denjhang/74HC-Chiptune/Glowworm-1/docs/ref/system-structure.jpeg

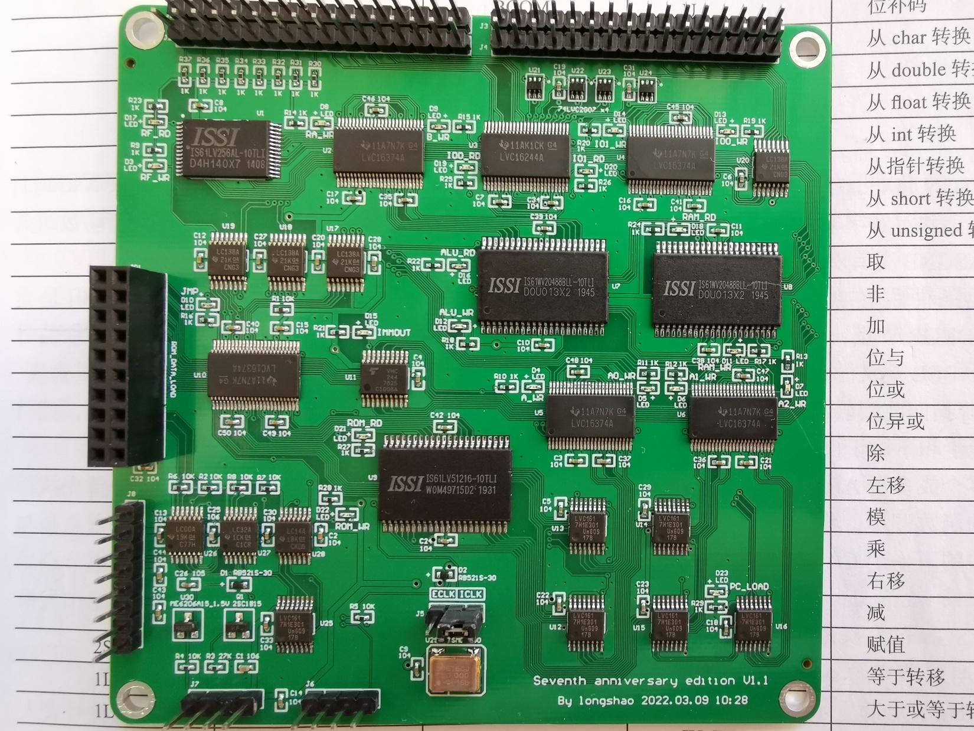
Glowworm-1/docs/ref/system-structure.jpeg
