denjhang/74HC-Chiptune/Glowworm-1/docs/hardware.md

# 萤火虫 1 号硬件实现分析（BOM 反推）

> 来源：`硬件源文件/BOM_CPU V1.1版(2022.10.19).xlsx` + `BOM_下载器V1.1版(2021.11.02).xlsx`
> 整理时间：2026-07-05
> 方法：openpyxl 提取 BOM，结合 ISA 反推每片芯片功能

## 一、CPU 板核心 IC（23 片数字逻辑）

### 存储器（4 片 SRAM）

| 位号 | 型号 | 容量 | 推断功能 |
|---|---|---|---|
| U1 | **IS61LV256** | 32K×8 = 256Kbit | RF 寄存器堆 / 小数据 RAM |
| U7 | **IS61WV2568-20488** | 256K×8 = 2Mbit | 程序 ROM（下载器灌入，CR2032 保持）|
| U8 | **IS61WV2568-20488** | 256K×8 = 2Mbit | 数据 RAM |
| U9 | **IS61LV12816-51216** | 128K×**16** = 2Mbit | **ALU 查表 ROM（16 位宽）** |

> 总 SRAM：256K（RF）+ 256K×2（程序+数据）+ 128K×16（ALU表）= 实际可用约 768KB 程序+数据空间 + 256KB ALU 表
> 修正之前 design.md 8.6 节"628512 拼"的说法：实际是 ISSI 低压 SRAM，10-20ns，支撑 50MHz

### 寄存器/触发器（6 片）

| 位号 | 型号 | 推断功能 |
|---|---|---|
| U2, U4, U5, U6, U10（5片）| **74LVC16374**（16位D触发器带三态，48脚）| A/A0/A1/A2/RA/B/IR/临时锁存。**ISA"统一目的=源"模型的物理基础**：每个寄存器都是带三态的 D 触发器组，挂公共总线，译码器选驱动源 |
| U22 | 74LVC2G07 ×4（双缓冲器，开漏）| 复位/电平转换 |

> 5 片 74LVC16374 = 80 个寄存器位，足够覆盖 ISA 所有可见寄存器 + 临时锁存

### 总线驱动（2 片）

| 位号 | 型号 | 推断功能 |
|---|---|---|
| U3 | **74LVC16244**（16位缓冲器，48脚）| TSL 三态控制 / 总线驱动（PPTX 里的 TSL 模块）|
| U11 | 74VHC244（8位缓冲器）| IO 驱动 |

### PC 计数器（6 片）

| 位号 | 型号 | 推断功能 |
|---|---|---|
| U12, U13, U14, U15, U16, U25（6片）| **74LVC161**（4位计数器）| **PC = 24 位**（6×4=24），与 ISA 的 `PC = A2A1A0`（24位地址）对得上 |

### 译码/控制（7 片）

| 位号 | 型号 | 推断功能 |
|---|---|---|
| U17, U18, U19, U20（4片）| **74LVC138**（3-8译码器）| 地址译码 / 机器码→控制信号译码（PPTX 里的"译码控制器"）|
| U26 | 74LVC00（NAND）| 控制逻辑组合 |
| U27 | 74LVC32（OR）| 控制逻辑组合 |
| U28 | 74LVC14（施密特反相）| 复位整形 / 时钟整形 |

### 电源/时钟/电源切换（4 片）

| 位号 | 型号 | 功能 |
|---|---|---|
| U29 | **SMD7050-50M** | **50MHz 主时钟** |
| U30 | ME6206A15（1.5V LDO）| 74LVC 内核供电（LVC 是 1.5V 工艺）|
| U21, U23, U24（SO-G6）| 6脚封装 | 电源切换 / CR2032 备份切换 |

### 连接器/外围

- 4×SIP16（J1-4）：4 个 16 位 I/O 端口扩展（ISA 只暴露 IO0/IO1，这里物理引出更多）
- IDC20（JP1, ROM_DATA_LOAD）：**下载器接口**（20 针排针，CPU 板和下载器板共用的 ROM_DATA_LOAD）
- 21×LED（D3-23）：状态指示
- RB521S-30 肖特基 ×2（D1,D2）：CR2032 备份二极管（隔离主电源和电池）

## 二、下载器板（CH340 USB 灌数据，约 10 片数字 IC）

| 位号 | 型号 | 功能 |
|---|---|---|
| U1 | **CH340N**（SO-8）| USB→串口 |
| U11, U12（2片）| **74HC595**（串入并出 8位移位寄存器）| 串口数据→并口地址/数据总线 |
| U4, U5, U10（3片）| **74HC161** | 地址计数器（扫 ROM 写入）|
| U2, U3（2片）| **74HC74**（双D触发器）| 控制状态机 |
| U6 | 74HC14 | 复位整形 |
| U7 | 74HC32 | 控制逻辑 |
| U8 | 74HC08 | 控制逻辑 |
| U9 | 74HC00 | 控制逻辑 |
| U13 | SMD7050-1.8432 | 1.8432MHz（标准串口波特率源）|

**下载协议推断**：CH340 串口接收 PC 数据 → 74HC595 串并转换凑出 8 位数据 + 地址 → 74HC161 地址计数器自增扫 SRAM → 通过 JP1（IDC20）把数据按地址灌进 CPU 板的 U7/U8 SRAM。灌完拔掉，CR3032 + 肖特基二极管保持 SRAM 内容。

**JP2（CLKMUX, IDC6）**：时钟切换——下载时用下载器时钟，运行时切回 50MHz。

## 三、关键架构事实（修正之前认知）

### 1. ALU ROM 是 16 位宽（重要）

IS61LV12816 是 **128K×16 SRAM**，不是 ×8。
- 地址 = (A, B, XX) ≈ 16 位地址空间（A 8位 + B 8位 = 64K，XX 当段选再扩 4-8 倍）
- 输出 **16 位**：低 8 位是运算结果，高 8 位可编码**标志位/进位/比较结果**
- 这直接解释了 `17XX` 条件跳转判 ALU 输出 bit0——比较/减法的"相等/借位"结果编码在 ALU 输出高位

### 2. PC = 24 位（6×74LVC161）

6 片 4 位计数器 = 24 位，与 ISA `PC = A2A1A0`（24 位地址）完全一致。
- 实际程序空间 256K×8 = 256KB（U7），用 18 位地址够
- 24 位 PC 留了余量（4 位未用或作标志位/分段）

### 3. 50MHz 主频（远超 PSG 的 64kHz）

- 64kHz / 50MHz = 0.128%，PSG 是萤火虫的 1/780
- SCC 的多通道分时轮询在 50MHz 下窗口充裕（一个采样周期 22.6μs = 1130 个时钟）
- 这是萤火虫能跑 NES 模拟器的物理基础

### 4. 内核 1.5V（LVC 工艺）

74LVC 系列是 1.5V 工艺（ME6206A15 提供），IO 兼容 3.3V/5V。
**对复刻的影响**：若改用 74HC（5V 工艺），频率上限会降到 ~30MHz，但架构不变。
SRAM（IS61LV/IS61WV）多档电压版本可选（3.3V 版更易采购）。

### 5. "统一目的=源"模型的物理实现

ISA 的所有指令都是"目的 = 源"，物理上：
```
        ┌─ 74LVC16374 (A)    ─┐
        ├─ 74LVC16374 (A0A1)  ─┤
总线 ◄──┼─ 74LVC16374 (A2RA)  ─┼── 74LVC16244 (TSL 选谁驱动)
        ├─ 74LVC16374 (BIR)   ─┤
        ├─ IS61LV256 (RF)     ─┤
        ├─ IS61WV2568 (RAM)   ─┤
        └─ IS61LV12816 (ALU)  ─┘
              ▲
       74LVC138 ×4 译码机器码 → 选源驱动 + 选目的锁存
```
每条指令 = 译码器选一个源驱动总线 + 选一个目的在 clk 沿锁存。极简且规整。

## 四、片数对比（修正 design.md 8.6.4）

| 方案 | 片数 | 状态 |
|---|---|---|
| design.md 估计 39040cpu | 22 | ❌ 未验证 |
| design.md 估计 SCC 专用机 | 14-16 | ❌ 估计值 |
| **萤火虫 1 号实测** | **23 核心数字 IC** | ✅ 龙少已验证（跑通 NES 模拟器/UI OS）|
| 萤火虫 + DAC = SCC 平台 | 23 + 1 (TLC7524) = **24** | 不改硬件，写 C 程序即可 |

**结论**：萤火虫片数和 39040 相当，但**已验证 + ISA 干净 + 有 lcc 编译器 + SRAM 可热改**，全方位碾压 39040。
SCC 不需要"先验证查表机再扩"——萤火虫本身就是验证好的查表机 SCC 平台。

## 五、对 Glowworm-1 子项目的指引

基于硬件事实，萤火虫架构复刻/精简的选项：

**A. 完整复刻萤火虫**（~23 片 + 下载器 10 片）
- 优势：架构已验证，lcc 可直接用，能跑现有 NES/UI 程序
- 代价：贴片 IC 多（74LVC16374 TSSOP48 等焊接难度高），CR2032 备份电路

**B. 用 DIP 芯片精简复刻**（5V HC 系列，~25-30 片）
- 74LVC16374 → 用 2×74HC374 替代（每片 8 位，16 位需 2 片，5 片变 10 片）
- IS61WV2568 → 用 62256（32K×8 DIP）×8 拼（容量小但 DIP 易焊）
- 主频降到 20-30MHz（HC 工艺限制）
- 优势：DIP 易焊，面包板可搭，符合 PSG 项目风格

**C. 基于 ISA 做最小 SCC 专用机**（不通用，~15 片）
- 砍 PC 到 16 位、砍 IO、砍 ALU 表（用专用波形 ROM）
- 优势：芯片最少
- 代价：失去 lcc 兼容性，ISA 不通用

> 待讨论方向，本文档只列事实，不预设选择。
