denjhang/74HC-Chiptune/memory/MEMORY.md

# Memory Index

- [WSG3 Core Status](wsg3-core-status.md) — DAC 有输出, 但频率 ~2212Hz 不是 440Hz (快 5 倍), 调试中
- [ROM 39SF040 Only](rom-39sf040-only.md) — 项目硬规则: 所有 ROM 只用 39SF040，不讨论替代方案
- [WSG3 Architecture](wsg3-architecture.md) — 功能等效架构: 14 IC 类型保留, 按技术文档行为接线 (不纠结引脚 1:1), 3M 微码字/TDM 16 步/寄存器映射/A4 测试向量
- [WSG3 ROM Files](wsg3-rom-files.md) — 原版 82s126 BIN 文件 + COE 等价关系 + 用途
