denjhang/74HC-Chiptune/wsg3/docs/wsg-netlist-truth.md

# Pac-Man WSG 网表完整反推 (从 AD.net 一行行读)

## 网表信号清单

### 时序信号 (HCNT, 6-bit)
- 1H  = HCNT[0] — 从 U1.24 (排针) 进, 也接 U3.10 (ROM A1)
- 2H  = HCNT[1] — U1.23, U2.10 (异或门输入), U3.9 (ROM A2)
- 4H  = HCNT[2] — U1.22, U3.8 (A3), U4.13 (B4)
- 8H  = HCNT[3] — U1.21, U3.7 (A4), U4.10 (B3)
- 16H = HCNT[4] — U1.20, U3.6 (A5), U4.6 (B2)
- 32H = HCNT[5] — U1.19, U3.5 (A6), U4.3 (B1)

注: HCNT 由外部 (排针) 提供, 不是声卡内部产生!

### CPU 接口信号
- AB0-3 = U1.7,5,3,1 — CPU 地址低 4 位 → U4 A1-A4
- DB0-3 = U1.13,12,11,10 — CPU 数据低 4 位 → U5 A1-A4
- /WR0 = U1.15 → U3.4 (ROM /OE?)
- /WR1 = U1.16 → U6.3 (RAM1 /WE)
- SOUND_ON = U1.17 → U11.1 (HC273 /MR)
- /GM = U1.18 → U3.20 (ROM /CE)

## 芯片信号 → 引脚完整映射

### U2: 74HC86 (异或门) — DIP-14

网表连接:
- Pin 8 (Y3) → 3LK-157-S (U5.1, U4.1)
- Pin 10 (A4) ← 2H
- Pin 7 (GND), Pin 9 (B4) ← GND

**功能**: Y3 = A4 ^ B4 = 2H ^ 0 = 2H
所以 **3LK-157-S = 2H**

### U4: 74HC157 (4×2 选 1 mux, AB mux)
- Select = 3LK-157-S = 2H
- A1-A4 = AB0-3 (CPU 地址)
- B1-B4 = 32H, 16H, 8H, 4H (HCNT 高位)
- Y1-Y4 = 3L-157-Y1..4 → U6/U7 地址 A3-A0

注意! Y1 → A3, Y4 → A0 (顺序反)

当 Select=0 (2H=0): Y = A = AB (CPU 地址)
当 Select=1 (2H=1): Y = B = HCNT[5:2]

### U5: 74HC158 (4×2 选 1 反相 mux, DB 反相 mux)
- Select = 3LK-157-S = 2H
- A1-A4 = DB0-3 (CPU 数据)
- B1-B4 = 3K-158-B1..4 (反馈, 来自累加器/ROM)
- Y1-Y4 (反相) → U6/U7 数据输入

B 输入:
- B1 = 3K-158-B1 ← U10.6 (1M ROM D5), U9.14, U9.5
- B2 = 3K-158-B2 ← U10.7 (1M ROM D4), U9.7
- B3 = 3K-158-B3 ← U10.8, U9.10
- B4 = 3K-158-B4 ← U10.9, U9.12

注意 U9 是 174 锁存器, 输出 Q1-Q6

### U3: 27C256 / 82S126 (3M 微码 PROM)
地址 (8-bit):
- A0 = Pin 10 ← 1H
- A1 = Pin 9 ← 2H
- A2 = Pin 8 ← 4H
- A3 = Pin 7 ← 8H
- A4 = Pin 6 ← 16H
- A5 = Pin 5 ← 32H
- A6, A7 = 接 GND/VCC (不接 HCNT)
- /CE = Pin 20 ← /GM
- /OE = Pin 22 ← GND (常输出)

数据 (4-bit):
- DQ0 = Pin 11 → 3M-DQ0 → U9.9 (174 CLK)
- DQ1 = Pin 12 → 3M-DQ1 → U7.3 (U7 /WE)
- DQ2 = Pin 13 → 3M-DQ2 → U11.11 (273 CP)
- DQ3 = Pin 15 → 3M-DQ3 → U9.1 (174 /CLR)

注: DQ0=时钟, DQ3=清零, DQ1=RAM写, DQ2=输出锁存
原版 82S126 数据看 16 步循环 (HCNT[3:0])

### U6: 74LS189 (RAM #1, 存"2L"组数据)

地址 (4-bit, 共享):
- A0 = Pin 1 ← 3L-157-Y4 (U4 Y4)
- A1 = Pin 15 ← 3L-157-Y3
- A2 = Pin 14 ← 3L-157-Y2
- A3 = Pin 13 ← 3L-157-Y1

控制:
- /CS = Pin 2 ← GND (常使能)
- /WE = Pin 3 ← /WR1 (CPU 写脉冲)

数据输入 (4-bit, 共享):
- D3 = Pin 4 ← 3K-158-Y4
- D2 = Pin 6 ← 3K-158-Y3
- D1 = Pin 10 ← 3K-158-Y2
- D0 = Pin 12 ← 3K-158-Y1

数据输出 (4-bit, 反相, 独立):
- O0 = Pin 5 → 2L-DQ0 → U11.8, U8.6
- O1 = Pin 7 → 2L-DQ1 → U11.7, U8.2
- O2 = Pin 9 → 2L-DQ2 → U11.4, U8.15
- O3 = Pin 11 → 2L-DQ3 → U11.3, U8.11

**关键**: U6 输出 → U8 (283 加法器) A 端 + U11 (273) 高 4 位
所以 U6 存的是 **累加器/音量** 之类需要直接送加法器和输出锁存的数据

### U7: 74LS189 (RAM #2, 存"2K"组数据)

地址 (4-bit, 共享 U6):
- 同 U6

控制:
- /CS = Pin 2 ← GND
- /WE = Pin 3 ← 3M-DQ1 (微码控制写!)

数据输入 (4-bit, 共享 U6):
- 同 U6

数据输出 (4-bit, 反相):
- O0 = Pin 5 → 2K-DQ0 → U10.5 (1M ROM A4), U8.5 (283 B0)
- O1 = Pin 7 → 2K-DQ1 → U10.4, U8.3
- O2 = Pin 9 → 2K-DQ2 → U10.3, U8.14
- O3 = Pin 11 → 2K-DQ3 → U8.12 (注意! 只到 U8, 不到 U10)

**关键**: U7 输出 → U8 (283) B 端 + U10 (1M ROM) 地址低位
所以 U7 存的是 **频率/波形选择** (要送加法器和寻 ROM)

### U8: 74HC283 (4-bit 加法器, "1K")
- A0-A3 = Pin 12,14,3,2 ← 2L-DQ0..3 (来自 U6, 累加器)
- B0-B3 = Pin 5,3,14,1 ← 2K-DQ0..3 (来自 U7, 频率)
  注: 实际看网表
  - U8.6 ← 2L-DQ0 (A1)
  - U8.2 ← 2L-DQ1 (A2)
  - U8.15 ← 2L-DQ2 (A3)
  - U8.11 ← 2L-DQ3 (A4?)
  - U8.5 ← 2K-DQ0 (B1)
  - U8.3 ← 2K-DQ1 (B2)
  - U8.14 ← 2K-DQ2 (B3)
  - U8.12 ← 2K-DQ3 (B4)
- C0 = Pin 7 ← 1L-74-1Q (U9.2, 进位输入)
- S1-S4 = Pin 4,1,13,10 → 1K-283-S1..4 → U9 D1-D4
  - U8.4 (S1) → U9.13 (D2)
  - U8.1 (S2) → U9.11 (D3)
  - U8.13 (S3) → U9.6 (D4)
  - U8.10 (S4) → U9.4 (D5)
- C4 = Pin 9 → U9.3 (D1)

### U9: 74HC174 (6-bit 锁存器, "1L")
- CLK = Pin 9 ← 3M-DQ0
- /CLR = Pin 1 ← 3M-DQ3
- D1 = Pin 3 ← U8.9 (C4, 加法器进位输出)
- D2 = Pin 4 ← U8.4 (S1)
- D3 = Pin 6 ← U8.1 (S2)
- D4 = Pin 14 ← U8.13 (S3)
- D5 = Pin 13 ← U8.10 (S4)
- D6 = Pin 11 ← ? (网表说 U9.11 = 1K-283-S2, 来自 U8.1)

等等, 这里有矛盾. U9.11 同时是 D6 输入和 S2 输出?

让我重新核对. 174 引脚:
- Pin 1: /CLR
- Pin 2: Q1
- Pin 3: D1
- Pin 4: D2
- Pin 5: Q2
- Pin 6: D3
- Pin 7: Q3
- Pin 9: CLK
- Pin 10: Q6
- Pin 11: D6
- Pin 12: Q5
- Pin 13: D5
- Pin 14: D4
- Pin 15: Q4

但网表说:
- U9.11 ← 1K-283-S2 (U8.1)
- U9.11 → 3K-158-B1 (送 U5 B1)

矛盾! D6 是输入, 怎么会输出到 U5?

可能 U9.11 实际是 Q6 不是 D6? 让我换个引脚映射.

或者网表里 U9.11 既是输入也是输出, 这不可能. 我一定看错了引脚定义.

让我用 74HC174 标准 DIP-16 引脚 (datasheet):
- Pin 1: /MR (master reset)
- Pin 2: Q1
- Pin 3: D1
- Pin 4: D2
- Pin 5: Q2
- Pin 6: D3
- Pin 7: Q3
- Pin 8: GND
- Pin 9: CLK
- Pin 10: Q4
- Pin 11: D4
- Pin 12: Q5
- Pin 13: D5
- Pin 14: D6
- Pin 15: Q6
- Pin 16: VDD

是的! 我之前看错了. 174 实际是:
- Pin 10: Q4
- Pin 11: D4
- Pin 15: Q6

让我重新映射 U9 (74HC174):
- /CLR = Pin 1 ← 3M-DQ3
- CLK = Pin 9 ← 3M-DQ0
- D1 = Pin 3 ← 1K-283-C4 (U8.9)
- Q1 = Pin 2 → 1L-74-1Q → U8.7 (C0, 进位输入)
- D2 = Pin 4 ← 1K-283-S1 (U8.4)
- Q2 = Pin 5 → U9.5 → 3K-158-B1 (反馈到 U5)
- D3 = Pin 6 ← 1K-283-S4 (U8.13)
- Q3 = Pin 7 → U9.7 → 3K-158-B2
- D4 = Pin 11 ← 1K-283-S2 (U8.1)
- Q4 = Pin 10 → U9.10 → 3K-158-B3
- D5 = Pin 13 ← 1K-283-S3 (U8.10)
- Q5 = Pin 12 → U9.12 → 3K-158-B4
- D6 = Pin 14 ← ? (网表没看到 U9.14 连接)
- Q6 = Pin 15 → U9.15 → 1L-174-6Q → U10.10 (1M ROM A5)

太好了! 现在所有连接都对上了!

### U10: 27C256 / 82S126 (1M 波形 PROM)
地址 (8-bit):
- A0-A3 = Pin 12,11,10,9 ← 2K-DQ0..3? 让我核对
  - U10.5 ← 2K-DQ0
  - U10.4 ← 2K-DQ1
  - U10.3 ← 2K-DQ2
  等等, 27C256 的 A0-A7 是 Pin 10, 9, 8, 7, 6, 5, 4, 3, 25, 24, 21, 23, 2

让我用 27C256 引脚:
- Pin 10: A0
- Pin 9: A1
- Pin 8: A2
- Pin 7: A3
- Pin 6: A4
- Pin 5: A5
- Pin 4: A6
- Pin 3: A7
- Pin 25: A8
- Pin 24: A9
- Pin 21: A10
- Pin 23: A11
- Pin 2: A12
- (其他高位地址看型号)

从网表:
- U10.10 ← 1L-174-6Q (U9.15, 锁存器 Q6) — 所以 Pin 10 = A0 ← U9 Q6
- U10.11 ← 1M-DQ0?? 不对, 1M-DQ0 是输出

等等. U10.11 → 1M-DQ0 是输出. 但网表说 (1M-DQ0 U11-18 U10-11).

我搞混了, 让我重新看:
- Pin 11 是 DQ0 还是 A1?

27C256 标准 DIP-28:
- Pin 10: A0
- Pin 11: DQ0 ← 输出
- Pin 9: A1
- Pin 12: DQ1
- Pin 8: A2
- Pin 13: DQ2
- Pin 7: A3
- Pin 14: GND
- Pin 6: A4
- Pin 15: DQ3
- Pin 5: A5
- Pin 16: DQ4
- Pin 4: A6
- Pin 17: DQ5
- Pin 3: A7
- Pin 18: DQ6
- Pin 25: A8
- Pin 19: DQ7
- Pin 24: A9
- Pin 20: /CE
- Pin 21: A10
- Pin 22: /OE
- Pin 23: A11
- Pin 1: VPP (or A13?)
- Pin 26: A12
- Pin 27: A14 (or /PGM)
- Pin 28: VDD

但 82S126 是 8-pin + 4-bit data, 引脚完全不同!

让我重新看网表连接:
- U10.10 ← U9.15 (174 Q6) → 这是地址 A0
- U10.11 → U11.18 (1M-DQ0) → 数据输出
- U10.12 → U11.17 (1M-DQ1)
- U10.13 → U11.14 (1M-DQ2)
- U10.15 → U11.13 (1M-DQ3)
- U10.4 ← 2K-DQ1
- U10.5 ← 2K-DQ0
- U10.6 ← 3K-158-B1
- U10.7 ← 3K-158-B2
- U10.8 ← 3K-158-B3
- U10.9 ← 3K-158-B4
- U10.14 ← GND
- U10.20 ← GND
- U10.22 ← GND
- U10.1 ← VCC
- U10.28 ← VCC

U10 是 27C256 (DIP-28) 但网表用得像 256×4 PROM:
- 地址输入: Pin 10 (A0), Pin 9 (A1), Pin 8 (A2), Pin 7 (A3), Pin 6 (A4), Pin 5 (A5), Pin 4 (A6)
- 数据输出: Pin 11 (DQ0), Pin 12 (DQ1), Pin 13 (DQ2), Pin 15 (DQ3)

所以 1M PROM 地址是 7-bit (128 字节), 数据 4-bit. 这正是 82S126 的扩展 (256×4)!

U10 地址来源:
- A0 ← 1L-174-6Q (累加器高位, 锁存器 Q6)
- A1-A4 ← 2K-DQ0..3 (U7 RAM 输出, 4-bit 累加器值)
- A5-A6 ← 3K-158-B1..B4 (这些是 U5 输入, 来自反馈)

等等, 3K-158-B1 来自 U10.6 (U10 自己)? 这是循环!

让我再看 3K-158-B1 = (U10-6, U9-14, U9-5, U5-3):
- U10.6 (A4) — 但这是 U10 的地址 A4, 怎么会是 U5 的输入 B1?

哦! 我看错了. 让我重新理解. 信号 3K-158-B1 连接的引脚都是同一个网络名:
- U5.3 (B1 输入)
- U10.6 (A4? 但 A4 是输入, 不可能也是输出)
- U9.14 (D6)
- U9.5 (Q2)

可能是 U10.6 实际上是 DQ (双向), 不是 A4. 或者 27C256 引脚映射不一样.

我应该停止猜, 找原版原理图看真实引脚.

但等等, 网表里 27C256 写得很明白, 我看的是 DIP-28. 实际可能是别的型号.

让我从信号名推断:
- 3K-158-B1 是 U5 的 B1 输入
- 它连到 U10.6 (U10 的 Pin 6)
- 还连到 U9.14 和 U9.5

如果 U10.6 是数据输出 (1M-DQ4 或类似), 那 B1 就是 ROM 数据反馈.

我需要换思路. 不再纠结引脚号, 而是从功能反推.
