denjhang/74HC-Chiptune/psg_voice/README.md

# psg_voice — 74HC PSG / 波形音源系列

用 74HC 逻辑 + FT232H 控制的方波/噪音/波形音源。按版本演进，每版对应一张 EasyEDA 原理图，**逐步上板验证**。

## 版本谱 (按时间)

| 版本 | 状态 | 内容 |
|---|---|---|
| [PSG1 v0.1](PSG1%20v0.1/) | ✅ 上板 | 单通道方波, 5 片 74HC + LS373 电平转换 + FT232H, 实测发声 |
| [PSG1 v0.2](PSG1%20v0.2/) | ✅ 上板 | v0.1 + 4-bit 音量 (TLC7524 衰减器), ADSR+曲目库 |
| [PSG2 v0.3](PSG2%20v0.3/) | ✅ 上板 | 两通道: CH0 方波 (复用 v0.2) + CH1 LFSR 噪音 (模拟噪声注入, 永不锁死) |
| [PSG3 v0.4](PSG3%20v0.4/) | ✅ 上板 | YM2413 风格地址/数据复用总线 + 方波/噪音双通道 + 简谱宏解析播放器 |
| [**PSG3 v0.5**](PSG3%20v0.5/) | 🚧 **进行中** | v0.4 + 波形通道 (rev.a→e2): 分频链锯齿 ✅ → ROM 查表任意波形/PCM (待上板) |
| [PSG4 v0.6](PSG4%20v0.6/) | 📋 设计 | 纯设计思路, **未验证** |
| [WSG3 v0.6](WSG3%20v0.6/) | 📋 设计 | 纯设计思路, **未验证** |
| [WSG8 v0.7](WSG8%20v0.7/) | 📋 设计 | 纯设计思路, **未验证** |
| [FM6 v0.7](FM6%20v0.7/) | 📋 设计 | 单通道 2-op FM, RTL 验证, **未上板** |

⭐ **当前最新进度 = [PSG3 v0.5 rev.e2](PSG3%20v0.5/)** (双模式波形/采样, 接线表完成, 待上板).

> ⚠️ v0.6/v0.7 都是纸面/RTL 探索, 无硬件验证, 不算已完成成果.

## 共享资源
- **控制器**: FT232H (CJMCU 板, D2XX + MPSSE), 12 根线
  - C0-C7 = 数据总线, D4=LE, D5=A0, D6=RST, D7=A1 (v0.3+)
  - v0.4 起改 YM2413 风格: A0/CS/WR 地址数据复用
- **时钟**: 外部有源晶振 (方波/噪音 64kHz 预分频甜点, 波形通道 4MHz 直连)
- **电平转换**: LS373 (FT232H 3.3V → 74HC 5V, v0.1 验证必需, A0 也要过)
- **DAC**: TLC7524 (正向接法: REF=信号输入, OUT1=输出, RFB=GND)
- **输出**: OUT1 → 耦合电容 → 运放 → 喇叭

## 演进脉络
- **v0.1**: 单通道方波直驱. 验证 74HC PSG 核心 + FT232H 控制 + 电平转换 + HCT74 高频.
- **v0.2**: + 4-bit 音量 (TLC7524 衰减器). 核心不动, 加 HC374 + TLC7524.
- **v0.3 (PSG2)**: + 噪音通道 (LFSR). 用户创新: HC00+电容模拟噪声注入 D[0], 永不锁死.
- **v0.4 (PSG3)**: YM2413 总线 (地址/数据复用, 8 寄存器). + 简谱宏解析播放器 (ini 音级+乐器块+双轨).
- **v0.5 (PSG3)**: + 波形通道. CD4029 失败 → HC161 Q→DAC 失败 → rev.a 分频链锯齿 ✅ → rev.b 三角 ❌ → rev.c 调音色 → rev.d/d2 ROM 查表 → **rev.e2 双模式 (波形+PCM)**.

## 共享 datasheet / 库存
- **datasheet**: [`datasheet/`](datasheet/) (157 个 md, 按家族分类: 74series/cmos4000/analog/audio/memory/...)
- **库存表**: [`PSG3 v0.5/docs/inventory.md`](PSG3%20v0.5/docs/inventory.md) (选片前先查)
- **查证纪律**: 不确定芯片特性查 datasheet PDF 原文, 不凭记忆 (详见项目根 CLAUDE.md 第七节)
