denjhang/74HC-Chiptune/wsg3/docs/wsg3-architecture.md

# WSG3 — Pac-Man WSG 功能等效复刻 (11 IC WSG + 3 IC SPFM = 14 IC)

> **设计原则: 按芯片类型做功能等效, 不纠结原版引脚级 1:1**
> 数据来源: `reference/Namco WSG/Pac-Man技术文档_extracted/document_text.txt`
> 网表参考: `reference/Namco WSG/easyeda/PADS.net`

---

## 0. 设计目标

| 目标 | 说明 |
|---|---|
| **WSG 核心** | 11 片 IC, 按 Pac-Man 1980 WSG 芯片类型复刻 |
| **SPFM 接口** | 3 片 IC (373+174+377), 主机写 voice 参数 |
| **通道数** | 3 通道独立波形/频率/音量 |
| **相位精度** | 通道 1: 20-bit, 通道 2/3: 16-bit |
| **采样率** | 96 kHz (主钟 6.144 MHz / 64) |
| **波形数** | 8 种预设波形 (低 3-bit 选择) |
| **音量级** | 16 级 (0-15, 4-bit) |
| **混音** | CD4066 模拟开关 + R-2R 等效 |
| **总 IC 数** | **14 片** |
| **隐藏门** | **0** |

---

## 1. 14 片 IC 清单 (按芯片类型复刻)

### SPFM 总线接口 (3 片)

| 位号 | 型号 | 功能 |
|---|---|---|
| U_spfm_373 | 74HC373 | SPFM_D[7:0] 透明锁存 |
| U_spfm_174 | 74HC174 | 写脉冲同步链 |
| U_spfm_377 | 74HC377 | reg_addr[7:0] 寄存器 |

### WSG 核心 (11 片)

| 位号 | 型号 | 功能 (技术文档对应行为) |
|---|---|---|
| U2 | 74HC86 | XOR — HCNT[1] 反馈 (生成 mux Select) |
| U3 | 39SF040 | **3M 微码 ROM** — 16 步 × 16-bit 控制字, 由 HCNT[5:2] 寻址 |
| U4 | 74HC157 | AB mux — 选 CPU 地址 (写) 或 HCNT (扫描) |
| U5 | 74HC158 | DB 反相 mux — 选 CPU 数据 (写) 或反馈 (累加器回写) |
| U6 | 74LS189 | RAM "2L" — 累加器值 (4-bit, 16 字) |
| U7 | 74LS189 | RAM "2K" — 频率/音量值 (4-bit, 16 字) |
| U8 | 74HC283 | 4-bit 加法器 "1K" — acc + freq + carry, 串行 4-5 次构成 16/20-bit |
| U9 | 74HC174 | 6-bit 锁存 "1L" — 累加器累加 + 进位链 + ROM 地址高位 |
| U10 | 39SF040 | **1M 波形 ROM** — 8 波 × 32 点 × 4-bit, 由波形号+相位寻址 |
| U11 | 74HC273 | 输出寄存器 "2M" — 锁存波形 × 音量结果 |
| U12 | CD4066 | 4 路模拟开关 — 音量乘法 (行为级 `wave × vol / 15`) |

---

## 2. 关键纠正 (旧文档的错误)

**旧 wsg3-architecture.md 错误**:
- ~~U3 是 wavetable ROM, U10 是 RAM~~ ← 错!
- 旧文档的 64 拍时序和 4 通道噪音是凭空想象

**技术文档真相** (来自 `document_text.txt`):
- **U3 = 3M 微码 ROM**: 16 步 × 16-bit 控制字, 由 `HCNT[5:2]` 寻址, 控制 174 CLK/CLR + 273 CP + 189 /WE
- **U10 = 1M 波形 ROM**: 8 个波形 × 32 样本 × 4-bit, 地址 `[7:5]=波形号, [4:0]=相位高 5 位`
- **3 通道** (不是 4), 每通道 16 步 TDM 中的 4-5 步做相位累加 + 1 步做输出

---

## 3. TDM 时序 (16 步循环, HCNT[5:2])

每个 96kHz 采样需要 16 个 HCNT 周期 (HCNT[5:2] 步进). 步号 0-F 分布如下:

| 步号 | HCNT[5:2] | 通道 | 操作 | 微码 (rom3m[15:0]) |
|---|---|---|---|---|
| 0  | 4'h0 | ch0 | 频率 nibble 0 + 累加 nibble 0 (清零开始) | `16'b1101_1110_1111_0111` |
| 1  | 4'h1 | ch0 | 频率 nibble 1 + 累加 nibble 1 | `16'b1101_1110_1111_1111` |
| 2  | 4'h2 | ch0 | 频率 nibble 2 + 累加 nibble 2 | `16'b1101_1110_1111_1111` |
| 3  | 4'h3 | ch0 | 频率 nibble 3 + 累加 nibble 3 | `16'b1101_1110_1111_1111` |
| 4  | 4'h4 | ch0 | 频率 nibble 4 (仅 ch0) + 累加 nibble 4 | `16'b1101_1110_1111_1111` |
| 5  | 4'h5 | ch0 | **输出**: 锁存 1M[波形3位 + 累加5位] × 音量 → 273 | `16'b1011_1111_1111_1111` |
| 6  | 4'h6 | ch1 | 频率 nibble 0 + 累加 nibble 0 (清零) | `16'b1101_1110_1111_0111` |
| 7  | 4'h7 | ch1 | 频率 nibble 1 + 累加 nibble 1 | `16'b1101_1110_1111_1111` |
| 8  | 4'h8 | ch1 | 频率 nibble 2 + 累加 nibble 2 | `16'b1101_1110_1111_1111` |
| 9  | 4'h9 | ch1 | 频率 nib率 3 + 累加 nibble 3 | `16'b1101_1110_1111_1111` |
| A  | 4'hA | ch1 | **输出** | `16'b1011_1111_1111_1111` |
| B  | 4'hB | ch2 | 频率 nibble 0 + 累加 nibble 0 (清零) | `16'b1101_1110_1111_0111` |
| C  | 4'hC | ch2 | 频率 nibble 1 + 累加 nibble 1 | `16'b1101_1110_1111_1111` |
| D  | 4'hD | ch2 | 频率 nibble 2 + 累加 nibble 2 | `16'b1101_1110_1111_1111` |
| E  | 4'hE | ch2 | 频率 nibble 3 + 累加 nibble 3 | `16'b1101_1110_1111_1111` |
| F  | 4'hF | ch2 | **输出** | `16'b1011_1111_1111_1111` |

### 微码字 16-bit 位定义

```
bit  15 14 13 12   11 10  9  8   7  6  5  4   3  2  1  0
     [  1M_CE  ]   [  273_CP ]   [ 174_CLR]   [ 174_CLK]
```

| 位段 | 含义 |
|---|---|
| `[15:12]` | 1M ROM 控制 (`1011` = 上升沿锁存到 273, `1101` = 仅读) |
| `[11:8]` | 273 输出寄存器 CP 控制 (`1110` = 产生上升沿, `1111` = 保持) |
| `[7:4]` | 174 锁存器 /CLR 控制 (`0111` = 异步清零, `1111` = 正常) |
| `[3:0]` | 174 锁存器 CLK 控制 (`0111` = 上升沿锁存加法结果, `1111` = 保持) |

(位段具体编码来自技术文档 Verilog 示例, 4-bit 编码控制对应芯片的 CP/CLR/CE 边沿)

---

## 4. 数据通路 (功能等效 Verilog)

```verilog
// 加法器 (U8 283, time-shared)
wire [5:0] sum_1K = acc_dout + freq_dout + carry_chain[5];

// 累加器 (U9 174, 6-bit 移位锁存器)
always @(posedge u3_dq[0] or negedge u3_dq[3]) begin
    if (!u3_dq[3])
        carry_chain <= 0;          // /CLR 异步清零
    else
        carry_chain <= {sum_1K, carry_chain[3]};
        // 5-bit = {新加法结果 4-bit + 新进位 1-bit, 拼上上次结果 bit[3]}
end

// 1M 波形 ROM 地址 (U10)
assign rom1m_addr[7:5] = acc_dout[2:0];   // 波形号 (来自 RAM 高 3-bit)
assign rom1m_addr[4:0] = carry_chain[4:0]; // 相位高 5-bit (来自累加器)

// 1M 数据 → 273 → 4066 → DAC
wire [3:0] wave_sample = rom1m_data[3:0];
wire [3:0] vol         = vol_dout;
wire [7:0] dac_out     = wave_sample * vol;  // 行为级等效 (硬件是 4066 + R-2R)
```

### 加法器串行时序 (16/20-bit 累加器, 4-bit 分片)

每个通道做 4 或 5 次串行加法, 每次处理 4-bit:
- ch0 (20-bit): 5 次加法 (步 0-4)
- ch1, ch2 (16-bit): 4 次加法 (步 6-9, B-E)

每次加法: `sum = acc_nibble + freq_nibble + carry_in`
锁存: `carry_chain <= {sum, carry_chain[3]}` (移位累积)

---

## 5. RAM 地址映射 (U6/U7 LS189)

16 字 × 4-bit RAM, 由 4-bit 地址寻址. 由 U4 (157 mux) 选择:
- 写入时 (Select=0): 地址 = CPU 寄存器地址低 4 位
- 扫描时 (Select=1): 地址 = HCNT[5:2] (TDM 步号)

### 寄存器布局 (Pac-Man CPU 地址空间)

| CPU 地址 | RAM 字 | 含义 |
|---|---|---|
| 0x40-0x44 | U6[0-4] | ch0 累加器 (5 nibble, H/W only) |
| 0x45 | U6[5] | ch0 波形号 (低 3-bit) |
| 0x46-0x49 | U6[6-9] | ch1 累加器 |
| 0x4A | U6[A] | ch1 波形号 |
| 0x4B-0x4E | U6[B-E] | ch2 累加器 |
| 0x4F | U6[F] | ch2 波形号 |
| 0x50-0x54 | U7[0-4] | ch0 频率 (5 nibble = 20-bit) |
| 0x55 | U7[5] | ch0 音量 |
| 0x56-0x59 | U7[6-9] | ch1 频率 (4 nibble = 16-bit) |
| 0x5A | U7[A] | ch1 音量 |
| 0x5B-0x5E | U7[B-E] | ch2 频率 |
| 0x5F | U7[F] | ch2 音量 |

**注意**: 累加器是 H/W 写的, CPU 不写 (但 CPU 可以读, 用于调试).

---

## 6. ROM 文件

| 文件 | 内容 | 容量 | 用 39SF040 实现 |
|---|---|---|---|
| `rom/wsg3_prom3m.hex` | 3M 微码: 16 步 × 16-bit = 32 字节 | 32B → 512KB | 重复填充, 高 nibble 设 0 |
| `rom/wsg3_prom1m.hex` | 1M 波形: 8 波 × 32 点 × 4-bit = 128 字节 | 128B → 512KB | 用原版 `82s126.1m` BIN 数据 |

### A4 = 440Hz 测试向量 (来自技术文档)

频率寄存器值 = `0x12C6` (20-bit, 写到 0x50-0x54 低 nibble):
- 0x50 ← 0x6
- 0x51 ← 0xC
- 0x52 ← 0x2
- 0x53 ← 0x1
- 0x54 ← 0x0

音量 = 0xF (最大), 波形 = 0 (sine).

---

## 7. 总架构框图

```
┌────────────────────────────────────────────────────────────┐
│                    SPFM 总线 (主机)                          │
│   D[7:0], A0, CS_n, WR_n, RST_n                            │
└────────────────────────┬───────────────────────────────────┘
                         │
            ┌────────────▼──────────────┐
            │  373 + 174 + 377          │
            │  → reg_addr, reg_data     │
            │  → addr_wr_n, data_wr_n   │
            └────────────┬──────────────┘
                         │
        ┌────────────────┼──────────────────┐
        │                │                  │
┌───────▼───────┐  ┌─────▼───────┐  ┌──────▼──────┐
│ U4 (157)      │  │ U5 (158)    │  │ U2 (86)     │
│ addr mux      │  │ data inv mux│  │ Select = 2H │
│ CPU / HCNT    │  │ CPU / acc fb│  │             │
└───────┬───────┘  └─────┬───────┘  └─────────────┘
        │                │
        └────────┬───────┘
                 │
        ┌────────▼────────┐
        │ U6 (189) acc RAM│  ── 2L-DQ ──► U8 A
        │ U7 (189) frq RAM│  ── 2K-DQ ──► U8 B + U10 addr[7:5]
        └────────┬────────┘
                 │
        ┌────────▼────────┐
        │ U8 (283) 加法器 │ ── S[3:0] + C4 ──► U9 D
        │ sum = A+B+C0    │
        └────────┬────────┘
                 │
        ┌────────▼─────────────┐
        │ U9 (174) 累加器锁存  │ ── Q[5:0] ──► U10 addr[4:0]
        │ 6-bit 移位寄存器     │ ── Q5 ──────► U8 C0 (反馈)
        │ CLK = u3_dq[0]       │
        │ /CLR = u3_dq[3]      │
        └────────┬─────────────┘
                 │
        ┌────────▼─────────┐
        │ U3 (3M) 微码 ROM │ ── u3_dq[3:0] ──► 控制所有 CLK/CP/CLR/WE
        │ addr = HCNT[5:2] │
        └──────────────────┘
                 │
        ┌────────▼─────────┐
        │ U10 (1M) 波形 ROM│ ── dq[3:0] ──► U11 D[3:0]
        │ addr = {波形号,相位}│
        └────────┬─────────┘
                 │
        ┌────────▼─────────┐
        │ U11 (273) 输出   │ ── Q[3:0]=wave, Q[7:4]=vol
        │ CP = u3_dq[2]    │
        └────────┬─────────┘
                 │
        ┌────────▼─────────┐
        │ U12 (4066)       │ ── wave × vol / 15 (行为等效)
        │ 模拟开关乘法     │
        └────────┬─────────┘
                 │
              dac_out[7:0]
```

---

## 8. 实现状态

- [x] 芯片清单和功能定义
- [x] 微码字位段定义
- [x] TDM 16 步时序表
- [x] RAM 寄存器映射
- [ ] 重写 wsg3_core.v 为功能等效
- [ ] 重新生成 3M/1M hex 文件
- [ ] SPFM 写入 + A4 音符功能验证
- [ ] 隐藏门审计 (0 隐藏门)
