denjhang/74HC-Chiptune/wsg-4ch-128pt-full/docs/hc-chiptune-design.md

# 74HC-Chiptune 设计文档

基于 Pac-Man WSG 架构，使用 74HC TTL 芯片构建 3 通道波形合成器。

## 架构概览

```
SPFM 总线 → 373/174/377 (3 IC) → 7134 参数 RAM → 合成器数据通路
                                                        ↓
3.072MHz / 32 = 96kHz                                  hc161×2 → 指令 ROM (39SF040, 8-bit)
32 步循环: v0(8步) + v1(8步) + v2(8步) + NOP(8步)       ↓
每通道: 5累加 + vol读 + wave读 + ROM查表 = 8步
混音: 3通道 8-bit 值累加到 273 输出
```

## 时钟

- 晶振: **3.072 MHz** (直接驱动 STEP_CLK)
- STEP_CLK → hc161×2 CP → 32 步循环 (5-bit step counter)
- 96kHz = 3.072MHz / 32 (step 跑一轮 = 一个采样周期)

## 芯片清单 (12 IC)

| 部分 | 芯片 | 封装 | 数量 | 说明 |
|---|---|---|---|---|
| **SPFM 总线接口** | 74HC373 | DIP-20 | 1 | D[7:0] 透明锁存 |
| | 74HC174 | DIP-16 | 1 | 两路同步器 |
| | 74HC377 | DIP-20 | 1 | 地址寄存器 |
| **合成器核心** | 74HC161 | DIP-16 | 2 | 微步计数器 step[4:0] (级联) |
| | 74HC283 | DIP-16 | 1 | 4-bit 全加器 (相位累加) |
| | 74HC174 | DIP-16 | 1 | 累加器锁存 + vol/wave 锁存 |
| | 74HC273 | DIP-20 | 1 | TDM 输出锁存 (dac_out, 3 voice 分时) |
| | 39SF040 | DIP-32 | 2 | 指令 ROM (8-bit) + 波表 ROM |
| | IDT7134 | DIP-48 | 1 | 双端口参数 RAM |
| | CY62256 | DIP-28 | 1 | phase 存储 |
| **总计** | | | **12** | |
| **输出** | R-2R 电阻网络 | - | 1 | 8-bit DAC (Gigatron 同款) |
| **时钟** | 3.072MHz 晶振 | 3225 | 1 | STEP_CLK |

## 32 步循环

```
step  0: v0 清零加法器 + nibble 0 累加
step  1: v0 nibble 1 累加
step  2: v0 nibble 2 累加
step  3: v0 nibble 3 累加
step  4: v0 nibble 4 累加
step  5: v0 读 vol (7134 addr voice×8+6)
step  6: v0 读 wave (7134 addr voice×8+5)
step  7: v0 ROM 查表 → 混音锁存

step  8-15: v1 同上
step 16-23: v2 同上 (查表后同时锁存 dac_out)
step 24-31: NOP (step[4:3]=11, 硬件自动屏蔽所有操作)
```

## 微程序控制 (8-bit 控制字)

本设计使用微程序控制（非流水线）——ROM 存控制字驱动数据通路，32 步固定循环。

### 控制字格式 (8-bit)

每步 8-bit, 存在 39SF040 指令 ROM, 地址 = step (0-31)

```
bit 7:   adder_clk    1=锁存 283 加法结果
bit 6:   out_latch    1=查表步, 锁存 ROM 输出到 mix
bit 5:   param_oe_n   0=读 7134 参数
bit 4:   ram_oe_n     0=读 62256 phase
bit 3:   rom_oe_n     0=读波表 ROM
bit 2:   adder_clr_n  0=清零加法器 (每通道第一步)
bit 1:   reserved
bit 0:   reserved
```

### 硬件推导信号 (不存 ROM)

```
voice_sel  = step[4:3]    (00=v0, 01=v1, 10=v2, 11=NOP)
param_addr = step[2:0]    (0-4=freq nibble, 5=wave, 6=vol)
```

### 控制字编码表

| 步类型 | step[2:0] | 编码 | 说明 |
|---|---|---|---|
| accum clr+nib0 | 0 | 0x88 | 清零加法器, 累加 freq nibble 0 |
| accum nib1-4 | 1-4 | 0x94 | 累加 freq nibble 1-4 |
| vol/wave read | 5-6 | 0x1C | 读 7134 vol/wave 参数 |
| lookup | 7 | 0x74 | 波表 ROM 查表, 混音累加 |
| NOP | x | 0x3C | 空闲 |

## 波表 ROM (128 点)

地址 = {wave[2:0], vol[3:0], phase[19:12]} (15-bit, 零扩展到 19-bit)

- 8 种波形 × 16 音量 × 256 索引 = 32768 字节 (32KB)
- 波形 128 点, 4-bit 无符号 (0-15), 预计算 wave[sample] × vol = 8-bit (0-225)
- 存在第二片 39SF040

### 波形列表

| 索引 | 名称 | 说明 |
|---|---|---|
| 0 | sine | 正弦波 |
| 1 | square | 方波 (50%) |
| 2 | sq12 | 窄方波 (12.5%) |
| 3 | sq25 | 窄方波 (25%) |
| 4 | saw | 锯齿波 |
| 5 | triangle | 三角波 |
| 6 | noise | 伪随机噪声 |
| 7 | sine2x | 二倍频正弦 |

## 参数 RAM (7134) 地址映射

| 地址 | 字段 | 说明 |
|---|---|---|
| voice×8 + 0..4 | freq nibble 0..4 | 频率步进 (每 nibble 4-bit, 低地址低位) |
| voice×8 + 5 | wave_idx | 波形选择 (低 3 bit) |
| voice×8 + 6 | vol | 音量 (低 4 bit, 0=静音, 15=最大) |

## Phase RAM (62256) 地址映射

| 地址 | 字段 | 说明 |
|---|---|---|
| voice×5 + 0..4 | phase nibble 0..4 | 累加器相位 (硬件读写, CPU 不访问) |

## 频率计算

`step = freq × 2^20 / 96000`

| 音符 | 频率 | step (20-bit) |
|---|---|---|
| C4 | 261.63 | 0x00595 |
| D4 | 293.66 | 0x00644 |
| E4 | 329.63 | 0x00708 |
| F4 | 349.23 | 0x00773 |
| G4 | 392.00 | 0x0085D |
| A4 | 440.00 | 0x00963 |
| B4 | 493.88 | 0x00A89 |
| C5 | 523.25 | 0x00B2A |

## 音域

- 最低音 (step=1): 96000 / 2^20 = **0.091 Hz**
- 最高音 (step=0xFFFFF): **6000 Hz**

## 混音与输出 (TDM 分时复用, WSG 风格)

不使用数字累加, 改为与 Pac-Man WSG 一致的**分时复用**输出: 3 通道的查表结果在各自 lookup 步直接锁存到 273 输出寄存器, DAC 输出端接 R-2R 电阻网络 + RC 低通滤波器, 模拟域完成混音。

- step 7  (v0 lookup): dac_out <= rom_dq(v0)
- step 15 (v1 lookup): dac_out <= rom_dq(v1)
- step 23 (v2 lookup): dac_out <= rom_dq(v2)
- step 0-6, 8-14, 16-22, 24-31: dac_out 保持上一值

每采样周期 (32 步) dac_out 切换 3 次, 96kHz 采样率 × 3 = 288kHz 等效刷新率, 高于人听阈, RC 低通即可还原。3 通道独立 0-225, 无混音溢出问题。

硬件优势: 省去数字混音加法器 (原 283 累加), 输出通路更接近 WSG 原版。

## 仿真说明

仿真中以下模块用 reg 实现 (避免跨实例 NBA 时序竞争):

| reg | 对应硬件 | 说明 |
|-----|---|---|
| accum_q[5:0] | 74HC174 | 累加器锁存 (含进位) |
| phase_mem[0:14] | 74HC62256 | 15 个 4-bit phase nibble (3 voice × 5) |
| phase_v0/v1/v2 | 62256 内容 | 3×20-bit phase 寄存器 |
| cur_vol_r, cur_wave_r | 74HC174 | vol/wave 锁存 |
| dac_out[7:0] | 74HC273 | DAC 输出锁存 (TDM, 3 voice 分时) |

真实硬件上这些可以直接实例化, 无时序问题。

仿真注意: iverilog 的 delta cycle 机制下, 组合逻辑输出 (ROM DQ, 7134 DO_R) 在 posedge 时还未稳定, 因此 vol/wave/DAC 锁存改用 negedge STEP_CLK。phase_v0/v1/v2 必须初始化为 0 (否则 X 传播)。add_sum/rom_dq 加 X 防护 (`^x === 1'bx ? 0 : x`), 真实硬件不需要。

## 芯片模型文件

| 文件 | 芯片 | 来源 |
|---|---|---|
| rtl/hc7134.v | IDT7134 双端口 SRAM | 自建 |
| rtl/hc62256.v | CY62256N SRAM | 自建 |
| rtl/hc39sf040.v | SST39SF040A Flash ROM | 自建 |
| rtl/hc283.v | 74HC283 4-bit 全加器 | 自建 |
| rtl/hc174.v | 74HC174 六D触发器 | 自建 |
| rtl/hc161.v | 74HC161 4-bit 计数器 | 自建 |
| rtl/hc273.v | 74HC273 八D触发器 | ice-chips 库 |

## ROM 文件

| 文件 | 用途 | 大小 |
|---|---|---|
| rom/rom_instruction.hex | 指令 ROM (gen_rom.py 生成, 32 字节有效) | 512KB |
| rom/rom_wavetable.hex | 波表 ROM (gen_rom.py 生成, 32KB 有效) | 512KB |
| rom/gen_rom.py | ROM 生成脚本 | - |

## 参考

- Pac-Man 技术文档: `reference/Namco WSG/Pac-Man技术文档_extracted/`
- Pac-Man Emulation Guide: `reference/Namco WSG/PacmanEmulation_extracted/`
