denjhang/74HC-Chiptune/psg_voice/PSG2 v0.3/docs/design.md

# PSG2 v0.3 设计文档

> 两通道 PSG（CH0 方波占空比 + CH1 LFSR 白噪音）
> 创建时间：2026-07-02
> 状态：**RTL + 仿真 + WAV 试听全部通过，硬件上板进行中**

## 项目独特性（全球搜证 2026-07-02）

**用最少 74 门做 PSG 原型并真上板，全球开源社区目前没有同类项目。**

### 对比 1: 同类 PSG 复刻

| 对比项目 | IC 数量 | 完成度 |
|---|---|---|
| mengstr/Discrete-AY-3-8910 (最接近) | 104 片 | 仅 Digital 仿真器画图，**未做硬件** |
| rejunity/tt05-psg-ay8913 | 1500-1600 门 | FPGA/ASIC，**非 74 离散逻辑** |
| 日本博客 AY8910 项目 | — | **停更未完成** |
| **本项目 PSG2 v0.3** | **16 片** | **iverilog+WAV 试听+真硬件上板** |

### 对比 2: HDL→74 综合路线（Pepijn de Vos / yosys 自动综合）

本项目与"用 yosys/ghdl 把 Verilog 自动综合成 74 门"的路线**本质对立**:

| | yosys 自动综合 (Pepijn de Vos) | **本项目: 全实例化** |
|---|---|---|
| 代表 demo | breathing LED = **5 片** | PSG 方波+音量 = **7 片** |
| 设计方法 | 行为级 Verilog → yosys 综合 → 映射 74 | **手写实例化真实 74 芯片模型** |
| 门利用率 | 极低（综合器不懂芯片级优化）| **每个门都有用，无隐藏门** |
| 可控性 | 黑盒（综合结果不可预测）| **完全可控（接线表逐脚标注）** |
| 实用性 | 无（demo 玩具，无人做复杂功能）| **真 PSG 原型，上板出声** |

**本项目核心原则**（与综合路线的区别）:
- **全实例化，无隐藏门**: RTL 直接实例化 hc161/hc164/cd4070 等真实芯片模型，不写抽象行为级让综合器猜
- **74 TTL 高利用率**: 每片芯片的每个门都有用途（HC00 剩余门借给噪音通道，不浪费）
- **人脑做架构，AI 做验证**: 架构决策由人（选什么芯片/怎么连线），AI 负责 RTL 建模+仿真+WAV 试听+接线表

**设计哲学**：
- **7 片起步**（v0.2 基础方波+音量，已上板出声）→ **按需扩展**到 16 片
- 每加一个功能都经仿真+WAV 试听确认值得那几片芯片（周期噪音试听不可用就砍掉）
- 实用主义原型，不是 1:1 复刻专用 IC

**AI 辅助流程**（glm + iverilog，**不是 yosys 综合**）：
架构规划→RTL→仿真→WAV 试听→接线表→上板，全流程闭环。
iverilog 只做**仿真验证**（功能对不对），不做综合（不替你决定用几片芯片）。
遇到的问题都是接线/门类型/电平，无架构硬伤。流程方法论见 CLAUDE.md 5.5 节。

## 一句话目标

v0.3 从 v0.2 的单通道方波，扩展到 **两通道**（PSG1→PSG2 的版本跨越）。
核心设计原则：**纯数字电路，不用 RC/电阻网络，每通道复用已验证的方波逻辑**。

## 长期愿景（音源方向路线图）

PSG 是"用 74 门设计数字音源"的起点。后续方向（声音反馈直观，先于 CPU/时序方向）:

| 阶段 | 内容 | 状态 |
|---|---|---|
| PSG1 v0.1-v0.2 | 方波 + 4bit 音量 + ADSR | ✅ 上板出声 |
| **PSG2 v0.3** | **方波占空比 + LFSR 噪音** | **上板中** |
| SCC 波形内存 | 计数器查 RAM/ROM + DAC | 库存够, 下一个目标 |
| PCM/ADPCM | 地址计数 + ROM + DAC (+HC283 差分解码) | 与 SCC 共享硬件 |
| FM 合成 | 相位累加 + 正弦 ROM + 相位调制 | 最难, SCC 通了再上 |

**软件镜像**: STC32G144 (sn76489.c/ay8910.c) 是同算法软件版, 算法已验证, 可翻译成 74 门。
**同源延伸 (暂缓)**: 39040cpu (74 CPU), prog_timer (定时器)。音源跑通再回头。

---

## 一、设计原则（从 v0.2 带过来的铁律）

1. **已验证的方波通道直接复制，不搞共享/查表逻辑**。稳定性优先于省芯片。
2. **每通道方波规格**：5 片做频率（2×HC161 + HC373 + HC00 + HCT74），2 片做音量（HC374 + TLC7524）。
3. **TLC7524 节省无源器件**：v0.2 证实 TLC7524 内置 R-2R，省掉所有外部电阻网络/RC。v0.3 延续。
4. **波形数据走 TLC7524 的 DB（数字），REF 接固定/方波参考**。
5. **每通道固定一种波形（不切换）**：CH0=方波, CH1=LFSR噪音, 每通道独立设计。

---

## 二、通道架构（已定：固定波形通道，每通道独立设计）

### 决策：每通道固定一种波形，不做切换

经过讨论 (原第五章"复用HC161切波形"已弃用)，结论：
**波形切换太复杂**（period 计数与满幅度计数冲突，复用 HC161 要么不满幅度要么频率不对），
**独立通道设计反而简单稳定**——每通道一种波形，各管各的，符合"已验证逻辑直接复制"原则。

### 通道规划（最终，PSG2 = 2 通道）

> PSG2 聚焦两通道研究：方波（v0.2 复用）+ LFSR 噪音。
> 锯齿/三角为后续扩展方向，杜邦线有限时可能拆方波换锯齿/三角。

| 通道 | 波形 | 设计要点 |
|---|---|---|
| CH0 | 方波+占空比+白噪+Q调制 | 复用 v0.2 toggle, 三层音色叠加 (占空比+mode+REF调制), 见第五/六章 |
| CH1 | LFSR 噪音 | HC164+4070+HC161+HC153 → TLC7524.REF (6片核心, 见第四章) |
| (扩展) | 锯齿波 | 独立计数器(满0-255) → TLC7524#1(DB0-7波形) → TLC7524#2(音量级联) |
| (扩展) | 三角波 | CD4029可逆计数(满0-255) → TLC7524#1(波形) → TLC7524#2(音量级联) |

### 各通道的 DAC 用法（关键区别）

**1-bit 波形（方波/噪音）→ 1 片 TLC7524**：
波形是 0/5V 模拟量，直接进 REF。DB4-7 接音量码。
```
波形(0/5V) ──→ TLC7524.REF
音量码   ──→ TLC7524.DB4-7  → 输出 = 波形 × 音量/256
```
(v0.2 已验证此法可行)

**8-bit 波形（锯齿/三角）→ HC273 毛刺滤除 + 2 片 TLC7524 级联**：
波形是 8 位数字，第一片做 D/A（DB0-7 接计数器），第二片做音量衰减。
**关键：HC161 的 Q 必须经 HC273 同步锁存才能喂 DAC**（详见下方毛刺滤除）。

```
计数器 Q0-7 ──→ [HC273 毛刺滤除] ──→ TLC7524#1.DB0-7  (REF=5V) → 阶梯波形模拟量
                                                              ↓
音量码 ──→ TLC7524#2.DB4-7 (REF=#1输出) → 衰减后波形
```
(乘法 DAC 级联，第一片输出 = 5V×(Q/256)，第二片 = #1输出 × 音量/256)

#### ⚠️ HC273 毛刺滤除（锯齿/三角音质刚需，PSG3 上板必加）

**问题**：HC161 的 Q0-7 在计数翻转瞬间有毛刺（4 个触发器不同步跳变，如 0111→1000 经过瞬态）。
直接喂 TLC7524 会把瞬态也转成电压 → 阶梯波上有尖刺噪音。

**为什么 TLC7524 自带的 WR 锁存不够**：
- TLC7524 的 WR/CS 是**电平透明锁存**（类似 373）：CS=0 且 WR=0 时 DB 直通，WR 上升沿锁存
- 透明期间（WR 低）Q 的毛刺会直通到 DAC 输出，挡不住
- 方波模式 WR/CS 接 GND（常透明）没问题，因为 DB 是音量码（基本不变）
- 锯齿模式 DB 不断变化，必须用**边沿寄存器**在 clk 沿干净采样

**解法（Gigatron 同款）**：HC161 和 HC273 共用 clk，clk 上升沿：
- HC161 更新 Q（新值，但输出还在跳变）
- HC273 锁存 HC161 的 Q（建立时间满足的话锁的是**上一个** clk 周期的稳定值）
- 等于延迟一拍，但完全同步，毛刺被挡

```
clk ──→ HC161.CP (Q 更新, 有瞬态)
  └──→ HC273.CP (锁存 HC161.Q 的稳定值, 无毛刺)
              ↓
         TLC7524.DB0-7 (干净阶梯波)
```

**芯片成本**：锯齿/三角通道因此各 +1 片 HC273（库存充足）。这是音质保证的刚需，不能省。
v0.2 方波通道不需要 HC273（toggle 是 1-bit 边沿干净信号，且 DAC 当衰减器不当生波形器）。

### 混音方式（待定）

各通道 TLC7524 输出怎么合并到喇叭：
- 电阻求和网络（无源，简单）
- 运放加法器（有源，隔离好）
待讨论。

---

## 三、各波形通道的成本估算

基于候选 B（2 片 TLC7524 级联用于锯齿/三角，1 片用于方波/噪音）：

| 通道 | 波形 | 频率部分 | 波形产生 | 音量 | 总芯片 |
|---|---|---|---|---|---|
| CH0 | 方波+占空比+白噪+Q调制 | 2×HC161+HC373+HC00+HCT74 | 三层切换: HC153占空比(DB) + HC4053双SPDT(mode+REF) | HC374+TLC7524×1 +HC74+HC08+HC153+HC4053 | 11 |
| CH1 | LFSR噪音(独立通道, 可选) | HC161(独立分频)+HC153(4选1) | 164+4070(3门反馈)→REF | HC374+TLC7524×1 | 6 |
| (扩展) | 锯齿 | 2×HC161+HC373+HC00 | Q→**HC273**(毛刺滤除)→TLC7524#1 | HC374+HC273+TLC7524×2 | 8 |
| (扩展) | 三角 | 4029+方向控制+HC373+HC00 | Q→**HC273**→TLC7524#1 | HC374+HC273+TLC7524×2 | 8-9 |

**PSG2 两通道（CH0方波全音色 + CH1噪音）≈ 17 片 + 混音运放**
（CH0 三层音色叠加: 占空比×mode×REF调制 = 32 种组合探索; CH1 LFSR 噪音可选, 若 CH0 白噪够用可省）
**扩展到锯齿/三角 ≈ 各加 8 片**（含 HC273 毛刺滤除，PSG3 音质刚需）

---

## 四、LFSR 白噪音通道设计（最终定稿 2026-07-02）

> 纯白噪音通道（周期噪音经试听验证不可用，已砍，见 4.10 弃用记录）。
> 两种时钟模式：独立分频（4挡）+ 绑定方波（噪音跟音高）。
> max-length 8 位 LFSR（Q7⊕Q5⊕Q4⊕Q3，周期 255），种子非0 永不自锁。

### 4.1 芯片清单（6 片核心，0 额外防护芯片）

| 芯片 | 用途 | 说明 |
|---|---|---|
| CD4070 | 白噪反馈 | 门1-3: Q7⊕Q5⊕Q4⊕Q3 (max-length 周期255); 门4: 闲置 |
| HC164 | LFSR 主体 | 8 位串入并出 (Q0-Q7 全引出); MR 常接1, 靠 serial_in 灌种 |
| HC161 | 独立分频 | 64kHz ÷2/÷4/÷8/÷16 (自由计数, CEP/CET=1) |
| HC153 | 频率选通 | 上半部 4 选 1 (仅独立模式); 下半部闲置 |
| HC374 | 8 bit 寄存器 | 频率+绑定+音量 |
| TLC7524 | 1-bit DAC | REF=Q7, DB4-7=音量 |

**绑定开关**：借 v0.2 方波通道 HC00 剩余门做 2 选 1（独立时钟 vs square_tc），0 额外芯片。
**死锁防护**：RST 期间 serial_in=1 灌种子（借 HC00 剩余门反相 RST），白噪 max-length 自持。

### 4.2 寄存器（8 bit，1 片 HC374，与方波风格统一：音量在 bit0-3）

```
bit0-3: 音量 (4 bit = 16 级, Q0-Q3 → DB4-7)

bit4-5: 频率挡 (2 bit = 4 挡, 仅独立模式 bind=0 时生效)
        00 = HC161.Q0 (÷2,  32kHz 最高频白噪)
        01 = HC161.Q1 (÷4,  16kHz)
        10 = HC161.Q2 (÷8,   8kHz)
        11 = HC161.Q3 (÷16,  4kHz 低频杂音)

bit6:   绑定开关
        0 = 独立噪音 (时钟来自 HC161 分频, 噪音频率固定 4 挡)
        1 = 绑定方波 (noise_clk 直通 square_tc, 噪音频率 = 2×方波频率)

bit7:   预留
```

### 4.3 数据流（完整连线）

```
                        64kHz 全局晶振
                              │
                              ▼
                    HC161.CLK (自由计数, CET/CEP=1)
                              │
              ┌───────┬───────┴───────┬────────┐
             Q0      Q1              Q2        Q3
              │       │               │         │ (独立模式 4 挡分频)
              ▼       ▼               ▼         ▼
           153.1C0  153.1C1       153.1C2   153.1C3   ← HC153 上半部 4选1
                              (bit0-1 当地址)
                              153.1Y (独立时钟)
                                     │
                                     ▼
                    ┌── 2选1 (bind 控制) ──┐
                    │                       │
              bind=0: ind_clk        bind=1: square_tc (方波通道TC)
                    │                       │
                    └─────────┬─────────────┘
                              ▼
                         noise_clk ──→ HC164.CP
                    (2选1 借 HC00 剩余门: NAND(NAND(ind,!bind),NAND(tc,bind)))

HC164.Q7 ─┐
HC164.Q5 ─┤→ 4070 门1 (Q7⊕Q5)
HC164.Q4 ─┤→ 4070 门2 (Q4⊕Q3)  → 门3 汇总 → xor_fb (max-length 反馈)
HC164.Q3 ─┘
                              ↓
              serial_in = (!rst_n) ? 1 : xor_fb   (RST 灌种)
                              ↓
                         HC164.DSA (串入)

HC164.Q7 ──→ TLC7524.REF        (1-bit 波形)
HC374.bit4-7 ──→ TLC7524.DB4-7  (音量)
HC374.bit0-1 ──→ HC153 地址     (频率挡, 独立模式)
HC374.bit3   ──→ HC00 2选1 控制  (绑定开关)
```

### 4.4 绑定模式（直通 square_tc, 仿真验证 2026-07-02, 实测修正 2026-07-07）

**bind=1 时 noise_clk 直通 square_tc**，噪音频率 = TC 频率 = 2×方波频率。

| 音 | period | 方波频率 | 噪音频率 (LFSR 时钟) | 听感 (2026-07-07 实测) |
|----|---|---|---|---|
| C3 | 11 | 131 Hz | 261 Hz | ❌ 太低, 不实用 |
| C4 | 133 | 262 Hz | 520 Hz | ❌ 太低, 不实用 |
| C5 | 194 | 516 Hz | 1032 Hz | ❌ 太低, 不实用 |
| C6 | 225 | 1032 Hz | 2065 Hz | ⚠️ 临界 (2000Hz 刚够) |
| C7 | 240 | 2000 Hz | 4000 Hz | ✅ 实用 |
| 更高 | 241-255 | 2000-32000Hz | 4000-64000Hz | ✅ **实用区间** |

**⚠️ 实测结论 (2026-07-07, 重要设计约束)**:
- **噪音要 kHz 级才有实用性** (≥2000Hz 才听得清是"噪音"而不是稀疏颗粒)
- 绑定模式实用区间: **方波 2000-32000Hz (period 240-255)**, 只有 16 档可调
- 绑定模式"嗨镲跟旋律走"的实际音域很窄 (只有高音区有效), 不如预期灵活
- **独立模式 4 挡 (÷2=32k / ÷4=16k / ÷8=8k / ÷16=4k) 全部实用** (都在 kHz 级)

**设计影响**:
- 独立模式是主用 (4 挡全部 kHz 级, 覆盖完整噪音音色)
- 绑定模式是辅助 (只在旋律进入高音区时"嗨镹跟进", 不能全程跟)
- 这和方波"有效音域 ≤2000Hz"形成对照 — 方波要低, 噪音要高

**⚠️ 芯片架构影响绑定模式音域 (2026-07-08 用户实测对比)**:

| 芯片 | 绑定模式实用频率 | 覆盖音域 |
|---|---|---|
| HC374/LS374 (rev.a) | 2000-32000Hz | 只有 C7+ 高音区 |
| **HC164 (国产)** | **200-32000Hz** | **C3-C7+ 全音域** |

**HC164 绑定模式低频也有用 (200Hz), HC374 不行.** 原因是芯片架构差异:
- HC164 是**串入并出移位寄存器**, 内部 8 级 D 触发器链, Q7 经过 8 级传播延迟累积
  → 低频 noise_clk 时, 移位模拟瞬态在 8 级间传播, 产生更丰富的低频成分 → 低频音色"厚"
- HC374 是**并行 D 触发器 (octal)**, 各级独立, 没有级联累积效应
  → 低频时音色"薄", 要 kHz 级才有质感
- 这是**架构差异, 不是质量差异** — HC164 的串行级联结构反而对噪音生成有利

**rev.a 切到 HC374 的决定可能需要修正**:
- 原以为 HC164 国产锁死, 实测发现是启动电路问题 (HC164 国产也能用)
- HC164 + 持续模拟注入 = 宽音域 + 防锁死 (rev.b 候选, 见 wiring-table-rev-a 末尾)

### 4.5 死锁防护（RST 灌种, 0 额外芯片）

HC164 的 MR 异步清零无置位能力（datasheet 查证），RST 后全 0 会死锁白噪反馈。
解法：**RST 期间 serial_in=1 持续灌种子**，8 拍后 LFSR=0xFF，白噪自持。
- 硬件：借 v0.2 方波通道 HC00 剩余门把 rst_n 反相，RST 时强制 serial_in=1
- 白噪 max-length 性质：种子非 0 永不归零（仿真验证 2000 拍 0 次归零）

### 4.6 仿真验证结果（2026-07-02）

| 测试项 | 结果 | WAV |
|---|---|-----|
| 白噪独立 4 挡 (÷2/÷4/÷8/÷16) | 全部可用 | 白噪_独立_÷{2,4,8,16}.wav |
| 绑定 C3-C7 (直通 square_tc) | 全部可用 | bind_C{3,4,5,6,7}.wav |
| max-length 周期 255 | 验证通过 | psg_lfsr_lock_tb.v |
| 静音 (vol=0) | audio=0 | psg_noise_v03_tb.v |

### 4.7 弃用方案记录

#### 周期噪音（已砍，试听验证不可用）

**思路**：bit2 选白噪/周期，周期模式 Q0 自反馈做窄脉冲底鼓。
**弃用原因**（试听 + 振幅分析验证）：
- Q0 自反馈 = 环形移位，必须种子恰好 1 个 1 才周期 8
- HC164 无预置能力，从全 0/全 1/任意态都会死锁或退化成 DC 直流
- 加 CD4078 检测全 0：周期模式归零后注入 1，但又退化归零，循环往复（断续）
- 反馈改 ~Q0：退化成纯方波振荡器，不是噪音
- 试听结果：周期噪音要么死锁无声，要么是方波，无实用性
**结论**：砍周期模式，bit2 预留。纯白噪 4 挡 + 绑定已够用（嗨镲/军鼓/环境）。

#### 旧绑定方案 CET 门控（已弃用，方向反）

**思路**：HC161.CET = bind ? square_tc : 1，绑定时 HC161 对 TC 计数再分频。
**弃用原因**：噪音频率 = (64kHz/period)/freq_sel，**period 越大（音越高）噪音越低**，
与"音越高噪音越密"的直觉相反。C3 有用 C7 几乎无声。
**结论**：改成 bind=1 时 noise_clk 直通 square_tc（见 4.4）。

---

## 五、方波占空比扩展（CH0，仿真验证通过 2026-07-02）

> 在 v0.2 纯净 toggle 方波（Q1，50%，频率 f）后加分频链 + AND 组合，
> 实现 4 挡占空比切换。**占空比变窄时频率同步降低**（每级÷2）。
> 顺带扩展音域到 C0（原 period 极限只能到 C3）。

### 5.1 芯片清单（新增 3 片）

| 芯片 | 用途 |
|---|---|
| HC74（U8）| FF3(÷2→Q2) + FF4(÷2→Q3)，分频链 |
| HC08（U9）| 3 个 AND 门做 duty 组合 |
| HC153（U10）| 4 选 1 占空比挡 |

v0.2 原 7 片（HC373+2×HC161+HC00+HCT74+HC374+TLC7524）+ 新增 3 片 = **方波通道共 10 片**。

### 5.2 分频链

```
Q1 (U5 toggle, 50%, f) ──→ FF3 (U8 半片1, T触发器÷2) ──→ Q2 (50%, f/2)
Q2 ──→ FF4 (U8 半片2, T触发器÷2) ──→ Q3 (50%, f/4)
```

两级 toggle 分频，Q1/Q2/Q3 都是 50% 方波，频率递降（f → f/2 → f/4）。

### 5.3 占空比组合（HC08 AND 门）

```
duty_50  = Q1                    (原频 f, 50%)
duty_25  = Q1 AND Q2             (f/2, 高电平只在 Q1=Q2=1 时 → 25%)
duty_125 = duty_25 AND Q3        (f/4, 复用 duty_25 → 12.5%)
duty_625 = Q2 AND Q3             (f/4, 25% 变体)
```

3 个 AND 用 HC08 的 3 门（门4 闲置）。duty_125 复用 duty_25 省一个门。

### 5.4 占空比挡位（仿真实测，A4 period=183）

| bit0-1 | 输出 | 占空比 | 频率 | 听感 |
|---|---|---|---|---|
| 00 | Q1 | 50% | f（438Hz）| 纯净方波 |
| 01 | Q1·Q2 | 25% | f/2（219Hz）| 窄脉冲，谐波多 |
| 10 | Q1·Q2·Q3 | 12.5% | f/4（110Hz）| 更窄，鼻音 |
| 11 | Q2·Q3 | 25% | f/4（110Hz）| 25%@低八度 |

### 5.5 特性

- **占空比变窄 → 频率降低**：25% 挡降一个八度，12.5% 挡降两个八度。
- **软件移调补偿**：选窄占空比挡时，period 减半/÷4 可回到原音高。
- **音域扩展**：12.5%@f/4 挡让原 period 范围（C3+）下探到 C0。
- **音色变化**：占空比越窄谐波越丰富（SID pulse wave 风格）。

### 5.6 寄存器改动（HC374）

**音量不动**（bit0-3，Q0-Q3 → DB4-7，与 v0.2 完全一致）。
**占空比放 bit4-5**（v0.2 这两位接地，v0.3 启用）。
**mode 放 bit6**（方波/白噪切换，见 5.8 节白噪发现）。

```
bit0-3: 音量 (16 级, Q0-Q3 → DB4-7, 与 v0.2 一致)
bit4-5: 占空比挡 (00=50% / 01=25% / 10=12.5% / 11=25%@f/4变体)
bit6:   mode (0=方波, 1=白噪)
bit7:   预留
```

驱动改动：`self._c = (vol & 0x0F) | ((duty & 0x03) << 4) | ((mode & 1) << 6)`（v0.2 是 `self._c = vol & 0x0F`）。

### 5.7 详细接线

见 `wiring-table.md`（U6 改动 + U8/U9/U10/U11 新增）。

### 5.8 白噪模式发现（bug 变 feature，硬件实测 2026-07-02）

**意外收获（认知突破）**：在这个发现之前，一直以为**噪音和方波是完全不同的东西**，
需要独立的 LFSR 通道。结果**改一根线**（7474 FF1.D 从 tc_hi 改接 pe_n）就出来了。
这说明在 74 离散逻辑里，**方波和噪音是同源的** — 都是"计数器 + D 触发器"的产物，
区别只在 D 输入接哪个信号 (tc_hi = 确定性方波; pe_n = 采样竞争 = 噪音).
这个认知让 CH1 独立 LFSR 通道的必要性打折扣 (见 5.8.2 决策点).

**现象**：把 7474 FF1 的 D 输入从 tc_hi 改接到 pe_n（HC00 反相 tc_hi 的输出），
方波通道**意外输出高频白噪**，有实用性。

**原理**（硬件物理延迟产物）：
- HC00 的真实传播延迟（几 ns~几十 ns）使 pe_n 的跳变沿相对 tc_hi 偏移
- 7474 FF1 用 clk=64kHz 采样时，落点随 period 微妙变化（有时赶上 clk 沿，有时赶不上）
- toggle 翻转时机呈现"看似随机"的模式 → 输出白噪
- 这是**真实硬件的元现象**，iverilog 仿真复现不了（理想 HC00 零延迟）

**实现（HC4053 开关 X，与 REF 切换合并成一片）**：HC4053 双 SPDT，开关 X 切 FF1 的 D 输入源：
- mode=0: X-COM = tc_hi（正常方波）
- mode=1: X-COM = pe_n（白噪模式）

```
pe_n (HC00 反相 tc_hi) ─┐
                        ├→ HC4053 开关 X (mode 控制) ─→ 7474 FF1.D
tc_hi ──────────────────┘
```
HC4053 开关 Z 同时管 REF 切换（占空比变体/Q0），**一片双 SPDT 顶原 HC86 + REF 开关**。

**特性与局限**：
- ✅ 0 额外噪音芯片（方波通道自带，只 +1 片 HC86 做切换）
- ✅ 占空比链在白噪模式下仍生效（Q2/Q3 分频不受影响）
- ❌ 白噪音色依赖具体 HC00 的物理延迟（批次/温度/电压相关，不可控）
- ❌ 仿真无法预测（iverilog 理想门），只能上板实测
- ❌ 不如 LFSR 噪音可控（无频率挡/绑定）

**vs LFSR 噪音通道（CH1）**：
- HC86 白噪：0 额外噪音芯片（+1 HC86 切换），不可控，硬件元现象
- LFSR 通道：6 片，可控（频率挡/绑定/max-length），数字确定
- 两者可共存（CH0 自带白噪 + CH1 LFSR），也可只用 CH0 白噪省掉 CH1

#### 5.8.1 mode 白噪的物理本质 = 7474 采样竞争（2026-07-07 用户纠正）

⚠️ **关键纠正**: 噪声不是"AND(TC) + HC00 延迟"直接产生的. TC 或 /PE 直接接喇叭/运放,
只会听到**刺耳的高频变形方波** (周期信号, 不是噪声). **噪声产生的必要条件是 7474 D 触发器的采样**.

**正确的机理 (采样竞争, sampling race)**:

1. **tc_hi 是稳定的 period 频率方波**, 和 clk=64kHz 有固定相位关系
2. **pe_n = NOT(tc_hi)**, 但经过 HC00 反相器有 ~10ns 传播延迟
3. 这 10ns 延迟让 **pe_n 的跳变沿偏移到 clk 上升沿附近** (关键!)
4. 7474 是**边沿 D 触发器**, 在 clk 上升沿采样 D 输入:
   - mode=0 (D=tc_hi): 跳变沿远离 clk 沿, 每次确定性读到 0 或 1 → 干净方波
   - mode=1 (D=pe_n): **跳变沿落在 clk 上升沿附近**, 7474 采样时
     落在 pe_n 跳变的"建立时间窗"内 → **有时采到跳变前旧值, 有时采到跳变后新值**
5. 这个"采到新值还是旧值"**随 period 微妙变化** (period 改变 TC 频率 → 改变 pe_n 与 clk 的相位关系)
6. 7474 输出 Q 的翻转时机**看似随机** → 噪声

**所以噪声源不是 pe_n 信号本身** (它还是方波), 而是 **7474 采样落在跳变沿附近的"采样不确定性"**.
这是经典的**采样竞争 / 亚稳态 (metastability)** 现象, 必须有 D 触发器采样才能发生.

**直接接喇叭出不来噪声的原因**:
- TC/pe_n 直接进喇叭 = 模拟链路滤波放大方波, 没有采样动作
- 方波就是方波, 只是频率高 → 听到刺耳高频变形音 (周期性)
- 采样竞争只在 D 触发器的 clk 边沿发生, 模拟链路里不存在

**vs LFSR 的本质区别 (修正)**:

| | 真 LFSR (HC374) | mode 白噪 (7474 采样竞争) |
|---|---|---|
| 噪声源 | XOR 反馈的伪随机序列 | **7474 采样 pe_n 跳变沿的不确定性** |
| 需要 D 触发器 | 是 (做移位寄存器) | **是 (做采样器, 产生竞争)** — 必要条件 |
| 移位 | 显式 (HC374 八级) | 不需要 (7474 单级采样就够) |
| 反馈 | XOR (Q7⊕Q5⊕Q4⊕Q3) | 不需要 (pe_n 直接来自 HC00, 不构成反馈环) |
| 稳定性 | 数学保证 (max-length) | 物理保证 (HC00 延迟是常数 + reload 自持) |
| 锁死风险 | 高 (全 0 态, 需启动逻辑) | **无** (没有全 0 陷阱, AND 反馈 + reload 持续振荡) |

**关键认知修正**:
mode 白噪**不是"非理想 LFSR"** (之前的错误描述), 它根本**不是 LFSR** —
没有 XOR 反馈, 没有移位循环. 它是**采样竞争 (metastability) 的音频体现**:
- HC161 计数器 + reload 机制: 产生 pe_n 方波 (有相位抖动种子)
- HC00 反相器: 产生 ~10ns 延迟, 把 pe_n 跳变沿推到 clk 边沿附近
- 7474 D 触发器: **采样竞争产生真随机比特** ← 噪声源头在这
- 后级 7474 toggle / 占空比链: 把随机比特变成模拟波形

**三要素的修正**:
1. **相位抖动种子**: HC161 reload + HC00 延迟 (让 pe_n 和 clk 相位关系不固定)
2. **采样竞争**: 7474 在 clk 边沿采 pe_n (落在跳变窗内, 产生随机比特) ← 必要条件
3. **D 触发器级联 (整形/累积)**: 7474 FF1(sync) + FF2(toggle) 把随机比特变成可听波形

**这解释了 HC164 LFSR 上板失败 (2026-07-07) vs mode 白噪稳定的反差**:
- HC164 LFSR: 数学正确但**启动电路缺陷锁死** → 噪音出不来 (不是芯片问题, 2026-07-08 实测国产 HC164 也能用)
- mode 白噪: **采样竞争 + reload 自持**, 无锁死陷阱 → 稳定出声
- (mode 白噪不需要"启动逻辑", 因为 HC161 reload 机制天然保证持续振荡)

#### 5.8.1a mode 白噪实测特性 (2026-07-07 用户实测, 印证采样竞争机理)

用户调整外部时钟模块 + 占空比, 观察到三个现象, **全部印证采样竞争机理**:

**现象 1: 噪音频率只跟主 clk 有关, 跟 period 编程无关**

- 调高外部晶振频率 → 噪音频率升高
- 调低晶振 → 噪音频率降低
- **改 period (编程音高) → 噪音频率不变**

采样竞争解释: 随机比特**只在 clk 上升沿产生** (7474 采样点).
- clk 越快 → 每秒采样次数越多 → 随机比特越密 → 噪音频率越高
- period 改的是 HC161 计数周期 (pe_n 方波频率), 只影响"pe_n 与 clk 的相位关系"
  (决定采到 0 还是 1 的概率分布), **不影响采样速率本身**
- 所以噪音频率 = 主 clk 驱动, period 编程无效

**vs 真 LFSR 的根本区别**: LFSR 噪音频率 = 移位时钟 (可编程).
mode 白噪频率 = 主 clk (锁死, 换晶振才能改). 这决定了 mode 白噪**无法做"绑定模式"**
(噪音跟音高走), 只能做固定频率环境噪声.

**现象 2: 噪音过后面的占空比电路, 占空比影响音量 + 频率**

占空比链 (Q2/Q3 分频) 在 mode 白噪路径的**后面** (toggle 之后):
- **占空比越窄, 音量越小**: 25% 占空比 = 高电平只占 1/4 周期 → 平均能量是 50% 的一半 → 音量降低
- **占空比越窄, 频率越高**: 25%@f/2 挡, 频率翻倍 → 噪音脉冲更密集
- **50% 占空比最饱满**: 高电平占一半, 平均能量最大, 频率最低 (基频 f) → 听感最厚实

这是 mode 白噪和独立 LFSR 通道的另一区别 — LFSR 通道的音量/频率独立可控,
mode 白噪的音量和频率**被占空比耦合** (占空比一改, 两者一起变).

**现象 3: 跨越数字/模拟边界 (神奇之处)**

mode 白噪的"神奇"在于它**不在 RTL 逻辑模型里**:
- HC00 延迟: 模拟特性 (传播延迟, 非零)
- 7474 采样竞争: 时序不确定 (亚稳态, 建立时间窗)
- 两者组合产生**真随机** (物理随机, 不是 LFSR 的伪随机数学序列)
- iverilog 仿真 (理想零延迟 + 确定时序) 完全复现不了

**mode 白噪 vs HC374 LFSR 特性总结**:

| 特性 | HC374 LFSR (rev.a) | mode 白噪 (采样竞争) |
|---|---|---|
| 频率可控 | ✅ 编程 (HC161 分频 + 绑定) | ❌ 锁死在主 clk |
| period 编程有效 | ✅ (绑定模式) | ❌ 无效 |
| 音量/音色 | 独立 (vol + DAC) | 占空比耦合 (一改两者一起变) |
| 随机性 | 伪随机 (周期 255) | **真随机 (物理)** |
| 防锁死 | 要 RC 启动 | 天然 (reload 自持) |
| 仿真可预测 | ✅ | ❌ (iverilog 复现不了) |

**结论**: mode 白噪作为"固定频率环境噪声/底鼓"够用, 但**无法替代 LFSR 做可控噪音**
(无频率挡/绑定). 两者定位不同, 必要时可共存.

#### 5.8.2 HC161 噪音方案 (备选, 2026-07-07)

**如果 HC374 LFSR (rev.a) 上板再失败, 回到 HC161 噪音方案**.

mode 白噪 (5.8.1) 的关键是 **HC161 reload 机制 + HC00 延迟 + 7474 采样竞争**.
HC161 计数器自带的 reload (TC → /PE 预置) 保证**永不锁死** — AND 反馈 + 预置机制
没有"全 0 陷阱", 持续振荡. **这是 HC161 方案最大优势: 天然防锁死, 不需要 RC 启动逻辑**.

**mode 白噪的本质是采样竞争 (非 LFSR)**, 但它揭示了一个重要事实:
**噪声不一定要靠 XOR 反馈的伪随机序列, 采样竞争也能产生真随机比特**.
HC161 reload + HC00 延迟制造相位抖动种子, 7474 在 clk 边沿采样产生随机比特,
后级 D 触发器整形累积成可听噪声.

**可能的 HC161 噪音实现路线** (待 rev.a 失败后深挖):
- 直接复用 mode 白噪 (bit6, HC4053 切 pe_n 到 7474.D): 已验证可用, 0 额外噪音芯片
- HC161 + 7474 多级采样竞争: 增加随机性 (但音色仍批次相关)
- HC161 级联做长周期伪随机 (TC 异或反馈到 /PE, 但 HC161 TC 固定 AND, 要外接 XOR + 预置位组合逻辑)
- 关键优势: reload 机制替代 LFSR 启动逻辑, **0 RC 0 额外启动芯片**

**vs HC374 LFSR (rev.a)**:
- HC374: 数学正确 (max-length 伪随机), 但要 RC 启动 (启动电路是关键, 不是芯片质量)
- HC161/mode 白噪: 采样竞争 (物理随机), 天然防锁死, 但音色批次相关不可控

**决策点**:
1. 先上 rev.a (HC374 + RC 启动), 若稳定就定 rev.a
2. rev.a 再失败 → 回 HC161 方案, 深挖"采样竞争"做噪音 (mode 白噪已验证可用)
3. 最终兜底: 只用 CH0 mode 白噪 (bit6), 砍掉独立噪音通道 (省 6-7 片)

mode 白噪的物理本质 (采样竞争) 让我们知道: **噪音不需要理想 LFSR**.
"HC161 reload 相位抖动 + 7474 采样竞争"的组合也能稳定出声, 且天然防锁死.
这是 HC161 方案作为备选的可靠性基础.

### 5.9 完整音色矩阵（三层叠加，面包板探索期穷尽音色）

**CH0 方波通道的音色由三层独立切换叠加**：

| 层 | 路径 | 切换芯片 | 控制位 | 切换内容 |
|----|---|---|---|---|
| 占空比 | DB（数字端）| HC153（U10）| bit4-5 | duty50/25/125/625 |
| mode | 1D（reload 源）| HC86（U11）| bit6 | tc_hi（方波）/ pe_n（白噪）|
| REF 调制 | REF（模拟端）| HC4053（SPDT 模拟开关）| bit7 | toggle/Q0 |

**理论组合**：4（占空比）× 2（mode）× 4（REF）= **32 种音色组合**。
（实际很多组合重复或无意义，探索期全保留，正式版按音乐需求精简。）

**REF 调制原理（面包板意外发现，2026-07-07 用户纠正）**：

⚠️ **关键纠正**: Q0/Q1 的管乐器音色**不是 TLC7524 乘法调制产生的**.
用户实测: **直接把音频线 (喇叭/运放) 插到 Q0/Q1 芰点, 就是这个音色** —
TLC7524 在这条路径上**只做音量衰减** (DB4-7 接音量码, REF 接 Q 抽头当波形输入,
输出 = Q 波形 × 音量/256), 不参与音色生成.

**音色来自 HC161 的 Q 输出本身**:
- HC161 的 Q0/Q1 不是理想方波 — 边沿有瞬态、过冲、谐波包络
- 这些**模拟特性直接就是音色** (小号/萨克斯的管乐器质感)
- TLC7524 只是被动衰减器, REF 是什么波形输出就是什么波形 (×音量系数)
- 即使没有 TLC7524, 直接拿 Q0/Q1 接运放, 听到的就是同样的音色

**为什么 iverilog 复现不了 (修正)**:
- 不是"乘法调制看不到", 而是 **HC161 的 Q 输出在仿真里是理想跳变** (`assign Q = q_reg`)
- 仿真里 Q0 就是干净方波, 没有模拟瞬态/过冲 → 听不到管乐器音色
- 真实硬件的 Q 输出带着边沿瞬态, 这些瞬态就是音色本身

**Q 抽头直接当模拟信号用（2026-07-07 用户实测）**:
Q0/Q1 不是"数字方波"那么简单 — 它们的**非理想边沿/瞬态/谐波**直接就是模拟音色信号,
不需要 DAC 调制. TLC7524 只是把音量调小 (衰减), 不改变音色本质.

实测 Q0/Q1 抽头音色 (2026-07-07):
- **Q0**: 泛音更高, 音色明亮 → 像**小号** (trumpet)
- **Q1**: 泛音较低, 音色温暖 → 像**萨克斯** (saxophone)
- 两者都**特别有特色**, 不是简单方波, 是有"管乐器质感"的音色
- Q2 频率太低 (C5 时无声), 不实用

这和 5.8 的 mode 白噪一样, 都是 **HC161 输出的非理想模拟特性**产生的意外音色.
HC161 的 Q 抽头不只是数字输出, 而是带着丰富模拟特性的"音色源" —
Q0/Q1 出管乐器, TC 经采样竞争出噪音. 一颗芯片喂出三种音色维度.

#### 5.9.1 Q 抽头音色机理 = 跳变瞬态频谱 + reload 混叠（2026-07-07 分析）

用户实测发现: Q0/Q1 的泛音**会随编程进去的 period 循环改变** — 不同音高的泛音完全不同,
但跟频率变化存在某种**循环关系**. 这指向两个机理的组合.

**机理 1: Q 抽头的跳变瞬态 (为什么有泛音, 为什么 Q0/Q1 音色不同)**

HC161 的 Q 输出不是理想方波, 跳变沿带着:
- 传播延迟差 (各位跳变不同步)
- 过冲/振铃 (CMOS 输出驱动容性负载的瞬态)
- 这些瞬态的频谱很宽 (类似脉冲, 含大量高频谐波)

Q 抽头的"音色" = 它的**跳变瞬态频谱在可听范围的分布**:
- **Q0 = clk/2** (最高频), 瞬态主要落在可听音频范围 → 高泛音多 → 明亮 (小号)
- **Q1 = clk/4**, 瞬态频率减半 → 低泛音 → 温暖 (萨克斯)
- **Q2 = clk/8**, 瞬态频率更低 → C5 时落在次声 → 听不见

位越高, 瞬态频谱越低, 音色越暗. 这是 Q0/Q1 音色不同的根本原因.

**机理 2: reload 混叠 (为什么泛音随 period 循环变化)**

这是"随音高循环"的关键机理. HC161 计数 0→period→reload, 周期 = (period+1)×Tclk.
关键: **reload 边沿和 Q0/Q1 的跳变沿之间存在周期性的相位关系**.

- Q0 每 2 个 clk 翻转一次
- 但 reload 后从 0 重新开始, Q0/Q1 的**起始相位被重置**
- 不同的 period → reload 时 Q0/Q1 处于不同相位 → **下一周期的瞬态分布不同**
- period 变化时, Q0/Q1 与 reload 的相位关系**周期性循环**

数学上: period=P 时计数周期=P+1 个 clk.
- Q0 翻转周期=2 clk, 两者的"拍频" = gcd(2, P+1) 决定相位重复模式
- P+1 偶数: Q0 翻转和 reload **同相**, 每次 reload Q0 状态一致 → 音色稳定
- P+1 奇数: Q0 翻转和 reload **反相交替**, 每 2 个 reload 周期才重复 → 音色有"两周期拍"
- Q1 (clk/4) 参与时, 模式更复杂 (4 周期循环) → 听感"循环变化"

**通俗类比 (车轮效应 / wagon-wheel effect)**:
- Q0/Q1 的高频跳变 = 车轮转速
- reload 脉冲 = 频闪灯
- 两者频率比的差异 = 看到不同的"图案" (混叠)
- period 改变 = 频闪频率变 → 图案循环变化

**为什么 iverilog 复现不了 (真正原因)**:
- 仿真里 Q 是 `assign Q = q_reg` (理想跳变, 零延迟, 无过冲)
- 理想方波的瞬态 = 无限陡峭 → 频谱均匀 → 听起来就是"纯净方波", 无音色
- 真实 HC161 的 Q 跳变有 ~5-10ns 上升时间 + 过冲 → 瞬态频谱不均匀 → 有音色
- 仿真没有这个模拟瞬态 → Q0/Q1 在仿真里就是不同频率的干净方波, 听不出管乐器质感

**Q 抽头音色 vs mode 白噪的统一**:
两者本质都是 **HC161 非理想特性的音频体现**:
- Q0/Q1 音色: 跳变瞬态频谱 + reload 混叠 → 频谱图案 (管乐器)
- mode 白噪: HC00 延迟 + 7474 采样竞争 → 时序随机 (噪声)

两者都**不在 RTL 逻辑模型里**, 都是面包板才能发现的物理现象.
CLAUDE.md 5.5 节"仿真盲区"的核心: **iverilog 是逻辑仿真器, 不是电路仿真器**,
看不到传播延迟/边沿瞬态/采样竞争这些模拟特性, 而这些恰恰是 74 系列芯片的"音色之源".

**⚠️ 这些音色是硬件物理特性产物，iverilog 仿真复现不了**：
- Q 抽头的非理想边沿/瞬态/毛刺 → 模拟特性，逻辑仿真看不到 (Q 是理想跳变)
- 白噪的 HC00 传播延迟 → 批次相关，仿真零延迟
- 只有面包板实测能听到真实音色（详见 CLAUDE.md 5.5 节"仿真盲区"）

**实测音色表（面包板探索，2026-07-02 + 2026-07-07 纠正）**：

| REF 源 | 听感 | mode | 备注 |
|---|---|---|---|
| toggle | 纯净方波 | 方波 | 基准音色（占空比变体叠加）|
| Q0 | **小号音色** (高泛音, 明亮) | 方波 | HC161 Q0 边沿瞬态直接当模拟音色, 高一个八度 |
| Q1 | **萨克斯音色** (低泛音, 温暖) | 方波 | HC161 Q1 边沿瞬态直接当模拟音色 |
| Q2 | 低频调制 | 方波 | C5 时无声 (频率太低), 不实用 |
| toggle | 白噪 | 白噪 | HC4053 切 pe_n, 采样竞争产物 (见 5.8.1) |

#### HC4053 接线（REF 路径 2 选 1，1 片搞定）

HC4053 是三 SPDT 模拟开关（1 位控制 2 选 1，天然互斥）。只用 1 路（Z）：

```
HC4053 Z0 ← toggle (U5.Q1)      ─┐
HC4053 Z1 ← Q0 抽头 (HC161)     ─┤  2 选 1
HC4053 Z-COM → U7.REF            ─┘
HC4053 S2 ← bit7 (0=toggle, 1=Q0)
HC4053 E ← GND (常开)
```

**为什么用 HC4053 不用 HC153/4066/CD4099**：
- HC153 数字多路器会整形吃泛音 ❌
- CD4066 要独热码+非门，2 片 ❌
- CD4099+4066 两片配合太复杂 ❌
- **HC4053 一片 SPDT，1 位控制，模拟保真** ✅

#### HC4053 控制（bit7，0 新增 FT232H 引脚）

软件切 REF：写 HC374 设 bit7 = 0（toggle）/ 1（Q0），HC4053 立即切换。
剩余 2 路 SPDT（X/Y）空闲，以后可扩展（级联成 3 选 1/4 选 1）。

---

## 五点五、PSG3 架构预览（锯齿/三角波，下一版本规划）

> v0.3 上板验证后，PSG3 将加入锯齿/三角波通道。这是迈向 SCC 波形内存音源的第一步
> （从"toggle 出 1-bit 方波"升级到"DAC 生 8-bit 多电平波形"）。

### 核心区别：方波 vs 锯齿/三角

| | 方波 (v0.2/v0.3) | 锯齿/三角 (PSG3) |
|---|---|---|
| 波形本质 | 1-bit (0/5V 翻转) | 8-bit (0-255 阶梯) |
| DAC 角色 | **衰减器** (REF=波形, DB=音量) | **生波形器** (DB=波形数据, REF=5V) |
| 计数器输出 | TC→toggle (边沿干净) | Q0-7 直出 (**有毛刺, 需 HC273**) |
| 音量控制 | REF 上乘 (1 片 DAC) | 第二片 DAC 级联衰减 |
| 单通道芯片数 | 7-10 | 8-9 |

### 锯齿通道架构（8 片）

```
clk ──→ HC161×2 (满幅度 0-255 计数, period 控频)
              │ Q0-7 (有毛刺)
              ▼
         HC273 (clk 同步锁存, 滤毛刺)  ← Gigatron 同款解法
              │ Q0-7 (干净)
              ▼
         TLC7524#1 (DB0-7=波形, REF=5V) → 阶梯锯齿模拟量
              │
              ▼
         TLC7524#2 (DB4-7=音量, REF=#1输出) → 衰减后锯齿
```
芯片：2×HC161 + HC373 + HC00 + HC273 + HC374 + 2×TLC7524 = **8 片**

### 三角通道架构（8-9 片）

锯齿基础上把 HC161 换成可逆计数 + 方向控制：
- **CD4029**（4 位可逆计数器）×2 级联，或单芯片 + 方向逻辑
- **CD4027**（双 JK 触发器）做方向控制：计满→减，计到 0→加
- 计数 0→255→0→255... 形成三角（折线上升下降）
- 其余同锯齿（HC273 毛刺滤除 + 2 片 TLC7524 级联）

芯片：2×CD4029 + CD4027 + HC273 + HC374 + 2×TLC7524 ≈ **8-9 片**

### HC273 毛刺滤除（PSG3 音质关键，详见 2.1 节）

HC161/4029 的 Q 在计数翻转瞬间有毛刺（各位不同步跳变）。
TLC7524 自带的 WR 锁存是电平透明型（透明期间毛刺直通），**挡不住**。
**必须用 HC273 边沿寄存器**在 clk 沿采样稳定值（延迟一拍，完全同步，无毛刺）。

这是 Gigatron 用 HC273 的同一原因——纯数字解法，不依赖 RC 延迟。

### 从锯齿/三角到 SCC

PSG3 的锯齿通道本质是 SCC 的**固定波形特例**：
- 锯齿 = 波形表为 [0,1,2,...,255] 的 SCC（线性递增，不需存表）
- 三角 = 波形表为 [0,1,...,127,128,127,...,1,0] 的 SCC（折线）

PSG3 通了之后，把"HC161 计数直出"换成"HC161 当地址 → SRAM 读波形数据"，
**就是 SCC**。多一片 SRAM（库存 62256）+ 地址锁存，波形任意可编程。

```
PSG3 锯齿:  HC161(Q=波形数据) → HC273 → TLC7524
SCC:        HC161(当地址) → SRAM(存波形) → HC273 → TLC7524
                                  ↑ 多这一步, 波形可编程
```

---

> **弃用原因**：period 计数（控频率）与满幅度计数（0-255 控波形）本质冲突。
> 复用 HC161 的 Q 输出，锯齿幅度会随音高变（高音矮低音高），无法保证满幅度。
> 加独立 HC161 又导致频率不对（÷256 太低）。波形切换最少加 2-4 片但效果不理想。
> **结论：走固定波形通道（见第二章），每通道独立设计，简单稳定。**

### 5.1 核心洞察：HC161 的 Q 输出本身就是波形数据

方波通道现在用 HC161 (2片级联 8位) 计 period, 计满后 TC 触发 toggle 翻转出方波。
**但 HC161 的 Q0-Q7 是 8 位二进制计数输出** — 这个值本身就是阶梯锯齿波!

复用 HC161 后, 同一套计数器可以同时输出多种波形:
- **Q0-Q7 直出** = 锯齿波 (0→period 阶梯上升)
- **toggle 输出** = 方波 (现做法)
- **Q0-Q7 高低半周比较** = 三角/占空比方波

### 5.2 4 bit 余量的分配

方波通道现在: HC374 用 4 bit 做音量 (DB4-7), **剩 4 bit 空闲**。
这 4 bit 可以做:

| 候选分配 | bit0-1 | bit2-3 | 效果 |
|---|---|---|---|
| A | 占空比 (2位=4挡) | 波形选择 (2位=4波形) | 方波占空比可调 + 切波形 |
| B | 占空比 (4位) | — | 方波占空比 16 挡精细调 |
| C | 波形 (4位) | — | 最多 16 种波形 (过度) |

倾向 **A (2位占空比 + 2位波形选择)**:
- 占空比 4 挡: 50%(方波)/25%/12.5%/75% (典型 PSG 用途)
- 波形 4 种: 方波/锯齿/三角/脉冲 (够用)

### 5.3 占空比怎么实现 (纯数字, 用 161 复用)

占空比 = 高电平占周期的比例。HC161 计数 0→period, 用一个**比较点**切高低电平:
- 计数值 < duty_threshold → 高电平
- 计数值 ≥ duty_threshold → 低电平

duty_threshold = period × 占空比比例。
**问题**: 这要幅度比较器 (HC85/4063), 库存没有。

**但有个纯数字的偷懒法**: 直接用 HC161 的高位 Q 做比较点!
- Q7 (bit7) = 0 时高, =1 时低 → 50% 方波 (本质就是 toggle 的另一半)
- Q6 (bit6) 做分界 → 25%/75%
- 用 2 bit 选 Q5/Q6/Q7 之一做分界 → 4 挡占空比, **0 额外芯片** (4066 选 Q 位)

### 5.4 波形选择怎么实现

HC161 的 Q0-Q7 直出是锯齿。要三角/方波, 是对 Q 的不同处理:
- 锯齿: Q0-Q7 直送 TLC7524 (波形DAC)
- 三角: Q0-Q7 的最高位(bit7)反向后异或回各位 (折半三角) — 需异或门
- 方波: 只取某高位 Q (bit7) = 当前 toggle 做法

波形选择 (2 bit) 用 4066/LS368 在这几种"Q 处理结果"之间选通。

### 5.5 复用思路的成本优势

如果复用 HC161, **一个通道就能出多种波形** (不再是固定波形):
- 方波通道加几片 4066/4070 → 升级成"可切波形通道"
- 不用为每种波形单独建通道

**待讨论**: 是走"固定波形通道" (CH0方波/CH1锯齿/...) 还是"可切波形通道" (每通道都能切)?
- 固定波形: 简单, 通道职责清晰, 但波形种类少
- 可切波形: 灵活, 4 bit 余量用满, 但要加 4066/4070 做选通逻辑

---

## 七、库存芯片用途表（讨论结果）

| 芯片 | 功能 | v0.3 用途 |
|---|---|---|
| **CD4070** | 四异或门 | LFSR 反馈（噪音核心）|
| **HC164** | 8位移位寄存器 | LFSR 主体（噪音核心）|
| **CD4060** | 14级计数器+振荡器 | 噪音时钟源（多频率挡）|
| **CD4066** | 四模拟开关 | 频率挡选择（可选，4060+4066 组合）|
| **CD4029** | 4位可逆计数器 | 三角波（加减计数交替）|
| **CD4027** | 双JK触发器 | 三角波方向控制 |
| **CD4013** | 双D触发器 | 方向控制/状态锁存（备用）|
| **CD4042** | 四D锁存器 | 波形选择寄存器（固定通道后可能不用）|
| **CD4069** | 六反相器 | 信号整形/反相（备用）|
| **LS368** | 三态缓冲 | 多路信号选通（固定通道后可能不用）|
| **CD4022** | 八进制计数器 | 分频/时序控制（备用）|

---

## 八、待讨论（继续）

1. **混音方式**：各通道 TLC7524 输出怎么混？电阻求和 vs 运放加法器？
2. **三角波方向控制**：4029 加减切换的具体触发逻辑（Carry 脚 + 4027 JK）
3. **地址译码**：多通道的音量锁存选通用 HC138（3-8译码）？A0/A1 选通道
4. **v0.3 先做哪两通道**：CH0方波+CH1锯齿？还是 CH0方波+CH3噪音（先把噪音验证掉）？
5. **TLC7524 级联的 REF 阻抗问题**：第一片输出阻抗 5-20kΩ，能否直接驱动第二片 REF？需实测。

---

## 八点五、CH0 上板实测发现 → 频率精度架构分析（2026-07-03）

> v0.3 上板实测暴露的核心瓶颈: **period 8-bit 位宽不够, 高音区精度崩盘**.
> 这是后续 PSG3/v0.4/SCC 架构设计的核心驱动力.

### 8.5.1 实测发现（CH0 方波通道）

| 现象 | 根因 |
|---|---|
| C6 以上音准差, 要靠 Q0 顶上去 | period 8-bit 高音区量化太粗 (见下表) |
| 占空比越小, 噪音频率越高 | 占空比分频链 (Q2/Q3) 改变了 HC164 时钟源, 噪音和方波不是独立时钟 |
| 占空比扩展低音有效 | Q2/Q3 = f/2/f/4 相当于朴素 BLK (降八度), 低音区 period 用满 8-bit |
| 波形 + 噪音同时用, 噪音略变 | 两路共享 HC161/TC, 互相耦合 |
| Q0 调制和占空比无关 | Q0 是 HC161 固有输出, 不受 toggle/分频链影响, 是另一条时钟路径 |
| REF 路径 (HC153→HC4053) 阻抗致音量 vol 9+ 饱和 | 待查, 疑模拟开关串联驱动能力不足 |

### 8.5.2 有效音域 ≤ 2000Hz（实测, 重要设计约束）

**用户实测: 超过 2000Hz 基本听不见.** 因此"最高频率 32kHz (period=1)"这个指标
**对实际用途无意义** — 不需要追求高频上限, **精度才是瓶颈**.

> 约束更新: 有效音域 C3-C7 (~131-2093Hz), C5 以下精度好, **C6-C7 是精度短板**.

### 8.5.3 period 8-bit 的量化精度（核心问题）

`freq = 64kHz / (2 × (256-p))`, 高音区 (256-p) 小, 量化误差大:

| 音 | freq | 256-p | 8-bit 误差 | 12-bit 误差 |
|----|---|---|---|---|
| C3 | 131Hz | 244 | 0.04% ✅ | 0.0004% |
| C5 | 523Hz | 61 | 0.8% ✅ | 0.0004% |
| C6 | 1047Hz | 30 | **1.6% ❌** | 0.001% |
| C7 | 2093Hz | 15 | **3.0% ❌ (半音跳)** | 0.003% |

**C6-C7 区间 8-bit 每 1 档 period = 1.6-3% 跳变** (接近一个半音), 音准失控.
12-bit 把误差降到 0.01% 以下 (人耳极限 ~0.1%), 全音域解决.

### 8.5.4 解决方案对比: TP/FP (AY8910) vs BLK/FNUM (YM2163)

查证 AY8910 datasheet + YM2163 架构, 两种"频率拆两块"的本质区别:

**AY8910 (PSG, TP/FP 线性 period)**:
- 12-bit period = (Coarse<<8) | Fine, **完整 period 值拆高低字节**
- 下计数器从 TP 计到 0 翻转, `F = clk / (16 × TP)`
- TP/FP 拆分纯粹是 **8-bit 总线装 12-bit 的寄存器寻址问题**, 不是计算方式拆分
- 改频率 = period reload → **相位跳变** (PSG 方波无所谓)

**YM2163 (FM, BLK/FNUM 浮点)**:
- `freq = fnum × 2^blk × (clk/2^20)`, **浮点表示 (尾数 + 八度指数)**
- 相位累加器 (NCO): `phase[20-bit] += fnum << blk`, 高位查正弦表
- **改频率时 phase 连续累加, 不跳变** ← FM 调制必需 (相位跳变=爆音)
- BLK 选八度, FNUM 八度内精调, **每八度相对精度均匀**

| | AY8910 (TP/FP) | YM2163 (BLK/FNUM) | 本项目 v0.3 (现状) |
|---|---|---|---|
| 本质 | 定点 period (线性) | 浮点频率 (八度+尾数) | 定点 period (`256-p` 反向) |
| 改频率 | reload, **相位跳变** | 改 fnum, **相位连续** | reload, 相位跳变 |
| 精度分布 | 低音精, 高音粗 | **每八度均匀** | 低音精, 高音**极粗** |
| 适用 | PSG (方波) | FM (要相位连续+调制) | PSG (方波+占空比) |

### 8.5.5 本项目的结论

**本项目是 PSG (方波+占空比), 不是 FM** → 不需要 BLK/FNUM 的 NCO, 用 AY8910 式
period 扩展就够:
- **加 1 片 HC374 扩 period 到 10-12 bit** (低 4 位频率, 高 4 位波形选择/花样)
- HC161 计数器级联扩到位 (12-bit = 3×HC161, 10-bit = 2.5×)
- period 正向编码 (TP 大=低频, 不再用 `256-p` 反向)
- **clk 64kHz 够用** (有效音域 ≤2000Hz, 离 clk/2=32kHz 还有 16 倍余量, 瓶颈是位宽不是 clk)

**BLK/FNUM (NCO) 留给 SCC 路线**: SCC 用 SRAM 查表 + 相位累加器, 那时才需要
相位连续 (波形任意可编程, 切波形不爆音). 本项目从 period 计数器 → 12-bit period →
SCC (NCO) 是渐进路线, 不是一步到位.

**弃用方向**: 追求最高频 (period=1 → 32kHz 听不见, 无意义).
**保留方向**: 提高 period 位宽解决 C6-C7 精度.

---

## 八点六、SCC 架构深挖 → 查表机是 SCC 的前置技术（2026-07-03）

> 从 v0.3 到 SCC, 障碍不在波形生成 (查表很简单), 而在**多通道状态机调度**.
> 这一节记录"为什么 SCC 绕不开查表机"的完整推理过程.

### 8.6.1 从 PSG 到 SCC 的架构分水岭

PSG (v0.1-v0.3) 是**纯组合/时序逻辑** — 计数器 + toggle + DAC, 没有状态机.
SCC 要做的事: 相位累加 + 多通道分步读 SRAM (读 step → 累加 → 查波形 → 乘音量 → 输出),
**每一步都是离散操作, 要按顺序调度** — 这是状态机的活, 不是几片 HC161 能自发完成的.

**HC161 只是计数器, 它不会自己指挥"现在读 step、现在读波形"**. 指挥它的是状态机,
而 74 离散逻辑实现状态机只有两条路:
- HC138 译码 (死板, 每个状态一组地址路由, 组合爆炸)
- **微程序 ROM 驱动** (HC161 当程序计数器顺序读 ROM, ROM 输出位直接当控制信号)

后者就是**查表机/CPU 的核心架构**. SCC 绕不开它.

### 8.6.2 双端口 RAM vs 分时仲裁 (SCC 寻址架构选型)

SCC 的 SRAM 有两个访问者: FT232H 写波形 (偶尔) + 相位累加器读波形 (持续).
两者共享同一套地址总线, 必须仲裁.

**复古硬件不用双口的真正原因**: 不是技术不行, 是 1980s 双口 RAM 天价 (IDT 7132 1986 年才出).
ASIC 内部做分时仲裁几乎免费 (几千晶体管). **本项目库存有大量 7132, 复古硬件的成本约束不适用**.

| | 普通 SRAM + 分时 | 双口 7132 |
|---|---|---|
| 仲裁芯片开销 | +3-4 片 (HC161+HC244+HC08+握手) | **+0 片** (内部仲裁) |
| clk 要求 | 必须高 (3.579MHz, 留 CPU 窗口) | 任意 (64kHz 也行) |
| 时序调试 | 要示波器 (HC244 毛刺) | 无 |
| 仿真盲区 | 有 (模拟毛刺) | 无 |

**只写总线的关键简化**: AY8910/SCC/SID 的 CPU 侧基本都是只写, 不需要 BUSY/READY 握手.
FT232H 写到 HC374 锁存器, SRAM 在分时窗口自己取走, 不需要状态回传. 这砍掉了握手逻辑.

**分时的最大障碍**: 不是"能不能做", 是 clk 要够高 (3.579MHz 一个采样周期 56 个 clk,
9 通道轮询只占 6%, 剩 94% 给 CPU). 64kHz clk 没有余量, 分时窗口为零 — 这也是
本项目一直用 64kHz 的代价 (见 8.5 节, clk 是 PSG 的甜点但不是 SCC 的).

**64kHz 占标准时钟的比例**: 64kHz / 3.579MHz = 1.78%. 真正的音源芯片都用 MHz 级 clk,
64kHz 是本项目"精简到骨头"的权宜之计, 它把分时窗口压没了.

### 8.6.3 查表机谱系 (项目已有资产)

本项目已有三个查表机, SCC 是 fsm_player 和 39040 的中间形态:

| 项目 | 片数 | 架构 | SCC 适用度 |
|---|---|---|---|
| **fsm_player** | 9 | 顺序读 ROM 无分支 (20-bit 地址自主递增 + 双 ROM + HC273) | PCM ✅ / SCC ❌ (无循环) |
| **SCC 专用查表机** | ~14-16 (规划) | 微程序 ROM + 相位累加器 + SRAM 数据通路 | ⭐ 目标 |
| **39040cpu** | 22 | 通用图灵机 (取指/译码/分支/ALU, 4×39SF040) | ✅ 通用 |

**fsm_player 的价值**: 9 片最简查表机, PCM 回放直接能用 (地址线性扫 ROM → DAC).
它是 39040 的"前辈", 验证了 HC161 级联 + ROM 查表的基本架构.

**39040 的价值**: ALU 用 39SF040 查表实现 (opcode+A+B → ROM 地址 → 结果),
这和 SCC 波形查表 (phase 高位 → ROM 地址 → 波形采样) **是同一个机制**.
39040 通了, SCC/FM 就是写微程序, 不需要新硬件.

**三机的本质区别**:
- fsm_player: 地址线性递增, ROM 内容直出 (回放)
- 39040: 地址可跳转 (分支), ROM 当指令译码 (通用计算)
- SCC 专用机: 介于两者 — 要循环 (相位累加) + 多地址访问, 但指令集固定

### 8.6.4 SCC 的两条路

**快速路 (通用)**: 39040 + DAC + SCC 微程序
- 硬件: 39040 的 22 片 + TLC7524 (1 片) = 23 片
- SCC/FM 都是写程序, 不改硬件
- 适合: 验证算法, 灵活迭代

**精简路 (专用)**: fsm_player 改造成 SCC 专用查表机
- 加分支/循环能力 (相位累加是循环) → 介于 9 片和 22 片之间
- 指令集固定 (音频操作), 不需通用译码
- 适合: 最终产品化, 芯片数优化

### 8.6.5 寄存器爆炸 → 统一地址空间

直接寻址 (v0.3 现状) 的天花板: 每个寄存器占 1 片 HC374. 5 通道 SCC = 15 片锁存器, 爆炸.
**解法: 所有寄存器 (step/音量/控制) 映射到 SRAM 地址空间**, HC374 只剩 2 片 (地址+数据),
FT232H 随机寻址写入. 下位机 (状态机) 从同一 SRAM 读.

但相位累加器一个采样周期要读多个地址 (step/波形/音量), SRAM 一次只读一个 → **状态机分步读**,
这正是 8.6.1 说的"HC161 不会自己调度"的本质.

**SCC 的真实复杂度不在波形电路 (查表很简单), 在状态机调度多通道读 SRAM**. 这是 ASIC 内部
几万晶体管搞定的事, 74 离散搭要十几片 (微程序 ROM + 计数器 + 数据通路 + 仲裁).

### 8.6.6 PCM 是另一回事 (顺序寻址, 不是随机)

SCC = 随机寻址 (CPU 写任意地址, 波形表). PCM = 顺序寻址 (地址自主递增, CPU 只喂数据).
**PCM 不需要地址锁存器** — 地址由 HC4040/HC161 自主递增, CPU 只写数据口.
**fsm_player 的 9 片架构直接就是 PCM 回放** (20-bit 地址递增 + ROM + HC273 + DAC).

PCM 的难度在地址计数器级联 (16-19 bit) + 大容量 ROM 时序, 不在锁存. 等 SCC 跑通再单独设计.

### 8.6.7 结论: 修正后的项目路线

```
PSG v0.3 ✅ (纯硬件音源, 已完成 — 组合/时序逻辑到头了)
   │
   ▼ 要状态机才能继续
fsm_player 上板验证 (9 片 PCM 回放) ← 最简查表机, 验证 ROM+计数器架构
   │
   ▼ 加分支/循环 → SCC 专用查表机 (或直接用 39040 通用机)
SCC = 查表机 + DAC + 音频微程序 (相位累加+查表+乘音量)
   │
   ▼
FM (查表机 + 二级调制程序)
```

**原"音源跑通再回头做 CPU"的认知已过时**: SCC/FM 依赖查表机 (状态机),
查表机就是 CPU 的核心. **39040 不是"回头补的副业", 是音源路线的下一站**.

---

## 九、参考

- v0.2 已验证：TLC7524 正向接法（REF=输入/OUT1=输出/RFB=GND）出声成功
- v0.2 总线：FT232H C口数据 + D4/D5/D6 控制（经 LS373 电平转换）
- sn76489.c（STC_Chiptune）：16-bit LFSR, taps=0x0009, 4 挡噪音频率
- v0.1 development-log：硬件踩坑实录（电平转换/HCT74/C口数据/去耦）
