denjhang/74HC-Chiptune/docs/wsg-netlist-analysis.md

# WSG 原理图网表分析

基于 `reference/Namco WSG/easyeda/freePCB.net` 完整网表。

## 芯片清单

| 编号 | 型号 | 功能 |
|---|---|---|
| U1 | PZ254-1-24-Z | 24针连接器（CPU接口） |
| U2 | 7486 | 四2输入异或门 (sel生成) |
| U3 | 27C256 | 3M microcode ROM |
| U4 | 74157 | 四2选1 MUX（地址选择） |
| U5 | 74158 | 四2选1 MUX（反相输出，数据选择） |
| U6 | 74LS189 | acc RAM (2K) |
| U7 | 74LS189 | freq RAM (2L) |
| U8 | 74283 | 4-bit 全加器 (1K) |
| U9 | 74174 | 六D触发器 (1L) |
| U10 | 27C256 | 1M 波形 ROM |
| U11 | 74273 | 输出锁存 (2M) |
| U12 | 4066 | 模拟音量开关 |
| R1-R9 | 电阻 | DAC 电阻网络 |
| C1 | 电容 | 滤波 |

## 信号分组

### CPU 接口 (U1 连接器)

| 信号 | 方向 | 说明 |
|---|---|---|
| AB3-AB0 | 输入 | CPU 地址低4位 → 157 A端 |
| DB3-DB0 | 输入 | CPU 数据低4位 → 158 A端 |
| /WR0 | 输入 | 写使能0 → ROM /OE |
| /WR1 | 输入 | 写使能1 → 189 写使能 |
| SOUND_ON | 输入 | 声音使能 |
| /GM | 输入 | 游戏使能 → ROM /CE |
| 32H,16H,8H,4H,2H,1H | 输入 | ROM 地址线（来自 HCNT 计数器） |

### 内部信号

| 信号 | 连接 | 说明 |
|---|---|---|
| 3LK-157-S | U2-1(nSEL), U3-8, U5-1(nSEL) | 157/158 选择信号 = 2H XOR GND = 2H |
| 3L-157-Y1~Y4 | U4,U6 地址(pin13,14,15,1) | 157 输出 → 两个189地址线 |
| 3K-158-B1 | U5-3, U9-14(Q5), U9-5(D1) | 174 Q5和D1短接 → 158 B1 |
| 3K-158-B2 | U5-6, U9-7(D2) | 174 D2 → 158 B2 |
| 3K-158-B3 | U5-10, U9-10(Q3) | 174 Q3 → 158 B3 |
| 3K-158-B4 | U5-13, U9-12(Q4) | 174 Q4 → 158 B4 |
| 3K-158-Y1~Y4 | U4,U6 数据(pin12,10,6,4) | 158 反相输出 → 两个189数据输入 |
| 2L-DQ0~DQ3 | U4 DO(pin5,7,9,11) → U8 | 189-1 (acc) 反相输出 → 283 |
| 2K-DQ0~DQ3 | U6 DO(pin5,7,9,11) → U8 | 189-2 (freq) 反相输出 → 283 |
| 1K-283-S1 | U8-4 → U9-13(D5) | 283 输出 → 174 |
| 1K-283-S2 | U8-1 → U9-11(D4) | 283 输出 → 174 |
| 1K-283-S3 | U8-10 → U9-6(Q2) | 283 输出 → 174 |
| 1K-283-S4 | U8-13 → U9-4(Q1) | 283 输出 → 174 |
| 1K-283-C4 | U8-9 → U9-3(D0) | 283 进位 → 174 |
| 1L-74-1Q | U9-2(Q0) → U8-7(C0) | 174 进位反馈 → 283 |
| 1L-174-6Q | U9-15(Q6) | 174 第6个Q输出 (去波形ROM地址) |
| 3M-DQ0 | U7-11, U9-9, U10-11 | ROM数据D0 → 174输入/U10地址 |
| 3M-DQ1 | U7-12, U10-12 | ROM数据D1 → U10地址 |
| 3M-DQ2 | U7-13, U10-13 | ROM数据D2 → U10地址 |
| 3M-DQ3 | U7-15, U9-1, U10-15 | ROM数据D3 → 174 nCLR/U10地址 |
| 3M-D1 | U6-3(nWE) | ROM数据D1 → freq RAM写使能! |

## 数据通路

```
CPU地址(AB3-0) ──┐
                  ├── U2(157) ──→ 3L-157-Y1~Y4 ──→ U4(189) 地址, U6(189) 地址
ROM地址(4H-32H) ─┘  sel = 2H (经 U3 86 XOR GND)

CPU数据(DB3-0) ──┐
                  ├── U5(158) ──→ 3K-158-Y1~Y4 ──→ U4(189) 数据, U6(189) 数据
174输出/ROM数据 ─┘  (反相输出, 抵消189反相输入)

U4(189) DO ──→ 2L-DQ0~DQ3 ──→ U8(283) A端
U6(189) DO ──→ 2K-DQ0~DQ3 ──→ U8(283) B端

U8(283) S1~S4,C4 ──→ U9(174) 锁存
U9(174) 1Q ──→ U8(283) C0 (进位反馈)
U9(174) 其他输出 ──→ U5(158) B端 (写回RAM)

U7(ROM) 数据 ──→ U9(174) / U5(158) B端
```

## 关键设计细节

### 157 (U4) 地址选择
- sel = `3LK-157-S = 2H XOR GND = 2H`
- 当 2H=0: 157 输出 CPU 地址 → 189 被 CPU 访问
- 当 2H=1: 157 输出 ROM 地址 → 189 被 synth 访问

### 158 (U5) 数据 MUX
- B端 = 174 输出 + 1M 波形ROM 输出 (线上短接)
- 反相输出 → 189 数据输入 (抵消 189 反相)

### 283 (U8) 加法器
- A端 = acc_do (2L-DQ), B端 = freq_do (2K-DQ)
- C0 = u9_q[0] (进位反馈)
- 输出 → 174 (U9) 锁存

### 174 (U9) 锁存
- D = {C4, S3, S2, S1, S0, 旧Q[1]} = 6-bit
- CLK = 3M-DQ0, nCLR = 3M-DQ3
- 输出: Q0→进位反馈, Q[5:2]→158 B端, Q5→1M 地址

### 189 (U6=acc, U7=freq)
- acc: nWE = cpu_wr1_n (CPU写)
- freq: nWE = ctrl_dq1 (3M ROM控制, 合成器回写)
- 输出反相, 连到 283 和 273

### 273 (U11) 输出锁存
- D = {acc_do[3:0], u10_dq[3:0]} = 8-bit
- 高4位 = acc (音量控制), 低4位 = 波形数据
- CLK = SOUND_ON

### 4066 (U12) 模拟音量
- 4个独立开关, 由 273 高4位控制
- 输入 = 波形数据, 通过电阻网络加权输出

## 完整连线表 (来自 easyeda/freePCB.net)

### CPU 接口 (U1)
```
AB3  → U4.2, U1.1
AB2  → U4.5, U1.3
AB1  → U4.11, U1.5
AB0  → U4.14, U1.7
DB3  → U1.10, U5.2
DB2  → U1.11, U5.5
DB1  → U1.12, U5.11
DB0  → U1.13, U5.14
/WR0 → U3.4, U1.15
/WR1 → U6.3, U1.16
SOUND_ON → U11.1, U1.17
/GM  → U3.20, U1.18
```

### HCNT 地址线
```
32H → U3.5, U4.3, U1.2, U1.19
16H → U3.6, U4.6, U1.4, U1.20
8H  → U3.7, U4.10, U1.6, U1.21
4H  → U3.8, U4.13, U1.8, U1.22
2H  → U3.9, U2.10, U1.23
1H  → U3.10, U1.24
```

### 86 (U2) 异或门
```
2H → U2.10 → sel (3LK-157-S)
3LK-157-S → U5.1, U2.8, U4.1
```

### 157 (U4) 地址 MUX
```
3L-157-Y1 → U7.13, U6.13, U4.4
3L-157-Y2 → U7.14, U6.14, U4.7
3L-157-Y3 → U7.15, U6.15, U4.9
3L-157-Y4 → U7.1, U6.1, U4.12
```

### 158 (U5) 数据 MUX
```
3K-158-B1 → U10.6, U9.14, U9.5, U5.3
3K-158-B2 → U10.7, U9.7, U5.6
3K-158-B3 → U10.8, U9.10, U5.10
3K-158-B4 → U10.9, U9.12, U5.13
3K-158-Y1 → U7.12, U6.12, U5.4
3K-158-Y2 → U7.10, U6.10, U5.7
3K-158-Y3 → U7.6, U6.6, U5.9
3K-158-Y4 → U7.4, U6.4, U5.12
```

### 189 (U6=acc) 输出
```
2L-DQ0 → U11.8, U8.6, U6.5
2L-DQ1 → U11.7, U8.2, U6.7
2L-DQ2 → U11.4, U8.15, U6.9
2L-DQ3 → U11.3, U8.11, U6.11
```

### 189 (U7=freq) 输出
```
2K-DQ0 → U10.5, U8.5, U7.5
2K-DQ1 → U10.4, U8.3, U7.7
2K-DQ2 → U10.3, U8.14, U7.9
2K-DQ3 → U8.12, U7.11
```

### 283 (U8) 加法器
```
1K-283-S2 → U9.11, U8.1
1K-283-S1 → U9.13, U8.4
1L-74-1Q → U9.2, U8.7 (C0)
1K-283-C4 → U9.3, U8.9
1K-283-S3 → U9.6, U8.10
1K-283-S4 → U9.4, U8.13
```

### 174 (U9) 锁存
```
3M-DQ0 → U9.9 (CLK)
3M-DQ3 → U9.1 (nCLR)
1L-174-6Q → U10.10
```

### 3M ROM (U3) 数据
```
3M-DQ0 → U9.9, U3.11
3M-DQ1 → U7.3, U3.12
3M-DQ2 → U11.11, U3.13
3M-DQ3 → U9.1, U3.15
```

### 1M ROM (U10) 数据
```
1M-DQ0 → U11.18, U10.11
1M-DQ1 → U11.17, U10.12
1M-DQ2 → U11.14, U10.13
1M-DQ3 → U11.13, U10.15
```

### 273 (U11) 输出
```
2M-273-Q4 → U12.6, U11.9
2M-273-Q3 → U12.12, U11.6
2M-273-Q2 → U12.13, U11.5
2M-273-Q1 → U12.5, U11.2
```

### 4066 (U12) + 电阻网络
```
RES-COM → U12.4,8,11,1, R1.2-R4.2
4066-O1 → R5.2, U12.3
4066-O2 → R6.2, U12.2
4066-O3 → R7.1, U12.10
4066-O4 → R8.1, U12.9
SOUND ← R5.1, R9.2, R6.1, R7.2, R8.2, C1.2
```
- 当 2H=1（高地址区域）：157 输出 CPU 地址 → 189 被 CPU 访问
- 总线仲裁由 ROM 地址线本身决定，无需额外控制信号

### 158 反相 MUX
- 158 输出反相数据 → 189 数据输入
- 189 输出也是反相的（open-collector）
- 两级反相在数据通路中抵消，但中间信号是反相的
- 283 加法器接收的是反相数据？需要确认

### 189 输出反相
- 74LS189 输出是 open-collector 反相
- 写入 1011，读出 0100
- 需要在某处用异或门或反相器还原

### 174 六D触发器
- 锁存 283 加法结果（4-bit sum + carry）
- 一个输出反馈到 283 C0（进位链）
- 其他输出通过 158 回写到 189

### ROM 地址
- 32H,16H,8H,4H,2H,1H 来自 HCNT 计数器
- HCNT 是 6-bit 硬件计数器，6.144MHz
- 64 步/帧 = 96kHz 音频输出

## 27C256 引脚映射（网表实际连接）

基于网表中的 pin 编号反推：

**U7 (microcode ROM):**
- 地址: pin4=A7, pin5=A6, pin6=A5, pin7=A4, pin8=A3, pin9=A2, pin10=A1
- 数据: pin11=D0, pin12=D1, pin13=D2, pin15=D4(注意pin15)
- 控制: pin20=/CE, pin22=/OE
- 电源: pin1=VPP, pin14=GND(?), pin28=VCC

注意：U7 pin15 同时出现在 DQ3 数据线和 GND 网络中，封装编号需确认。
