denjhang/74HC-Chiptune/Glowworm-1/docs/isa.md

# 萤火虫 1 号 ISA v1.1（官方指令集，权威定义）

> 来源：`第七周年纪念版8位CPU《萤火虫1号》指令集.xls`（龙少官方）
> 整理时间：2026-07-05
> 验证：与 `GlowCompiler/glow.cpp` 后端反推完全一致

## 一句话模型

**所有指令都是"目的 = 源"**。目的和源都从同一组总线节点里选，机器码高字节选源、低字节是立即数或 ALU 模式号。

## 总线节点（11 个）

| 节点 | 含义 | 备注 |
|---|---|---|
| **RF** | 寄存器堆（分页：0=SP, 2=返回值, 10/18/26=运算LOP/ROP/DOP, 34=返回地址, 37=缓存）| 程序员模型里 RF 是"当前页"的一个字节 |
| **A** | A 累加器 | ALU 主输入 |
| **A0 / A1 / A2** | 24 位地址寄存器的低/中/高字节 | A2A1A0 = 24 位地址，寻址 16MB |
| **RA** | RAM 地址寄存器 | 指向 RAM 当前字节 |
| **B** | B 输入寄存器 | ALU 第二输入 |
| **RAM** | RAM 数据口（RA 寻址的字节）| 读=RAM→，写=→RAM |
| **IO0 / IO1** | 两个独立 I/O 端口 | 独立寻址空间，非内存映射 |
| **ALU[XX]** | 查表 ALU，XX 选模式 | 地址=(A,B,XX)，输出回总线 |
| **PC** | 程序计数器 | 写入=跳转 |

> 译码控制器、IR、TSL（三态锁存）是数据通路内部节点，不直接对程序员暴露。

## 机器码编码

**16 位定长指令**（ROM 里每个地址 1 字节，1 条指令占 2 字节）：
```
高字节 = 操作码（选"源 = 目的"组合）
低字节 = XX（立即数 / ALU 模式号 / 未使用）
```

### 源选择（高字节高 4 位）

| 高4位 | 源 | 说明 |
|---|----|----|
| 0 | 立即数 XX | XX 直接当数据 |
| 1 | ALU[XX] | ALU 查表结果，XX 选模式 |
| 2 | RF | 寄存器堆 |
| 3 | RAM | RAM[RA] |
| 4 | IO0 | |
| 5 | IO1 | |

### 目的选择（高字节低 4 位）

| 低4位 | 目的 | 说明 |
|---|---|---|
| 0 | RF | |
| 1 | A | |
| 2 | A0 | |
| 3 | A1 | |
| 4 | A2 | |
| 5 | RA | |
| 6 | B | |
| 7 | **PC**（特殊：跳转指令）| 见跳转节 |
| 8 | RAM | |
| 9 | **ALU[XX]**（特殊：ALU 输入）| XX 选模式 |
| A | IO0 | |
| B | IO1 | |

> 注意：RF→RF（20H）、RAM→RAM 等自反赋值未列出，可能是 NOP 或未定义。
> 07H/17H 是跳转专用，不走通用"目的=源"模型。

## 完整指令表（按官方 xls 整理）

### 立即数为源（高字节 00-0B）

| 机器码 | 助记 | 功能 |
|---|---|---|
| 00XX | `RF = XX` | 立即数送 RF |
| 01XX | `A = XX` | |
| 02XX | `A0 = XX` | |
| 03XX | `A1 = XX` | |
| 04XX | `A2 = XX` | |
| 05XX | `RA = XX` | |
| 06XX | `B = XX` | |
| 08XX | `RAM = XX` | 直接写 RAM[RA] |
| 0AXX | `IO0 = XX` | |
| 0BXX | `IO1 = XX` | |

（07XX 是跳转，见下；09XX 未列，疑保留）

### ALU 为源（高字节 10-1B）

| 机器码 | 助记 | 功能 |
|---|---|---|
| 10XX | `RF = ALU[XX]` | ALU 结果送 RF，XX 选模式 |
| 11XX | `A = ALU[XX]` | |
| 12XX | `A0 = ALU[XX]` | |
| 13XX | `A1 = ALU[XX]` | |
| 14XX | `A2 = ALU[XX]` | |
| 15XX | `RA = ALU[XX]` | |
| 16XX | `B = ALU[XX]` | |
| 18XX | `RAM = ALU[XX]` | |
| 1AXX | `IO0 = ALU[XX]` | |
| 1BXX | `IO1 = ALU[XX]` | |

（17XX 是条件跳转，见下；19XX 未列）

### RF 为源（高字节 20-2B）

| 机器码 | 助记 | 备注 |
|---|---|---|
| 21XX | `A = RF` | XX 段未使用 |
| 22XX | `A0 = RF` | |
| 23XX | `A1 = RF` | |
| 24XX | `A2 = RF` | |
| 25XX | `RA = RF` | |
| 26XX | `B = RF` | |
| 28XX | `RAM = RF` | |
| 29XX | `ALU[XX] = RF` | XX 选 ALU 模式（**注意：这里 ALU 是目的，把 RF 喂进 ALU 输入**）|
| 2AXX | `IO0 = RF` | |
| 2BXX | `IO1 = RF` | |

### RAM 为源（高字节 30-3B）

| 机器码 | 助记 | 备注 |
|---|---|---|
| 30XX | `RF = RAM` | |
| 31XX | `A = RAM` | |
| 32XX | `A0 = RAM` | |
| 33XX | `A1 = RAM` | |
| 34XX | `A2 = RAM` | |
| 35XX | `RA = RAM` | |
| 36XX | `B = RAM` | |
| 39XX | `ALU[XX] = RAM` | XX 选 ALU 模式 |
| 3AXX | `IO0 = RAM` | |
| 3BXX | `IO1 = RAM` | |

### IO0 为源（高字节 40-4B）

| 机器码 | 助记 |
|---|---|
| 40XX | `RF = IO0` |
| 41XX | `A = IO0` |
| 42XX | `A0 = IO0` |
| 43XX | `A1 = IO0` |
| 44XX | `A2 = IO0` |
| 45XX | `RA = IO0` |
| 46XX | `B = IO0` |
| 48XX | `RAM = IO0` |
| 49XX | `ALU[XX] = IO0` |
| 4AXX | `IO0 = IO0`（NOP 类）|
| 4BXX | `IO1 = IO0` |

### IO1 为源（高字节 50-5B）

| 机器码 | 助记 |
|---|---|
| 50XX | `RF = IO1` |
| 51XX | `A = IO1` |
| 52XX | `A0 = IO1` |
| 53XX | `A1 = IO1` |
| 54XX | `A2 = IO1` |
| 55XX | `RA = IO1` |
| 56XX | `B = IO1` |
| 58XX | `RAM = IO1` |
| 59XX | `ALU[XX] = IO1` |
| 5AXX | `IO0 = IO1` |
| 5BXX | `IO1 = IO1`（NOP 类）|

### 跳转（特殊编码）

| 机器码 | 助记 | 功能 |
|---|---|---|
| 07XX | `PC = A2A1A0` | 无条件跳转。**XX 最低位必须为 0**（对齐）|
| 17XX | `if(!(ALU[XX] & 0x01)) PC = A2A1A0` | 条件跳转：ALU[XX] 最低位为 0 则跳。XX 选 ALU 模式（通常是比较/减法，借位/相等编码在 bit0）|

> 条件跳转的判据是 **ALU 输出最低位**，这是 ISA 唯一的条件码机制——所有比较都要通过 ALU 模式编码到 bit0。

### 空操作

| 机器码 | 助记 |
|---|---|
| FFFF | `NOP()`（**两字节都是 FF**）| CPU 控制信号全置空 |

## ALU 查表机制（关键）

ALU 不是组合逻辑运算器，是 **ROM 查表入口**：

```
ALU 地址 = (A, B, XX)   // A 当高位字节, B 当低位, XX 当段/页
ROM[ALU地址] → 输出字节 → 回总线
```

从 glow.cpp 的 `glow_cpu_init()` 看到的 ALU 模式（部分）：
- `ALU_ADD` / `ALU_ADD_C`（带进位加）
- `ALU_A_ADD_1`（A 自增 1）
- `ALU_EQUAL_C`（相等比较，结果编码到输出）

**ALU 表在初始化时由 C 编译器生成并烧进 ROM**（见 glow.cpp 13182 行起 `glow_cpu_init()`），可热改（SRAM + CR2032 + 下载器）。

## 对 SCC 路线的意义（核心洞察）

1. **SCC 波形查表 = ALU 查表，同一机制**：把波形表放进 ALU ROM，`A = ALU[wave_op]` 就是一条"读波形采样"指令
2. **多通道调度 = 几条传送指令**：phase 累加、查波形、乘音量，全是 `XX = YY` 传送 + ALU 查表，不需要专用状态机
3. **条件跳转够用**：循环、分支、通道轮询都能用 `17XX` 实现
4. **24 位地址空间（16MB）**：波形表、程序、数据混在同一空间，远超 PSG 的 8 位 period

## 参考资料

- 本项目已复制：`docs/ref/system-structure-big.PNG`（系统结构图）
- 源资料：`萤火虫1号/贴片版-萤火虫1号CPU资料/V1.1版CPU指令集/第七周年纪念版8位CPU《萤火虫1号》指令集.xls`
- 编译器后端：`萤火虫1号/贴片版-萤火虫1号CPU资料/C编译器源码(2023.03.12)/GlowCompiler/glow.cpp`（含 ALU 表初始化代码 `glow_cpu_init()`）
