denjhang/74HC-Chiptune/psg_voice/PSG3 v0.5/docs/inventory.md

# PSG3 v0.5 库存芯片表

> 用户口述，数量都充足 (≥1 片)。选片先查此表，表里有就用，**没有的不能编造**。
> 来源：CLAUDE.md 7.4 节 (2026-07-09 抽离成独立文档)。
> ⚠️ **HC85 不在此表中** — 4-bit 比较器要用替代方案 (283 加法器 / HC153 查表等)。

---

## 4000 系列 CMOS (CD/HEF 打头, 按序号排序)

| 型号 | 功能 | 备注 |
|---|---|---|
| CD4000 | 双 3 输入或非门 + 反相器 | |
| CD4001 | 四 2 输入或非门 | |
| CD4002 | 双 4 输入或非门 | |
| CD4011 | 四 2 输入与非门 | |
| CD4013 | 双 D 触发器 | 状态锁存/分频 |
| **CD4017** | **十进制计数器 (1-of-10)** | 10 个译码输出, 时序/分频 |
| **CD4024** | **7 级纹波二进制计数器** | ÷2~÷128, 分频链 |
| **CD4028** | **BCD-十进制译码器 (4-10)** | 也可当 3-8 译码 |
| **CD4029** | 4 位可逆计数器 | 三角波 (加减计数) |
| **CD4030** | **四 2 输入异或门** | (早期型号, 同 4070) |
| **CD4040** | **12 级纹波二进制计数器** | ÷2~÷4096, 长分频链 |
| **CD4043** | **四三态 R/S 锁存器 (NOR)** | 存储/去抖 |
| **CD4046** | **锁相环 (PLL)** | VCO+相位比较器, 倍频/解调 |
| **CD4049** | **六反相缓冲器 (电平转换)** | CMOS→TTL 电平转换, 驱动 |
| **CD4051** | **8 通道模拟多路器/分路器** | 3-bit 地址选 8 路, 双向模拟开关 |
| **CD4053** | **三 2 选 1 模拟开关 (SPDT)** | 同 HC4053, 1 位控制 2 选 1 |
| **CD4060** | **14 级计数器 + 振荡器** | 内置 RC/晶振, 时钟生成 |
| CD4066 | 四模拟开关 | v0.3 REF 切换 |
| CD4069 | 六反相器 | |
| **CD4070** | 四 2 输入异或门 | LFSR 反馈 (v0.3 用) |
| CD4071 | 四 2 输入或门 | |
| CD4078 | 8 输入或非/或门 | 全 0 检测 (备用方案) |
| CD4081 | 四 2 输入与门 | |
| CD4093 | 四 2 输入施密特与非门 | |
| CD4099 | 8 位可寻址锁存器 | ⭐ 独热码输出/地址锁存 |
| **CD40103** | **8 位可预置同步减法计数器** | ⭐ 零检测输出, period 计数 |
| **CD40106** | **六施密特触发反相器** | 滞回, 整形/去抖/振荡 |
| **CD4316** | 四双向模拟开关 (带电平转换) | 类似 4066 |
| HC4053 | 三 2 选 1 模拟开关 (SPDT) | ⭐ 1 位控制 2 选 1, 替代 CD4099+4066 |
| **CD4511** | **BCD-七段锁存/译码/驱动器** | LED 数码管驱动 |
| **CD4514** | **4 位锁存 + 4-16 译码器** | 16 个高有效输出 |
| CD4518 | 双 BCD 计数器 | |
| **CD4520** | **双 4 位二进制计数器** | |
| **CD4528** | **双可重触发单稳态触发器** | 脉冲生成/展宽 (RC 定时) |
| **CD4532** | **8 位优先编码器** | 8 输入→3 位编码 |
| **CD4543** | **BCD-七段锁存/译码/驱动器** | LCD/LED 数码管驱动 |
| CD4538 | 双精密单稳态触发器 | |

---

## 74 系列 (HC/HCT/LS, 按序号排序)

| 型号 | 功能 | 备注 |
|---|---|---|
| 00 | 四 2 输入与非门 | v0.2 PE 反相+gate |
| 02 | 四 2 输入或非门 | |
| 04 | 六反相器 | |
| **06** | **六反相缓冲器 (集电极开路, 高压)** | OC 反相版 (07 是非反相 OC) |
| **07** | **六缓冲器 (集电极开路, 非反相)** | 高压 OC 输出, 线与逻辑 |
| 08 | 四 2 输入与门 | |
| **10** | **三 3 输入与非门** | 3 个独立 3 输入 NAND |
| 14 | 六施密特反相器 | |
| **20** | **双 4 输入与非门 (LS, 带选通)** | 选通使能, 组合逻辑 |
| **22** | **双 4 输入与门 (LS22=OC 版)** | 组合逻辑 (LS 系列为 OC) |
| **25** | **双 4 输入或非门 (带选通)** | 选通使能, 组合逻辑 |
| **27** | **三 3 输入或非门** | 3 个独立 3 输入 NOR (无选通, 25 带选通) |
| **30** | **单 8 输入与非门** | 全 0/全 1 检测 |
| 32 | 四 2 输入或门 | |
| **54** | **4 路 AND-OR-反相门 (3-3-2-2输入, LS)** | AOI 组合门, 一级延迟 |
| 73 | 双 JK 触发器 (带清零) | 无 preset, 负沿触发 |
| 74 | 双 D 触发器 | toggle 用, **必须 HCT** |
| **75** | **4 位 D 透明锁存 (双稳态, LS)** | 互补 Q/~Q 输出, 透明锁存 |
| **76** | **双 JK 触发器 (带 preset+clear)** | 负沿触发, 有置位 |
| 86 | 四 2 输入异或门 | 与 CD4070 引脚不同 |
| **90** | **十进制计数器 (÷2/÷5/÷10, LS)** | BCD 0-9 纹波计数, 分频用 |
| **112**  | **双 JK 触发器 (负沿, 带 preset+clear)** | 同 76 但负沿触发方式不同 |
| **122**  | **双可重触发单稳态触发器 (LS, 带清零)** | 同 123 但带 CLR 清零 |
| **123**  | **双可重触发单稳态触发器 (LS)** | 脉冲生成 (外接 RC), 可重触发 |
| 125  | 四总线缓冲门 (3 态) | |
| **132**  | **四 2 输入施密特与非门** | 滞回+与非, 抗噪 |
| 138  | 3-8 译码器 | 地址译码 |
| **139**  | **双 2-4 译码器** | 两组独立, 推挽输出 (156 是 OC) |
| **151**  | **8 选 1 多路器 (三态, 互补输出)** | 同 251, 3-bit 地址 (151=非三态版) |
| 153  | 双 4 选 1 数据选择器 | ⚠️ 上下半部共享地址 |
| 154  | 4-16 译码器 | |
| **156**  | **双 2-4 译码器 (集电极开路)** | 可组 3-8, OC 输出 |
| **157**  | **四 2 选 1 多路器 (非反相, 推挽)** | 4-bit 总线选择 (158=反相, 257=三态) |
| **158**  | **四 2 选 1 多路器 (反相)** | 输出反相版 (257 是非反相三态) |
| 161  | 4 位同步二进制计数器 | period 计数/分频 |
| 164  | 8 位串入并出移位寄存器 | ⚠️ MR 异步清零无置位 |
| **165** | **8 位并入串出移位寄存器** | ⭐ **异步并行预置**, 可做 LFSR |
| **166** | **8 位并入串出移位寄存器** | ⭐ **同步并行预置**, 可做 LFSR |
| **169**  | **4 位同步加减二进制计数器** | 可预置, 进位前瞻, 0-15 |
| **173**  | **4 位 D 型寄存器 (三态)** | 带时钟使能+MR |
| **174**  | 六 D 触发器 | |
| **175**  | **四 D 触发器 (带互补输出+清零)** | 共享 CP+MR, Q+~Q 输出 |
| 177  | 可预置计数器 | |
| 190  | 同步加减计数器 | 三角波方向控制 |
| **194**  | **4 位双向通用移位寄存器** | 左/右移+串/并入出, 通用移位 |
| **195**  | **4 位并出入移位寄存器** | 并行预置+移位, 可做 LFSR/计数 |
| 238  | 3-8 译码器 (地址锁存) | |
| 240  | 八反相三态缓冲 | |
| 244  | 八同相三态缓冲 | 总线驱动 |
| 245  | 八总线收发器 | |
| **251**  | **8 选 1 多路器 (三态, 互补输出)** | 3-bit 地址选 8 路, Q+~Q 输出 |
| **257**  | **四 2 选 1 多路器 (三态)** | 4-bit 总线切换, 非反相 |
| **259**  | **8 位可寻址锁存器 / 1-of-8 译码** | ⭐ 独热码输出, 多模式 |
| **273**  | **八 D 触发器 (带异步清零)** | 同 374 但 /MR 异步清零 (v0.3/v0.5 滤毛刺用) |
| **279**  | **四 R-S 锁存器** | SR 锁存, 去抖/存储 (set/reset) |
| **280**  | **9 位奇偶校验生成/检测器 (LS)** | 奇/偶输出, 数据校验 |
| **283** | **4 位二进制加法器** | ⭐ 可做比较器替代 (减法+借位) |
| **295**  | **4 位双向移位寄存器 (三态)** | 左/右移+并行, 3 态输出 |
| **298**  | **四 2 选 1 多路器 + 寄存器** | 选 4-bit + 边沿锁存 (mux+FF 一体) |
| **321**  | **晶体控制振荡器** | 时钟发生器 (SN74LS321, LS 系列) |
| **358**  | ⚠️ **待确认** (74HC358 非标准型号) | 最接近: 74HC354 (8选1+锁存+三态). 上板前核对丝印 |
| **367**  | **六总线缓冲器 (三态, 非反相)** | 两组使能, 驱动 6 路 |
| 373  | 八 D 透明锁存器 | period 锁存/电平转换 |
| 374  | 八 D 触发器 | 寄存器 |
| 377  | 八 D 触发器 (带使能) | |
| **392**  | **双 4 位计数器 (LS, 十进制/二进制)** | 双计数器, 分频/级联 |
| **393**  | **双 4 位二进制纹波计数器** | ÷2~÷16×2路, 负沿触发, 分频链 |
| **395**  | **4 位并行存取移位寄存器 (LS)** | 串/并入, 并出, 可级联 (LS395A) |
| **540**  | **八反相缓冲器 (三态)** | 反相版 541 (541 非反相) |
| **541**  | **八缓冲器 (三态, 非反相)** | 总线驱动, 两组使能 |
| 573  | 八 D 透明锁存器 (同 373) | |
| 574  | 八 D 触发器 (同 374) | |
| 590  | 8 位二进制计数器 (带输出锁存) | |
| 595  | 8 位移位寄存器 (带输出锁存) | |

> ⚠️ **没有 HC85** (4-bit magnitude comparator)。比较器替代方案候选：
>   - **283** (4位加法器): duty-counter 减法看借位
>   - **173** (4位D寄存器三态) + 查表: counter 当 ROM 地址查 duty 比较结果
>   - **259** (8位可寻址锁存器): 独热码比较输出
>   - 门电路组合 (HC00/HC08): 经典 4-bit 比较器, ~10 门

---

## 其他 IC (ADC / 驱动 / 收音机 / 录音机)

| 型号 | 类型 | 功能 | 备注 |
|---|---|---|---|
| **ADC0808** | A/D 转换器 | 8 位逐次逼近 ADC + 8 通道模拟多路器 | 5V, TTL 兼容, 微处理器接口 |
| **ULN2003** | 达林顿阵列 | 7 路高压大电流达林顿驱动 (OC) | 50V/500mA, 继电器/步进电机驱动 |
| **MCT1413** | 达林顿阵列 | 7 路 NPN 达林顿 (=ULN2003 同效, Motorola) | 内置 2.7kΩ 输入电阻+续流二极管 |
| **DS75491** | LED 段驱动 | MOS-to-LED 四段驱动 (灌入电流) | 配 DS75492 做多位 LED 扫描显示 |
| **DS75492** | LED 位驱动 | MOS-to-LED 四位驱动 (拉出电流) | 配 DS75491, 共阴 LED 扫描 |
| **HA1167** | 黑白电视 IC | 图像通道: 第三中放+视频检波+消隐+同步分离+AGC | HA-KC 系列六片机 |
| **HA1144** | 黑白电视 IC | 图像中放: 第一/二级中放+AGC 放大延迟 | 配合 HA1167 |
| **CD1130P** | AM 收音机 IC | (=LA1130) AM 调谐器: RF放大+混频+本振+中放 | 汽车收音机用 |
| **TA7668** | 录音机 IC | 双声道录音/放音前置放大 + ALC + 静音 | 6-15V, 立体声磁头放大 |
| **ADVFC32** | V/F + F/V 转换器 | 电压↔频率双向转换 (AD) | 0.01% 线性, 500kHz, 隔离传输 |
| **ADG508** | 模拟多路器 | 8 选 1 CMOS 模拟开关 (3-bit 地址) | 低导通电阻, ADG509=双4选1 |
| **DG211** | 模拟开关 | 四 SPST CMOS 模拟开关 (常闭) | DG212=常开, 信号切换 |
| **AD574** | A/D 转换器 | 12 位逐次逼近 ADC + 内置基准+时钟 | 3 态输出, 8/16 位总线接口 |
| **TEA1062** | 电话 IC | 低电压电话传输电路 (话音+线路接口) | 拨号/通话切换 |
| **D526C31** | ⚠️ **待确认** (≈AM26C31/DS26C31) | 四差分线驱动器 (RS-422), 4 路差分发送. 上板前核对丝印 |
| **TC5067** | ⚠️ **待确认** (搜不到标准 datasheet) | 搜到 TC-5067A 是 GTEM 测试设备非 IC. 可能是冷门/国产型号, 上板前核对丝印 |

> 这些是模拟/混合信号 IC, 非数字逻辑. HA-KC 系列/CD1130P/TA7668 是老式家电芯片,
> 数字音源项目可能用不到, 但留作参考 (运放/驱动/ADC 可能有用).

---

## ROM / Flash / EPROM / EEPROM

| 型号 | 类型 | 容量 | 备注 |
|---|---|---|---|
| 27C128 | EPROM (UV) | 128Kbit (16K×8) | 紫外擦除 |
| 27C256 | EPROM (UV) | 256Kbit (32K×8) | |
| 27C512 | EPROM (UV) | 512Kbit (64K×8) | |
| 27C1024 | EPROM (UV) | 1Mbit (64K×16) | 16 位数据 |
| 27C240 | EPROM (UV) | 2Mbit (256K×8) | |
| W29C020 | EEPROM (并) | 2Mbit (256K×8) | Winbond, 电擦除 |
| AT24C64 | EEPROM (I2C 串行) | 64Kbit (8K×8) | I2C 接口, 参数/配置存储, 断电保持 |
| 24LC512 | EEPROM (I2C 串行) | 512Kbit (64K×8) | Microchip, I2C, 大容量参数/波表存储 |
| 29F1615 | NOR Flash | 16Mbit (2M×8) | AMD/Spansion/Macronix |
| SST39SF010 | NOR Flash | 1 Mbit (128K×8) | 波表/音色数据 |
| SST39SF020 | NOR Flash | 2 Mbit (256K×8) | |
| SST39SF040 | NOR Flash | 4 Mbit (512K×8) | |

---

## SRAM (静态内存, 全系列都有)

| 型号 | 容量 | 备注 |
|---|---|---|
| 6116 / HM6116 | 2K×8 (16 Kbit) | HM6116 = Hitachi 高速版 (120-200ns) |
| 6264 / HM6264 | 8K×8 (64 Kbit) | HM6264 = Hitachi 版 |
| 62256 / W24256 / D43256 | 32K×8 (256 Kbit) | W24256=Winbond, D43256=NEC (μPD43256), 同容量 |
| 628128 | 128K×8 (1 Mbit) | |
| 628512 | 512K×8 (4 Mbit) | |
| HY62CT081 | 8K×8 (64 Kbit) | Hynix 低功耗 CMOS SRAM |
| W2456 | ⚠️ **待确认** (非标准 SRAM 型号) | 可能是 W24256 笔误, 上板前核对丝印 |

---

## 特殊内存 (双口/DRAM)

| 型号 | 类型 | 容量 | 备注 |
|---|---|---|---|
| CY7C130 | 双口 SRAM | 1K×8 | Cypress, 双 CPU 共享内存, 30ns, DIP-48 |
| CY7C136 | 双口 SRAM | 2K×8 | Cypress, 同 CY7C130 但更大容量 |
| KM4164B | DRAM | 64K×1 | Samsung, 行列复用地址 (80年代PC用) |

---

## F-RAM (铁电非易失内存)

| 型号 | 容量 | 备注 |
|---|---|---|
| FM1808 | 32K×8 (256 Kbit) | 铁电 RAM, 70ns 访问, 无限读写, 掉电保持 (类 SRAM 接口) |

---

## 晶振 (有源振荡器)

| 频率 | 备注 |
|---|---|
| 32.768 kHz | 钟表频率, CD4060 分频用 |
| 1.8432 MHz | 串口波特率基准 (÷16=115200) |
| 4 MHz | v0.5 波形通道主时钟 |
| 5 MHz | |
| 7.37 MHz | 7.3728MHz? 串口波特率 |
| 8 MHz | |
| 10 MHz | 频率基准 |
| 12 MHz | 8051 常用 |
| 14.318 MHz | NTSC 色副载波 (4×3.579545) |
| 16 MHz | |
| 20 MHz | |
| 30 MHz | |
| 60 MHz | |
| 64 MHz | |
| 66 MHz | |
| 70 MHz | |
| 72 MHz | |
| 75 MHz | |
| 80 MHz | |
| 85 MHz | |
| 90 MHz | |
| 100 MHz | |
| 125 MHz | |

> 有源晶振 (4 脚, 内置振荡电路, 直接输出方波). 无需外接电容.
> 60MHz+ 高频晶振: CPLD/FPGA 系统时钟, 或 ECL 高速分频链基准.

---

## 音源 IC (经典声音芯片)

| 型号 | 类型 | 功能 | 备注 |
|---|---|---|---|
| **SN76477** | 复杂声音发生器 (CSG) | VCO+SLF+噪音, 混合信号, 游戏机/玩具音效 | TI 1978, RC 编程 |
| **SN76489** | 数字声音发生器 (PSG) | 3 方波+1 噪音, 数字总线控制 | TI, 串行接口, SG-1000 用 |
| **MOS6581** | SID 音源 | 3 声道+ADSR+波形+滤波+环形调制 | Commodore 64 (R1) |
| **MOS8580** | SID 音源 (改进版) | 同 6581 但滤波改进, 功耗低 | C64 后期版 |

---

## 模拟函数发生器 / VCO / 调制器

| 型号 | 类型 | 功能 | 备注 |
|---|---|---|---|
| **XR2206** | 函数发生器 | 正弦/三角/方波, FM/AM/FSK | Exar, 0.01Hz~1MHz |
| **XR2207** | VCO | 电压控制方波/三角波 | Exar, 可编程频率范围 |
| **XR2208** | VCO+乘法器 | VCO+四象限乘法器 (AM 调制) | Exar |
| **ICL8038** | 函数发生器 | 正弦/三角/方波, 扫频 | Intersil, 0.001Hz~300kHz |
| **LM566N** | VCO | 电压控制方波/三角波 | National, 0~1MHz |
| **MC1496** | 平衡调制/解调器 | 双边带/单边带/乘法检波 | Motorola, AM/FM/混频 |
| **CA3080/A** | 运算跨导放大器 (OTA) | 电压控制增益, 乘法器 | RCA, AGC/乘法/采样 |
| **SG3524** | PWM 控制器 | 开关电源 PWM, 双输出 | Silicon General, 可做 VCO |
| **THAT320** | 匹配晶体管对 | 低噪声 NPN 对管, 精密匹配 | THAT Corp, 音频前端 |
| **MAX743** | DC-DC 开关电源 | ±15V 或可调, 双输出 | Maxim, 给运放供电 |

---

## DAC / 模拟

| 型号 | 功能 | 备注 |
|---|---|---|
| TLC7524 | 8 位乘法 DAC | REF=方波/音量衰减 (v0.2 已用) |
| **AD7528JN** | **双 8 位乘法 DAC** | 一片两路独立 DAC, DIP-20, +5V. ⭐ 可替代 2×TLC7524 (波形+音量级联) |
| **DAC08E** | **8 位高速乘法 DAC (电流输出)** | 100ns 建立时间, ±15V, 经典款 (同 DAC08) |
| **NE5018** | **8 位 DAC (电流输出)** | Philips/Signetics, 并行输入 |

---

## 运放 / 模拟放大

| 型号 | 功能 | 备注 |
|---|---|---|
| **LM358** | 双运放 | 单电源, 低功耗, 常用 |
| **LM324** | 四运放 | 单电源, 低功耗, 常用 |
| **TL084** | 四运放 (JFET 输入) | 高阻输入, 低噪声, ±15V |
| **NE5532** | 双运放 (低噪声) | 音频专用, 高转换率 |

---

## CPU / 单片机

### 经典 CPU (8 位)

| 型号 | 架构 | 备注 |
|---|---|---|
| **STC89C52 / 89C52RC** | 8051 兼容 (STC) | 8 位 MCU, 5V, Flash 内置 |
| **W78E052DDG** | 80C52 兼容 (Winbond) | 8 位 MCU, 5V, Flash 内置 |
| **P80C31** | 8051 (无 ROM 版) | 外挂 ROM, 5V |
| **8032** | 8051 (无 ROM 版) | 同 8031, 增强 I/O |
| **8755** | 8085 外设 IC | 2K EPROM + 16 路 I/O |
| **Z840006PSC** | Z80 CPU (Zilog) | 8 位 CPU, 6MHz CMOS, DIP-40 |
| **Z0840004PSC** | Z80 CPU (Zilog Z0840) | 8 位 CPU, 4MHz CMOS, DIP-40 (Z80A 频率) |
| **HD6809** | 6809 MPU (Hitachi) | 增强 8 位 CPU, 6800 升级版, DIP-40 |

### 8051 增强 (STC/AI 系列, 1T 单周期)

| 型号 | 架构 | 备注 |
|---|---|---|
| **STC8H8K64** | 8051 (STC 8H) | 1T 单周期, 64K Flash, 硬件 SPI/I2C/ADC |
| **STC32G12K128** | 32 位 8051 (STC32G) | 128K Flash, 12K RAM, 1T, 硬件浮点? |
| **STC32G144K246** | 32 位 8051 (STC32G) | ⭐ **STC_Chiptune 参考工程芯片** (sn76489/ay8910/ym2413 软件音源) |
| **AI8051U-34K64** | 8051 (AI8051U) | 34K? Flash, USB 内置, STC 子品牌 |
| **STC12LE5410AD** | 8051 (STC 12 系列) | 1T 单周期, 10K Flash, ADC, 3.3V (LE 低压版) |

### AVR (Atmel/Microchip)

| 型号 | 备注 |
|---|---|
| **ATmega168P** | 8 位 AVR, 16K Flash, 1K EEPROM, 32 脚, Arduino 核心芯片 |
| **ATtiny2313** | 8 位 AVR, 2K Flash, 20 脚, 精简 I/O, 小型控制 |

### Parallax Propeller (多核并行)

| 型号 | 备注 |
|---|---|
| **P8X32A-D40** | 8 核 32 位并行 MCU (cog), 80MHz, 32K RAM, 32 I/O, DIP-40. 无中断, 轮询多核 |

> Propeller 的 8 个 cog (处理器核) 各自独立运行, 适合多通道并行处理.
> 例如: 1 cog 做 MIDI 解析, 7 cog 各管一个音源通道 — 天然的硬件多任务.

| 型号 | 内核 | 备注 |
|---|---|---|
| **STM32F407VET6** | Cortex-M4F | 168MHz, FPU+DSP, 512K Flash, 192K RAM. 高性能 |
| **STM32F401** | Cortex-M4F | 84MHz, FPU+DSP, 低功耗版 |

### RISC-V / RP 系列

| 型号 | 内核 | 备注 |
|---|---|---|
| **RP2040** | 双 Cortex-M0+ | 133MHz, 264K RAM, PIO 可编程 I/O. Pi Pico 芯片 |
| **RP2350** | 双 Hazard3 RISC-V/M33 | RP2040 升级版, 150MHz, 更多 RAM |

### ESP 系列 (乐鑫, WiFi/BLE)

| 型号 | 备注 |
|---|---|
| **ESP01** | ESP8266 最小模块, WiFi, 512K Flash, 2 个 GPIO |
| **ESP8266EX** | ESP8266 裸芯片, Tensilica L106 32位, 80MHz, WiFi |
| **ESP-WROOM-32** | ESP32 模块, 双核 Xtensa 240MHz, WiFi+BLE |
| **ESP32-S3-N16R8** | ESP32-S3, 16M Flash 8M PSRAM, AI 加速指令, USB OTG |
| **ESP32-P4-N32R16** | ESP32-P4, 32M Flash 16M PSRAM, 高性能多媒体 |

### PIC (Microchip)

| 型号 | 备注 |
|---|---|
| **PIC16F628A** | 8 位 PIC, 18 脚, 比较器+电压基准, 经典入门 |
| **PIC18F2550** | 8 位 PIC18, USB 2.0 内置, 32K Flash |
| **PIC18F25K20** | 8 位 PIC18, 低功耗, 32K Flash, nanoWatt XLP |
| **PIC32MX250F128** | MIPS32 M4K, 40MHz, 128K Flash, USB |
| **PIC32MX795F512** | MIPS32, 80MHz, 512K Flash, USB/CAN/Ethernet |

---

## USB 桥接 / 接口芯片

| 型号 | 功能 | 备注 |
|---|---|---|
| **FT232R** | USB↔串口 (UART) | FTDI, 最常用 USB-串口, 内置 EEPROM |
| **FT232H** | USB↔MPSSE (SPI/I2C/JTAG/GPIO) | ⭐ **本项目控制芯片** (FT232H CJMCU 板, 12 线控 PSG) |
| **EZ-USB FX2 (CY7C68013)** | USB 2.0 高速控制器 | 8051 内核, 可编程 GPIF, 480Mbps |

---

## 音频 DAC (I2S/PCM)

| 型号 | 接口 | 备注 |
|---|---|---|
| **PCM5102** | I2S | 32 位立体声 DAC, 112dB SNR, 3.3V, 零等待. 直接驱动耳机 |

---

## 开发板 (成品模块)

| 型号 | MCU | 备注 |
|---|-----|---|
| **Arduino UNO** | ATmega328P | 5V, 14 数字+6 模拟 I/O, 16MHz |
| **Arduino Nano** | ATmega328P | UNO 缩小版, 迷你 USB |
| **Arduino Mini** | ATmega328P | Nano 进一步缩小, 无 USB |
| **Pro Micro 5V** | ATmega32U4 | 16MHz, 5V, **内置 USB** (HID 键盘/鼠标), 迷你板. 无需 FT232 |

### FPGA 开发板 (Sipeed Tang, Gowin 高云)

| 型号 | FPGA 芯片 | 逻辑资源 | 备注 |
|---|---|---|---|
| **Tang Nano 9K** | Gowin GW2A | 8,640 LUT4 | 指尖大小, USB-C 下载, 27MHz 板载时钟, 支持 RISC-V 软核 |
| **Tang Primer 20K** | Gowin GW2A-LV18 | 20,736 LUT4 | 1Gbit DDR3, 以太网, SODIMM 核心板+扩展 |

> Tang 系列用 Gowin (高云) FPGA, 国产芯片, 工具链 Gowin IDE (免费).
> 价格极低 (9K ~$5, 20K ~$15), 是验证 NCO/波表/FM 算法的最便宜 FPGA 方案.
> 比 Altera/Xilinx 开发板便宜一个数量级.

---

## PLD (可编程逻辑)

| 型号 | 功能 | 备注 |
|---|---|---|
| **GAL16V8D** | 通用阵列逻辑 (PAL型 SPLD) | Lattice, 16输入8输出, E²CMOS 电擦写 |
| **ATF16LV8C** | GAL16V8 兼容 (低压版) | Atmel, 3.3V/5V, E²PROM |
| **ATF22V10B** | GAL22V10 兼容 SPLD | Atmel, 22输入10输出, 更大容量, 可替代多片 74 门 |

### CPLD (复杂可编程逻辑, Xilinx XC9500 系列)

| 型号 | 宏单元 | 等效门 | 备注 |
|---|---|---|---|
| **XC9536** | 36 | ~800 | 最小 CPLD, 34 I/O, 5ns 延迟 |
| **XC9572** | 72 | ~1600 | 中等, 替代十几片 74 |
| **XC95144** | 144 | ~3200 | 大容量, 替代几十片 74 |
| **XC95288** | 288 | ~6400 | 最大, 整个 PSG3 都能烧进去 |

> XC9500 系列: 5V 在系统可编程 (ISP), JTAG 下载, EEPROM 工艺 (断电保持).
> ⭐ 可将整个波形通道/总线层的逻辑烧进 1 片 CPLD, 大幅减少芯片数.

### CPLD (Altera MAX 7000 系列, EEPROM 非易失)

| 型号 | 宏单元 | 等效门 | 备注 |
|---|---|---|---|
| **EPM7032** | 32 | 600 | 最小, 对标 XC9536 |
| **EPM7064** | 64 | 1250 | 对标 XC9572 |
| **EPM7128** | 128 | 2500 | MAX 7000E 增强版, 对标 XC95144 |

> MAX 7000: EEPROM 工艺, 断电保持, 即时上电. 5V (S 后缀=ISP).
> 与 Xilinx XC9500 对等, 工具链不同 (Quartus vs ISE).

### FPGA (Altera Cyclone 系列, SRAM 易失)

| 型号 | 系列 | 逻辑单元 | 封装 | 备注 |
|---|---|---|---|---|
| **EP1C12Q240** | Cyclone | ~12K LE | PQFP-240 | 130nm, 上电需配置 |
| **EP2C5Q208** | Cyclone II | ~5K LE | PQFP-208 | 90nm, 1.2V 核心, 常见入门 FPGA |

> FPGA 是 SRAM 工艺, 掉电丢失配置, 上电要从 Flash/EEPROM 加载.
> 密度远高于 CPLD (千~万级 LE), 可做 NCO/波表/FM 等复杂算法.
> EP2C5 常见于低价开发板, 适合验证复杂音源算法.

---

## ECL 系列 (发射极耦合逻辑, 超高速)

> ECL 是超高速逻辑 (传播延迟 ~1ns), 用于射频/高速通信.
> **PECL 接法可与 74 系列互通**: ECL 芯片正电源供电 (VCC=+5V, VEE=GND),
> 输出变成正电平 (约 +4.1V/+3.3V), 经电阻分压+三极管电平转换即可接 74HC.
> 不需要专门的电平转换芯片, 简单分立元件就行.
> 高速分频/鉴相/倍频场景有用.

### MECL 10K 系列 (MC10xxx)

| 型号 | 功能 | 备注 |
|---|---|---|
| **MC10101** | 四 2 输入或/或非门 | 基础门, 互补 OR/NOR 输出 |
| **MC10109** | 双 4-5 输入或/或非门 | 宽输入 OR/NOR |
| **MC10131** | 双 D 主从触发器 | 异步 S/R, 时钟使能, MECL 经典 FF |
| **MC10158** | 双 4 选 1 数据选择器 (多路器) | 4-bit 总线切换, ECL 高速 mux |

### MECL 10H 系列 (MC10Hxxx, 10K 高速版)

| 型号 | 功能 | 备注 |
|---|---|---|
| **MC10H116** | 三差分线接收器 | 差分信号接收, 10K 版 10116 的 2 倍速 |
| **MC10H131** | 双 D 主从触发器 | 同 10131 但速度翻倍, 引脚兼容 |

### MECL 100K 系列 (MC100xxx, 更高速)

| 型号 | 功能 | 备注 |
|---|---|---|
| **MC100114** | 六差分线接收器 | 6 通道差分接收 |
| **MC100124** | 四 TTL→ECL 电平转换器 | TTL 到 ECL 转换 |
| **MC100170** | 9 位奇偶校验生成/检测器 | 高速奇偶校验 |
| **MC100334** | ⚠️ **待确认** (4-bit 通用总线收发器?) | 100K 系列总线收发, 查 MECL 手册确认 |

---

## CPU 外设 IC (经典可编程接口)

| 型号 | 类型 | 功能 | 备注 |
|---|---|---|---|
| **D8255AC-2** | PPI (可编程外设接口) | 3×8-bit 并口 (24 路 I/O), 软件配置模式 | NEC μPD8255A, 8085/Z80 用 |
| **D8279** | 键盘/显示控制器 | 扫描键盘矩阵 + 驱动数码管 | NEC μPD8279 |
| **TMP82C79** | 键盘/显示控制器 | 同 8279 功能, CMOS 版 | Toshiba |
| **D8259** | 中断控制器 (PIC) | 8 级优先中断 (可级联到 64 级) | NEC μPD8259, 8085/Z80 用 |
| **8253** | 可编程定时器 | 3×16-bit 计数/定时器 | 8085 系列外设, 方波/速率发生 |
| **MC6840** | 可编程定时器 (PTM) | 3×16-bit 计数/定时器 | Motorola 6800 系列外设 |
| **HD46508** | 模拟数据采集 (ADU) | 10-bit ADC + 电压比较器 + 16 通道 MUX | Hitachi NMOS |

---

## 补充其他 IC

| 型号 | 类型 | 功能 | 备注 |
|---|---|---|---|
| **DS26C32** | 线路接收器 | 四差分线接收器 (RS-422) | 配合 D526C31(线驱动) |
| **DG528** | 模拟多路器 | 8 选 1 CMOS 模拟开关 | Harris/Intersil (同 ADG508 类) |
| **UPB8216** | 总线驱动器 (NEC) | 双向 4 位总线收发器 (=Intel 8216) | 三态输出, CPU 总线接口 |
| **KP580NK51** | 可编程定时器 (苏联) | =Intel 8253 兼容, 3×16-bit 计数器 | 苏联 КР580 系列 |
| **56921SB2** | ⚠️ **待确认** (军用编号?) | 可能是 8251 串口或 8253 定时器军用版 | 核对丝印 |
| **56921C2** | ⚠️ **待确认** (军用编号?) | 同上, 可能不同封装/等级 | 核对丝印 |

---

## v0.2/v0.3 已实测使用 (= 库存肯定有)

- 74LS373 (电平转换层, FT232H 3.3V→5V) ✅
- 74HC373 (period 透明锁存) ✅
- 74HC161 ×2 (period 计数器级联) ✅
- 74HC00 (PE 反相 + gate 与门合并) ✅
- 74HCT74 (双 D 触发器: TC 同步 + toggle, **必须 HCT**) ✅
- 74HC374 (音量码锁存) ✅
- TLC7524 (乘法 DAC, REF=方波/音量衰减) ✅
