denjhang/74HC-Chiptune/Glowworm-1/docs/ref/BOM_下载器.xlsx

No. | Quantity | Comment | Designator | Footprint | Value | Manufacturer Part | Manufacturer | Supplier Part | Supplier
1 | 7 | 104 | C1,C2,C5,C6,C7,C8,C9 | 0402
2 | 1 | 105 | C3 | 0402
3 | 1 | 106 | C4 | 0402
4 | 1 | RB521S-30 | D1 | 0603
5 | 1 | LED | D2 | 0402
6 | 1 | MicroUSB | J1 | MICRO_USB
7 | 1 | TRMUX | J2 | SIP4
8 | 1 | ROM_DATA_LOAD | JP1 | IDC20
9 | 1 | CLKMUX | JP2 | IDC6
10 | 3 | 10K | R1,R2,R3 | 0402
11 | 1 | 1K | R4 | 0402
12 | 1 | CH340N | U1 | SO-8
13 | 2 | 74HC74 | U2,U3 | TSSOP14
14 | 3 | 74HC161 | U4,U5,U10 | TSSOP16
15 | 1 | 74HC14 | U6 | TSSOP14
16 | 1 | 74HC32 | U7 | TSSOP14
17 | 1 | 74HC08 | U8 | TSSOP14
18 | 1 | 74HC00 | U9 | TSSOP14
19 | 2 | 74HC595 | U11,U12 | TSSOP16
20 | 1 | SMD7050-1.8432 | U13 | SMD7050
