denjhang/74HC-Chiptune/Glowworm-1/docs/ref/BOM_CPU.xlsx

No. | Quantity | Comment | Designator | Footprint | Value | Manufacturer Part | Manufacturer | Supplier Part | Supplier
1 | 2 | 106 | C1,C25 | 0402
2 | 47 | 104 | C2,C3,C4,C5,C6,C7,C8,C9,C10,C11,C12,C13,C14,C15,C16,C17,C18,C19,C20,C21,C22,C23,C24,C27,C28,C29,C30,C31,C32,C33,C34,C35,C36,C37,C38,C39,C40,C41,C42,C43,C44,C45,C46,C47,C48,C49,C50 | 0402
3 | 1 | 105 | C26 | 0402
4 | 2 | RB521S-30 | D1,D2 | 0603
5 | 21 | LED | D3,D4,D5,D6,D7,D8,D9,D10,D11,D12,D13,D14,D15,D16,D17,D18,D19,D20,D21,D22,D23 | 0402
6 | 4 | SIP16 | J1,J2,J3,J4 | SIP16
7 | 1 | SIP3 | J5 | SIP3
8 | 2 | SIP4 | J6,J7 | SIP4
9 | 1 | SIP8 | J8 | SIP8
10 | 1 | ROM_DATA_LOAD | JP1 | IDC20
11 | 1 | 2SC1815 | Q1 | SO-G3/C2.5_1 | sot-23-3
12 | 7 | 10K | R1,R2,R4,R5,R6,R7,R8 | 0402
13 | 1 | 27K | R3 | 0402
14 | 29 | 1K | R9,R10,R11,R12,R13,R14,R15,R16,R17,R18,R19,R20,R21,R22,R23,R24,R25,R26,R27,R28,R29,R30,R31,R32,R33,R34,R35,R36,R37 | 0402
15 | 1 | IS61LV256 | U1 | TSSO8X13-G28/X.3
16 | 5 | 74LVC16374 | U2,U4,U5,U6,U10 | TSSOP48
17 | 1 | 74LVC16244 | U3 | TSSOP48
18 | 2 | IS61WV2568-20488 | U7,U8 | TSOP44
19 | 1 | IS61LV12816-51216 | U9 | TSOP44
20 | 1 | 74VHC244 | U11 | TSSOP20
21 | 6 | 74LVC161 | U12,U13,U14,U15,U16,U25 | TSSOP16
22 | 4 | 74LVC138 | U17,U18,U19,U20 | TSSOP16
23 | 3 | SO-G6/Z2.8 | U21,U23,U24 | SO-G6/Z2.8
24 | 1 | 74LVC2G07 x4 | U22 | SO-G6/Z2.8 | sot-23-6
25 | 1 | 74LVC00 | U26 | TSSOP14
26 | 1 | 74LVC32 | U27 | TSSOP14
27 | 1 | 74LVC14 | U28 | TSSOP14
28 | 1 | SMD7050-50m | U29 | SMD7050
29 | 1 | ME6206A15_1.5V | U30 | SO-G3/C2.5_1
