denjhang/74HC-Chiptune/wsg3/docs/wiring-table.md

# WSG3 接线表 (15 片 IC)

> 基于 Pac-Man WSG 1980 网表 (freePCB.net) + SPFM 接口

---

## 12 片 WSG 核心 (1:1 复刻)

### U2: 74HC04 (14-pin)

| Pin | 信号 | 说明 |
|-----|---|---|
| 1 | A1 | GND (未用) |
| 2 | Y1 | 2H 反相输出 |
| 3 | A2 | 2H 输入 (U3.9) |
| 4 | Y2 | GND (未用) |
| 5-6 | A3,Y3 | GND (未用) |
| 7 | GND | GND |
| 8 | Y4 | GND (未用) |
| 9 | A4 | GND (未用) |
| 10 | Y5 | GND (未用) |
| 11 | A5 | GND (未用) |
| 12 | Y6 | GND (未用) |
| 13 | A6 | GND (未用) |
| 14 | VCC | VCC |

### U3: 39SF040 wavetable ROM (28-pin)

| Pin | 信号 | 说明 |
|-----|---|---|
| 1-12, 23-26 | A0-A14 | ROM 地址 (相位[14:0]) |
| 13-15, 17-21 | DQ0-DQ7 | 波形数据输出 |
| 16 | GND | GND |
| 22 | /OE | GND (常输出) |
| 27 | /CE | 地址译码 (161 计数器输出) |
| 28 | VCC | VCC |

### U4: 74HC157 AB mux (16-pin)

| Pin | 信号 | 说明 |
|-----|---|---|
| 1 | /S | GND (常选 A) |
| 2-5 | A1-A4 | AB0-3 (RAM 频率低 4-bit) |
| 6-9 | B1-B4 | GND (未用) |
| 10 | GND | GND |
| 11-14 | Y1-Y4 | AB0-3 输出 → U1 (替代) |
| 15 | /E | GND (常输出) |
| 16 | VCC | VCC |

### U5: 74HC158 DB mux (16-pin)

| Pin | 信号 | 说明 |
|-----|---|---|
| 1-4 | A1-A4 | DB0-3 (RAM 频率高 4-bit) |
| 5-8 | B1-B4 | GND (未用) |
| 9-12 | /Y1-/Y4 | DB0-3 反相输出 |
| 13-16 | 控制信号 | 见网表 |

### U6/U7: 74HC157 地址 mux (16-pin ×2)

| Pin | 信号 | 说明 |
|-----|---|---|
| A1-A4 | 2L-DQ0-3 / 2K-DQ0-3 | RAM 数据输入 |
| B1-B4 | GND (未用) |
| Y1-Y4 | 2L-DQ0-3 / 2K-DQ0-3 | → U8 加法器 |

### U8: 74HC283 加法器 (16-pin)

| Pin | 信号 | 说明 |
|-----|---|---|
| 1-4, 16, 15 | A0-A3, B0-B3 | 相位切片输入 |
| 5-7, 9-11 | S0-S3 | 和输出 |
| 8 | GND | GND |
| 12 | C4 | 进位输出 |
| 13 | C0 | 进位输入 (上周期锁存) |
| 14 | VCC | VCC |

### U9: 74HC174 相位锁存 (16-pin)

| Pin | 信号 | 说明 |
|-----|---|---|
| 1-6, 14 | D1-D6 | U8 输入 (相位切片) |
| 2,5,7,12 | Q1-Q4 | 相位输出反馈 U6/U7 |
| 3 | /CLR | RST_n |
| 8 | GND | GND |
| 9 | CLK | 2MHz 主时钟 |
| 10 | Q6 | 未用 |
| 13 | Q5 | 未用 |
| 15 | D6 | 未用 |
| 16 | VCC | VCC |

### U10: CY62256 RAM (28-pin)

| Pin | 信号 | 说明 |
|-----|---|---|
| 1-10, 21-23 | A0-A14 | RAM 地址 |
| 11-13, 15-19 | DQ0-DQ7 | 数据 (双向) |
| 14 | GND | GND |
| 20 | /CE | SPFM 写脉冲选通 |
| 24 | /OE | GND (常输出) |
| 25 | /WE | SPFM 写脉冲 |
| 26-28 | A12-A14 | 地址高位 |
| 27-28 | VCC | VCC |

### U11: 74HC273 输出寄存器 (20-pin)

| Pin | 信号 | 说明 |
|-----|---|---|
| 1-8 | D0-D7 | 波形+音量数据 (ROM 查表结果) |
| 9 | /CLR | RST_n |
| 10 | GND | GND |
| 11 | CLK | TDM 时钟 (每通道末拍锁存) |
| 12-19 | Q0-Q7 | → 4066 控制信号 |
| 20 | VCC | VCC |

### U12: CD4066 模拟混音 (14-pin)

| Pin | 信号 | 说明 |
|-----|---|---|
| 1 | IO1 | R1 (权重 R) |
| 2 | IO2 | R2 (权重 2R) |
| 3 | IO3 | R5 → SOUND |
| 4 | IO4 | R4 (权重 8R) |
| 5-7 | CTRL | U11 Q1-Q4 (音量代码) |
| 8 | IO5 | R3 (权重 4R) |
| 9 | IO6 | R8 → SOUND |
| 10 | IO7 | R7 → SOUND |
| 11 | IO8 | RES-COM |
| 12 | CTRL3 | U11 Q3 |
| 13 | CTRL4 | U11 Q2 |
| 14 | VCC | VCC |
| 7 | GND | GND |

---

## 3 片 SPFM 接口

### U13: 74HC373 数据锁存 (20-pin)

| Pin | 信号 | 说明 |
|-----|---|---|
| 1 | /OE | GND (常输出) |
| 2,5,7,9 | D0-D3 | SPFM D[0:3] |
| 12,15,17,19 | D4-D7 | SPFM D[4:7] |
| 3,4,6,8 | Q0-Q3 | → reg_data[0:3] |
| 13,14,16,18 | Q4-Q7 | → reg_data[4:7] |
| 11 | LE | ~(CS_n | WR_n) |
| 10 | GND | GND |
| 20 | VCC | VCC |

### U14: 74HC174 同步链 (16-pin)

| Pin | 信号 | 说明 |
|-----|---|---|
| 1-6, 14 | D1-D6 | 写脉冲输入 |
| 2,5,7,12 | Q1-Q4 | 同步输出 (延迟) |
| 3 | /CLR | RST_n |
| 8 | GND | GND |
| 9 | CLK | 2MHz 主时钟 |
| 10 | Q6 | 未用 |
| 13 | Q5 | 未用 |
| 15 | D6 | 未用 |
| 16 | VCC | VCC |

### U15: 74HC377 地址寄存器 (20-pin)

| Pin | 信号 | 说明 |
|-----|---|---|
| 1 | /E | addr_wr_pulse_n (U14 Q3 反相) |
| 2-9 | D0-D7 | U13 Q0-Q7 |
| 10 | GND | GND |
| 11 | CLK | 2MHz |
| 12-19 | Q0-Q7 | reg_addr[0:7] |
| 20 | VCC | VCC |

---

## 电阻/电容

| 元件 | 值 | 连接 |
|---|---|---|
| R1 | 10kΩ | U11 Q0 → U12.1 |
| R2 | 20kΩ | U11 Q1 → U12.2 |
| R3 | 40kΩ | U11 Q2 → U12.8 |
| R4 | 80kΩ | U11 Q3 → U12.11 |
| R5-R8 | 10kΩ×4 | U12.3,2,10,9 → SOUND |
| R9 | 2.2kΩ | VCC → 上拉 |
| C1 | 0.1μF | SOUND → GND (低通) |

---

## 总线汇总

### 主时钟: 2MHz
- U9.9, U14.9, U15.11

### SPFM 总线
- D[7:0] → U13 D[0:7]
- A0 → (地址译码逻辑, 外部)
- CS_n → U13.11 (LE 译码)
- WR_n → U13.11 (LE 译码)
- RST_n → U9.3, U14.3

### TDM 时序
- 161 状态机输出 → ROM 地址, mux 选通, 273 CLK

---

## 总计

| 类别 | IC 数 |
|---|---|
| WSG 核心 | 12 片 |
| SPFM 接口 | 3 片 |
| **总计** | **15 片** |
