denjhang/74HC-Chiptune/psg_voice/PSG3 v0.5/docs/wiring-table-rev-e3.md

# PSG3 v0.5 rev.e3 接线表 — PCM 采样通道 (无限循环, 最简验证版)

> rev.e3 = rev.e2 砍掉所有组合逻辑 (HC08/HC04) 和 7474 toggle, PCM 专用最简版.
> 目的: 隔离 rev.e2 的故障 (7474/组合逻辑接错), 先验证 PCM 基本播放.
> **无限循环**: 地址 0-8191 跑完自动回绕 (HC161 自由计数), 不停, 无触发, 无停止逻辑.
> **频率可调**: period12 控制回放步进速率 (= 采样频率).

---

## 一、与 rev.e2 的区别

| 项 | rev.e2 | rev.e3 |
|----|---|---|
| 模式 | 双模式 (波形+PCM) | **PCM only** |
| a12 | U7 7474 toggle (U6.TC 驱动) | **U7 HC161 Q0** (U6.TC 级联, 无 toggle) |
| 组合逻辑 | U8 HC08 + U9 HC04 (6 信号) | **全砍** |
| 触发/停止 | trig_clr / at_8191 / step | **全砍** (无限循环, 软件不控制启停) |
| 地址计数 | U4-U6 (12 位) | **U4-U7 (13 位, 加 1 片 HC161)** |
| reg5 | mode/trig/预留/sel | **sel only** (Q0-3), Q4-7 悬空 |
| 芯片数 | 12 | **10** |

> rev.e3 是 rev.e2 的子集 + 1 片 HC161 (a12), 砍掉 7474/HC08/HC04 共 3 片, 净 -3 片.

---

## 二、寄存器

```
reg3 (0x08): period12[7:0]        ← 步进速率 (采样频率)
reg4 (0x10): period12[11:8]<<4 | vol[3:0]
reg5 (0x20):
  bit7-4: 悬空 (不用)
  bit3-0: sel[3:0] (选 16 个 PCM 槽, → ROM.A13-16)
```

> reg5 只有 sel, 无 mode/trig. 上位机写 sel 选槽, 写 period12 调速率, 写 vol 调音量.
> 无启停控制: 上电就开始循环播放 sel 选中的槽, 换 sel 即换采样.

---

## 三、信号定义 (全局网络标签, 本文内同名 = 同一根线)

### 3.1 reg5 输出

| 标签 | 来源 | 含义 |
|---|---|---|
| sel0 | reg5.Q0 (P2) | 选槽 bit0 |
| sel1 | reg5.Q1 (P5) | 选槽 bit1 |
| sel2 | reg5.Q2 (P6) | 选槽 bit2 |
| sel3 | reg5.Q3 (P9) | 选槽 bit3 |
| — (未用) | reg5.Q4 (P12) | 悬空 |
| — (未用) | reg5.Q5 (P15) | 悬空 |
| — (未用) | reg5.Q6 (P16) | 悬空 |
| — (未用) | reg5.Q7 (P19) | 悬空 |

### 3.2 reg4 输出 (音量)

| 标签 | 来源 | 含义 |
|---|---|---|
| vol0 | reg4.Q0 (P2) | 音量 bit0 (LSB) |
| vol1 | reg4.Q1 (P5) | 音量 bit1 |
| vol2 | reg4.Q2 (P6) | 音量 bit2 |
| vol3 | reg4.Q3 (P9) | 音量 bit3 (MSB) |

### 3.3 公共信号

| 标签 | 来源 | 含义 |
|---|---|---|
| rst_n | 总线层 U0b.Q2 | 复位 (低有效) |
| clk | 晶振 X1 | 4MHz 主时钟 |

### 3.4 period 计数器

| 标签 | 含义 |
|---|---|
| freq_tc | period12 计满一周期进位 (U3.TC), 驱动地址步进 |

### 3.5 地址计数器 TC 级联链

| 标签 | 含义 |
|---|---|
| tc_a03 | U4 计满 16 进位 (a0-3 满) |
| tc_a47 | U5 计满 256 进位 (a0-7 满) |
| tc_a811 | U6 计满 4096 进位 (a0-11 满, 驱动 U7=a12) |

### 3.6 地址位

| 标签 | 含义 |
|---|---|
| a0 .. a11 | 地址 A0-A11 (U4/U5/U6 的 Q) |
| a12 | 地址 A12 (U7.Q0, U6 每 4096 步走一次) |

### 3.7 ROM 数据线

| 标签 | 含义 |
|---|---|
| d0 .. d7 | U8 ROM 输出 D0-D7 → U9 TLC7524 DB0-7 |

> **无组合信号** (无 HC08/HC04). 所有控制直连: CEP/CET=freq_tc 或级联 TC, 无门控.

---

## 四、ROM 分区 (128K = 16 槽 × 8K, PCM only)

```
sel=0  (0x00000-0x01FFF): BD 底鼓
sel=1  (0x02000-0x03FFF): SD 军鼓
sel=2  (0x04000-0x05FFF): HH 踩镲
sel=3  (0x06000-0x07FFF): TOM 嗵鼓
sel=4  (0x08000-0x09FFF): RIM 边击
sel=5  (0x0A000-0x0BFFF): TOP 踩镲开
sel=6  (0x0C000-0x0DFFF): Piano 钢琴
sel=7  (0x0E000-0x0FFFF): SlapBass 贝斯
sel=8  (0x10000-0x11FFF): Oboe 双簧管
sel=9  (0x12000-0x13FFF): Trumpet 小号
sel=10 (0x14000-0x15FFF): Strings 弦乐
sel=11 (0x16000-0x17FFF): Harp 竖琴
sel=12 (0x18000-0x19FFF): Guitar 吉他
sel=13 (0x1A000-0x1BFFF): Shakuhachi 尺八
sel=14 (0x1C000-0x1DFFF): Blow 吹管
sel=15 (0x1E000-0x1FFFF): Oboe2
```

每槽 8192 样本, 无限循环 (0→8191→0→...). 采样频率 = 4MHz / (8192 × (4096 - period12)).
默认 8kHz: period12 = 4096 - 4MHz/(8192×8000) = 4096 - 61 = 4035.

---

## 五、芯片清单 (10 片, 位号从 U1 起)

> 本文位号独立. U1-U3 = period 计数器 (= 总线层 U20-U22).
> U4-U7 = 地址计数器 (13 位, a0-a12). U8 = ROM. U9/U10 = DAC.

| 位号 | 型号 | 功能 |
|---|---|---|
| U1 | HC161 | period12[3:0] |
| U2 | HC161 | period12[7:4] |
| U3 | HC161 | period12[11:8], TC → freq_tc |
| U4 | HC161 | 地址 a0-a3 (低 4 位) |
| U5 | HC161 | 地址 a4-a7 (中 4 位) |
| U6 | HC161 | 地址 a8-a11 (高 4 位) |
| U7 | HC161 | 地址 a12 (只用 Q0, U6.TC 级联) |
| U8 | SST39SF010 | ROM (128K) |
| U9 | TLC7524 | PCM DAC (CS=clk) |
| U10 | TLC7524 | 音量衰减 |

> vs rev.e2 (12 片): 砍 7474/HC08/HC04 (-3), 加 a12 的 HC161 (+1), 净 -2 片.
> rev.e3 无组合逻辑, 无 toggle, 接线最简, 适合先验证 PCM.

---

## 六、逐芯片接线 (五列: Pin | 来源 | 连接到 | 网络标签 | 说明)

### U1-U3 — HC161×3 period12 三级联 (同 rev.d/e2, 不变)

> 接线同 rev.d. U1/U2 的 Q 悬空 (只 TC 级联). U3.TC = freq_tc.

**U3 输出**:

| Pin | 来源 | 连接到 | 网络标签 | 说明 |
|-----|---|---|---|---|
| 11 (Q3) | — | 悬空 | — | period 高位, 本表不读 Q |
| 12 (Q2) | — | 悬空 | — | |
| 13 (Q1) | — | 悬空 | — | |
| 14 (Q0) | — | 悬空 | — | |
| 15 (TC) | — (本芯片) | U4.CEP (P7), U4.CET (P10) | freq_tc | period 进位 → 驱动地址步进 |

> freq_tc 直接驱动 U4 (无 step 门控, 无 at_8191 停止). 无限循环.

---

### U4 — HC161 (地址 a0-a3, 低 4 位)

| Pin | 来源 | 连接到 | 网络标签 | 说明 |
|-----|---|---|---|---|
| 1 (MR) | 总线层 U0b.Q2 | — | rst_n | 复位 |
| 2 (CP) | 晶振 X1 | — | clk | 4MHz |
| 3 (P0) | — | GND | — | 预置 0 |
| 4 (P1) | — | GND | — | |
| 5 (P2) | — | GND | — | |
| 6 (P3) | — | GND | — | |
| 7 (CEP) | U3.TC (P15) | — | freq_tc | 步进使能 (每 period 走一步) |
| 8 (GND) | — | GND | — | |
| 9 (~PE) | — | +5V | — | 不预置 (自由计数, 无限循环) |
| 10 (CET) | U3.TC (P15) | — | freq_tc | 步进使能 |
| 11 (Q3) | — | U8.A3 (P7) | a3 | 地址 bit3 |
| 12 (Q2) | — | U8.A2 (P8) | a2 | |
| 13 (Q1) | — | U8.A1 (P9) | a1 | |
| 14 (Q0) | — | U8.A0 (P10) | a0 | 地址 bit0 (LSB) |
| 15 (TC) | — (本芯片) | U5.CEP (P7), U5.CET (P10) | tc_a03 | 计满 16 → 级联 U5 |
| 16 (VCC) | — | +5V | — | |

> ~PE 接 +5V (不预置). 无 trig_clr, 无清地址逻辑. 上电即自由计数, 无限循环 0-15.

---

### U5 — HC161 (地址 a4-a7, 中 4 位)

| Pin | 来源 | 连接到 | 网络标签 | 说明 |
|-----|---|---|---|---|
| 1 (MR) | 总线层 U0b.Q2 | — | rst_n | 复位 |
| 2 (CP) | 晶振 X1 | — | clk | 4MHz |
| 3 (P0) | — | GND | — | 预置 0 |
| 4 (P1) | — | GND | — | |
| 5 (P2) | — | GND | — | |
| 6 (P3) | — | GND | — | |
| 7 (CEP) | U4.TC (P15) | — | tc_a03 | 级联使能 |
| 8 (GND) | — | GND | — | |
| 9 (~PE) | — | +5V | — | 不预置 |
| 10 (CET) | U4.TC (P15) | — | tc_a03 | 级联使能 |
| 11 (Q3) | — | U8.A7 (P3) | a7 | 地址 bit7 |
| 12 (Q2) | — | U8.A6 (P4) | a6 | |
| 13 (Q1) | — | U8.A5 (P5) | a5 | |
| 14 (Q0) | — | U8.A4 (P6) | a4 | 地址 bit4 |
| 15 (TC) | — (本芯片) | U6.CEP (P7), U6.CET (P10) | tc_a47 | 计满 256 → 级联 U6 |
| 16 (VCC) | — | +5V | — | |

---

### U6 — HC161 (地址 a8-a11, 高 4 位)

| Pin | 来源 | 连接到 | 网络标签 | 说明 |
|-----|---|---|---|---|
| 1 (MR) | 总线层 U0b.Q2 | — | rst_n | 复位 |
| 2 (CP) | 晶振 X1 | — | clk | 4MHz |
| 3 (P0) | — | GND | — | 预置 0 |
| 4 (P1) | — | GND | — | |
| 5 (P2) | — | GND | — | |
| 6 (P3) | — | GND | — | |
| 7 (CEP) | U5.TC (P15) | — | tc_a47 | 级联使能 |
| 8 (GND) | — | GND | — | |
| 9 (~PE) | — | +5V | — | 不预置 |
| 10 (CET) | U5.TC (P15) | — | tc_a47 | 级联使能 |
| 11 (Q3) | — | U8.A11 (P23) | a11 | 地址 bit11 |
| 12 (Q2) | — | U8.A10 (P25) | a10 | |
| 13 (Q1) | — | U8.A9 (P24) | a9 | |
| 14 (Q0) | — | U8.A8 (P21) | a8 | 地址 bit8 |
| 15 (TC) | — (本芯片) | U7.CEP (P7), U7.CET (P10) | tc_a811 | 计满 4096 → 级联 U7 (a12) |
| 16 (VCC) | — | +5V | — | |

> U6 永远级联跑 (无 mode 门控). 与 rev.e2 不同: rev.e2 波形模式冻结 U6, rev.e3 永远跑.

---

### U7 — HC161 (地址 a12, 只用 Q0)

| Pin | 来源 | 连接到 | 网络标签 | 说明 |
|-----|---|---|---|---|
| 1 (MR) | 总线层 U0b.Q2 | — | rst_n | 复位 |
| 2 (CP) | 晶振 X1 | — | clk | 4MHz |
| 3 (P0) | — | GND | — | 预置 0 |
| 4 (P1) | — | GND | — | |
| 5 (P2) | — | GND | — | |
| 6 (P3) | — | GND | — | |
| 7 (CEP) | U6.TC (P15) | — | tc_a811 | 级联使能 (U6 每 4096 步走一次) |
| 8 (GND) | — | GND | — | |
| 9 (~PE) | — | +5V | — | 不预置 |
| 10 (CET) | U6.TC (P15) | — | tc_a811 | 级联使能 |
| 11 (Q3) | — | 悬空 | — | 不用 (只需 a12 = Q0) |
| 12 (Q2) | — | 悬空 | — | 不用 |
| 13 (Q1) | — | 悬空 | — | 不用 |
| 14 (Q0) | — | U8.A12 (P2) | a12 | 地址 bit12 (0-4095: a12=0, 4096-8191: a12=1) |
| 15 (TC) | — | 悬空 | — | 不用 (8192 自动回绕, U7.Q0 0→1→0) |
| 16 (VCC) | — | +5V | — | |

> U7 只用 Q0 当 a12. U6 每 4096 进位 → U7 走一步 → Q0 翻转.
> 地址: 0-4095 (a12=0) → 4096-8191 (a12=1) → 8192 回绕 (U7.Q0 回 0). 无限循环.
> 无 7474 toggle (rev.e2 的 U7 是 7474, rev.e3 改 HC161, 避免接错).

---

### U8 — SST39SF010 (ROM 128K)

| Pin | 来源 | 连接到 | 网络标签 | 说明 |
|-----|---|---|---|---|
| 10 (A0) | U4.Q0 (P14) | — | a0 | 地址 bit0 |
| 9 (A1) | U4.Q1 (P13) | — | a1 | |
| 8 (A2) | U4.Q2 (P12) | — | a2 | |
| 7 (A3) | U4.Q3 (P11) | — | a3 | |
| 6 (A4) | U5.Q0 (P14) | — | a4 | |
| 5 (A5) | U5.Q1 (P13) | — | a5 | |
| 4 (A6) | U5.Q2 (P12) | — | a6 | |
| 3 (A7) | U5.Q3 (P11) | — | a7 | |
| 21 (A8) | U6.Q0 (P14) | — | a8 | |
| 24 (A9) | U6.Q1 (P13) | — | a9 | |
| 25 (A10) | U6.Q2 (P12) | — | a10 | |
| 23 (A11) | U6.Q3 (P11) | — | a11 | |
| 2 (A12) | U7.Q0 (P14) | — | a12 | 地址 bit12 (U7 HC161, 非 7474) |
| 27 (A13) | reg5.Q0 (P2) | — | sel0 | 选槽 bit0 |
| 1 (A14) | reg5.Q1 (P5) | — | sel1 | 选槽 bit1 |
| 28 (A15) | reg5.Q2 (P6) | — | sel2 | 选槽 bit2 |
| 29 (A16) | reg5.Q3 (P9) | — | sel3 | 选槽 bit3 (A0-A16 = 128K 全用) |
| 11 (D0) | — | U9.DB0 (P11) | d0 | 数据 bit0 (LSB) |
| 12 (D1) | — | U9.DB1 (P10) | d1 | |
| 13 (D2) | — | U9.DB2 (P9) | d2 | |
| 14 (D3) | — | U9.DB3 (P8) | d3 | |
| 15 (D4) | — | U9.DB4 (P7) | d4 | |
| 16 (D5) | — | U9.DB5 (P6) | d5 | |
| 17 (D6) | — | U9.DB6 (P5) | d6 | |
| 18 (D7) | — | U9.DB7 (P4) | d7 | 数据 bit7 (MSB) |
| 22 (~OE) | — | GND | — | 常输出 |
| 26 (~CE) | — | GND | — | 常选通 |
| 31 (~WE) | — | +5V | — | 只读 |
| 32 (VCC) | — | +5V | — | |
| 20 (GND) | — | GND | — | |

> ROM 脚位据 memory/SST39SF_Flash_family.md: A8=P21, A9=P24, A10=P25, A11=P23,
> A12=P2, A13=P27, A14=P1, A15=P28, A16=P29.

---

### U9 — TLC7524 (PCM DAC, CS=clk)

| Pin | 来源 | 连接到 | 网络标签 | 说明 |
|-----|---|---|---|---|
| 1 (OUT1) | — | U10.REF (P15) | — | 模拟量 → 音量 DAC 基准 |
| 2 (OUT2) | — | GND | — | |
| 3 (GND) | — | GND | — | |
| 4 (DB7) | U8.D7 (P18) | — | d7 | 数据 MSB |
| 5 (DB6) | U8.D6 (P17) | — | d6 | |
| 6 (DB5) | U8.D5 (P16) | — | d5 | |
| 7 (DB4) | U8.D4 (P15) | — | d4 | |
| 8 (DB3) | U8.D3 (P14) | — | d3 | |
| 9 (DB2) | U8.D2 (P13) | — | d2 | |
| 10 (DB1) | U8.D1 (P12) | — | d1 | |
| 11 (DB0) | U8.D0 (P11) | — | d0 | 数据 LSB |
| 12 (CS) | 晶振 X1 | — | clk | 同步采样 (rev.d 验证稳定) |
| 13 (WR) | — | GND | — | 透明 |
| 14 (VDD) | — | +5V | — | |
| 15 (REF) | — | +5V | — | 满量程基准 |
| 16 (RFB) | — | GND | — | |

---

### U10 — TLC7524 (音量衰减, 级联 U9)

| Pin | 来源 | 连接到 | 网络标签 | 说明 |
|-----|---|---|---|---|
| 1 (OUT1) | — | 耦合电容→运放→喇叭 | — | 最终输出 |
| 2 (OUT2) | — | GND | — | |
| 3 (GND) | — | GND | — | |
| 4 (DB7) | reg4.Q3 (P9) | — | vol3 | 音量 MSB |
| 5 (DB6) | reg4.Q2 (P6) | — | vol2 | |
| 6 (DB5) | reg4.Q1 (P5) | — | vol1 | |
| 7 (DB4) | reg4.Q0 (P2) | — | vol0 | 音量 LSB |
| 8 (DB3) | — | GND | — | |
| 9 (DB2) | — | GND | — | |
| 10 (DB1) | — | GND | — | |
| 11 (DB0) | — | GND | — | |
| 12 (CS) | — | GND | — | 透明 |
| 13 (WR) | — | GND | — | 透明 |
| 14 (VDD) | — | +5V | — | |
| 15 (REF) | U9.OUT1 (P1) | — | — | 级联输入 |
| 16 (RFB) | — | GND | — | |

---

## 七、电源

| 芯片 | VDD | GND |
|---|-----|-----|
| HC161 (U1-U7) | P16 | P8 |
| SST39SF010 (U8) | P32 | P20 |
| TLC7524 (U9, U10) | P14 | P3 |

> 每片 VDD 就近加 0.1μF 去耦. 所有 GND 共地.

---

## 八、关键信号流

```
clk ──→ period 计数器 (U1-U3) → freq_tc
                                    │
                                    ▼
U4 CEP/CET ← freq_tc (每 period 走一步)
U4 → tc_a03 → U5 CEP/CET
U5 → tc_a47 → U6 CEP/CET
U6 → tc_a811 → U7 CEP/CET (a12)
    │ a0-a12 (13 位地址, 0-8191 无限循环)
    ▼
U8 ROM (A0-12=地址, A13-16=sel) → d0-7 → U9 DAC (CS=clk) → U10 (vol) → 喇叭

无组合逻辑, 无 toggle, 无触发, 无停止. 上电即循环播放.
```

---

## 九、采样频率公式

```
采样频率 = 4MHz / (8192 × (4096 - period12))
period12 = 4096 - 4MHz / (8192 × 采样频率)
```

| 采样频率 | period12 | 说明 |
|---|---|---|
| 8kHz (默认) | 4035 | 标准 PCM 速率 |
| 4kHz | 3974 | 慢一半 (降调) |
| 16kHz | 4065 | 快一倍 (升调) |
| 1kHz | 3606 | 很慢 |
| 488Hz | 3095 | 鼓组低频 |

> period12 越大, 采样频率越高. 8192 步/槽, 无限循环.
