denjhang/74HC-Chiptune/psg_voice/PSG3 v0.5/docs/wiring-table-rev-e2.md

# PSG3 v0.5 rev.e2 接线表 — 波形通道 (双模式: 波形 + PCM 采样)

> rev.e2 = rev.e 内容重排版. 位号从 U1 起, 全部 12 片连续编号, 无附号 (U27b/U0a 之类).
> 双模式: 16 种波形 (mode=0) / 16 个 PCM 采样槽 (mode=1).
> 采样: 8-bit PCM, 8K/槽 (8kHz × 1秒).
> ROM: SST39SF010 (128K, 全用). clk = 4MHz. reg3/4/5.

---

## 一、寄存器

```
reg3 (0x08): period12[7:0]
reg4 (0x10): period12[11:8]<<4 | vol[3:0]
reg5 (0x20):
  bit7: mode (0=波形, 1=采样)
  bit6: trig (1=清地址, 0=放手; 上位机写 1 再写 0)
  bit5-4: 预留
  bit3-0: sel[3:0] (选 16 波形 / 16 采样)
```

> reg5 位含义 (对应 Q 脚): mode=bit7=Q7, trig=bit6=Q6, sel[3:0]=bit3-0=Q3/Q2/Q1/Q0.
> reg4: vol[3:0]=bit3-0=Q3/Q2/Q1/Q0.

---

## 二、地址分配

```
A0-7:   U4/U5 (HC161×2), 两模式共用
A8-11:  U6 (HC161), 采样模式级联跑, 波形模式冻结 Q=0
A12:    U7 (HCT74 toggle), U6.TC 驱动
A13-16: reg5.sel[3:0], 两模式同线
```

波形模式: U6 冻结 → A8-12=0, 只用 A0-7 (256 点) + A13-16 (sel).
采样模式: U6 级联 → A8-12 连续跑, A0-12 = 8K 连续地址.

---

## 三、信号定义 (全局网络标签, 本文内同名 = 同一根线)

> 下文所有芯片表只写本表的网络标签名 + 物理来源/去向 (芯片号+脚).
> 同一标签名在本文内任意位置出现都指同一根物理线.

### 3.1 reg5 输出 (总线层 U7 的 Q 端, rev.e 重新定义位含义)

| 标签 | 来源 | 含义 |
|---|---|---|
| sel0 | reg5.Q0 (P2) | 选槽 bit0 |
| sel1 | reg5.Q1 (P5) | 选槽 bit1 |
| sel2 | reg5.Q2 (P6) | 选槽 bit2 |
| sel3 | reg5.Q3 (P9) | 选槽 bit3 |
| — (未用) | reg5.Q4 (P12) | bit4 预留, 悬空 (不接任何负载) |
| — (未用) | reg5.Q5 (P15) | bit5 预留, 悬空 (不接任何负载) |
| trig | reg5.Q6 (P16) | 触发脉冲 (上位机写 1 再写 0) |
| mode | reg5.Q7 (P19) | 0=波形模式 / 1=采样模式 |

> reg5 全 8 个 Q 脚均有交代: Q0-Q3=sel, Q4/Q5=预留悬空, Q6=trig, Q7=mode.
> 预留脚悬空 (HC374 Q 端为推挽输出, 悬空无危害, 便于后续扩展接线).

### 3.2 reg4 输出 (音量)

| 标签 | 来源 | 含义 |
|---|---|---|
| vol0 | reg4.Q0 (P2) | 音量 bit0 (LSB) |
| vol1 | reg4.Q1 (P5) | 音量 bit1 |
| vol2 | reg4.Q2 (P6) | 音量 bit2 |
| vol3 | reg4.Q3 (P9) | 音量 bit3 (MSB) |

### 3.3 公共信号 (复位/时钟)

| 标签 | 来源 | 含义 |
|---|---|---|
| rst_n | 总线层 U0b.Q2 | 复位 (低有效), 来自总线层电平转换 |
| clk | 晶振 X1 | 4MHz 主时钟 |

### 3.4 period 计数器 (直出, 无组合)

| 标签 | 含义 |
|---|---|
| freq_tc | period12 计满一周期进位 (高有效脉冲), U3.TC |

### 3.5 地址计数器 TC 级联链 (HC161 进位, 直出)

| 标签 | 含义 |
|---|---|
| tc_a03 | 地址 A0-3 计满 16 进位, U4.TC |
| tc_a47 | 地址 A0-7 计满 256 进位, U5.TC |
| tc_a811 | 地址 A0-11 计满 4096 进位, U6.TC |

### 3.6 地址位 (HC161 Q / HCT74 Q)

| 标签 | 含义 |
|---|---|
| a0 .. a11 | 地址线 A0-A11 (U4/U5/U6 的 Q 端, 从低到高) |
| a12 | 地址线 A12 (U7 FF1 每 4096 步翻转一次) |

### 3.7 ROM 数据线 (ROM → DAC, 直连)

| 标签 | 含义 |
|---|---|
| d0 .. d7 | U10 ROM 输出 D0-D7, 直连 U11 TLC7524 DB0-DB7 (d0=LSB, d7=MSB) |

### 3.8 组合信号 (经 U8 HC08 / U9 HC04 产生)

| 标签 | 产生门 | 定义 |
|---|---|---|
| tc_pcm | U8 门1 | tc_a47 AND mode (采样模式才把进位传给 U6) |
| trig_clr | U8 门2 | trig AND mode (采样模式 trig=1 时请求清地址) |
| at_8191 | U8 门3 | tc_a811 AND a12 (地址走到 8191) |
| step | U8 门4 | freq_tc AND n_at8191 (地址步进使能, 高有效) |
| n_trig_clr | U9 门1 | ~trig_clr (给 HC161 的 ~PE, 低有效预置) |
| n_at8191 | U9 门2 | ~at_8191 (给 U8 门4 输入 B) |

> HC161 的 ~PE 低有效: n_trig_clr=0 时预置 P0-3 (=0, 清地址).
> step 高有效: step=1 时 CEP/CET 使能, 地址前进一步. 到 8191 后 step=0, 地址冻结.

---

## 四、ROM 分区 (128K = 16 槽 × 8K, sel 选槽)

```
sel=0  (0x00000-0x01FFF): 波形 sine    / 采样 BD 底鼓
sel=1  (0x02000-0x03FFF): 波形 tri     / 采样 SD 军鼓
sel=2  (0x04000-0x05FFF): 波形 saw     / 采样 HH 踩镲
sel=3  (0x06000-0x07FFF): 波形 rsaw    / 采样 TOM 嗵鼓
sel=4  (0x08000-0x09FFF): 波形 square50/ 采样 RIM 边击
sel=5  (0x0A000-0x0BFFF): 波形 pulse25 / 采样 TOP 踩镲开
sel=6  (0x0C000-0x0DFFF): 波形 pulse12 / 采样 Piano 钢琴
sel=7  (0x0E000-0x0FFFF): 波形 wt.sin  / 采样 SlapBass 贝斯
sel=8  (0x10000-0x11FFF): 波形 wt.halfsin / 采样 Oboe 双簧管
sel=9  (0x12000-0x13FFF): 波形 wt.abssin  / 采样 Trumpet 小号
sel=10 (0x14000-0x15FFF): 波形 pacman.sine / 采样 Strings 弦乐
sel=11 (0x16000-0x17FFF): 波形 pacman.tri  / 采样 Harp 竖琴
sel=12 (0x18000-0x19FFF): 波形 pacman.saw  / 采样 Guitar 吉他
sel=13 (0x1A000-0x1BFFF): 波形 pacman.step4/ 采样 Shakuhachi 尺八
sel=14 (0x1C000-0x1DFFF): 波形 pulse75    / 采样 Blow 吹管
sel=15 (0x1E000-0x1FFFF): 波形 pulse37    / 采样 Oboe2
```

波形模式只读每槽前 256 字节 (A8-12=0). 采样模式读满 8K (A0-12 跑). 两模式 mode 互斥不冲突.

---

## 五、采样规格

- 8-bit PCM (0-255, 128=静音中心)
- 每槽 8K = 8192 样本 = 8kHz × 1.024 秒
- period12 控制回放速度 (= 音高). 默认 8kHz (period12=3596)
- 采样首尾 crossfade (autoloop.py), 单次播放到 8191 自动停 (step=0)

---

## 六、芯片清单 (12 片, 本文位号从 U1 起, 无附号)

> 本文位号独立于总线层 (wiring-table-bus.md). 对应关系:
> U1-U3 = period 计数器 (= 总线层 U20-U22, 接线同 rev.d 不变)
> U4-U6 = 地址计数器 (低/中/高 4 位)
> U7 = a12 toggle, U8 = 组合逻辑 AND, U9 = 组合逻辑反相
> U10 = ROM, U11 = 波形 DAC, U12 = 音量 DAC

| 位号 | 型号 | 功能 |
|---|---|---|
| U1 | HC161 | period12[3:0] |
| U2 | HC161 | period12[7:4] |
| U3 | HC161 | period12[11:8], TC → freq_tc |
| U4 | HC161 | 地址 a0-a3 (低 4 位) |
| U5 | HC161 | 地址 a4-a7 (中 4 位) |
| U6 | HC161 | 地址 a8-a11 (高 4 位, 采样模式级联/波形模式冻结) |
| U7 | HCT74 | FF1 = a12 toggle (FF2 闲置) |
| U8 | HC08 | 4 门: tc_pcm / trig_clr / at_8191 / step |
| U9 | HC04 | 2 门: n_trig_clr / n_at8191 (4 门闲置) |
| U10 | SST39SF010 | ROM (128K) |
| U11 | TLC7524 | 波形/采样 DAC (CS=clk) |
| U12 | TLC7524 | 音量衰减 |

---

## 七、逐芯片接线 (五列: Pin | 来源 | 连接到 | 网络标签 | 说明)

> 输入脚: "连接到"写"—"; 输出脚: "来源"写"—"(本芯片输出).
> 网络标签见第三节, 同名 = 同一根线.

### U1-U3 — HC161×3 period12 三级联 (同 rev.d, 不变)

> 接线完全同 rev.d 第四节 (总线层 U20-U22). 这里只标注 rev.e2 用到的输出.
> U1/U2 的 Q 全悬空 (只内部 TC 级联用). U3.TC 输出 = freq_tc.

**U1 (period12[3:0])** — MR←rst_n, CP←clk, P0-3←reg3.Q0-3, CEP/CET→+5V, ~PE←(rev.d 接 ~tc_hi, 本表不涉及), TC→U2.CEP/CET, Q 悬空.

**U2 (period12[7:4])** — MR←rst_n, CP←clk, P0-3←reg3.Q4-7, CEP/CET←U1.TC, TC→U3.CEP/CET, Q 悬空.

**U3 (period12[11:8]) 输出**:

| Pin | 来源 | 连接到 | 网络标签 | 说明 |
|-----|---|---|---|---|
| 11 (Q3) | — | 悬空 | — | period 高位, 本表不读 Q (只内部 TC 级联) |
| 12 (Q2) | — | 悬空 | — | |
| 13 (Q1) | — | 悬空 | — | |
| 14 (Q0) | — | 悬空 | — | |
| 15 (TC) | — (本芯片) | U8.A4 (P12) | freq_tc | period 一周期进位脉冲 |

> freq_tc 不经整形, 直接进 U8 门4 做 step 的 AND 输入 (rev.e 架构: period 进位驱动地址步进).

---

### U4 — HC161 (地址 a0-a3, 低 4 位)

| Pin | 来源 | 连接到 | 网络标签 | 说明 |
|-----|---|---|---|---|
| 1 (MR) | 总线层 U0b.Q2 | — | rst_n | 复位清地址 |
| 2 (CP) | 晶振 X1 | — | clk | 4MHz 计数时钟 |
| 3 (P0) | — | GND | — | 预置 0 (清地址时装 0) |
| 4 (P1) | — | GND | — | 预置 0 |
| 5 (P2) | — | GND | — | 预置 0 |
| 6 (P3) | — | GND | — | 预置 0 |
| 7 (CEP) | U8.Y4 (P11) | — | step | 步进使能 (到 8191 停) |
| 8 (GND) | — | GND | — | |
| 9 (~PE) | U9.Y1 (P2) | — | n_trig_clr | 低有效预置 (=0 时装 P0-3=0, 清地址) |
| 10 (CET) | U8.Y4 (P11) | — | step | 步进使能 (与 CEP 同源) |
| 11 (Q3) | — | U10.A3 (P7) | a3 | 地址 bit3 |
| 12 (Q2) | — | U10.A2 (P8) | a2 | 地址 bit2 |
| 13 (Q1) | — | U10.A1 (P9) | a1 | 地址 bit1 |
| 14 (Q0) | — | U10.A0 (P10) | a0 | 地址 bit0 (LSB) |
| 15 (TC) | — (本芯片) | U5.CEP (P7), U5.CET (P10) | tc_a03 | 计满 16 进位 → 级联 U5 |
| 16 (VCC) | — | +5V | — | |

---

### U5 — HC161 (地址 a4-a7, 中 4 位)

| Pin | 来源 | 连接到 | 网络标签 | 说明 |
|-----|---|---|---|---|
| 1 (MR) | 总线层 U0b.Q2 | — | rst_n | 复位 |
| 2 (CP) | 晶振 X1 | — | clk | 4MHz |
| 3 (P0) | — | GND | — | 预置 0 |
| 4 (P1) | — | GND | — | |
| 5 (P2) | — | GND | — | |
| 6 (P3) | — | GND | — | |
| 7 (CEP) | U4.TC (P15) | — | tc_a03 | 级联使能 (低 4 位进位) |
| 8 (GND) | — | GND | — | |
| 9 (~PE) | U9.Y1 (P2) | — | n_trig_clr | 低有效预置 (清地址) |
| 10 (CET) | U4.TC (P15) | — | tc_a03 | 级联使能 |
| 11 (Q3) | — | U10.A7 (P3) | a7 | 地址 bit7 (A0-7 的 MSB) |
| 12 (Q2) | — | U10.A6 (P4) | a6 | |
| 13 (Q1) | — | U10.A5 (P5) | a5 | |
| 14 (Q0) | — | U10.A4 (P6) | a4 | 地址 bit4 |
| 15 (TC) | — (本芯片) | U8.A1 (P1) | tc_a47 | 计满 256 进位 → U8 做 tc_pcm/at_8191 |
| 16 (VCC) | — | +5V | — | |

---

### U6 — HC161 (地址 a8-a11, 高 4 位)

| Pin | 来源 | 连接到 | 网络标签 | 说明 |
|-----|---|---|---|---|
| 1 (MR) | 总线层 U0b.Q2 | — | rst_n | 复位 |
| 2 (CP) | 晶振 X1 | — | clk | 4MHz |
| 3 (P0) | — | GND | — | 预置 0 |
| 4 (P1) | — | GND | — | |
| 5 (P2) | — | GND | — | |
| 6 (P3) | — | GND | — | |
| 7 (CEP) | U8.Y1 (P3) | — | tc_pcm | 采样模式才级联 (mode=0 时 =0, 冻结) |
| 8 (GND) | — | GND | — | |
| 9 (~PE) | U9.Y1 (P2) | — | n_trig_clr | 低有效预置 (清地址) |
| 10 (CET) | U8.Y1 (P3) | — | tc_pcm | 采样模式才级联 |
| 11 (Q3) | — | U10.A11 (P23) | a11 | 地址 bit11 |
| 12 (Q2) | — | U10.A10 (P25) | a10 | |
| 13 (Q1) | — | U10.A9 (P24) | a9 | |
| 14 (Q0) | — | U10.A8 (P21) | a8 | 地址 bit8 |
| 15 (TC) | — (本芯片) | U7.CLK1 (P3), U8.A3 (P9) | tc_a811 | 计满 4096 进位 → 驱动 a12 toggle + at_8191 检测 |
| 16 (VCC) | — | +5V | — | |

> 波形模式 (mode=0): tc_pcm = tc_a47 AND 0 = 0 → U6.CEP/CET=0 → Q 冻结 → a8-a11=0,
> ROM 只用 a0-a7 (256 点波形). 采样模式 (mode=1): tc_pcm = tc_a47 → U6 级联跑, a0-a11 连续.

---

### U7 — HCT74 (a12 toggle, FF1 only, FF2 闲置)

| Pin | 来源 | 连接到 | 网络标签 | 说明 |
|-----|---|---|---|---|
| 1 (~CLR1) | 总线层 U0b.Q2 | — | rst_n | 复位清 a12 |
| 2 (D1) | U7.~Q1 (P6) | — | — | toggle 接法 (D=~Q) |
| 3 (CLK1) | U6.TC (P15) | — | tc_a811 | 每 4096 进位翻转一次 → a12 |
| 4 (~PRE1) | — | +5V | — | 不置位 |
| 5 (Q1) | — (本芯片) | U10.A12 (P2), U8.B3 (P10) | a12 | 地址 bit12 (采样地址 4096-8191 段) |
| 6 (~Q1) | — (本芯片) | U7.D1 (P2) | — | toggle 反馈 |
| 7 (GND) | — | GND | — | |
| 8 (~Q2) | — | 悬空 | — | FF2 闲置 |
| 9 (Q2) | — | 悬空 | — | FF2 闲置 |
| 10 (~PRE2) | — | +5V | — | FF2 闲置, 不置位 |
| 11 (CLK2) | — | 悬空 | — | FF2 闲置 |
| 12 (D2) | — | GND | — | FF2 闲置 |
| 13 (~CLR2) | — | +5V | — | FF2 闲置, 不清零 |
| 14 (VCC) | — | +5V | — | |

> a12 在波形模式恒 0 (因为 U6 冻结, tc_a811 不产生). 采样模式 a0-a12 = 0-8191 连续地址.

---

### U8 — HC08 (4 门全部用: tc_pcm / trig_clr / at_8191 / step)

**门功能表** (对应网络标签定义, 见第三节 3.8):

| 门 | 输入脚 (网络标签) | 输出脚 (网络标签) | 逻辑 |
|----|---|---|---|
| 门1 | A1=P1 (tc_a47), B1=P2 (mode) | Y1=P3 (tc_pcm) | tc_a47 AND mode |
| 门2 | A2=P4 (trig), B2=P5 (mode) | Y2=P6 (trig_clr) | trig AND mode |
| 门3 | A3=P9 (tc_a811), B3=P10 (a12) | Y3=P8 (at_8191) | tc_a811 AND a12 |
| 门4 | A4=P12 (freq_tc), B4=P13 (n_at8191) | Y4=P11 (step) | freq_tc AND n_at8191 |

| Pin | 来源 | 连接到 | 网络标签 | 说明 |
|-----|---|---|---|---|
| 1 (A1) | U5.TC (P15) | — | tc_a47 | 门1 输入 A |
| 2 (B1) | reg5.Q7 (P19) | — | mode | 门1 输入 B |
| 3 (Y1) | — (本芯片) | U6.CEP (P7), U6.CET (P10) | tc_pcm | 门1 输出 → U6 级联使能 |
| 4 (A2) | reg5.Q6 (P16) | — | trig | 门2 输入 A |
| 5 (B2) | reg5.Q7 (P19) | — | mode | 门2 输入 B |
| 6 (Y2) | — (本芯片) | U9.A1 (P1) | trig_clr | 门2 输出 → U9 反相 |
| 7 (GND) | — | GND | — | |
| 8 (Y3) | — (本芯片) | U9.A2 (P3) | at_8191 | 门3 输出 → U9 反相 |
| 9 (A3) | U6.TC (P15) | — | tc_a811 | 门3 输入 A |
| 10 (B3) | U7.Q1 (P5) | — | a12 | 门3 输入 B |
| 11 (Y4) | — (本芯片) | U4.CEP (P7), U4.CET (P10), U5.CEP (P7), U5.CET (P10) | step | 门4 输出 → U4/U5 步进使能 |
| 12 (A4) | U3.TC (P15) | — | freq_tc | 门4 输入 A |
| 13 (B4) | U9.Y2 (P4) | — | n_at8191 | 门4 输入 B (at_8191 反相) |
| 14 (VCC) | — | +5V | — | |

> step 驱动 U4/U5 的 CEP/CET (4 个脚并线, HC08 驱动能力够).
> U6.CEP/CET 不接 step, 接 tc_pcm (采样模式才级联, 波形模式冻结).

---

### U9 — HC04 (2 门用: n_trig_clr / n_at8191, 4 门闲置)

| Pin | 来源 | 连接到 | 网络标签 | 说明 |
|-----|---|---|---|---|
| 1 (A1) | U8.Y2 (P6) | — | trig_clr | 门1 输入 |
| 2 (Y1) | — (本芯片) | U4.~PE (P9), U5.~PE (P9), U6.~PE (P9) | n_trig_clr | 门1 输出 → 3 片 HC161 预置 (低有效清地址) |
| 3 (A2) | U8.Y3 (P8) | — | at_8191 | 门2 输入 |
| 4 (Y2) | — (本芯片) | U8.B4 (P13) | n_at8191 | 门2 输出 → U8 门4 输入 B |
| 5 (A3) | — | GND | — | 闲置防悬空 |
| 6 (Y3) | — | 悬空 | — | 闲置 |
| 7 (GND) | — | GND | — | |
| 8 (Y4) | — | 悬空 | — | 闲置 |
| 9 (A4) | — | GND | — | 闲置防悬空 |
| 10 (Y5) | — | 悬空 | — | 闲置 |
| 11 (A5) | — | GND | — | 闲置防悬空 |
| 12 (Y6) | — | 悬空 | — | 闲置 |
| 13 (A6) | — | GND | — | 闲置防悬空 |
| 14 (VCC) | — | +5V | — | |

> n_trig_clr = ~trig_clr = ~(trig AND mode). 采样模式 trig=1 时 n_trig_clr=0 → 3 片 HC161 同时预置 0 (清地址).
> 波形模式 mode=0 → trig_clr 恒 0 → n_trig_clr 恒 1 → HC161 自由计数 (不清地址).

---

### U10 — SST39SF010 (ROM 128K)

| Pin | 来源 | 连接到 | 网络标签 | 说明 |
|-----|---|---|---|---|
| 10 (A0) | U4.Q0 (P14) | — | a0 | 地址 bit0 |
| 9 (A1) | U4.Q1 (P13) | — | a1 | |
| 8 (A2) | U4.Q2 (P12) | — | a2 | |
| 7 (A3) | U4.Q3 (P11) | — | a3 | |
| 6 (A4) | U5.Q0 (P14) | — | a4 | |
| 5 (A5) | U5.Q1 (P13) | — | a5 | |
| 4 (A6) | U5.Q2 (P12) | — | a6 | |
| 3 (A7) | U5.Q3 (P11) | — | a7 | 地址 bit7 (波形模式只用到这里) |
| 21 (A8) | U6.Q0 (P14) | — | a8 | 采样模式高位 |
| 24 (A9) | U6.Q1 (P13) | — | a9 | |
| 25 (A10) | U6.Q2 (P12) | — | a10 | |
| 23 (A11) | U6.Q3 (P11) | — | a11 | |
| 2 (A12) | U7.Q1 (P5) | — | a12 | 采样地址 4096-8191 段 |
| 27 (A13) | reg5.Q0 (P2) | — | sel0 | 选槽 bit0 |
| 1 (A14) | reg5.Q1 (P5) | — | sel1 | 选槽 bit1 |
| 28 (A15) | reg5.Q2 (P6) | — | sel2 | 选槽 bit2 |
| 29 (A16) | reg5.Q3 (P9) | — | sel3 | 选槽 bit3 (A0-A16 = 17 位 = 128K 全用) |
| 11 (D0) | — | U11.DB0 (P11) | d0 | 数据 bit0 (LSB) |
| 12 (D1) | — | U11.DB1 (P10) | d1 | |
| 13 (D2) | — | U11.DB2 (P9) | d2 | |
| 14 (D3) | — | U11.DB3 (P8) | d3 | |
| 15 (D4) | — | U11.DB4 (P7) | d4 | |
| 16 (D5) | — | U11.DB5 (P6) | d5 | |
| 17 (D6) | — | U11.DB6 (P5) | d6 | |
| 18 (D7) | — | U11.DB7 (P4) | d7 | 数据 bit7 (MSB) |
| 22 (~OE) | — | GND | — | 常输出 (读模式) |
| 26 (~CE) | — | GND | — | 常选通 |
| 31 (~WE) | — | +5V | — | 只读 (不写) |
| 32 (VCC) | — | +5V | — | |
| 20 (GND) | — | GND | — | |

> **地址线分配**: A0-A12 ← 地址计数器 (a0-a12), A13-A16 ← reg5 (sel0-sel3). 共 17 位 = 128K 全用.
> ROM 脚位据 `memory/SST39SF_Flash_family.md` 核对 (2026-07-12):
> A8=P21, A9=P24, A10=P25, A11=P23, A12=P2, A13=P27, A14=P1, A15=P28, A16=P29.
> rev.d 只用 A0-A15 (A16 接 GND); rev.e2 全用 A0-A16 (16 槽 × 8K = 128K).

---

### U11 — TLC7524 (波形/采样 DAC, CS=clk)

| Pin | 来源 | 连接到 | 网络标签 | 说明 |
|-----|---|---|---|---|
| 1 (OUT1) | — | U12.REF (P15) | — | 模拟量输出 → 音量 DAC 基准 |
| 2 (OUT2) | — | GND | — | |
| 3 (GND) | — | GND | — | |
| 4 (DB7) | U10.D7 (P18) | — | d7 | 数据 MSB |
| 5 (DB6) | U10.D6 (P17) | — | d6 | |
| 6 (DB5) | U10.D5 (P16) | — | d5 | |
| 7 (DB4) | U10.D4 (P15) | — | d4 | |
| 8 (DB3) | U10.D3 (P14) | — | d3 | |
| 9 (DB2) | U10.D2 (P13) | — | d2 | |
| 10 (DB1) | U10.D1 (P12) | — | d1 | |
| 11 (DB0) | U10.D0 (P11) | — | d0 | 数据 LSB |
| 12 (CS) | 晶振 X1 | — | clk | ⭐ 同步采样 (rev.d 上板验证稳定, 无需 HC273) |
| 13 (WR) | — | GND | — | 透明 |
| 14 (VDD) | — | +5V | — | |
| 15 (REF) | — | +5V | — | 满量程基准 |
| 16 (RFB) | — | GND | — | |

> ROM.D0-7 直连 DB0-7, 无 HC273 锁存. CS=clk 提供 clk 沿同步采样 (rev.d 已验证, 90ns ROM 访问时间 << 250ns clk 周期).

---

### U12 — TLC7524 (音量衰减, 级联 U11)

| Pin | 来源 | 连接到 | 网络标签 | 说明 |
|-----|---|---|---|---|
| 1 (OUT1) | — | 耦合电容→运放→喇叭 | — | 最终输出 |
| 2 (OUT2) | — | GND | — | |
| 3 (GND) | — | GND | — | |
| 4 (DB7) | reg4.Q3 (P9) | — | vol3 | 音量 MSB |
| 5 (DB6) | reg4.Q2 (P6) | — | vol2 | |
| 6 (DB5) | reg4.Q1 (P5) | — | vol1 | |
| 7 (DB4) | reg4.Q0 (P2) | — | vol0 | 音量 LSB |
| 8 (DB3) | — | GND | — | 低 4 位接地 |
| 9 (DB2) | — | GND | — | |
| 10 (DB1) | — | GND | — | |
| 11 (DB0) | — | GND | — | |
| 12 (CS) | — | GND | — | 透明 (音量码不需同步) |
| 13 (WR) | — | GND | — | 透明 |
| 14 (VDD) | — | +5V | — | |
| 15 (REF) | U11.OUT1 (P1) | — | — | 级联输入 (波形 DAC 输出当基准) |
| 16 (RFB) | — | GND | — | |

> 乘法衰减: OUT1_总 = 波形值 × (vol/16). vol=0 静音, vol=15 满幅.

---

## 八、电源

| 芯片 | VDD | GND |
|---|-----|-----|
| HC161 (U1-U6) | P16 | P8 |
| HCT74 (U7) | P14 | P7 |
| HC08 (U8) | P14 | P7 |
| HC04 (U9) | P14 | P7 |
| SST39SF010 (U10) | P32 | P20 |
| TLC7524 (U11, U12) | P14 | P3 |

> 每片 VDD 就近加 0.1μF 去耦. 所有 GND 共地.

---

## 九、关键信号流 (用网络标签, 不写芯片号)

```
clk ──→ period 计数器 (U1-U3) → freq_tc
                                    │
                                    ▼ (进 U8 门4)
freq_tc ──AND── n_at8191 ──→ step ──→ U4/U5 CEP/CET (地址步进)
                                    ↘ (U6 不接 step, 接 tc_pcm)

地址计数器级联链:
  tc_a03 (U4 计满16) ──→ U5.CEP/CET
  tc_a47 (U5 计满256) ──→ U8 门1 ──AND── mode ──→ tc_pcm ──→ U6.CEP/CET
  tc_a811 (U6 计满4096) ──→ U7.CLK1 (a12 toggle)
                          ↘──→ U8 门3 ──AND── a12 ──→ at_8191

停止逻辑:
  at_8191 ──→ U9 门2 ──→ n_at8191 ──→ U8 门4 (拉低 step) → 地址冻结

清地址 (触发):
  trig ──→ U8 门2 ──AND── mode ──→ trig_clr ──→ U9 门1 ──→ n_trig_clr ──→ U4/U5/U6 ~PE

ROM 地址:  a0-a12 (地址计数器) + sel0-sel3 (reg5) ──→ U10.A0-A16
ROM 数据:  d0-d7 ──→ U11.DB0-7 ──→ U11.OUT1 ──→ U12.REF ──→ U12.OUT1 ──→ 喇叭
```

---

## 十、待上板验证 (rev.e2)

- [ ] 16 种波形 (mode=0, a8-a12 恒 0, ROM 读每槽前 256 字节)
- [ ] 16 个 PCM 采样 (mode=1, a0-a12 连续跑 0-8191)
- [ ] trig=1→0 触发采样播放 (n_trig_clr 清地址)
- [ ] 单次播放到 8191 自动停 (at_8191 → step=0)
- [ ] 波形模式 a8-a12 恒 0 (tc_pcm=0, U6 冻结)
- [ ] 变速变调 (period12 改 step 频率)
- [ ] 音量级联 (U11→U12, vol 0-15)
