denjhang/74HC-Chiptune/psg_voice/PSG3 v0.5/docs/wiring-table-bus.md

# PSG3 v0.5 接线表 — 接口层（YM2413 总线）

> 接口层完全独立，不借门、不复用通道层任何芯片。
> 物理接线与 v0.4 完全相同（U0-U13），只有 U2-U9 寄存器的 Q 去向按三通道重新分配。
> 方波/波形/噪音通道接线表各自独立，见 `wiring-table-square.md` / `wiring-table-uni.md` / `wiring-table-noise.md`。

---

## 一、FT232H 接线（12 根线，物理不动，语义改变）

| FT232H | PSG3 信号 | 用途 |
|---|---|---|
| C0-C7 | D0-D7 复用总线 | 地址 + 数据复用 |
| D4 | A0 | 0=写地址, 1=写数据 |
| D5 | /WR | 写脉冲（上升沿锁存）|
| D6 | /RST | 复位（低有效）|
| D7 | /CS | 片选（事务边界，必须控制，不接 GND）|

> ⚠️ 所有 FT232H 信号经 LS373 电平转换（3.3V→5V）。
> ⚠️ /CS 不接 GND——事务保护壳，消除"短暂地址值"中间态。

---

## 二、芯片清单（接口层独立，13 片）

| 位号 | 型号 | 功能 |
|---|---|---|
| U0a | 74LS373 | 电平转换：8 位数据总线 |
| U0b | 74LS373 | 电平转换：4 位控制（A0/WR/RST/CS）|
| U1 | 74HC374 | 地址锁存（边沿，独热码 8 位）|
| U2-U9 | 74HC374 ×8 | 数据寄存器 reg0-reg7（reg0/1=方波, reg2=噪音, reg3/4/5=波形, reg6/7 预留）|
| U10 | 74HC04 | NOT(/CS)、NOT(A0) |
| U11 | 74HC08 | addr_cp + data_strobe 组合 |
| U12 | 74HC08 | reg_cp[0-3] 选通 |
| U13 | 74HC08 | reg_cp[4-7] 选通 |

---

## 三、地址映射（独热码，每位选通一个 reg）

| 寄存器 | 独热码 | ADDR 位 | 芯片 | 用途 |
|---|---|---|---|---|
| reg0 | 0x01 | ADDR[0] | U2 | 方波 period（8 bit, v0.4 不变）|
| reg1 | 0x02 | ADDR[1] | U3 | 方波控制（vol/duty/mode, v0.4 不变）|
| reg2 | 0x04 | ADDR[2] | U4 | 噪音控制（vol/freq/bind）|
| reg3 | 0x08 | ADDR[3] | U5 | **波形 period[7:0]**（v0.5 新）|
| reg4 | 0x10 | ADDR[4] | U6 | **波形 period[11:8] \| vol**（v0.5 新）|
| reg5 | 0x20 | ADDR[5] | U7 | **波形 duty \| wave \| mode**（v0.5 新）|
| reg6 | 0x40 | ADDR[6] | U8 | 预留 |
| reg7 | 0x80 | ADDR[7] | U9 | 预留 |

---

## 四、选通逻辑

```
cs_active   = NOT(/CS)
a0_n        = NOT(A0)
addr_cp     = cs_active AND a0_n AND /WR     // 写地址: /WR↑ + A0=0 → 锁地址
data_strobe = cs_active AND A0     AND /WR   // 写数据: /WR↑ + A0=1 → 锁数据
reg_cp[n]   = ADDR[n] AND data_strobe         // 独热码地址一对一选通
```

---

## 五、U0a — 74LS373（电平转换：8 位数据总线）

> ⚠️ **LS373 与 HC374 引脚不同**（虽然都是 DIP-20）：
> - LS373: D0-D7=P3,4,**6**,8,13,14,**16**,18；Q0-Q7=P2,5,**7**,9,12,15,**17**,19
> - HC374: D0-D7=P3,4,**7**,8,13,14,**17**,18；Q0-Q7=P2,5,**6**,9,12,15,**16**,19
> D2/D6 和 Q2/Q6 的脚位互换。U0a/U0b 是 LS373，U1-U9 是 HC374，别接错。

| Pin | 信号 | 连接 |
|-----|---|---|
| D0-D7 (P3,4,6,8,13,14,16,18) | ← FT232H C0-C7（3.3V）| 数据输入 |
| LE (P11) | → VCC（常透明）| 纯缓冲 |
| /OE (P1) | → GND | 常输出 |
| Q0-Q7 (P2,5,7,9,12,15,17,19) | → 总线 D0-D7（5V）| → U1.D, U2-U9.D |
| VCC (P20) | → +5V | |
| GND (P10) | → GND | |

---

## 六、U0b — 74LS373（电平转换：4 位控制）

| Pin | 信号 | 连接 |
|-----|---|---|
| D0 (P3) | ← FT232H D4（A0）| |
| D1 (P4) | ← FT232H D5（/WR）| |
| D2 (P6) | ← FT232H D6（/RST）| |
| D3 (P8) | ← FT232H D7（/CS）| |
| LE (P11) | → VCC（常透明）| |
| /OE (P1) | → GND | |
| Q0 (P2) | → A0（5V）→ U10.A2, U11.B3 | |
| Q1 (P5) | → WR_n（5V）→ U11.B2, U11.B4 | |
| Q2 (P7) | → rst_n（5V）→ 通道层 MR/CLR | |
| Q3 (P9) | → CS_n（5V）→ U10.A1 | |
| VCC (P20) | → +5V | |
| GND (P10) | → GND | |

---

## 七、U10 — 74HC04（NOT(/CS)、NOT(A0)）

| Pin | 信号 | 连接 |
|-----|---|---|
| 1 (A1) | ← CS_n（U0b.Q3）| |
| 2 (Y1) | → cs_active | → U11.A1, U11.A3 |
| 3 (A2) | ← A0（U0b.Q0）| |
| 4 (Y2) | → a0_n | → U11.B1 |
| 5,6 (A3,Y3) | → GND, 悬空 | 余门不用 |
| 9,8 (A4,Y4) | → GND, 悬空 | |
| 11,10 (A5,Y5) | → GND, 悬空 | |
| 13,12 (A6,Y6) | → GND, 悬空 | |
| 14 | VCC | +5V |
| 7 | GND | GND |

---

## 八、U11 — 74HC08（addr_cp + data_strobe）

| Pin | 信号 | 连接 |
|-----|---|---|
| 1 (A1) | ← cs_active（U10.Y1）| |
| 2 (B1) | ← a0_n（U10.Y2）| |
| 3 (Y1) | t1 = cs AND a0_n | → U11.A2 |
| 4 (A2) | ← t1（U11.Y1）| |
| 5 (B2) | ← WR_n（U0b.Q1）| |
| 6 (Y2) | **addr_cp** | → U1.CP |
| 9 (A3) | ← cs_active（U10.Y1）| |
| 10 (B3) | ← A0（U0b.Q0）| |
| 8 (Y3) | t2 = cs AND A0 | → U11.A4 |
| 12 (A4) | ← t2（U11.Y3）| |
| 13 (B4) | ← WR_n（U0b.Q1）| |
| 11 (Y4) | **data_strobe** | → U12.B1/B2/B3/B4, U13.B1/B2/B3/B4 |
| 14 | VCC | +5V |
| 7 | GND | GND |

---

## 九、U1 — 74HC374（地址锁存，边沿）

⚠️ HC374 D/Q 交错排列（rev.a 核对 Nexperia datasheet）：
D0-D7 = P3,4,7,8,13,14,17,18；Q0-Q7 = P2,5,6,9,12,15,16,19。

| Pin | 信号 | 连接 |
|-----|---|---|
| 1 (/OE) | → GND | 常输出 |
| 11 (CP) | ← addr_cp（U11.Y2=P6）| /WR↑ + A0=0 锁地址 |
| 3 (D0) | ← 总线 D0（U0a.Q0=P2）| 独热码 bit0 |
| 4 (D1) | ← 总线 D1（U0a.Q1=P5）| 独热码 bit1 |
| 7 (D2) | ← 总线 D2（U0a.Q2=P7）| 独热码 bit2 |
| 8 (D3) | ← 总线 D3（U0a.Q3=P9）| 独热码 bit3 |
| 13 (D4) | ← 总线 D4（U0a.Q4=P12）| 独热码 bit4 |
| 14 (D5) | ← 总线 D5（U0a.Q5=P15）| 独热码 bit5 |
| 17 (D6) | ← 总线 D6（U0a.Q6=P16）| 独热码 bit6 |
| 18 (D7) | ← 总线 D7（U0a.Q7=P19）| 独热码 bit7 |
| 2 (Q0) | → ADDR[0] | → U12.A1（P1）|
| 5 (Q1) | → ADDR[1] | → U12.A2（P4）|
| 6 (Q2) | → ADDR[2] | → U12.A3（P9）|
| 9 (Q3) | → ADDR[3] | → U12.A4（P12）|
| 12 (Q4) | → ADDR[4] | → U13.A1（P1）|
| 15 (Q5) | → ADDR[5] | → U13.A2（P4）|
| 16 (Q6) | → ADDR[6] | → U13.A3（P9）|
| 19 (Q7) | → ADDR[7] | → U13.A4（P12）|
| 20 | VCC | +5V |
| 10 | GND | GND |

---

## 十、U12 — 74HC08（reg_cp[0-3]）

| Pin | 信号 | 连接 |
|-----|---|---|
| 1 (A1) | ← ADDR[0]（U1.Q0）| |
| 2 (B1) | ← data_strobe（U11.Y4）| |
| 3 (Y1) | reg_cp[0] | → U2.CP（reg0 = CH0 period）|
| 4 (A2) | ← ADDR[1]（U1.Q1）| |
| 5 (B2) | ← data_strobe | |
| 6 (Y2) | reg_cp[1] | → U3.CP（reg1 = CH0 控制）|
| 9 (A3) | ← ADDR[2]（U1.Q2）| |
| 10 (B3) | ← data_strobe | |
| 8 (Y3) | reg_cp[2] | → U4.CP（reg2 = 噪音控制）|
| 12 (A4) | ← ADDR[3]（U1.Q3）| |
| 13 (B4) | ← data_strobe | |
| 11 (Y4) | reg_cp[3] | → U5.CP（reg3，预留）|
| 14 | VCC | +5V |
| 7 | GND | GND |

---

## 十一、U13 — 74HC08（reg_cp[4-7]）

结构同 U12。A 输入接 ADDR[4-7]（U1.Q4-Q7），B 输入全接 data_strobe。

| 门 | 输出 | → |
|----|---|---|
| 门1 (Y1) | reg_cp[4] | U6.CP（reg4，预留）|
| 门2 (Y2) | reg_cp[5] | U7.CP（reg5，预留）|
| 门3 (Y3) | reg_cp[6] | U8.CP（reg6，预留）|
| 门4 (Y4) | reg_cp[7] | U9.CP（reg7，预留）|

---

## 十二、U2-U9 — 74HC374 ×8（数据寄存器）

⚠️ 所有 HC374 D/Q 交错排列（同 U1）：D0-D7=P3,4,7,8,13,14,17,18；Q0-Q7=P2,5,6,9,12,15,16,19。

### 通用引脚（8 片都一样）

| Pin | 连接 |
|-----|---|
| 1 (/OE) | → GND（常输出）|
| 3 (D0) | ← 总线 D0（U0a.Q0=P2）|
| 4 (D1) | ← 总线 D1（U0a.Q1=P5）|
| 7 (D2) | ← 总线 D2（U0a.Q2=P7）|
| 8 (D3) | ← 总线 D3（U0a.Q3=P9）|
| 13 (D4) | ← 总线 D4（U0a.Q4=P12）|
| 14 (D5) | ← 总线 D5（U0a.Q5=P15）|
| 17 (D6) | ← 总线 D6（U0a.Q6=P16）|
| 18 (D7) | ← 总线 D7（U0a.Q7=P19）|
| 20 | VCC → +5V |
| 10 | GND |

### 各寄存器 CP 和 Q 去向

**U2（reg0 = CH0 period，方波频率）**：CP=P11 ← reg_cp[0]（U12.Y1=P3）

| Q Pin | 信号 | 去向（方波通道）|
|---|---|---|
| 2 (Q0) | period[0] | → U20.D0（HC161 低 4 位）|
| 5 (Q1) | period[1] | → U20.D1 |
| 6 (Q2) | period[2] | → U20.D2 |
| 9 (Q3) | period[3] | → U20.D3 |
| 12 (Q4) | period[4] | → U21.D0（HC161 高 4 位）|
| 15 (Q5) | period[5] | → U21.D1 |
| 16 (Q6) | period[6] | → U21.D2 |
| 19 (Q7) | period[7] | → U21.D3 |

**U3（reg1 = CH0 控制，方波音色）**：CP=P11 ← reg_cp[1]（U12.Y2=P6）

| Q Pin | 信号 | 去向（方波通道）|
|---|---|---|
| 2 (Q0) | vol[0] | → U27.DB4（TLC7524 P7）|
| 5 (Q1) | vol[1] | → U27.DB5（TLC7524 P6）|
| 6 (Q2) | vol[2] | → U27.DB6（TLC7524 P5）|
| 9 (Q3) | vol[3] | → U27.DB7（TLC7524 P4）|
| 12 (Q4) | duty_sel[0] | → U25.A（HC153 P2）|
| 15 (Q5) | duty_sel[1] | → U25.B（HC153 P9）|
| 16 (Q6) | mode_sel | → U26.S0（HC4053 P11）|
| 19 (Q7) | ref_sel | → U26.S2（HC4053 P9）|

**U4（reg2 = 噪音控制）**：CP=P11 ← reg_cp[2]（U12.Y3=P8）

| Q Pin | 信号 | 去向（噪音通道，位号见 wiring-table-noise.md）|
|---|---|---|
| 2 (Q0) | vol[0] | → 噪音 TLC7524 DB4 |
| 5 (Q1) | vol[1] | → 噪音 TLC7524 DB5 |
| 6 (Q2) | vol[2] | → 噪音 TLC7524 DB6 |
| 9 (Q3) | vol[3] | → 噪音 TLC7524 DB7 |
| 12 (Q4) | freq_sel[0] | → 噪音 HC153 A |
| 15 (Q5) | freq_sel[1] | → 噪音 HC153 B |
| 16 (Q6) | bind | → 噪音 HC00 (绑定 2选1) |
| 19 (Q7) | 预留 | 悬空 |

**U5（reg3 = 波形 period[7:0]，v0.5 新）**：CP=P11 ← reg_cp[3]（U12.Y4=P11）

| Q Pin | 信号 | 去向（波形通道，位号见 wiring-table-uni.md）|
|---|---|---|
| 2 (Q0) | period12[0] | → 波形 HC161 低 4 位 D0 |
| 5 (Q1) | period12[1] | → 波形 HC161 低 4 位 D1 |
| 6 (Q2) | period12[2] | → 波形 HC161 低 4 位 D2 |
| 9 (Q3) | period12[3] | → 波形 HC161 低 4 位 D3 |
| 12 (Q4) | period12[4] | → 波形 HC161 中 4 位 D0 |
| 15 (Q5) | period12[5] | → 波形 HC161 中 4 位 D1 |
| 16 (Q6) | period12[6] | → 波形 HC161 中 4 位 D2 |
| 19 (Q7) | period12[7] | → 波形 HC161 中 4 位 D3 |

**U6（reg4 = 波形 period[11:8] | vol，v0.5 新）**：CP=P11 ← reg_cp[4]（U13.Y1=P3）

| Q Pin | 信号 | 去向（波形通道，位号见 wiring-table-uni.md）|
|---|---|---|
| 2 (Q0) | vol[0] | → 波形 TLC7524#2 DB4 |
| 5 (Q1) | vol[1] | → 波形 TLC7524#2 DB5 |
| 6 (Q2) | vol[2] | → 波形 TLC7524#2 DB6 |
| 9 (Q3) | vol[3] | → 波形 TLC7524#2 DB7 |
| 12 (Q4) | period12[8] | → 波形 HC161 高 4 位 D0 |
| 15 (Q5) | period12[9] | → 波形 HC161 高 4 位 D1 |
| 16 (Q6) | period12[10] | → 波形 HC161 高 4 位 D2 |
| 19 (Q7) | period12[11] | → 波形 HC161 高 4 位 D3 |

**U7（reg5 = 波形 duty(bit0-3) | mode(bit4) | wave(bit5-6) | 预留(bit7)，v0.5 新）**：CP=P11 ← reg_cp[5]（U13.Y2=P6）

| Q Pin | 信号 | 去向（波形通道，位号见 wiring-table-uni.md）|
|---|---|---|
| 2 (Q0) | duty[0] | → 波形 HC283 A1 + HC08 门1B |
| 5 (Q1) | duty[1] | → 波形 HC283 A2 + HC08 门2B |
| 6 (Q2) | duty[2] | → 波形 HC283 A3 + HC08 门3B |
| 9 (Q3) | duty[3] | → 波形 HC283 A4 + HC08 门4B |
| 12 (Q4) | mode_sel | → 波形 HC157 P1 (Select) |
| 15 (Q5) | wave_sel[0]=fold | → 波形 U23 门4 (~fold 反相) |
| 16 (Q6) | wave_sel[1]=dir | → 波形 U23 门3 (~dir 反相) |
| 19 (Q7) | 预留 | 悬空 |

**U8（reg6，预留）**：CP=P11 ← reg_cp[6]（U13.Y3=P8），Q 全悬空。

**U9（reg7，预留）**：CP=P11 ← reg_cp[7]（U13.Y4=P11），Q 全悬空。

---

## 十三、与通道层的接口（信号交接）

接口层向通道层输出的信号：

| 信号 | 来源 | 去向 |
|---|---|---|
| reg0.Q[7:0] | U2 | → 方波通道 period |
| reg1.Q[7:0] | U3 | → 方波通道 vol(bit0-3)/duty(bit4-5)/mode(bit6)/ref(bit7) |
| reg2.Q[7:0] | U4 | → 噪音通道 vol(bit0-3)/freq(bit4-5)/bind(bit6) |
| reg3.Q[7:0] | U5 | → 波形通道 period12[7:0] |
| reg4.Q[7:0] | U6 | → 波形通道 period12[11:8](bit4-7)/vol(bit0-3) |
| reg5.Q[7:0] | U7 | → 波形通道 duty(bit4-7)/wave(bit2-3)/mode(bit1)/预留(bit0) |
| rst_n | U0b.Q2 | → 通道层所有 MR/CLR |
| sq_tc（方波→噪音绑定）| 方波通道 HC161 TC | → 噪音通道 HC00（绑定模式时钟源）|

> sq_tc 是方波通道向噪音通道的跨通道信号（绑定模式用）。
> ⚠️ **必须经 HC00 反相器隔离**（2026-07-08 上板发现）：直连会反向干扰方波。详见噪音通道接线表。
> v0.5 新增: reg3/4/5 → 波形通道 (三通道并存, 各自独立 TLC7524 输出)。

---

## 十四、写时序（FT232H 上位机）

```
写 reg[n] = data（完整事务）:

/CS = 0                           // 事务开始
bus = (1<<n); A0=0; /WR ↓→↑       // 第 1 拍: 写地址
bus = data;   A0=1; /WR ↓→↑       // 第 2 拍: 写数据
/CS = 1                           // 事务结束
```

---

## 十五、电源

每片 VDD 就近加 0.1μF 去耦。所有 GND 共地。

| 芯片 | VDD | GND |
|---|-----|-----|
| LS373 (U0a/U0b) | P20 | P10 |
| HC374 (U1-U9) | P20 | P10 |
| HC08 (U11/U12/U13) | P14 | P7 |
| HC04 (U10) | P14 | P7 |
