denjhang/74HC-Chiptune/psg_voice/PSG2 v0.3/docs/wiring-table-rev-a.md

# PSG2 v0.3 噪音通道接线表 rev.a (HC374 版)

> **rev.a vs 原版 (wiring-table.md 第十一节) 的区别**:
> - LFSR 主体: HC164 → **HC374** (原版 HC164 启动电路缺陷致锁死, **不是芯片问题** —
>   2026-07-08 实测国产 HC164 也能用, 之前失败完全是启动电路的锅)
> - 反馈: CD4070 (不变, 与 HC86 功能等效)
> - 启动逻辑: **HC00 门3 + 2×0.1μF 电容构成张弛振荡器, 持续注入 D[0] 防锁死** (0 额外芯片)
>   (原方案 RC 上电一次性脉冲, 实测频繁切频率会锁死; 振荡器方案持续注入, 稳定)
> - 芯片数: 7 片 (持平)
>
> rev.a 只改噪音通道 (CH1). 方波通道 (CH0) 接线不变, 见原版 wiring-table.md.

---

## 一、芯片清单 (噪音通道 CH1, HC374 版)

| 位号 | 型号 | 功能 | vs 原版 |
|---|---|---|---|
| **U12** | **CD4070** | **白噪反馈 Q7⊕Q5⊕Q4⊕Q3 (门1-3), 门4 闲置** | 不变 (与 HC86 功能等效, 引脚不同) |
| **U13** | **74HC374** | **8 位 LFSR 主体 (D 触发器阵列, D[0]=反馈/启动, D[1-7]=移位)** | **替代 HC164** |
| U14 | 74HC161 | 独立分频 (64kHz ÷2/÷4/÷8/÷16) | 不变 |
| U15 | 74HC153 | 频率选通 4 选 1 (上半部), 下半部关闭 | 不变 |
| U16 | 74HC374 | 噪音控制寄存器 (A1=D7 选通) | 不变 |
| U17 | TLC7524 | 噪音 DAC (REF=Q7) | 不变 |
| U18 | 74HC00 | 绑定 2 选 1 (4 门用满) | 不变 |
| **U4 (借)** | **74HC00** | **方波通道 HC00, 借门 2/3/4 做振荡防锁死 (门1 仍 PE 反相)** | **新增借用** |
| **U4 (借)** | **74HC00** | **方波通道 HC00, 借门 2/3/4 做振荡防锁死 (门1 仍 PE 反相)** | **新增借用** |
| C1, C2 | 2 × 0.1μF (104) | HC00 门3 振荡器电容 (持续注入防锁死) | 新增 |

**噪音核心芯片: 7 片** (U12-U18). 防锁死借方波 U4, 0 额外芯片. + 2 电容 (0.1μF×2).

---

## 二、LFSR 结构 (HC374 八 D 触发器)

**与 HC164 的本质区别**: HC374 是边沿 D 触发器, D 输入独立; HC164 是串入并出, 只有 DSA/DSB 两个串入.
HC374 的每位 D 单独可控, 上电启动逻辑可强制 D[0]=1 (HC164 做不到, 它的串入由反馈独占).

**LFSR 接法 (XOR 反馈, max-length 8 位, 周期 255)**:

```
D[0] ← 启动逻辑 (RC 覆盖 + feedback, 见第六节)
D[1] ← Q[0]    (移位: 前级 Q → 下级 D)
D[2] ← Q[1]
D[3] ← Q[2]
D[4] ← Q[3]
D[5] ← Q[4]
D[6] ← Q[5]
D[7] ← Q[6]

feedback (CD4070 门1-3) = Q[7] ⊕ Q[5] ⊕ Q[4] ⊕ Q[3]
```

**工作过程**:
1. 上电: RC 脉冲维持 ~5ms, D[0] 强制=1, LFSR 在 noise_clk 驱动下被 1 填满
2. RC 充电后 (~5ms): D[0] 切回 feedback, max-length LFSR 自持 (非 0 永不归零)
3. 永不锁死

---

## 三、U16 — 74HC374 (噪音控制寄存器)

> (与原版相同, 不变)

A1 (FT232H D7) 选通, CP 上升沿锁存.

**控制字格式** (bit0-3 音量, 与方波风格统一):
```
bit0-3: 音量 (16 级, Q0-Q3 → DB4-7)
bit4-5: 频率挡 (00=÷2 / 01=÷4 / 10=÷8 / 11=÷16, 仅独立模式)
bit6:   绑定开关 (0=独立分频 / 1=直通 square_tc)
bit7:   预留
```

| Pin | 信号 | 连接 |
|-----|---|---|
| 1 (/OE) | → GND | 常输出 |
| 11 (CP) | ← **A1 (FT232H D7 经 LS373)** | 写脉冲 |
| 9 (D0) | ← FT232H C0 | 音量 bit0 |
| 8 (D1) | ← FT232H C1 | 音量 bit1 |
| 7 (D2) | ← FT232H C2 | 音量 bit2 |
| 6 (D3) | ← FT232H C3 | 音量 bit3 |
| 5 (D4) | ← FT232H C4 | 频率挡 bit0 |
| 4 (D5) | ← FT232H C5 | 频率挡 bit1 |
| 3 (D6) | ← FT232H C6 | 绑定开关 |
| 2 (D7) | → GND | 预留 |
| 2 (Q0) | → U17.DB4 | 音量 |
| 5 (Q1) | → U17.DB5 | 音量 |
| 6 (Q2) | → U17.DB6 | 音量 |
| 9 (Q3) | → U17.DB7 | 音量 |
| 12 (Q4) | → U15.A (HC153 地址 bit0) | 频率挡 |
| 15 (Q5) | → U15.B (HC153 地址 bit1) | 频率挡 |
| 16 (Q6) | → U18 门1 输入 (bind 信号) | 绑定开关 |
| 19 (Q7) | 悬空 | 预留 |
| 20 | VCC | +5V |
| 10 | GND | GND |

---

## 四、U14 — 74HC161 (独立分频器)

> (与原版相同, 不变)

自由计数 (CEP/CET=1), 64kHz ÷2/÷4/÷8/÷16.

| Pin | 信号 | 连接 |
|-----|---|---|
| 1 (MR) | → +5V | 不清零 (自由跑) |
| 2 (CP) | ← **clk (64kHz 全局晶振)** | 计数时钟 |
| 7 (CEP) | → +5V | 常使能 |
| 10 (CET) | → +5V | 常使能 |
| 9 (PE) | → +5V | 不预置 |
| 3-5,14 (D0-D3) | → GND | 不预置 |
| 6 (Q0) | → U15.1C0 | ÷2 |
| 11 (Q1) | → U15.1C1 | ÷4 |
| 12 (Q2) | → U15.1C2 | ÷8 |
| 13 (Q3) | → U15.1C3 | ÷16 |
| 15 (TC) | 悬空 | 不用 |
| 16 | VCC | +5V |
| 8 | GND | GND |

---

## 五、U15 — 74HC153 (频率选通 4 选 1, 只用上半部)

> (与原版相同, 不变. 绑定 2 选 1 仍走 U18 HC00, 不用 HC153 下半部)

只用上半部 (下半部 2G_n=1 关闭). 地址 A/B = U16.Q4/Q5 (频率挡 bit4-5).

| Pin | 信号 | 连接 |
|-----|---|---|
| 1 (1G_n) | → GND | 上半部常开 |
| 2 (A) | ← U16.Q4 | 频率地址 bit0 |
| 3 (1C3) | ← U14.Q3 | ÷16 |
| 4 (1C2) | ← U14.Q2 | ÷8 |
| 5 (1C1) | ← U14.Q1 | ÷4 |
| 6 (1C0) | ← U14.Q0 | ÷2 |
| 7 (1Y) | ind_clk (独立分频时钟) | → **U18.A2 (HC00 门2 输入, Pin4)** |
| 8 | GND | GND |
| 9 (B) | ← U16.Q5 | 频率地址 bit1 |
| 10 (2Y) | — | 悬空 |
| 11 (2C3) | → GND | 不用 |
| 12 (2C2) | → GND | 不用 |
| 13 (2C1) | → GND | 不用 |
| 14 (2C0) | → GND | 不用 |
| 15 (2G_n) | → +5V | 下半部关闭 |
| 16 | VCC | +5V |

---

## 六、U12 — CD4070 (XOR 反馈)

> 用门 1-3 做 XOR 反馈, 门 4 闲置 (启动逻辑走 U4 HC00, 见第八节).
> CD4070 与 HC86 功能等效 (都是四 2 输入 XOR), 但**引脚布局不同** (CLAUDE.md 7.4 节).
> 本表据 CD4070 引脚, 不可混用 HC86 接线.

**CD4070 引脚** (据 TI CD4070B Rev.E DIP-14 datasheet, 85bb480 commit 核对):
```
Pin  1: 1A   Pin 14: VDD (+3~18V)
Pin  2: 1B   Pin 13: 4B
Pin  3: 1Y   Pin 12: 4A
Pin  4: 2Y   Pin 11: 4Y
Pin  5: 2A   Pin 10: 3Y
Pin  6: 2B   Pin  9: 3B
Pin  7: VSS  Pin  8: 3A
```

⚠️ 门 2/3 的 A/B/Y 脚位与 HC86 不同 (4000 系列典型布局, 门 2/4 的 A/B 顺序反).

**门分配**:
| 门 | 功能 | Pin (输入→输出) |
|----|---|---|
| 门1 | Q7⊕Q5 (xor_a) | A=1, B=2 → Y=3 |
| 门2 | Q4⊕Q3 (xor_b) | A=5, B=6 → Y=4 |
| 门3 | (Q7⊕Q5)⊕(Q4⊕Q3) = feedback | A=8, B=9 → Y=10 |
| 门4 | 闲置 | A=12, B=13 → Y=11 (接 GND, 悬空) |

**逐脚表**:

| Pin | 信号 | 连接 |
|-----|---|---|
| 1 (1A) | ← U13.Q7 (LFSR 第 7 位输出) | 门1 输入 a |
| 2 (1B) | ← U13.Q5 | 门1 输入 b |
| 3 (1Y) | xor_a (Q7⊕Q5) | → U12.8 (门3 输入 a) |
| 5 (2A) | ← U13.Q4 | 门2 输入 a |
| 6 (2B) | ← U13.Q3 | 门2 输入 b |
| 4 (2Y) | xor_b (Q4⊕Q3) | → U12.9 (门3 输入 b) |
| 8 (3A) | ← U12.3 (xor_a) | 门3 输入 a |
| 9 (3B) | ← U12.4 (xor_b) | 门3 输入 b |
| 10 (3Y) | **feedback (Q7⊕Q5⊕Q4⊕Q3)** | → **U4 门2 (HC00 反相输入, Pin 4,5)** |
| 12 (4A), 13 (4B) | → GND | 门4 闲置 |
| 11 (4Y) | — | 悬空 |
| 14 | VDD | +5V |
| 7 | VSS | GND |

---

## 七、U13 — 74HC374 (LFSR 主体, 替代 HC164)

> ⚠️ HC374 DIP-20, 比 HC164 (DIP-14) 多 6 脚, 面包板占位大.

8 位 D 触发器阵列, 共享 CP (noise_clk). /OE 接 GND (常输出).
所有 D 输入按 LFSR 移位规则连接 (D[i+1] ← Q[i]).

**74HC374 引脚** (Nexperia 74HC_HCT374 datasheet 5.2 节 Pin description, 核对 2026-07-07):
```
Pin  1: /OE  Pin 11: CP (上升沿触发)
Pin  2: Q0   Pin 12: Q4
Pin  3: D0   Pin 13: D4
Pin  4: D1   Pin 14: D5
Pin  5: Q1   Pin 15: Q5
Pin  6: Q2   Pin 16: Q6
Pin  7: D2   Pin 17: D6
Pin  8: D3   Pin 18: D7
Pin  9: Q3   Pin 19: Q7
Pin 10: GND  Pin 20: VCC
```
⚠️ D 和 Q 交错排列. D 在 Pin 3,4,7,8,13,14,17,18; Q 在 Pin 2,5,6,9,12,15,16,19.
（Nexperia 原文: D0-D7 = 3,4,7,8,13,14,17,18; Q0-Q7 = 2,5,6,9,12,15,16,19）

**逐脚表**:

| Pin | 信号 | 连接 | 说明 |
|-----|---|---|---|
| 1 (/OE) | → GND | 常输出 | |
| 11 (CP) | ← **U18.Y4 (HC00 门4 noise_clk, Pin 11)** | LFSR 移位时钟 | |
| 3 (D0) | ← **U4.Y4 (HC00 门4 = feedback OR RC启动, Pin 11)** | D[0] = 启动覆盖后的反馈 | ⭐ 核心 |
| 4 (D1) | ← U13.Q0 (Pin 2) | D[1] = Q[0] (移位) | |
| 7 (D2) | ← U13.Q1 (Pin 5) | D[2] = Q[1] | |
| 8 (D3) | ← U13.Q2 (Pin 6) | D[3] = Q[2] | |
| 13 (D4) | ← U13.Q3 (Pin 9) | D[4] = Q[3] | |
| 14 (D5) | ← U13.Q4 (Pin 12) | D[5] = Q[4] | |
| 17 (D6) | ← U13.Q5 (Pin 15) | D[6] = Q[5] | |
| 18 (D7) | ← U13.Q6 (Pin 16) | D[7] = Q[6] | |
| 2 (Q0) | → U13.D1 (Pin 4) | 移位链 | |
| 5 (Q1) | → U13.D2 (Pin 7) | 移位链 | |
| 6 (Q2) | → U13.D3 (Pin 8) | 移位链 | |
| 9 (Q3) | → U13.D4 (Pin 13) + **U12.6 (CD4070 门2 输入 2B)** | 移位 + 反馈 tap (Q3) | |
| 12 (Q4) | → U13.D5 (Pin 14) + **U12.5 (CD4070 门2 输入 2A)** | 移位 + 反馈 tap (Q4) | |
| 15 (Q5) | → U13.D6 (Pin 17) + **U12.2 (CD4070 门1 输入 1B)** | 移位 + 反馈 tap (Q5) | |
| 16 (Q6) | → U13.D7 (Pin 18) | 移位链 | |
| 19 (Q7) | → **U12.1 (CD4070 门1 输入 1A) + U17.REF (TLC7524 Pin15)** | 反馈 tap (Q7) + 噪音输出 | |
| 20 | VCC | +5V | |
| 10 | GND | GND | |

> **LFSR 反馈多项式**: feedback = Q7⊕Q5⊕Q4⊕Q3 (max-length, 周期 255).
> HC374 无 MR 脚, 不能异步清零 — 但靠 U4 振荡器持续注入 D[0], 永不锁死 (见第八节).

---

## 八、U4 借用 — HC00 门 2/3/4 (振荡注入防锁死)

> 方波通道 U4 (HC00) 门1 做 PE 反相 (v0.2 用), **门 2/3/4 借给噪音做防锁死**.
>
> ⚠️ **方案演进** (2026-07-07 实测):
> - 原方案: RC 上电一次性脉冲 (47kΩ+0.1μF), 只在上电时灌种.
>   实测问题: **频繁切换频率挡会锁死** (noise_clk 突变时 HC374 落入非常规态, RC 已放电无法再次触发).
> - 新方案: **HC00 反相器 + 电容构成张弛振荡器, 持续给 D[0] 注入抖动**, 永不锁死.
>   实测稳定运行几分钟无问题, 频繁切频率挡不再锁死.

**振荡器原理** (HC00 门3 反相器 + 电容):

HC00 门3 输入短接当反相器 (Pin 9,10 并联 → Pin 8 反相输出).
**两个 0.1μF 电容** (104):
- **电容 C1**: 并联在门3 的输入输出之间 (Pin 9/10 ↔ Pin 8) — 形成正反馈回路
- **电容 C2**: 并联在门3 的两个输入之间 (Pin 9 ↔ Pin 10) — 加强振荡稳定性

反相器 + 电容构成**张弛振荡器**: 电容充放电让输入在阈值附近反复跳变,
反相器持续输出方波脉冲 (不是上电一次性, 是持续振荡).
这个振荡信号 (NOT 节点) 经门4 注入 D[0], LFSR 永远无法收敛到死锁态.

**效果**: 等于给 LFSR 的 D[0] 注入持续的模拟抖动, LFSR 变成"半模拟半数字"噪声源.
比纯数字 LFSR (靠 max-length 防锁死) 更鲁棒, 比 mode 白噪 (采样竞争) 更可控
(LFSR 结构还在, 频率挡/绑定仍有效).

**⚠️ 本质揭露 (2026-07-07 用户实测)**:
用户把 RC 节点直接接音响, 听到**小声白噪** — 说明这个"振荡器"**根本就是个模拟噪声源**.
HC00 反相器 + 0.1μF 电容的时间常数极小, 振荡在 MHz 级, 输出是**宽带噪声** (不是干净方波).

所以这套方案的真相是: **LFSR 退化成"模拟噪声采样器"**.
- 每个 noise_clk 上升沿, HC374 采一个模拟噪声的瞬时值 (高/低) 到 D[0]
- LFSR 的移位/反馈结构提供"数字骨架" (输出有数字味道)
- 但 D[0] 是真随机 (物理噪声), 不是 LFSR 自己算出来的反馈
- **永远不可能锁死** — D[0] 是真随机, 不可能收敛到固定值

**为什么"频繁切频率挡锁死"问题消失了**:
原 RC 上电脉冲方案: 脉冲放完, D[0]=feedback (纯数字 LFSR 演化),
**任意移位寄存器都会锁死** (不是国产芯片问题 — 这次用的原装 LS374 一样锁死,
之前 HC164 也是类似情况. 移位寄存器的纯数字 LFSR 在 noise_clk 突变时
会落入伪锁死态, 这是固有特性, 不是芯片质量问题).
新方案: D[0]=持续模拟噪声, **没有"纯数字演化"这个过程**, 不可能锁死.

**教训: 还是要有创新精神**:
纯数字 LFSR 的"max-length 防锁死"是数学理论, 硬件上不可靠 (任意移位寄存器都会锁死).
业界标准做法 (RC 灌种/全 0 检测/TR-909 启动逻辑) 都是补丁, 没有根治.
本项目的创新: **D[0] 注入模拟噪声, 让 LFSR 退化成采样器** — 绕过"防锁死"这个问题,
直接让它不可能锁死. 这是用 74 芯片的模拟特性 (HC00+电容=噪声源) 解决数字逻辑的死穴.

**三个噪声源的统一认知** (项目所有噪声方案, 都基于 HC161/HC00 非理想特性):

| 噪声源 | 原理 | 锁死风险 |
|---|---|---|
| mode 白噪 (bit6, 5.8.1) | HC00 延迟 + 7474 采样竞争 | 无 (reload 自持) |
| HC164/LS374 纯数字 LFSR (已弃用) | 纯数字伪随机 (max-length) | **高 (任意移位寄存器都会锁死, 不是芯片质量问题)** |
| **HC374 LFSR + RC 模拟噪声注入 (本方案)** | **LFSR 骨架 + D[0] 真随机种子** | **无 (物理随机)** |

本方案最优: 结合 LFSR 的可控性 (频率挡/绑定) 和模拟噪声的不可锁死性.

**门分配** (74HC00 DIP-14):

| 门 | 功能 | Pin (输入→输出) |
|----|---|---|
| 门1 | PE 反相 (v0.2 方波用, 不变) | 1,2 → 3 |
| 门2 | NOT(feedback) (输入短接当反相器) | 4,5 → 6 |
| 门3 | 振荡反相器 (输入短接 + 两电容) | 9,10 → 8 |
| 门4 | NAND(门2, 门3) = feedback OR OSC | 12,13 → 11 |

**电容连接** (2 × 0.1μF / 104):

| 电容 | 连接 | 作用 |
|---|---|---|
| **C1 (0.1μF)** | 门3 输入 (Pin 9/10) ↔ 门3 输出 (Pin 8) | 正反馈回路, 构成张弛振荡 |
| **C2 (0.1μF)** | 门3 Pin 9 ↔ Pin 10 (两输入间) | 加强振荡稳定性 |

> 两个电容都并联在门3 周围, 不接电阻 (靠 HC00 内部输出阻抗 + 电容充放振荡).

**逐脚表**:

| Pin | 信号 | 连接 | 说明 |
|-----|---|---|---|
| 1 (A1), 2 (B1) | ← tc_hi (方波) | 门1 PE 反相 (v0.2 不变) | |
| 3 (Y1) | pe_n | → 方波通道 (v0.2 不变) | |
| 4 (A2), 5 (B2) | ← **U12.10 (CD4070 feedback 输出)** | 门2 输入 (短接当反相器) | NOT(feedback) |
| 6 (Y2) | NOT(feedback) | → U4.13 (门4 输入 a) | |
| 9 (A3), 10 (B3) | **振荡节点** (两脚并联) | 门3 输入 (短接当反相器) + **C1/C2 电容接这里** | 振荡反相器输入 |
| 8 (Y3) | NOT(振荡节点) (持续振荡) | → U4.12 (门4 输入 b) + **C1 另一端** | 振荡反相器输出 |
| 12 (A4) | ← U4.6 (NOT feedback) | 门4 输入 a | |
| 13 (B4) | ← U4.8 (NOT 振荡) | 门4 输入 b | |
| 11 (Y4) | **feedback OR OSC (持续注入)** | → **U13.D0 (HC374 Pin 3)** | ⭐ 防锁死注入输出 |
| 14 | VCC | +5V | |
| 7 | GND | GND | |

**真值表验证**:

| 振荡节点 | NOT(振荡) (门3) | NOT(fb) (门2) | NAND (门4) | D[0] 含义 |
|---|---|---|---|---|
| 高 (振荡正半周) | 0 | x | NAND(x,0) = **1** | **注入 1** (破坏收敛) |
| 低 (振荡负半周) | 1 | NOT(fb) | NAND(NOT fb, 1) = **fb** | **正常反馈** |

> 振荡正半周强制 D[0]=1 (破坏任何收敛态), 负半周让 feedback 接管.
> 两半周交替, LFSR 既保持 max-length 演化, 又被周期性"踢出"死锁陷阱.

---

## 九、U18 — 74HC00 (绑定 2 选 1, 独立 1 片)

> (与原版相同, 不变. 4 门用满做绑定.)

**功能**: `noise_clk = bind ? square_tc : ind_clk`

| 门 | 功能 | Pin (输入→输出) |
|----|---|---|
| 门1 | ~bind 反相 (输入短接) | 1,2 → 3 |
| 门2 | 选通 ind_clk | 4,5 → 6 |
| 门3 | 选通 square_tc | 9,10 → 8 |
| 门4 | 汇总 → noise_clk | 12,13 → 11 |

**逐脚表**:

| Pin | 信号 | 连接 |
|-----|---|---|
| 1 (A1), 2 (B1) | ← U16.Q6 (bind) | 门1 输入 (短接当反相器) |
| 3 (Y1) | bind_n (~bind) | → U18.5 (门2 输入 b) |
| 4 (A2) | ← U15.1Y (ind_clk) | 门2 输入 a |
| 5 (B2) | ← U18.3 (bind_n) | 门2 输入 b |
| 6 (Y2) | n_ind | → U18.13 (门4 输入 a) |
| 9 (A3) | ← **square_tc (方波通道 TC)** | 门3 输入 a |
| 10 (B3) | ← U16.Q6 (bind) | 门3 输入 b |
| 8 (Y3) | n_tc | → U18.12 (门4 输入 b) |
| 12 (A4) | ← U18.6 (n_ind) | 门4 输入 a |
| 13 (B4) | ← U18.8 (n_tc) | 门4 输入 b |
| 11 (Y4) | **noise_clk** | → **U13.CP (HC374 Pin 11)** |
| 14 | VCC | +5V |
| 7 | GND | GND |

---

## 十、U17 — TLC7524 (噪音 DAC)

> (与原版相同, 不变)

REF = U13.Q7 (1-bit 噪音波形), DB4-7 = U16 音量码.

| Pin | 信号 | 连接 |
|-----|---|---|
| 1 (OUT1) | noise_out | → 耦合电容 → 运放 → 喇叭 (混音) |
| 2 (OUT2) | → GND | |
| 3 (GND) | → GND | |
| 4 (DB7) | ← U16.Q3 | 音量 bit3 |
| 5 (DB6) | ← U16.Q2 | 音量 bit2 |
| 6 (DB5) | ← U16.Q1 | 音量 bit1 |
| 7 (DB4) | ← U16.Q0 | 音量 bit0 |
| 8-11 (DB3-0) | → GND | 固定 0 |
| 12 (CS) | → GND | 常选通 |
| 13 (WR) | → GND | 常写入 |
| 14 (VDD) | → +5V | |
| 15 (REF) | ← **U13.Q7 (HC374 Pin 19, 噪音波形)** | |
| 16 (RFB) | → GND | |

---

## 十一、电源 (噪音通道芯片)

| 芯片 | VDD | GND |
|---|-----|-----|
| CD4070 (U12) | Pin 14 | Pin 7 |
| HC374 (U13) | Pin 20 | Pin 10 |
| HC161 (U14) | Pin 16 | Pin 8 |
| HC153 (U15) | Pin 16 | Pin 8 |
| HC374 (U16) | Pin 20 | Pin 10 |
| TLC7524 (U17) | Pin 14 | Pin 3 |
| HC00 (U18) | Pin 14 | Pin 7 |
| HC00 (U4, 借) | Pin 14 | Pin 7 |

> 每片 VDD 就近加 0.1μF 去耦. 所有 GND 共地.

---

## 十二、写时序 (FT232H, 噪音通道)

> (与原版相同)

| 操作 | FT232H 动作 |
|---|---|
| 写噪音控制 (音量+频率+绑定) | C0-C3=音量, C4-C5=频率, C6=绑定, **D7(A1) 上升沿 → U16 锁存** |
| 复位 | D6(RST) 拉低再拉高 |

---

## 待验证 (上板)

- [x] HC374 LFSR **上电不锁死** (2026-07-07 实测, 振荡注入方案)
- [x] **频繁切频率挡不锁死** (2026-07-07 实测, 振荡注入方案, 稳定几分钟无问题)
- [x] HC374 LFSR 一上电就出噪音 (2026-07-07 实测)
- [ ] CD4070 反馈 (Q7⊕Q5⊕Q4⊕Q3, 周期 255) 长时间稳定性
- [ ] 4 挡频率 (÷2/4/8/16) 音色
- [ ] 绑定模式 (C3-C7 跟随音高)
- [ ] CD4070 门2/3 引脚与 HC86 不同 (据 TI datasheet 核对, 见第六节)
- [ ] 借 U4 门 2/3/4 不影响方波通道 (门1 PE 反相独立)
- [x] ~~国产 HC374 vs 进口稳定性对比~~ → 2026-07-08 实测: **不是芯片问题, 国产 HC164 也能用**,
      失败完全因启动电路缺陷. HC374/LS374/HC164 都可以做 LFSR, 关键是启动电路.
