denjhang/74HC-Chiptune/psg_voice/PSG2 v0.3/docs/wiring-table.md

# PSG2 v0.3 接线表

> 基于 v0.2 方波通道，加**占空比扩展**（分频链 + AND 组合 + 4 选 1）。
> 噪音通道（CH1）见 design.md 第四章，接线后续补。
>
> 状态：方波占空比扩展 RTL + 仿真验证通过（2026-07-02），待上板实验。

---

## 一、芯片位置（方波通道 CH0，三层音色叠加）

| 位号 | 型号 | 功能 | vs v0.2 |
|---|---|---|---|
| U0 | 74LS373 | 电平转换层（FT232H 3.3V→5V）| 复用 |
| U1 | 74HC373 | period 锁存 | 复用 |
| U2 | 74HC161 | 计数器低 4 位 | 复用 |
| U3 | 74HC161 | 计数器高 4 位 | 复用 |
| U4 | 74HC00 | PE 反相（第1路）| 复用 |
| U5 | 74HCT74 | toggle（FF1 sync + FF2 出 Q1）| 复用 |
| U6 | 74HC374 | 音量 + 占空比 + mode + REF 地址 | **改动** |
| U7 | TLC7524 | 衰减器（REF=U11 HC4053 输出, DB=U10 占空比）| **改动** |
| **U8** | **74HC74** | **占空比分频链（FF3→Q2, FF4→Q3）** | **新增** |
| **U9** | **74HC08** | **占空比 AND 组合（门1-3）** | **新增** |
| **U10** | **74HC153** | **占空比 4 选 1（DB 路径，bit4-5）** | **新增** |
| **U11** | **74HC4053** | **2 路 SPDT: Z=REF切换(toggle/Q0), X=mode切换(tc_hi/pe_n)** | **新增** |
| 喇叭 | — | 接 U7.OUT1（经耦合电容+运放）| 外设 |

---

## 二、占空比扩展原理

v0.2 的 toggle_q（U5 Q1）是 50% 方波（频率 f）。占空比扩展在它后面加分频链：

```
Q1 (U5, 50%, f) ──→ FF3 (U8 半片, ÷2) ──→ Q2 (50%, f/2)
Q2 ──→ FF4 (U8 另半片, ÷2) ──→ Q3 (50%, f/4)

AND 组合 (U9):
  duty_50  = Q1                    (原频, 50%)
  duty_25  = Q1 AND Q2             (f/2, 25%)
  duty_625 = Q2 AND Q3             (f/4, 25% 变体)
  duty_125 = duty_25 AND Q3        (f/4, 12.5%)  ← 复用 duty_25

U10 (HC153) 4选1: bit0-1 选 duty_50/25/125/625 → U7.REF
```

| 挡位 | bit0-1 | 占空比 | 频率 | 实测（A4 period=183）|
|---|---|---|---|---|
| 0 | 00 | 50% | f（原频）| 438 Hz ✅ |
| 1 | 01 | 25% | f/2 | 219 Hz ✅ |
| 2 | 10 | 12.5% | f/4 | 110 Hz ✅ |
| 3 | 11 | 25% | f/4（变体）| 110 Hz ✅ |

> **特性**：占空比变窄时频率同步降低（每级÷2）。软件移调补偿（选窄挡时 period 减半回原音高）。
> **顺带扩展音域**：12.5%/25%@f/4 挡可下探到 C0（原 period 极限只能到 C3）。

---

## 三、U6 改动（HC374 加占空比位）

**v0.2 现状**（据 `psg_ft232h_v02.py` 驱动）：
- 软件：`self._c = vol & 0x0F` → 音量放 C 口低 4 位（C0-C3 = HC374 bit0-3）
- 硬件：HC374 Q0-Q3 → TLC7524 DB4-DB7

**v0.3 改动**：音量完全不动（bit0-3），占空比放 **bit4-5**（v0.2 这两位接地，现在启用）。

| Pin | v0.2 | v0.3 | 连接 |
|-----|---|---|---|
| 9 (D0) | 音量 bit0 | 音量 bit0（不变）| ← FT232H C0 |
| 8 (D1) | 音量 bit1 | 音量 bit1（不变）| ← FT232H C1 |
| 7 (D2) | 音量 bit2 | 音量 bit2（不变）| ← FT232H C2 |
| 6 (D3) | 音量 bit3 | 音量 bit3（不变）| ← FT232H C3 |
| 15 (D4) | GND | **占空比 bit0** | ← FT232H C4 |
| 14 (D5) | GND | **占空比 bit1** | ← FT232H C5 |
| 13 (D6) | GND | **mode_sel** | ← FT232H C6 |
| 12 (D7) | GND | **REF 选择 (ref_sel)** | ← FT232H C7 |
| 2 (Q0) | → U7.DB4 | → U7.DB4（不变）| 音量 |
| 3 (Q1) | → U7.DB5 | → U7.DB5（不变）| 音量 |
| 4 (Q2) | → U7.DB6 | → U7.DB6（不变）| 音量 |
| 5 (Q3) | → U7.DB7 | → U7.DB7（不变）| 音量 |
| 16 (Q4) | 悬空 | → **U10.A（HC153 地址 bit0）** | 占空比地址 |
| 17 (Q5) | 悬空 | → **U10.B（HC153 地址 bit1）** | 占空比地址 |
| 18 (Q6) | 悬空 | → **U11.S0（HC4053 开关 X 控制，Pin11）** | mode_sel |
| 19 (Q7) | 悬空 | → **U11.S2（HC4053 开关 Z 控制，Pin9）** | REF 选择 |

> ✅ **音量接线零改动**，v0.2 的 Q0-Q3→DB4-7 保持原样。
> 占空比 bit4-5（Q4-Q5）、mode bit6（Q6）、REF bit7（Q7）v0.3 新启用。

---

## 四、U8 — 74HC74（占空比分频链，新增）

双 D 触发器，两个都做 T 触发器（D=Q̄）分频。

| Pin | 信号 | 连接 |
|-----|---|---|
| 1 | /CLR1 | ← rst_n（或接 +5V，复位靠软件）|
| 2 | D1 | ← Q1_n（Pin 6，T 触发器接法）|
| 3 | CLK1 | ← **U5.Q1**（toggle_q，原方波输出）|
| 4 | /PRE1 | → +5V（不置位）|
| 5 | Q1 | → U9.A1（AND 输入，duty_25/duty_125 用）|
| 6 | Q1_n | → U8.D1（反馈）= Q2 信号 |
| 13 | /CLR2 | ← rst_n |
| 12 | D2 | ← Q2_n（Pin 8，T 触发器）|
| 11 | CLK2 | ← **U8.Q1**（U8 半片1 输出 Q2，级联）|
| 10 | /PRE2 | → +5V |
| 9 | Q2 | → U9.A2/A3（duty_625/duty_125 用）= Q3 信号 |
| 8 | Q2_n | → U8.D2（反馈）|
| 14 | VCC | +5V |
| 7 | GND | GND |

> **命名澄清**：U8 的 Q1（Pin5）= 分频链第 2 级 = **Q2**（相对原 toggle）。U8 的 Q2（Pin9）= 第 3 级 = **Q3**。
> 原方波（U5 toggle）= **Q1**（频率 f），U8 半片1 输出 = **Q2**（f/2），U8 半片2 输出 = **Q3**（f/4）。

---

## 五、U9 — 74HC08（占空比 AND 组合，新增）

四 2 输入与门，用 3 个，第 4 门闲置（接 GND，输出悬空）。

**信号定义**（先说清来源）：
- **Q1** = U5（HCT74）Pin 9，v0.2 原 toggle 输出（50% 方波，频率 f）
- **Q2** = U8（新 HC74）Pin 5，Q1 经 FF3 ÷2（50%，频率 f/2）
- **Q3** = U8（新 HC74）Pin 9，Q2 经 FF4 ÷2（50%，频率 f/4）

| 门 | 输入 | 输出 | 含义 |
|----|---|---|---|
| 门1 (Pin 1,2→3) | Q1, Q2 | duty_25 | 25%@f/2 |
| 门2 (Pin 4,5→6) | Q2, Q3 | duty_625 | 25%@f/4 变体 |
| 门3 (Pin 9,10→8) | duty_25, Q3 | duty_125 | 12.5%@f/4（复用 duty_25）|
| 门4 (Pin 12,13→11) | GND, GND | 闲置 | 接 GND，输出悬空 |

| Pin | 信号 | 连接 |
|-----|---|---|
| 1 (A1) | ← U5.P9（Q1）| duty_25 输入1 |
| 2 (B1) | ← U8.P5（Q2）| duty_25 输入2 |
| 3 (Y1) | duty_25 | → U10.1C1 + U9.P9（门3 复用）|
| 4 (A2) | ← U8.P5（Q2）| duty_625 输入1 |
| 5 (B2) | ← U8.P9（Q3）| duty_625 输入2 |
| 6 (Y2) | duty_625 | → U10.1C3 |
| 9 (A3) | ← U9.P3（duty_25）| duty_125 输入1 |
| 10 (B3) | ← U8.P9（Q3）| duty_125 输入2 |
| 8 (Y3) | duty_125 | → U10.1C2 |
| 12 (A4) | → GND | 闲置 |
| 13 (B4) | → GND | 闲置 |
| 11 (Y4) | — | 悬空 |
| 14 | VCC | +5V |
| 7 | GND | GND |

> **第 4 门闲置**：与门只能做 AND，第 4 个 AND 想不出有用功能（75% 占空比要 OR/德摩根，HC08 做不了）。
> 接 GND 输入 + 输出悬空最干净，强行用反而增加毛刺风险。

---

## 六、U10 — 74HC153（占空比 4 选 1，新增）

双 4 选 1 数据选择器，**只用上半部**（下半部闲置，2G_n=1 接 +5V 关闭）。
地址 A/B = U6.Q4/Q5（占空比挡 bit4-5）。

**74HC153 引脚**（据 Nexperia datasheet 查证 2026-07-02）：

| Pin | 信号 | 连接 |
|-----|---|---|
| 1 (1G_n) | → GND | 上半部常开（低有效使能）|
| 2 (A) | ← U6.Q4 | 占空比地址 bit0（=S0）|
| 3 (1C3) | ← U9.Y2（duty_625）| 挡位 11 |
| 4 (1C2) | ← U9.Y3（duty_125）| 挡位 10 |
| 5 (1C1) | ← U9.Y1（duty_25）| 挡位 01 |
| 6 (1C0) | ← U5.P9（Q1，duty_50）| 挡位 00 |
| 7 (1Y) | wave_out（占空比变体）| → **U11.HC4053 Z0（Pin12）** |
| 8 | GND | GND |
| 9 (B) | ← U6.Q5 | 占空比地址 bit1（=S1）|
| 10 (2Y) | — | 悬空（下半部不用）|
| 11 (2C3) | → GND | 不用 |
| 12 (2C2) | → GND | 不用 |
| 13 (2C1) | → GND | 不用 |
| 14 (2C0) | → GND | 不用 |
| 15 (2G_n) | → +5V | 下半部关闭（高电平无效）|
| 16 | VCC | +5V |

> **挡位映射**：{B,A} = {Q5,Q4} = {bit5,bit4}
> - 00 → 1C0 = duty_50（Q1 原频）
> - 01 → 1C1 = duty_25
> - 10 → 1C2 = duty_125
> - 11 → 1C3 = duty_625

---

## 六点五、U11 — 74HC4053（双 SPDT：REF 切换 + mode 切换，1 片搞定两个二选一）

三 SPDT 模拟开关，用 2 路（Z 切 REF，X 切 mode），Y 空闲。
**取代原 HC86**（mode 二选一）+ **承担 REF 切换**，1 片顶 2 片。

### 为什么能合并

HC86 原来做"tc_hi/pe_n 二选一"（mode 切换），HC4053 做"占空比变体/Q0 二选一"（REF 切换）。
**两个都是 2 选 1**，HC4053 有 3 路 SPDT（X/Y/Z），用 2 路刚好，省掉 HC86。

### 开关分配

| 开关 | 输入 0 (bit=0) | 输入 1 (bit=1) | 控制脚 | 输出 | 功能 |
|---|---|---|---|---|---|
| **Z** | HC153 占空比变体 (1Y) | Q0 抽头 | S2 (Pin9) ← bit7 | Z-COM → U7.REF | REF 选择 |
| **X** | tc_hi | pe_n | S0 (Pin11) ← bit6 | X-COM → U5 7474 FF1.D | mode 选择（方波/白噪）|
| Y | 悬空 | 悬空 | S1 (Pin10) → GND | — | 空闲 |

### 从 v0.2 改装

**第 1 步**：拆 v0.2 的两根线：
- U5.Q1（toggle）→ U7.REF 直连（REF 路径）
- tc_hi → U5 7474 FF1.D 直连（1D 路径）

**第 2 步**：插 U11（74HC4053），接 2 路 SPDT：
- Z0（Pin12）← U10.HC153 1Y（占空比变体）
- Z1（Pin13）← Q0 抽头（HC161 计数器最低位）
- Z-COM（Pin14）→ U7.REF（TLC7524 Pin15）
- X0（Pin14... 见逐脚表）← tc_hi
- X1 ← pe_n（U4 HC00 第1路输出）
- X-COM → U5 7474 FF1.D（取代原 tc_hi 直连）
- S2（Pin9）← U6.Q7（bit7，REF 控制）
- S0（Pin11）← U6.Q6（bit6，mode 控制）
- S1（Pin10）→ GND（Y 开关不用）
- E（Pin6）→ GND（常开）
- VCC（Pin16）→ +5V，GND（Pin8）→ GND，VEE（Pin7）→ GND

### 工作方式

**bit7（REF）**：0=占空比变体，1=Q0 抽头
**bit6（mode）**：0=tc_hi（方波），1=pe_n（白噪）

> **U5（7474）FF1 接线改动**：原 v0.2 是 D1 ← tc_hi，现在 D1 ← **U11 X-COM**。
> FF1 用 clk 同步采样，消毛刺（v0.1 验证原理）。
>
> **⚠️ 白噪是硬件物理延迟现象**：pe_n 经 HC00 + HC4053 传输门延迟，7474 采样落点随 period
> 微妙变化 → 白噪。iverilog 仿真复现不了（理想零延迟），只能上板实测。
> 详见 design.md 5.8 节。

---

## 六点六、U11 — 74HC4053 逐脚表（双 SPDT）

| Pin | 信号 | 连接 |
|-----|---|---|
| 12 (Z0) | ← U10.HC153 1Y（占空比变体）| duty50/25/125/625（bit7=0 选）|
| 13 (Z1) | ← Q0 抽头（HC161 最低位）| 调制泛音（bit7=1 选）|
| 14 (Z-COM) | → U7.REF（TLC7524 Pin15）| REF 输出 |
| 9 (S2) | ← U6.Q7（bit7）| 开关 Z 控制 |
| 15 (X0) | ← tc_hi | 方波（bit6=0 选）|
| 1 (X1) | ← pe_n（U4 HC00 第1路输出）| 白噪（bit6=1 选）|
| 2 (X-COM) | → U5 7474 FF1.D（Pin2）| reload 源输出 |
| 11 (S0) | ← U6.Q6（bit6）| 开关 X 控制 |
| 4 (Y0), 5 (Y1), 3 (Y-COM) | 悬空 | 开关 Y 不用 |
| 10 (S1) | → GND | 开关 Y 控制（不用）|
| 6 (E) | → GND | 使能（低有效，常开）|
| 16 (VCC) | → +5V | |
| 8 (GND) | → GND | |
| 7 (VEE) | → GND | 不用负电源 |

> **bit 真值**：
> - bit7=0 → Z-COM = Z0 = HC153 占空比变体
> - bit7=1 → Z-COM = Z1 = Q0 抽头（乘法调制）
> - bit6=0 → X-COM = X0 = tc_hi（方波）
> - bit6=1 → X-COM = X1 = pe_n（白噪）

### 为什么用 HC4053（不是 HC153 / 4066 / CD4099）

- **HC153 数字多路器**：会整形边沿，吃掉 Q0 高频谐波 → 丢失泛音 ❌
- **CD4066 模拟开关**：要独热码控制，2 选 1 要非门（库存没多余非门）❌
- **CD4099 + 4066**：2 片配合太复杂 ❌
- **HC4053 三 SPDT 模拟开关**：1 位控制 2 选 1，天然互斥（SPDT 不会两路同通），
  模拟通路保真，**1 片搞定** ✅

## 七、U7 改动（TLC7524 REF + DB 输入）

| Pin | v0.2 | v0.3 |
|-----|---|---|
| 15 (REF) | ← U5.Q1（toggle_q 固定）| ← **U11.HC4053 Z-COM（2 选 1: 占空比变体/Q0）** |
| 4-7 (DB4-7) | ← U6.Q0-Q3（音量）| **不变**（← U6.Q0-Q3 音量码）|

其余不变（OUT1→喇叭，DB0-3/RFB/CS/WR→GND）。

> **数据流（修正后，自洽）**：
> - REF = HC4053 选 "占空比变体（HC153 输出）" 或 "Q0 抽头"
> - DB4-7 = HC374 音量码（Q0-Q3，v0.2 不变）
> - DB0-3 = GND（固定 0，v0.2 不变）
> - 输出 = REF × (音量码/256)（乘法衰减，音量控制生效，和 v0.2 一致）
>
> **占空比变体经 REF 路径**（不是 DB 路径）：duty50/25/125/625 都是 1-bit 方波，
> 接 REF 当波形参考，DB 接音量码衰减幅度。**音量控制方案不变**（v0.2 已验证）。
> bit7=1 时 REF 切 Q0 抽头（Q0 调制），DB 仍是音量码，音量照常衰减。

---

## 八、控制字格式（HC374，8 bit）

```
bit0-3: 音量 (16 级, Q0-Q3 → DB4-7, 与 v0.2 一致)
bit4-5: 占空比挡 (00=50% / 01=25% / 10=12.5% / 11=25%@f/4变体)
bit6:   mode (0=方波, 1=白噪)  ← HC4053 开关 X
bit7:   REF 选择 (0=toggle 纯净方波, 1=Q0 乘法调制)  ← HC4053
```

驱动写入：`self._c = (vol & 0x0F) | ((duty & 0x03) << 4) | ((mode & 1) << 6) | ((ref & 1) << 7)`

## 九、写时序（FT232H）

| 操作 | FT232H 动作 |
|---|---|
| 写 period | C0-C7=period, D4(LE) 上升沿 → U1 锁存 |
| 写控制 | C0-C3=音量, C4-C5=占空比, C6=mode, D5(A0) 上升沿 → U6 锁存 |
| 选方波/白噪 | 写 bit6 = 0/1 |
| 选占空比挡 | 写 bit4-5 = 00/01/10/11 |
| 静音 | 写 bit0-3 = 0000 |
| 复位 | D6(RST) 拉低再拉高 |

---

## 十、电源（所有芯片）

| 芯片 | VDD | GND |
|---|-----|-----|
| 74LS373 (U0) | Pin 16 | Pin 8 |
| 74HC373 (U1) | Pin 20 | Pin 10 |
| 74HC161 (U2,U3) | Pin 16 | Pin 8 |
| 74HC00 (U4) | Pin 14 | Pin 7 |
| 74HCT74 (U5) | Pin 14 | Pin 7 |
| 74HC374 (U6) | Pin 20 | Pin 10 |
| TLC7524 (U7) | Pin 14 | Pin 3 |
| **74HC74 (U8)** | **Pin 14** | **Pin 7** |
| **74HC08 (U9)** | **Pin 14** | **Pin 7** |
| **74HC153 (U10)** | **Pin 16** | **Pin 8** |
| **74HC4053 (U11)** | **Pin 16** | **Pin 8** |

> 每片 VDD 就近加 0.1μF 去耦。所有 GND 共地。

---

## 十一、噪音通道（CH1）

LFSR 白噪音通道，6 片核心 + 1 片 HC00（独立，不借方波通道）。设计详见 `design.md` 第四章。

| 位号 | 型号 | 功能 |
|---|---|---|
| **U12** | **CD4070** | **白噪反馈 Q7⊕Q5⊕Q4⊕Q3（门1-3），门4 闲置** |
| **U13** | **HC164** | **8 位 LFSR 主体（MR 常接 +5V，靠上电随机值 + max-length 自持）** |
| **U14** | **HC161** | **独立分频（64kHz ÷2/÷4/÷8/÷16）** |
| **U15** | **HC153** | **频率选通 4 选 1（上半部），下半部关闭** |
| **U16** | **HC374** | **噪音控制寄存器（A1=D7 选通）** |
| **U17** | **TLC7524** | **噪音 DAC（REF=Q7）** |
| **U18** | **HC00** | **绑定 2 选 1（4 门用满，独立一片，不借方波 U4）** |

---

### U16 — 74HC374（噪音控制寄存器）

A1（FT232H D7）选通，CP 上升沿锁存。

**控制字格式**（与方波风格统一：音量在 bit0-3）：
```
bit0-3: 音量 (16 级, Q0-Q3 → DB4-7)
bit4-5: 频率挡 (00=÷2 / 01=÷4 / 10=÷8 / 11=÷16, 仅独立模式)
bit6:   绑定开关 (0=独立分频 / 1=直通 square_tc)
bit7:   预留
```

| Pin | 信号 | 连接 |
|-----|---|---|
| 1 (/OE) | → GND | 常输出 |
| 11 (CP) | ← **A1（FT232H D7 经 LS373）** | 写脉冲 |
| 9 (D0) | ← FT232H C0 | 音量 bit0 |
| 8 (D1) | ← FT232H C1 | 音量 bit1 |
| 7 (D2) | ← FT232H C2 | 音量 bit2 |
| 6 (D3) | ← FT232H C3 | 音量 bit3 |
| 5 (D4) | ← FT232H C4 | 频率挡 bit0 |
| 4 (D5) | ← FT232H C5 | 频率挡 bit1 |
| 3 (D6) | ← FT232H C6 | 绑定开关 |
| 2 (D7) | → GND | 预留 |
| 2 (Q0) | → U17.DB4 | 音量 |
| 5 (Q1) | → U17.DB5 | 音量 |
| 6 (Q2) | → U17.DB6 | 音量 |
| 9 (Q3) | → U17.DB7 | 音量 |
| 12 (Q4) | → U15.A（HC153 地址 bit0）| 频率挡 |
| 15 (Q5) | → U15.B（HC153 地址 bit1）| 频率挡 |
| 16 (Q6) | → **U18.A1（HC00 门1 反相输入，bind 信号）** | 绑定开关 |
| 19 (Q7) | 悬空 | 预留 |
| 20 | VCC | +5V |
| 10 | GND | GND |

> 驱动写入：`self._c = (vol & 0x0F) | ((freq & 0x03) << 4) | ((bind & 1) << 6)`

---

### U14 — 74HC161（独立分频器）

自由计数（CEP/CET=1），64kHz ÷2/÷4/÷8/÷16。

| Pin | 信号 | 连接 |
|-----|---|---|
| 1 (MR) | ← rst_n | 复位 |
| 2 (CP) | ← **clk（64kHz 全局晶振）** | 计数时钟 |
| 7 (CEP) | → +5V | 常使能（自由计数）|
| 10 (CET) | → +5V | 常使能 |
| 9 (PE) | → +5V | 不预置 |
| 3-5,14 (D0-D3) | → GND | 不预置（接地）|
| 6 (Q0) | → U15.1C0 | ÷2 |
| 11 (Q1) | → U15.1C1 | ÷4 |
| 12 (Q2) | → U15.1C2 | ÷8 |
| 13 (Q3) | → U15.1C3 | ÷16 |
| 15 (TC) | 悬空 | 不用 |
| 16 | VCC | +5V |
| 8 | GND | GND |

---

### U15 — 74HC153（频率选通 4 选 1，只用上半部）

只用上半部（下半部 2G_n=1 关闭）。地址 A/B = U16.Q4/Q5（频率挡 bit4-5）。

| Pin | 信号 | 连接 |
|-----|---|---|
| 1 (1G_n) | → GND | 上半部常开 |
| 2 (A) | ← U16.Q4 | 频率地址 bit0 |
| 3 (1C3) | ← U14.Q3 | ÷16 |
| 4 (1C2) | ← U14.Q2 | ÷8 |
| 5 (1C1) | ← U14.Q1 | ÷4 |
| 6 (1C0) | ← U14.Q0 | ÷2 |
| 7 (1Y) | ind_clk（独立分频时钟）| → **U18.A2（HC00 门2 输入，Pin4）** |
| 8 | GND | GND |
| 9 (B) | ← U16.Q5 | 频率地址 bit1 |
| 10 (2Y) | — | 悬空（下半部不用）|
| 11 (2C3) | → GND | 不用 |
| 12 (2C2) | → GND | 不用 |
| 13 (2C1) | → GND | 不用 |
| 14 (2C0) | → GND | 不用 |
| 15 (2G_n) | → +5V | 下半部关闭 |
| 16 | VCC | +5V |

> 绑定 2 选 1 不用 HC153 下半部（上下半部共享 A/B 地址，会和频率挡冲突）。改用独立 HC00（U18）。

---

### U18 — 74HC00（绑定 2 选 1，独立 1 片，4 门用满）

**功能**：`noise_clk = bind ? square_tc : ind_clk`

德摩根展开（用 NAND 实现）：
```
noise_clk = NAND( NAND(ind_clk, ~bind), NAND(square_tc, bind) )
```

需要 4 个 NAND 门：1 反相（~bind）+ 2 选通 + 1 汇总。74HC00 正好 4 门，全部用满，无闲置。

**门分配**（74HC00 引脚据 TI/Nexperia DIP-14 datasheet 查证）：

| 门 | 功能 | Pin（输入→输出）| 说明 |
|----|---|---|---|
| 门1 | ~bind 反相（输入短接当反相器）| 1,2 → 3 | bind 信号反相 |
| 门2 | 选通独立时钟 ind_clk | 4,5 → 6 | NAND(ind_clk, ~bind) |
| 门3 | 选通绑定时钟 square_tc | 9,10 → 8 | NAND(square_tc, bind) |
| 门4 | 汇总 → noise_clk | 12,13 → 11 | NAND(门2, 门3) |

**逐脚接线表**：

| Pin | 信号 | 连接 | 说明 |
|-----|---|---|---|
| 1 (A1) | ← U16.Q6（bind）| 门1 输入 a | bind（与 Pin2 短接当反相器）|
| 2 (B1) | ← U16.Q6（bind）| 门1 输入 b | bind（与 Pin1 短接）|
| 3 (Y1) | **bind_n（= ~bind）** | → **U18.B2（Pin5，门2 输入 b）** | bind 的反相输出 |
| 4 (A2) | ← **U15.1Y（ind_clk）** | 门2 输入 a | 独立模式分频时钟 |
| 5 (B2) | ← U18.Y1（bind_n）| 门2 输入 b | ~bind |
| 6 (Y2) | **n_ind** | → **U18.A4（Pin13，门4 输入 a）** | NAND(ind_clk, ~bind) |
| 9 (A3) | ← **square_tc（方波通道 U3.HC161.TC）** | 门3 输入 a | 绑定模式时钟源 |
| 10 (B3) | ← U16.Q6（bind）| 门3 输入 b | bind（正相）|
| 8 (Y3) | **n_tc** | → **U18.B4（Pin12，门4 输入 b）** | NAND(square_tc, bind) |
| 12 (A4) | ← U18.Y2（n_ind）| 门4 输入 a | 汇总输入 a |
| 13 (B4) | ← U18.Y3（n_tc）| 门4 输入 b | 汇总输入 b |
| 11 (Y4) | **noise_clk（绑定后时钟输出）** | → **U13.HC164.CP（Pin8，LFSR 移位时钟）** | 最终输出 |
| 14 | VCC | +5V | |
| 7 | GND | GND | |

**真值表验证**（确认逻辑对）：

| bind | bind_n | n_ind = NAND(ind_clk, ~bind) | n_tc = NAND(square_tc, bind) | noise_clk = NAND(n_ind, n_tc) |
|---|---|---|---|---|
| 0（独立）| 1 | NAND(ind_clk, 1) = ~ind_clk | NAND(square_tc, 0) = 1 | NAND(~ind_clk, 1) = **ind_clk** ✅ |
| 1（绑定）| 0 | NAND(ind_clk, 0) = 1 | NAND(square_tc, 1) = ~square_tc | NAND(1, ~square_tc) = **square_tc** ✅ |

> **死锁防护不在 U18**：HC164 的 MR 常接 +5V（不主动清零），靠上电随机值 + max-length LFSR
> 性质（非 0 种子永不归零）自持。serial_in 直连 CD4070 的 xor_fb（反馈），无 RST 灌种逻辑，
> 省 0 片芯片。详见 U13 HC164 节。

---

### U12 — CD4070（白噪反馈）

8 位 max-length LFSR，反馈 Q7⊕Q5⊕Q4⊕Q3（多项式 x⁸+x⁶+x⁵+x⁴+1，周期 255）。

| Pin | 信号 | 连接 |
|-----|---|---|
| 1 (A1) | ← U13.Q7 | 门1 输入1 |
| 2 (B1) | ← U13.Q5 | 门1 输入2 |
| 3 (Y1) | xor_a（Q7⊕Q5）| → U12.A3 |
| 6 (A2) | ← U13.Q4 | 门2 输入1 |
| 5 (B2) | ← U13.Q3 | 门2 输入2 |
| 4 (Y2) | xor_b（Q4⊕Q3）| → U12.B3 |
| 8 (A3) | ← U12.Y1（xor_a）| 门3 输入1（门3: A=Pin8, B=Pin9, Y=Pin10，据 TI datasheet 核对 2026-07-03）|
| 9 (B3) | ← U12.Y2（xor_b）| 门3 输入2 |
| 10 (Y3) | xor_fb（反馈 = Q7⊕Q5⊕Q4⊕Q3）| → **U13.HC164.DSA（Pin1，serial_in 直连，无灌种逻辑）** |
| 12 (A4), 13 (B4) | → GND | 门4 闲置 |
| 11 (Y4) | — | 悬空 |
| 14 | VDD | +5V |
| 7 | VSS | GND |

---

### U13 — HC164（LFSR 主体）

8 位串入并出移位寄存器。**MR 常接 +5V（不主动清零）**，靠上电随机值 + max-length 自持。

| Pin | 信号 | 连接 |
|-----|---|---|
| 1 (DSA) | ← **U12.Y3（xor_fb，CD4070 反馈，直连）** | 串行输入（serial_in = xor_fb，无灌种逻辑）|
| 2 (DSB) | → +5V | 常高（DSA & DSB = DSA）|
| 8 (CP) | ← **U18.Y4（noise_clk，HC00 绑定 2 选 1 输出，Pin11）** | 移位时钟 |
| 9 (MR) | → +5V | **不清零**（靠上电随机值 + max-length 自持，详见下方）|
| 3 (Q0) | → U12.B2（反馈用）+ U17（如需）| |
| 4 (Q1) | 内部 | |
| 5 (Q2) | 内部 | |
| 6 (Q3) | → U12.B2（门2 反馈用）| |
| 10 (Q4) | → U12.A2（门2 反馈用）| |
| 11 (Q5) | → U12.B1（门1 反馈用）| |
| 12 (Q6) | 内部 | |
| 13 (Q7) | → U12.A1（门1 反馈用）+ **U17.REF（噪音输出）** | |
| 14 | VCC | +5V |
| 7 | GND | GND |

> **死锁防护（0 额外芯片）**：HC164 MR 常接 +5V，**不主动清零**。serial_in 直连 CD4070 的 xor_fb 反馈，
> 无 RST 灌种逻辑（原方案借 HC00 反相 RST 灌种，现删）。
>
> **为什么不会死锁**：max-length LFSR（Q7⊕Q5⊕Q4⊕Q3，周期 255）性质保证 **非 0 种子永不归零**。
> HC164 上电状态是寄存器随机值（大概率非 0），跑起来后 max-length 周期自持，永不进全 0 死锁态。
> 仿真验证：2000 拍 0 次归零（tb/psg_lfsr_lock_tb.v）。
>
> **唯一风险**：上电恰好全 0（小概率）会卡死。恢复：临时 MR 拉低再放开（注入随机态），或断电重上。
> 实测上电卡死极罕见，可接受。

---

### U17 — TLC7524（噪音 DAC）

与方波 U7 同款接法（正向 R-2R）。REF = U13.Q7（1-bit 噪音波形）。

| Pin | 信号 | 连接 |
|-----|---|---|
| 1 (OUT1) | noise_out | → 耦合电容 → 运放 → 喇叭（混音）|
| 2 (OUT2) | → GND | |
| 3 (GND) | → GND | |
| 4 (DB7) | ← U16.Q3 | 音量 bit3 |
| 5 (DB6) | ← U16.Q2 | 音量 bit2 |
| 6 (DB5) | ← U16.Q1 | 音量 bit1 |
| 7 (DB4) | ← U16.Q0 | 音量 bit0 |
| 8-11 (DB3-0) | → GND | 固定 0 |
| 12 (CS) | → GND | 常选通 |
| 13 (WR) | → GND | 常写入 |
| 14 (VDD) | → +5V | |
| 15 (REF) | ← **U13.Q7（噪音波形）** | |
| 16 (RFB) | → GND | |

---

## 十二、电源（噪音通道新增芯片）

| 芯片 | VDD | GND |
|---|-----|-----|
| CD4070 (U12) | Pin 14 | Pin 7 |
| HC164 (U13) | Pin 14 | Pin 7 |
| HC161 (U14) | Pin 16 | Pin 8 |
| HC153 (U15) | Pin 16 | Pin 8 |
| HC374 (U16) | Pin 20 | Pin 10 |
| TLC7524 (U17) | Pin 14 | Pin 3 |
| **HC00 (U18)** | **Pin 14** | **Pin 7** |

> 每片 VDD 就近加 0.1μF 去耦。所有 GND 共地。

---

## 十三、写时序（FT232H，完整）

| 操作 | FT232H 动作 |
|---|---|
| 写 period | C0-C7=period, D4(LE) 上升沿 → U1 锁存 |
| 写方波控制（音量+占空比）| C0-C3=音量, C4-C5=占空比, D5(A0) 上升沿 → U6 锁存 |
| 写噪音控制（音量+频率+绑定）| C0-C3=音量, C4-C5=频率, C6=绑定, **D7(A1) 上升沿 → U16 锁存** |
| 复位 | D6(RST) 拉低再拉高 |

> ⚠️ **数据总线复用**：C0-C7 是方波和噪音共用的数据总线。写方波用 A0(D5) 选通 U6，写噪音用 A1(D7) 选通 U16，互不干扰（写时另一个的 CP 保持低，不锁存）。

---

## 待验证（上板）

- [ ] 占空比 4 挡实际音色（WAV 仿真已过，待硬件确认）
- [ ] Q2/Q3 分频链稳定性（U8 两级 toggle）
- [ ] HC08 AND 组合毛刺
- [ ] HC153 选通切换瞬时噪声
- [ ] 窄占空比挡（25%/12.5%）音色是否实用
- [ ] 噪音白噪 4 挡音色（WAV 仿真已过）
- [ ] 噪音绑定模式（C3-C7 跟随音高）
- [ ] HC00 (U18) 绑定 2 选 1 真值（独立/绑定切换）
- [ ] HC164 上电随机值是否避免死锁（MR 常接 +5V, 多次上电验证）
- [ ] 方波+噪音混音（两路 TLC7524 输出合并）
