denjhang/74HC-Chiptune/psg_voice/PSG3 v0.4/docs/wiring-table-noise.md

# PSG3 v0.4 接线表 — 噪音通道 CH1

> **照抄 PSG2 v0.3 rev.a（已上板验证通过，不改逻辑）。**
> 唯一变化：控制字不再由 FT232H 直驱 D 端，改从接口层 reg2 的 Q 端取。
> 芯片编号在 PSG3 内重新编排（U30-U36），与 PSG2 v0.3 rev.a 的 U12-U18 对应。

---

## 一、芯片清单（7 片 + 2 电容）

| PSG3 位号 | PSG2 v0.3 rev.a 位号 | 型号 | 功能 |
|---|---|---|---|
| U30 | U12 | CD4070 | LFSR 反馈 Q7⊕Q5⊕Q4⊕Q3（门1-3）|
| U31 | U13 | 74HC374 | LFSR 主体（8 位 D 触发器阵列）|
| U32 | U14 | 74HC161 | 独立分频（÷2/÷4/÷8/÷16）|
| U33 | U15 | 74HC153 | 频率选通 4 选 1 |
| U34 | U17 | TLC7524 | 噪音衰减器（REF=Q7）|
| U35 | U18 | 74HC00 | 绑定 2 选 1（4 门用满）|
| U36 | U4(借)→独立 | 74HC00 | 防锁死振荡器（门3+电容，门2/4 配合）|
| C1, C2 | C1, C2 | 0.1μF ×2 | U36 门3 张弛振荡器电容 |

> ⚠️ PSG2 v0.3 rev.a 里 U4（方波通道的 HC00）借门做防锁死振荡。**PSG3 接口层独立原则下，噪音通道用独立 U36（HC00），不借方波通道的门。**

---

## 二、寄存器来源（接口层 → 噪音通道）

| 信号 | 来源（接口层）| 噪音通道用途 |
|---|---|---|
| vol[3:0] | reg2.Q0-Q3 = U4.Q | TLC7524 DB4-7（音量）|
| freq_sel[1:0] | reg2.Q4-Q5 = U4.Q | HC153 频率挡地址 |
| bind | reg2.Q6 = U4.Q | HC00 门1（绑定开关）|

---

## 三、逐芯片接线

> 接线逻辑与 PSG2 v0.3 rev.a 完全一致（见 `psg_voice/PSG2 v0.3/docs/wiring-table-rev-a.md`）。
> 仅控制字来源从"FT232H 经 HC374 锁存"改为"接口层 reg2 的 Q"。
> 完整逐脚表照抄 rev-a，不在此重复——上板时直接对照 rev-a 接线表，把 D 端接到接口层 reg2 即可。

### 关键改动点（相对 PSG2 v0.3 rev.a）

| 信号 | PSG2 rev.a 来源 | PSG3 来源 |
|---|---|---|
| TLC7524 DB4-7（vol）| HC374.Q0-3（A1 锁存）| **接口层 reg2.Q0-3**（U4）|
| HC153 地址 A/B（freq）| HC374.Q4-5 | **接口层 reg2.Q4-5** |
| HC00 门1 输入（bind）| HC374.Q6 | **接口层 reg2.Q6** |
| noise_clk 的 tc_hi（绑定）| 方波通道 U3.TC | **方波通道 U21.TC，经 HC00 反相隔离后再接 U35**（PSG3 编号）|

> **⚠️ tc_hi 必须经 HC00 反相器隔离**（2026-07-08 上板发现）：
> 方波的 tc_hi 直接连到噪音绑定 2 选 1（U35 门3 输入），会反过来干扰方波通道（和 HC00 振荡器串扰 /PE 同类问题——噪音侧电路回灌影响方波信号源）。
> **修复**：tc_hi 先过一级 HC00 反相器（缓冲隔离），输出 NOT(tc_hi) 再接 U35 门3。
> 反相对噪音 LFSR 无影响（HC374 上升沿触发，相位反了只是边沿时机变，噪音本就随机）。
> 借用噪音通道 U35（HC00）剩余门，或独立一片 HC00 的一个门做这个反相。

> 其余接线（CD4070 XOR 反馈、HC374 LFSR 移位链、HC161 自由分频、HC153 选通、HC00 防锁死振荡+注入、HC00 绑定 2 选 1、TLC7524 衰减、2×0.1μF 振荡电容）**全部照抄 PSG2 v0.3 rev.a**。

---

## 四、输出

| 信号 | 来源 | 去向 |
|---|---|---|
| nz_audio | U34.OUT1（TLC7524）| → 耦合电容 → 运放 → 喇叭（与方波混音）|

---

## 五、电源

照抄 PSG2 v0.3 rev.a。每片 VDD 就近加 0.1μF 去耦，所有 GND 共地。
