denjhang/74HC-Chiptune/psg_voice/PSG3 v0.4/docs/wiring-table-square.md

# PSG3 v0.4 接线表 — 方波通道 CH0

> **照抄 PSG2 v0.3 方波通道（已上板验证通过，不改逻辑）。**
> 唯一变化：period 和控制字不再由 FT232H 直驱 D 端，改从接口层 reg0/reg1 的 Q 端取。
> 芯片编号在 PSG3 内重新编排（U20-U27），与 PSG2 v0.3 的 U1-U11 对应关系标注在各芯片。

---

## 一、芯片清单（8 片）

| PSG3 位号 | PSG2 v0.3 位号 | 型号 | 功能 |
|---|---|---|---|
| U20 | U2 | 74HC161 | 计数器低 4 位 |
| U21 | U3 | 74HC161 | 计数器高 4 位 |
| U22 | U4 | 74HC00 | PE 反相（门1）+ 占空比 AND（门2-4）|
| U23 | U5 | 74HCT74 | FF1 sync + FF2 toggle（**必须 HCT**）|
| U24 | U8 | 74HC74 | FF3 ÷2 + FF4 ÷2（占空比分频链）|
| U25 | U10 | 74HC153 | 占空比 4 选 1 |
| U26 | U11 | 74HC4053 | 双 SPDT：X=mode, Z=REF |
| U27 | U7 | TLC7524 | 方波衰减器（正向接法）|

---

## 二、寄存器来源（接口层 → 方波通道）

| 信号 | 来源（接口层）| 方波通道用途 |
|---|---|---|
| period_q[7:0] | reg0 = U2.Q | 计数器预置值（频率）|
| vol[3:0] | reg1.Q0-Q3 = U3.Q | TLC7524 DB4-7（音量）|
| duty_sel[1:0] | reg1.Q4-Q5 = U3.Q | HC153 占空比地址 |
| mode_sel | reg1.Q6 = U3.Q | HC4053 开关 X 控制（方波/白噪）|
| ref_sel | reg1.Q7 = U3.Q | HC4053 开关 Z 控制（占空比变体/Q0）|

> PSG2 v0.3 里这些信号来自 FT232H 经 HC373/HC374 锁存。PSG3 里锁存移到接口层，方波通道直接接收 Q。

---

## 三、逐芯片接线

> 接线逻辑与 PSG2 v0.3 完全一致（见 `psg_voice/PSG2 v0.3/docs/wiring-table.md` 第四节至第六点五节）。
> 仅 D 端输入来源从"FT232H/HC373"改为"接口层 reg0/reg1 的 Q"。
> 完整逐脚表照抄 PSG2 v0.3，不在此重复——上板时直接对照 PSG2 v0.3 接线表，把 D 端接到接口层 reg 即可。

### 关键改动点（相对 PSG2 v0.3）

| 信号 | PSG2 v0.3 来源 | PSG3 来源 |
|---|---|---|
| 计数器 D0-D7（period）| HC373.Q（LE 锁存）| **接口层 reg0.Q**（U2）|
| TLC7524 DB4-7（vol）| HC374.Q0-3（A0 锁存）| **接口层 reg1.Q0-3**（U3）|
| HC153 地址 A/B（duty）| HC374.Q4-5 | **接口层 reg1.Q4-5** |
| HC4053 S0（mode）| HC374.Q6 | **接口层 reg1.Q6** |
| HC4053 S2（ref）| HC374.Q7 | **接口层 reg1.Q7** |
| MR/CLR（rst_n）| FT232H D6 经 LS373 | **接口层 rst_n**（U0b.Q2）|

> 其余接线（HC161 级联、HC00 PE 反相、HCT74 toggle、HC74 分频链、HC153 选通、HC4053 切换、TLC7524 衰减）**全部照抄 PSG2 v0.3，一个引脚都不改**。

---

## 四、输出

| 信号 | 来源 | 去向 |
|---|---|---|
| sq_audio | U27.OUT1（TLC7524）| → 耦合电容 → 运放 → 喇叭 |
| tc_hi | U21.TC | → 噪音通道（绑定模式时钟源，跨通道信号）|

---

## 五、电源

照抄 PSG2 v0.3。每片 VDD 就近加 0.1μF 去耦，所有 GND 共地。
