denjhang/74HC-Chiptune/74chiptune日志.txt

D:\working\vscode-projects\74HC-Chiptune\reference\Namco WSG\easyeda

D:\working\vscode-projects\74HC-Chiptune\reference\Namco WSG\rom

具体功能文档 ：
D:\working\vscode-projects\74HC-Chiptune\reference\Namco WSG\Pac-Man技术文档_extracted
D:\working\vscode-projects\74HC-Chiptune\reference\Namco WSG\PacmanEmulation_extracted

跑0.5s，不对，有没有更快的方法？你先确认正常我再听

先编译D:\working\vscode-projects\74HC-Chiptune\iverilog-master，开干吧

D:\Program Files\oss-cad-suite

D:\working\vscode-projects\Reference_Project\STC-MCU\extracted

用那个最简单的wt音源，我想用七四门和sram和rom做，在电脑上要怎么仿真？
你是想用纯硬件（74系列逻辑门 + SRAM + ROM）搭一个最简 WT 合成器，不用 MCU？

仿真方案：

Verilog/VHDL 仿真 — 把 74 门逻辑用 HDL 描述，跑 testbench 验证时序

工具：Icarus Verilog（免费） + GTKWave 看波形
或者 Verilator（更快）
数字电路仿真器 — 直接画门电路

Logisim / Logisim-Evolution（免费，图形化拖拽 74 门连线，直接看输出波形）
Wokwi（在线，但不支持纯模拟电路）
Falstad Circuit Simulator（在线） — 可以搭 RC 滤波 + 数字逻辑混合仿真

推荐：先用 Logisim-Evolution 把 WT 核心逻辑画出来验证 — 相位累加器、波形 ROM 查表、R-2R DAC 输出。它能直接生成波形图，比写 Verilog 快得多。

你是想搭面包板原型还是纯仿真验证概念？

豆包说digital好
Digital 是个好选择 — 开源免费，Java 跨平台，专门做数字电路仿真，比 Logisim 更现代，内置 RTL 分析器，可以直接看信号波形。

用它搭 WT 核心就行：

相位累加器 — 16-bit 加法器 + 寄存器（74HC161 级联）
波形 ROM — 用 ROM 组件存 128 点波形
查表 — 累加器高 7 位 → ROM 地址
R-2R DAC — 8-bit 输出接电阻网络
先从最简的单通道方波/三角波开始验证，再逐步加完整 WT 功能。

就最简单的一个查表状态机，要花多少元件呢？
最简 WT 单通道查表，按功能拆：

功能	元件	数量
相位累加器	74HC161 (4-bit计数器) x4 级联	4
频率步进	74HC283 (4-bit加法器) x4	4
步进值输入	拨码开关/锁存器	1
地址选通	累加器高 7/8 位直连 ROM	0
波形 ROM	28C64 (8Kx8 EEPROM)	1
输出锁存	74HC574 (8-bit锁存)	1
时钟	晶振 + 74HC04 (反相器)	1
R-2R DAC	电阻网络 (9个电阻)	-
低通滤波	RC 滤波	-
总计约 11 颗 IC + 电阻网络

核心其实就三步循环：ACC += STEP → ROM[ACC高8位] → 锁存输出 → DAC

累加器也可以省掉 4 颗 161，直接用 2 颗 74HC574（锁存）+ 4 颗 283（加法）组成，让 ROM 地址线 = 锁存器输出，每 CLK 周期：STEP + 当前值 → 锁存 → ROM 地址更新。

最精简可以压到 7 颗 IC：4x 283 + 1x 574 + 1x 28C64 + 1x 04。

之前我让你做思维实验，一直做就没法收敛，这肯定最后要用的vhdl或者verilog做，而不是纯粹写文档或者空想，那肯定是没用。
对，直接写 Verilog 验证，仿真通过后再决定是烧 FPGA 还是74门搭。

WT 核心也就几十行 Verilog，你想现在在当前项目里建个 rtl/ 目录开始写，还是等新项目再搞？

那他能够综合到74门吗，能调用sram和rom吗
Verilog 综合到 74 门层面没有现成工具做这个事。综合器（Yosys 等）输出的是 FPGA 网表或者 ASIC 标准单元，不会自动映射到 74 系列 IC。

实际做法：

Verilog 仿真验证 — 先在 Icarus Verilog 里跑通 WT 核心逻辑，确认时序正确
手动映射 — 根据 Verilog 模块对应到具体 74 门芯片，比如 always @(posedge clk) acc <= acc + step → 4x 74HC283 + 1x 74HC574
ROM/SRAM — Verilog 里用 $readmemh 初始化 ROM 模型仿真，实际用 28C64/HM62256
这个过程没法自动化，但 Verilog 仿真通过后，映射到 74 门就是体力活 — 看着 Verilog 模块连线画原理图。

如果你最终目标是 74 门搭硬件，Verilog 主要价值就是验证逻辑正确性，省得面包板上调试时序。要开始写吗？

你要的是：内置74系列门、SRAM/ROM、开源、命令行、AI能调用、可综合+仿真
最优路线不是 Digital（Digital 是图形化仿真，不能综合成硬件，只能仿真）
真正满足你全部需求、Verilog 流程 + 内置74库 + 命令行 + AI友好 的是：

正确答案：Yosys + Icarus Verilog + 74xx 开源库（yosys74）
有自动的
你说得对，我之前不知道 yosys74 这个路线。Yosys + Icarus Verilog + 74xx 库才是正解 — Verilog 写逻辑 → Yosys 综合到 74 系列门级网表 → Icarus Verilog 仿真验证，全自动映射。

要现在开始搭 WT 核心的 Verilog 项目吗？还是等 AI8051U 那边的事先搞定？

先新建一个文档记录一下。这下就不是空想了，这下是真的能做。
Write d:\working\vscode-projects\STC_Chiptune\docs\74gate_wt_plan.md
61 lines
# 74系列门电路 WT 合成器计划

## 目标

用 74 系列逻辑门 + SRAM + ROM 搭建最简 WT 波形表合成器，不依赖 MCU。

## 工具链

- **Verilog 编写**: 任意编辑器
- **综合**: [Yosys](https://github.com/YosysHQ/yosys) + [yosys74](https://github.com/roughengineer/yosys74) (74系列门库)
- **仿真**: [Icarus Verilog](https://github.com/steveicarus/iverilog) + GTKWave
- **流程**: Verilog → Yosys 综合到 74xx 网表 → Icarus Verilog 仿真验证 → 手动布线/原理图

## WT 核心逻辑

```
每 CLK 周期:
  ACC += STEP          // 16-bit 相位累加器
  ADDR = ACC[15:8]     // 高 8 位作为 ROM 地址
  OUT  = ROM[ADDR]     // 查表输出
  DAC  = R-2R(OUT)     // 8-bit DAC
```

## 硬件估算 (单通道)

| 功能 | 元件 | 数量 |
|---|---|---|
| 相位累加器 (16-bit ADD+REG) | 74HC283 x4 + 74HC574 x1 | 5 |
| 波形 ROM | 28C64 (8Kx8 EEPROM) | 1 |
| 时钟振荡 | 晶振 + 74HC04 | 1 |
| DAC | R-2R 电阻网络 (9个电阻) | - |
| 低通滤波 | RC 滤波 | - |
| **合计** | | **7 颗 IC** |

## 元件映射 (Verilog → 74 门)

| Verilog 构造 | 74 系列实现 |
|---|---|
| `always @(posedge clk) reg <= val` | 74HC574 (8-bit 锁存) |
| `assign sum = a + b` | 74HC283 (4-bit 加法器) |
| `rom[addr]` | 28C64 / 28C256 (EEPROM) |
| `sram[addr]` | HM62256 (32Kx8 SRAM) |
| `assign y = a & b` | 74HC08 (AND 门) |
| `assign y = a \| b` | 74HC32 (OR 门) |
| `assign y = ~a` | 74HC04 (NOT 门) |
| `assign y = sel ? a : b` | 74HC157 (MUX) |
| 计数器 | 74HC161 (4-bit 同步计数器) |

## 开发步骤

1. 搭建工具链 (Yosys + Icarus Verilog + yosys74)
2. 写 WT 核心 Verilog (相位累加器 + ROM 查表)
3. Icarus Verilog testbench 验证输出波形
4. Yosys 综合到 74xx 网表，确认资源用量
5. 扩展: 多通道、包络、频率控制接口
6. 面包板/PCB 原型验证

## 状态

规划阶段，待工具链搭建后开始。
已创建 74gate_wt_plan.md。记录了工具链（Yosys + Icarus Verilog + yosys74）、WT 核心逻辑、元件映射表和开发步骤。等要动手的时候从这里开始。

那你会写verilog吗
会写。Verilog 跟 C 语法很像，always 块相当于 ISR，assign 相当于组合逻辑。WT 核心也就几十行的事。

要现在写个 WT 核心模块试试吗？

Gigatron是如何设计出来的，他们应该有专门的综合工具吧？还是说本身就是资深老工程师，直接靠徒手？
Gigatron 的设计者 Marcel van Kervinck 和 Walter Belgers 都是资深工程师。Marcel 是荷兰计算机科学家，Walter 是信号处理专家。

他们的做法其实比较"手工"：

没有用综合工具，直接画逻辑图 + 手写汇编
核心就是一块 AT28C256 ROM（指令解码+控制信号全部存在 ROM 里），加上几颗 74HC 逻辑芯片做 PC、ALU、寄存器
本质是一台 ROM 微码控制的 TTL 计算机，不是传统 CPU 设计流程
所有时序都是人脑算的，用 Excel 表格规划微码
他们能这么做是因为：

Gigatron 架构极其精简（8-bit，哈佛结构，单总线）
指令集只有十几种
控制逻辑全部压缩到 ROM 查表里，不需要复杂的门级设计
对于我们的 WT 合成器来说，复杂度比 Gigatron 低很多 — 不需要指令解码、不需要 ALU，就一个累加器 + ROM 查表。用 Yosys + yosys74 综合完全够了，不需要徒手。

他们架构很牛逼啊，底层就是个8位cpu，好像只有七条指令集还是多少，然后模拟16位vcpu，
对，Gigatron 的设计非常精妙：

硬件层：8-bit TTL CPU，~30 颗 74HC 芯片，指令集只有 6 条（LD, AND/OR/XOR, ADD, ST, JMP, OUT）
vCPU 层：用 ROM 里的微码解释执行 16-bit 虚拟指令，在 8-bit 硬件上模拟 16-bit 运算
巧妙之处：硬件只做最简单的事（取指、解码、执行），复杂逻辑全靠软件层在 vCPU 上跑
我们的项目里 Gigatron 音源就是移植的这个 4 通道波形合成部分。他那个完整的 TTL 计算机才是真正的工程艺术 — 用最少的门电路实现了一台能跑 BASIC、显示图形的计算机。

要继续聊 Gigatron 还是回去做别的事？

能给我们带来什么启发呢？如果只做声音，参考他的思路，会需要怎么做呢？我知道早期肯定只是写verilog
Gigatron 的核心思路：硬件极简，软件（微码/ROM）做复杂的事。

映射到纯硬件 WT 合成器：

Gigatron 教我们的：

ROM 不只存波形，还能存控制逻辑 — 他用 ROM 做指令解码器，我们可以用 ROM 做包络曲线、甚至是简单的 ADSR 状态机查表
加法器 + ROM 查表 = 万能 — 他的 ALU 本质上就是 ROM 查表，我们的频率步进也是加法器 + ROM
时分复用 — 他用一套硬件分时模拟多寄存器，我们可以用一套累加器 + ROM 分时服务多通道
如果只做声音，最简方案：

硬件（~10颗IC）:
  1x 计数器 (节拍/通道切换)
  4x 加法器 (相位累加)
  1x 锁存器 (当前相位)
  1x 波形ROM (波形数据)
  1x 包络ROM (ADSR查表)
  1x 控制ROM (通道调度+状态机)
  1x 加法器 (混音累加)
  1x 时钟
关键启发：用控制 ROM 代替随机逻辑。不需要为 ADSR 状态机画一堆门电路，把状态转移表烧进 ROM，用计数器当地址，输出就是控制信号。这样硬件数量可以压到最低。

早期先写 Verilog 验证这套架构，综合后数一下实际要多少颗 IC。
