denjhang/74HC-Chiptune/psg_voice/PSG3 v0.5/sch/Schematic_PSG4-v0.52_2026-07-15.pdf

## 注意ft232h的gpio是3v3电平，很多老74带不动

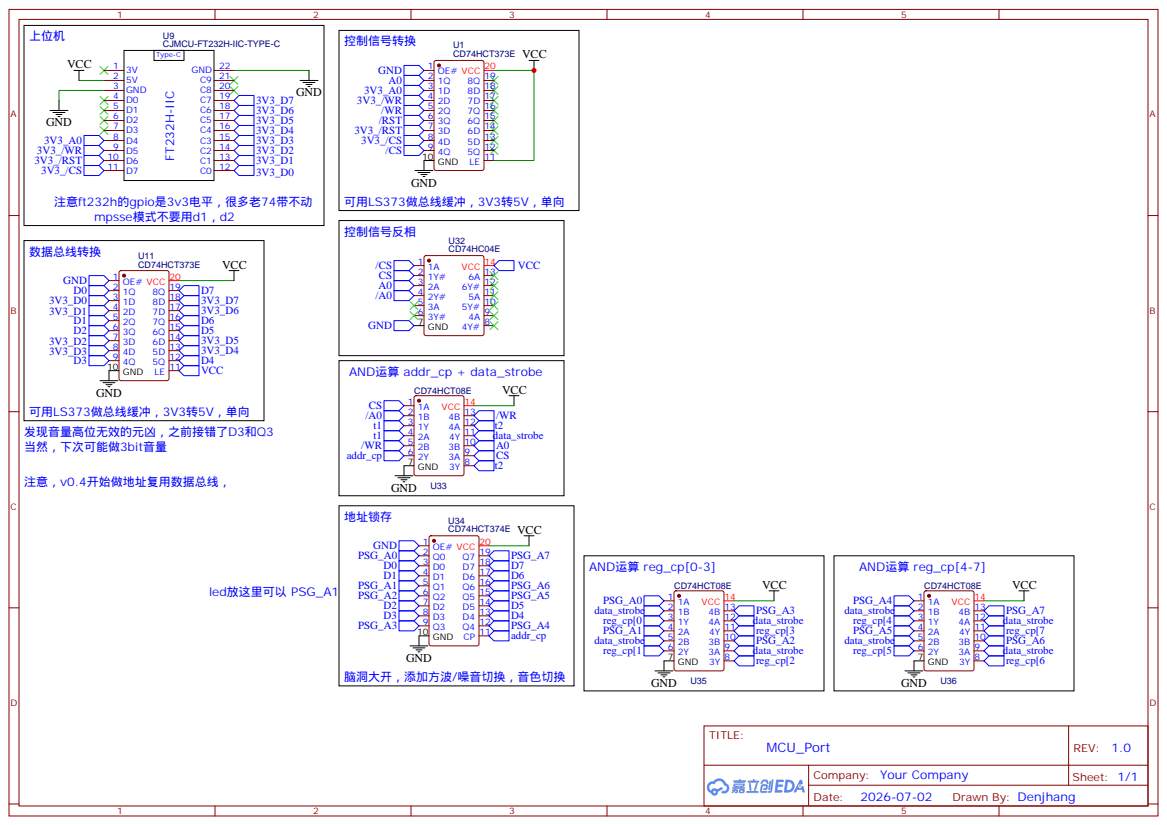
[picture p8: page 1]

脑洞大开，添加方波/噪音切换，音色切换

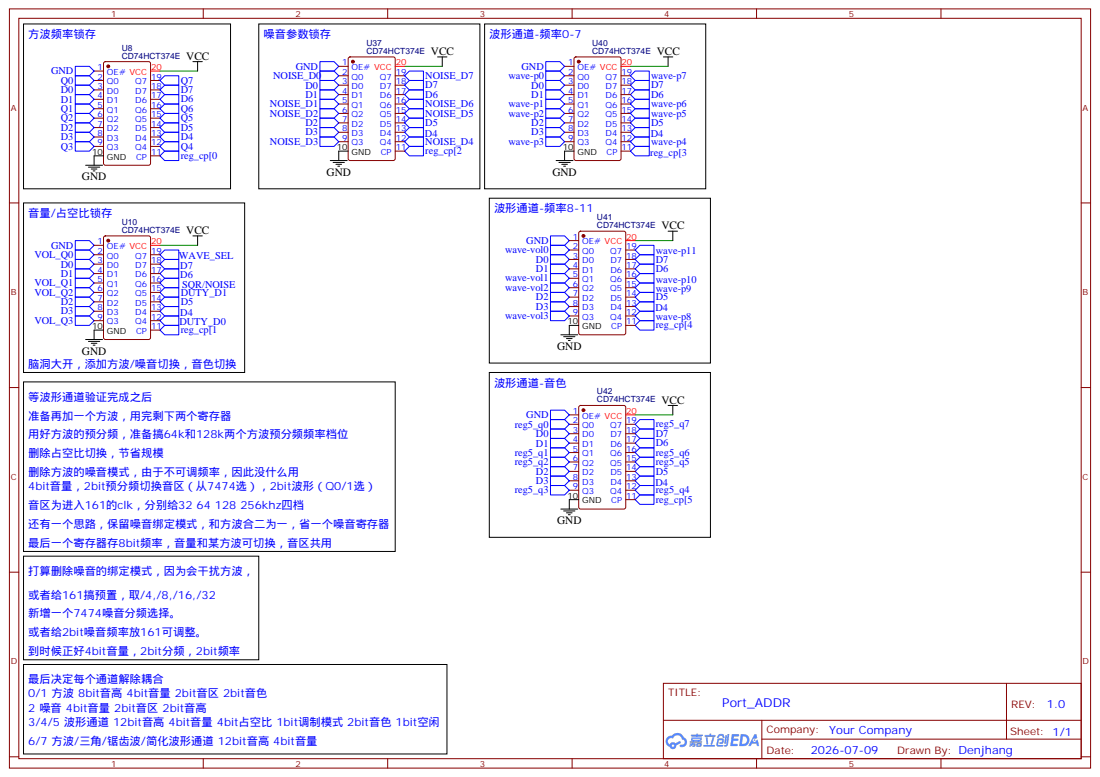
[picture p9: page 2]

脑洞大开，添加方波/噪音切换，音色切换

## 必须原装HCT74

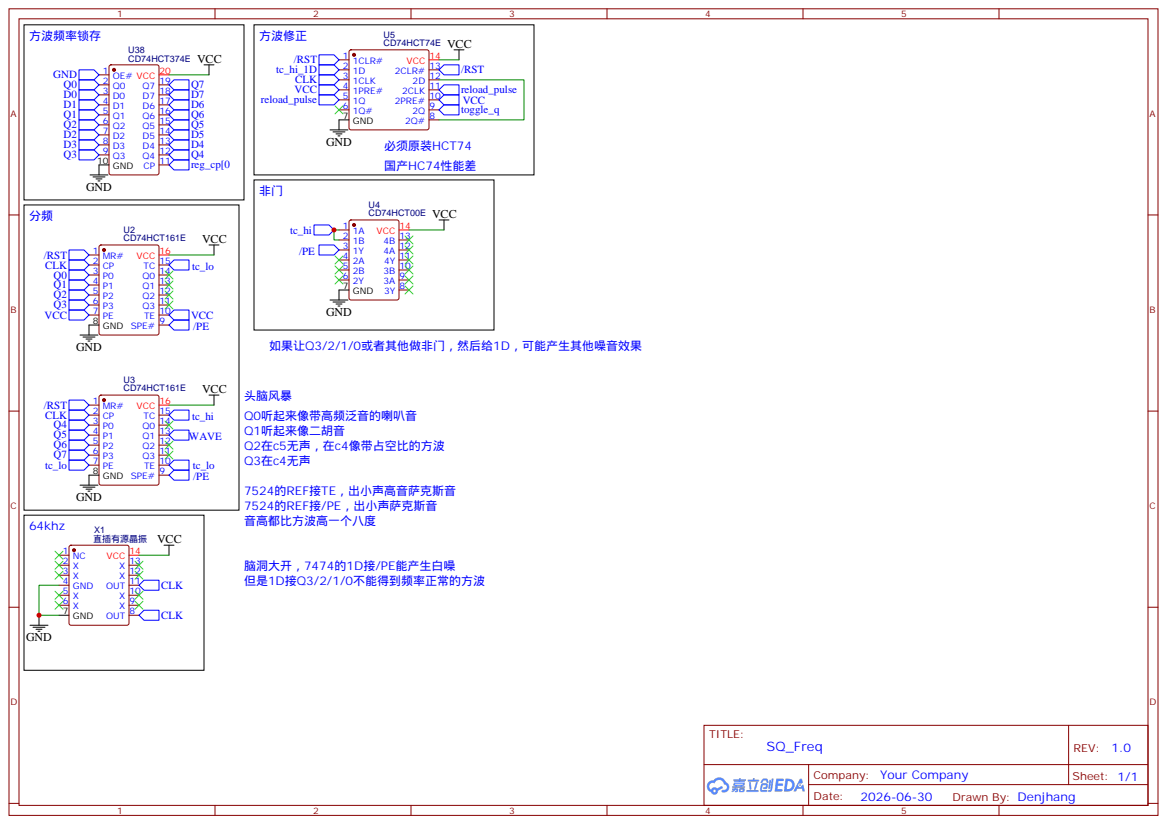
[picture p10: page 3]

# 2I0 10 2I1 11 2I2 12 2I3 13 S0 14 2E# 15 VCC 16

# S1 10 S0 11 A0 12 A1 13 AN 14 BN 15 VCC 16

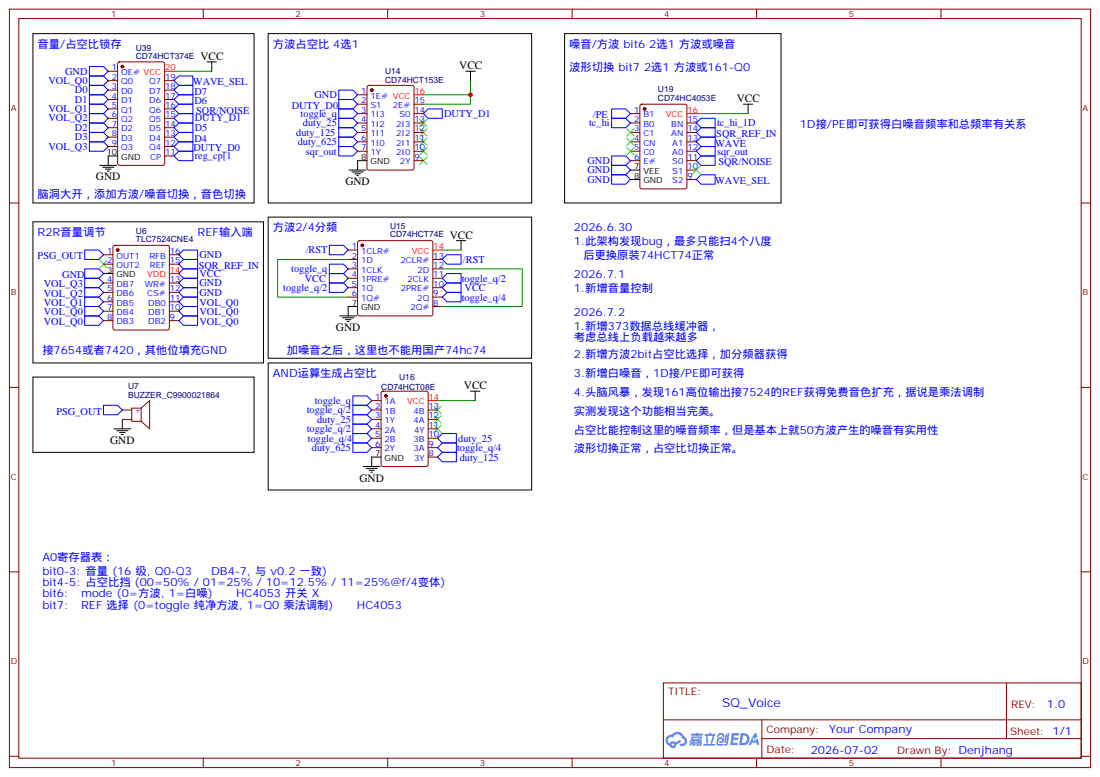
[picture p11: page 4]

脑洞大开，添加方波/噪音切换，音色切换

# TE 10 Q3 11 Q2 12 Q1 13 Q0 14 TC 15 VCC 16

## noise_clk = bind ? square_tc : ind_clk

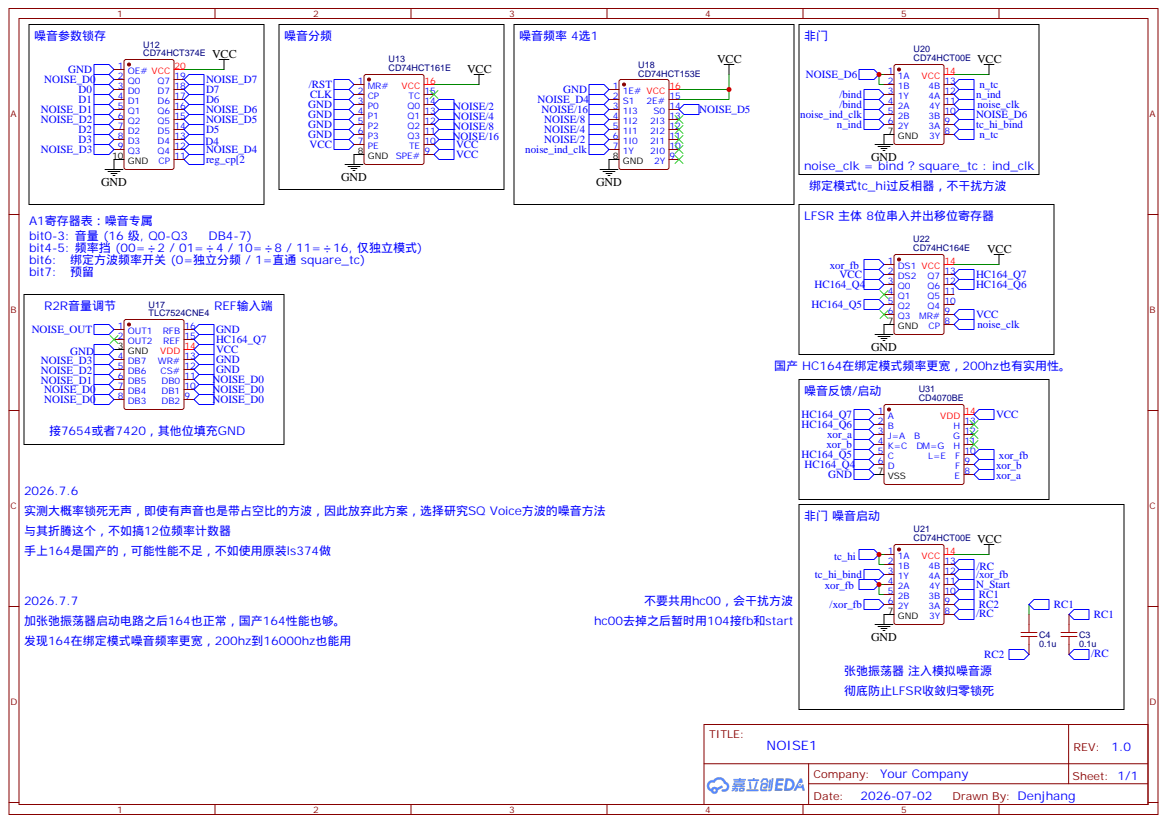
[picture p12: page 5]

# TE 10 Q3 11 Q2 12 Q1 13 Q0 14 TC 15 VCC 16

## 必须原装HCT74

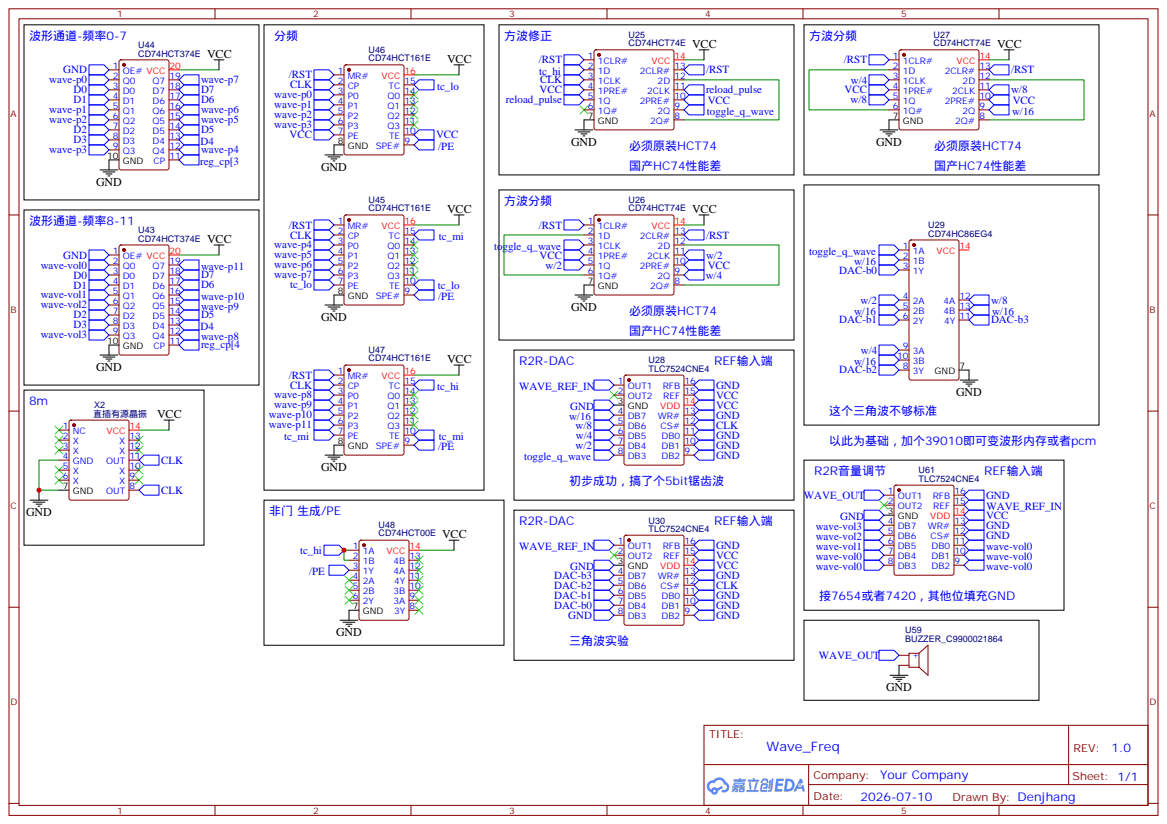
[picture p13: page 6]

# TE 10 Q3 11 Q2 12 Q1 13 Q0 14 TC 15 VCC 16

# TE 10 Q3 11 Q2 12 Q1 13 Q0 14 TC 15 VCC 16

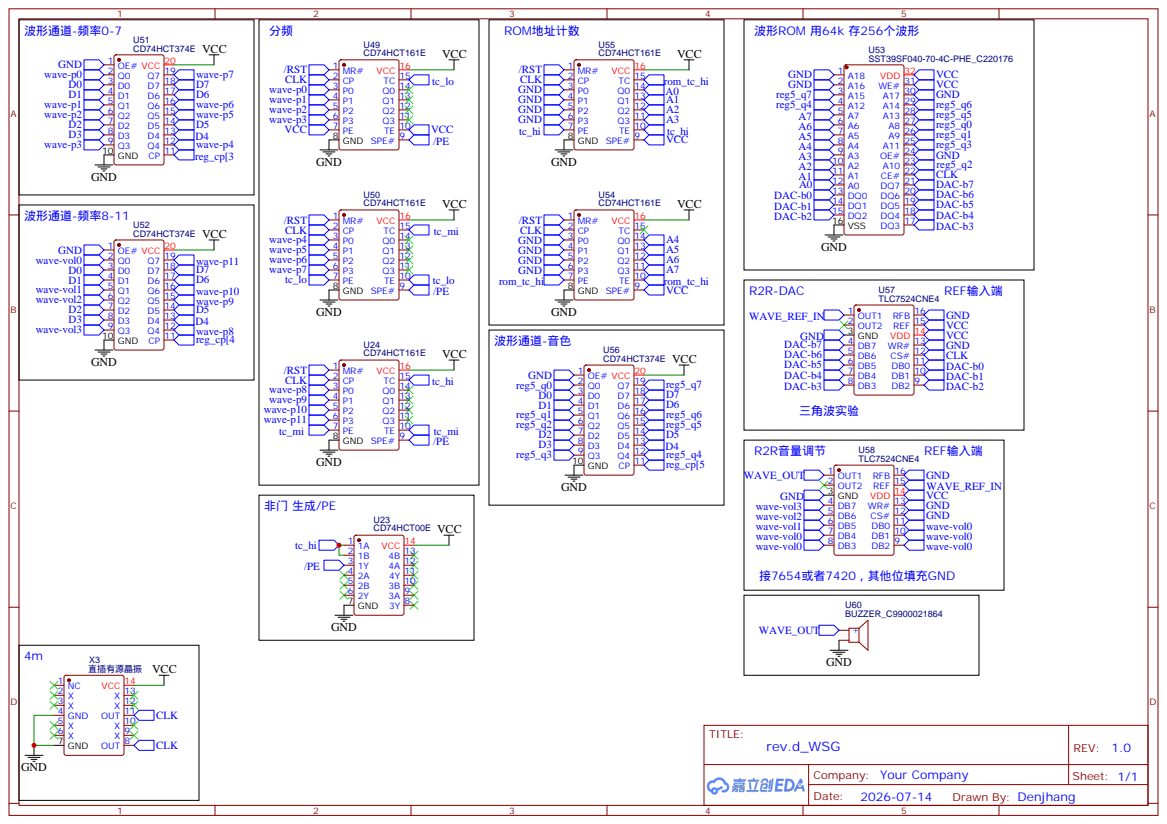
[picture p14: page 7]

## 波形ROM 用64k 存256个波形

# TE 10 Q3 11 Q2 12 Q1 13 Q0 14 TC 15 VCC 16

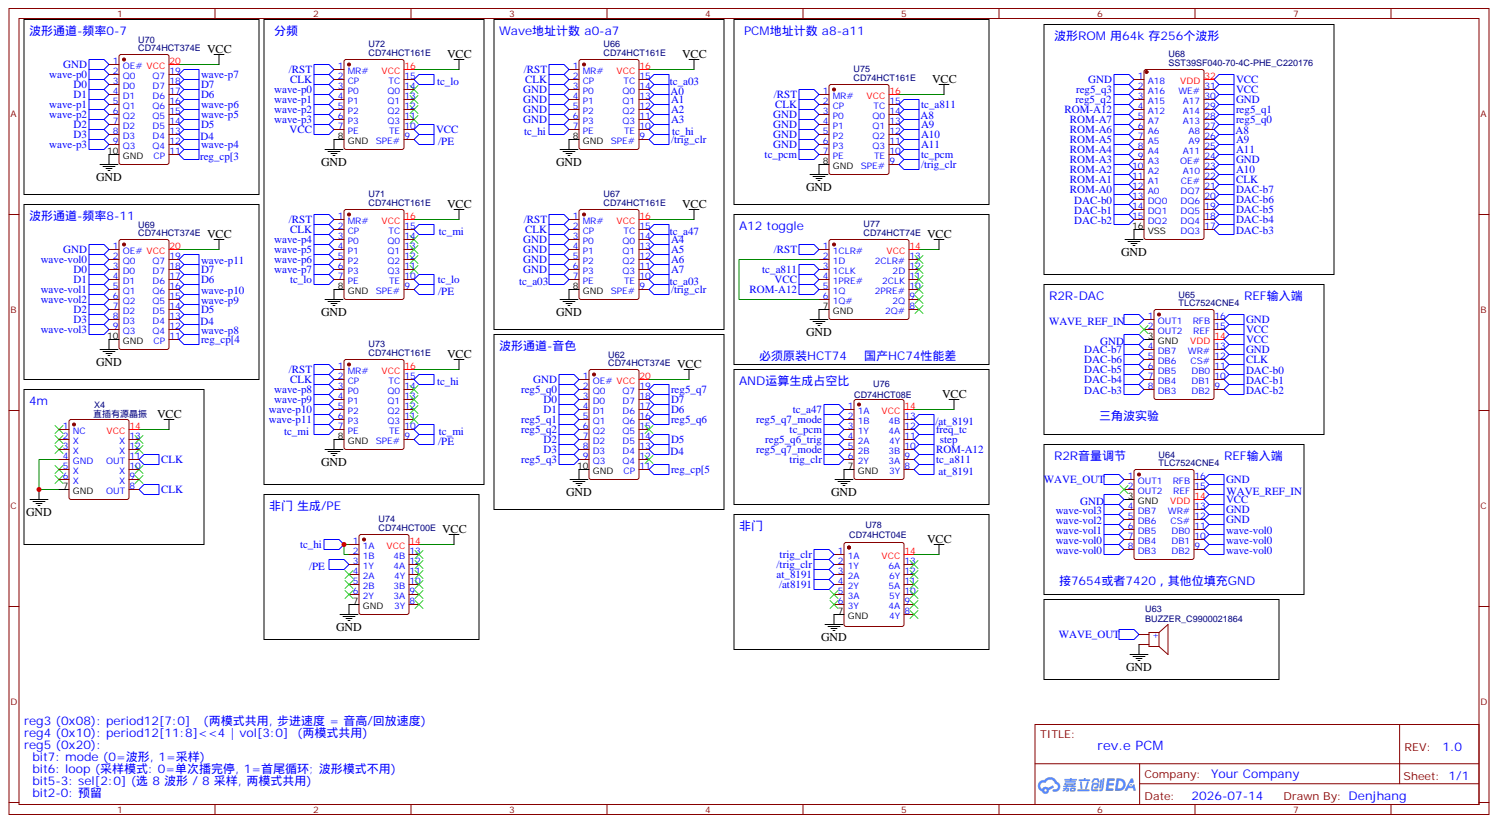
[picture p15: page 8]

reg3 (0x08): period12[7:0] (两模式共用, 步进速度 = 音高/回放速度)
reg4 (0x10): period12[11:8]<<4 | vol[3:0] (两模式共用)
reg5 (0x20):
bit7: mode (0=波形, 1=采样)
bit6: loop (采样模式: 0=单次播完停, 1=首尾循环; 波形模式不用)
bit5-3: sel[2:0] (选 8 波形 / 8 采样, 两模式共用)
bit2-0: 预留
