denjhang/74HC-Chiptune/psg_voice/PSG1 v0.1/Schematic_PSG1-v0.1_2026-06-30.pdf

# TE 10 Q3 11 Q2 12 Q1 13 Q0 14 TC 15 VCC 16

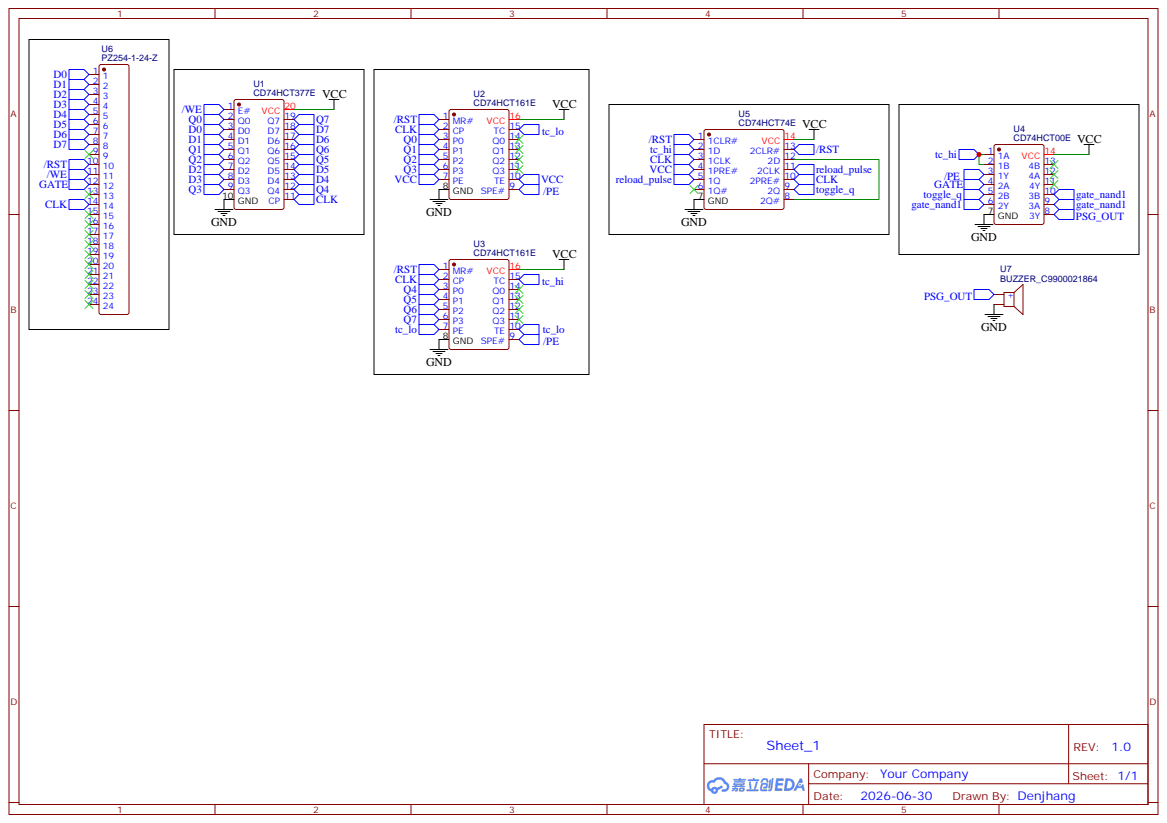
[picture p16: page 1]
