denjhang/74HC-Chiptune/(list of files, drawings)

Other design files:
psg_voice/PSG3 v0.5/sch/SCH_PSG4-v0.52_2026-07-15.json
