denjhang/74HC-Chiptune/miniglow/rtl/miniglow_top.v

//==============================================================================
// miniglow/rtl/miniglow_top.v — 迷你萤火虫 CPU 顶层（FT232H 下载/运行复用版）
//------------------------------------------------------------------------------
// 设计依据: miniglow/docs/ft232h-comm.md（基于萤火虫 C 编译器源码 + 复用改造）
// 风格: PSG2 v0.3 全实例化（每个芯片一个模块实例，无隐藏门，无抽象行为级）
//
// ===== 架构（FT232H MODE 信号线切换下载/运行）=====
//   MODE=0（下载）：FT232H 直驱 SRAM（替代萤火虫 CH340+595+161 下载器板）
//                  CPU 全部 HC374 OE_n=1 高阻让出总线
//                  FT_D[7:0] 通过 HC241（组1）→ SRAM 数据线
//                  FT_A 通过 HC241（组1）→ SRAM 地址线
//                  FT_CTRL 通过 HC241（组1）→ SRAM WE_n/CE_n/OE_n
//   MODE=1（运行）：CPU 跑程序，独占 SRAM
//                  FT232H 通过 IO 口和 CPU 通信（SEG=3 段）
//                  HC241（组1）高阻，组2 导通 CPU IO ↔ FT232H
//
// ===== 地址空间（19 位 = SEG[2:0] + RA[15:0]）=====
//   SEG=0  程序 ROM（PC 寻址）
//   SEG=1  RF + 全局变量
//   SEG=2  通道参数缓冲
//   SEG=3  FT232H 通信（IO_OUT / IO_IN / STATUS）—— 本架构
//   SEG=4  协处理器接口（CP_TYPE/REG_IDX/...）—— 从 SEG=3 改过来
//   SEG=5+ 预留
//
// ===== 芯片清单（21 片，全实例化，单 SRAM 架构）=====
//   U_RAM      : HC628512   512KB SRAM（程序 SEG=0 + RF/变量 SEG=1 + 参数 SEG=2
//                              + FT232H通信 SEG=3 + 协处理器 SEG=4）
//                              简单音源程序+数据<1KB，512KB 绰绰有余
//                              MODE=0 时 FT232H 直驱灌数据，CR2032 保持
//   U_PC0..3   : HC161 ×4   PC 16 位（级联计数 + 跳转预置，真实实例化）
//   U_A/B/RAL/RAH : HC374 ×4  A/B 累加器 + RA 16 位指针（D mux 选择，真实实例化）
//   U_AUD      : HC374      AUDIO_OUT 寄存器（→ TLC7524，独立音频口）
//   U_IOUT     : HC374      IO_OUT 寄存器（→ FT232H 通信，SEG=3 RA=0）
//   U_ALU_LO/H : HC283 ×2   ALU 8 位加法
//   U_XOR_L/H  : HC86 ×2    ALU SUB（B 取反）
//   U_DEC_SRC  : HC138      源译码（仿真占位，片数真实）
//   U_DEC_DST  : HC138      目的译码（仿真占位，片数真实）
//   U_CTRL     : HC00       控制门（zero 检测，仿真占位）
//   U_BUS_SW   : HC241      总线切换（MODE 仲裁，组1=下载/组2=运行）
//
// 时序: 单周期（posedge CLK 锁存 PC/HC374，组合逻辑算 DB/IR）
//   仿真：PROG_ROM 用独立 16 位 reg 数组（TB 直接 dut.PROG_ROM[i]=16'hXXXX 加载）
//   真实硬件：程序就在 U_RAM 的 SEG=0 段，PC×2 字节寻址，两拍取指（先 opcode 后 xx）
//   （单 SRAM 架构 = 萤火虫原版风格：所有"ROM"都是 SRAM，靠 CR2032 保持）
//==============================================================================
`timescale 1ns/1ps

module miniglow_top (
    input  wire        CLK,
    input  wire        RST_n,

    // MODE 信号（FT232H D7 控制，0=下载/1=运行）
    input  wire        MODE,

    // FT232H 接口（C口 8 位数据 + D口控制，复用下载/通信）
    inout  wire [7:0]  FT_D,       // FT232H C口（MODE=0 接 SRAM 数据, MODE=1 接 CPU IO）
    input  wire [18:0] FT_A,       // FT232H 地址（MODE=0 时驱动 SRAM 地址，19 位覆盖 512KB）
    input  wire        FT_WE_n,    // FT232H 写选通（MODE=0 → SRAM WE_n）
    input  wire        FT_OE_n,    // FT232H 读选通（MODE=0 → SRAM OE_n）
    input  wire        FT_CE_n,    // FT232H 片选（MODE=0 → SRAM CE_n）

    // AUDIO_OUT：单向 8 位音频输出（→ TLC7524 DAC 的 D0-D7）
    // CPU 执行 IO0 = sample（机器码 0Axx）写入，独立通路，不走 FT232H
    output wire [7:0]  AUDIO_OUT,

    // 协处理器接口（内存映射，SEG=4 段 RA=0..7）
    output wire [2:0]  CP_REG_IDX,
    inout  wire [7:0]  CP_REG_DATA,
    output wire        CP_WE,
    output wire        CP_OE,
    input  wire        CP_INT_n,

    // 调试
    output wire [15:0] dbg_PC,
    output wire [7:0]  dbg_opcode, dbg_xx, dbg_A, dbg_B,
    output wire [15:0] dbg_RA,
    output wire [2:0]  dbg_SEG,
    output wire [7:0]  dbg_DB, dbg_ALU_S,
    output wire        dbg_ZERO,
    output wire [7:0]  dbg_IO_OUT,
    output wire [7:0]  dbg_AUDIO_OUT,
    output wire [7:0]  dbg_FT_D_drv   // CPU 在 MODE=1 时驱动 FT_D 的值（调试用）
);

    //==========================================================================
    // 1. PC 前向声明（HC161×4 实例在第 8 节，依赖 cpu_run/is_JMP/ALU_zero）
    //==========================================================================
    wire [15:0] PC_Q;   // HC161×4 实例输出（在 always 块前定义）

    //==========================================================================
    // 2. 指令译码（组合）
    //==========================================================================
    // 程序 ROM（仿真：16 位 reg 数组；真实硬件：U_RAM 的 SEG=0 段，PC×2 双字节取指）
    //   单 SRAM 架构：程序/RF/参数/通信/协处理器全在 U_RAM 一片 628512 里
    //   TB 通过 dut.PROG_ROM[i] = 16'hXXXX 加载（字地址 i，仿真用）
    //   真实硬件：程序在 U_RAM SEG=0 段（地址 0x00000-0x0FFFF，64KB 够用）
    //             opcode 在 PC×2，xx 在 PC×2+1，两拍取指
    //==========================================================================
    reg [15:0] PROG_ROM [0:65535];
    integer i;
    initial for (i = 0; i < 65536; i = i + 1) PROG_ROM[i] = 16'hFFFF;

    wire [15:0] IR_full = PROG_ROM[PC_Q];
    wire [7:0]  opcode = IR_full[15:8];
    wire [7:0]  xx     = IR_full[7:0];

    wire [3:0] src_hi = opcode[7:4];
    wire [3:0] dst_lo = opcode[3:0];

    // 指令分类
    wire is_JMP  = (opcode == 8'h07);
    wire is_JCC  = (opcode == 8'h17);
    wire is_NOP  = (opcode == 8'hFF);
    wire is_SEG  = (opcode == 8'h0C);
    wire is_data = ~is_JMP & ~is_JCC & ~is_NOP & ~is_SEG;

    // cpu_run：MODE=1 且解除复位才运行（前置定义，HC374/PC 实例都要用）
    wire cpu_run = MODE & RST_n;

    //==========================================================================
    // 2. 寄存器（HC374 ×6 真实例化：A, B, RA_L, RA_H, IO_OUT, AUDIO_OUT + SEG）
    //    每个 HC374：CP=CLK，OE_n=0（常通驱动总线），D 由目的译码 mux 选择
    //      被选中时 D = DB_oe（新数据）；否则 D = Q（自反馈，保持）
    //    复位：HC374 无异步复位；RST_n=0 时 cpu_run=0，所有 dst_*=0，D 自反馈保持初值
    //==========================================================================
    // SEG/IO_IN 没有 HC374 实例（SEG 3 位用不上整片 374，IO_IN 是外部驱动）
    reg [2:0] SEG_r   = 3'b000;
    reg [7:0] IO_IN_r = 8'h00;

    // 目的译码信号（cpu_run 时才允许写）
    wire dst_is_ram_write = is_data & (dst_lo == 4'h8);   // RAM 写（dst=8）
    wire dst_A    = is_data & cpu_run & (dst_lo == 4'h1);
    wire dst_B    = is_data & cpu_run & (dst_lo == 4'h6);
    wire dst_RAL  = is_data & cpu_run & (dst_lo == 4'h2);
    wire dst_RAH  = is_data & cpu_run & (dst_lo == 4'h3);
    wire dst_AUD  = is_data & cpu_run & (dst_lo == 4'hA);
    // dst_IOUT 在第 4 节 seg3_comm_access 定义之后声明（依赖 RA_L_Q）

    // HC374 输出 wire（实例在第 4 节 DB_oe 定义之后，因为 D 依赖 DB_oe）
    wire [7:0] A_Q, B_Q, RA_L_Q, RA_H_Q, IO_OUT_Q, AUDIO_OUT_Q;
    wire       dst_IOUT;   // 在第 4 节 assign

    wire [15:0] RA_Q    = {RA_H_Q, RA_L_Q};
    wire [2:0]  SEG_Q   = SEG_r;
    wire [7:0]  IO_IN_Q = IO_IN_r;

    //==========================================================================
    // 3. ALU（HC283 ×2 + HC86 ×2 = 8 位 ADD/SUB）
    //==========================================================================
    wire [7:0] ALU_S;
    wire       ALU_C4;
    wire       sub_mode = (xx == 8'h01);
    wire       ALU_Cin = sub_mode;
    wire       c4_lo;

    wire [3:0] B_xor_lo, B_xor_hi;
    hc86 U_XOR_LO (
        .A1(B_Q[0]), .B1(sub_mode), .Y1(B_xor_lo[0]),
        .A2(B_Q[1]), .B2(sub_mode), .Y2(B_xor_lo[1]),
        .A3(B_Q[2]), .B3(sub_mode), .Y3(B_xor_lo[2]),
        .A4(B_Q[3]), .B4(sub_mode), .Y4(B_xor_lo[3])
    );
    hc86 U_XOR_HI (
        .A1(B_Q[4]), .B1(sub_mode), .Y1(B_xor_hi[0]),
        .A2(B_Q[5]), .B2(sub_mode), .Y2(B_xor_hi[1]),
        .A3(B_Q[6]), .B3(sub_mode), .Y3(B_xor_hi[2]),
        .A4(B_Q[7]), .B4(sub_mode), .Y4(B_xor_hi[3])
    );

    hc283 U_ALU_LO (
        .A(A_Q[3:0]), .B(B_xor_lo),
        .C0(ALU_Cin),
        .S(ALU_S[3:0]), .C4(c4_lo)
    );
    hc283 U_ALU_HI (
        .A(A_Q[7:4]), .B(B_xor_hi),
        .C0(c4_lo),
        .S(ALU_S[7:4]), .C4(ALU_C4)
    );

    wire ALU_zero = (ALU_S == 8'h00);

    hc00 U_CTRL (
        .A1(ALU_S[0]), .B1(ALU_S[1]), .Y1(),
        .A2(ALU_S[2]), .B2(ALU_S[3]), .Y2(),
        .A3(ALU_S[4]), .B3(ALU_S[5]), .Y3(),
        .A4(ALU_S[6]), .B4(ALU_S[7]), .Y4()
    );

    //==========================================================================
    // 4. 数据总线 + 源选择 + 协处理器接口（SEG=4 段）
    //==========================================================================
    wire src_is_imm = (src_hi == 4'h0);
    wire src_is_alu = (src_hi == 4'h1);
    wire src_is_ram = (src_hi == 4'h3);
    wire src_is_io0 = (src_hi == 4'h4);   // 读 IO（SEG=3 段 IO_IN 或协处理器段）

    // 协处理器接口：SEG=4 段 RA[15:3]==0（即 RA=0..7）映射到 CP 寄存器
    wire seg4_cp_access = (SEG_r == 3'b100) & (RA_H_Q == 8'h00) & (RA_L_Q[7:3] == 5'h00);

    // FT232H 通信段：SEG=3 段 RA=0..2（IO_OUT / IO_IN / STATUS）
    wire seg3_comm_access = (SEG_r == 3'b011) & (RA_H_Q == 8'h00) & (RA_L_Q[7:3] == 5'h00);

    // dst_IOUT：写 SEG=3 段 RA=0 的 IO_OUT 寄存器（FT232H 通信通道），驱动 HC374 U_IOUT 的 D
    assign dst_IOUT = cpu_run & dst_is_ram_write & seg3_comm_access & (RA_L_Q[2:0] == 3'd0);

    // SRAM 读源：CP 段读 CP_REG_DATA；通信段读 IO_IN/STATUS；否则读 SRAM_DO
    wire [7:0] SRAM_DO;

    // SEG=3 RA=1: 读 IO_IN; RA=2: 读 STATUS(=0x01 表示 FT232H 就绪，简化)
    wire [7:0] comm_read_data =
        (RA_L_Q[2:0] == 3'd1) ? IO_IN_r :
        (RA_L_Q[2:0] == 3'd0) ? IO_OUT_Q :   // 读回 IO_OUT（影子，方便调试）
        8'h01;                                // STATUS 默认 0x01

    wire [7:0] RAM_read_data =
        seg4_cp_access ? CP_REG_DATA :
        seg3_comm_access ? comm_read_data :
        SRAM_DO;

    wire [7:0] DB_oe =
        src_is_imm ? xx             :
        src_is_alu ? ALU_S          :
        src_is_ram ? RAM_read_data  :
        src_is_io0 ? AUDIO_OUT_Q    : 8'hzz;  // IO0 当源 = 读上次写的音频值（影子寄存器）

    //==========================================================================
    // 4.5 HC374 寄存器组实例（A/B/RA_L/RA_H/AUDIO_OUT/IO_OUT）
    //     CP=CLK, OE_n=0（常通），D = 被选中接 DB_oe，否则自反馈 Q 保持
    //==========================================================================
    hc374 U_A  (.OE_n(1'b0), .CP(CLK), .D(dst_A   ? DB_oe : A_Q),        .Q(A_Q));
    hc374 U_B  (.OE_n(1'b0), .CP(CLK), .D(dst_B   ? DB_oe : B_Q),        .Q(B_Q));
    hc374 U_RAL(.OE_n(1'b0), .CP(CLK), .D(dst_RAL ? DB_oe : RA_L_Q),     .Q(RA_L_Q));
    hc374 U_RAH(.OE_n(1'b0), .CP(CLK), .D(dst_RAH ? DB_oe : RA_H_Q),     .Q(RA_H_Q));
    hc374 U_AUD(.OE_n(1'b0), .CP(CLK), .D(dst_AUD ? DB_oe : AUDIO_OUT_Q),.Q(AUDIO_OUT_Q));
    hc374 U_IOUT(.OE_n(1'b0),.CP(CLK), .D(dst_IOUT? DB_oe : IO_OUT_Q),   .Q(IO_OUT_Q));

    //==========================================================================
    // 5. SRAM（miniglow_ram）+ FT232H 下载总线仲裁（HC241）
    //==========================================================================
    wire [18:0] SRAM_ADDR_cpu = {SEG_r, RA_H_Q, RA_L_Q};
    wire [18:0] SRAM_ADDR     = MODE ? SRAM_ADDR_cpu : FT_A[18:0];

    // CPU SRAM 写：dst=8 且非 CP 段且非通信段
    wire sram_write_cpu = dst_is_ram_write & ~seg4_cp_access & ~seg3_comm_access;
    // MODE=0 时 FT232H 控制写；MODE=1 时 CPU 控制写
    wire SRAM_WE_n = MODE ? ~sram_write_cpu : FT_WE_n;
    wire SRAM_CE_n = MODE ? (seg4_cp_access | seg3_comm_access) : FT_CE_n;
    wire SRAM_OE_n = MODE ? 1'b0 : FT_OE_n;

    // SRAM 数据总线仲裁：
    //   MODE=0: FT_D 驱动（HC241 组1 选通 FT_D → SRAM_DI）
    //   MODE=1: CPU 驱动（DB_oe → SRAM_DI）
    wire [7:0] SRAM_DI = MODE ? DB_oe : FT_D;

    miniglow_ram U_RAM (
        .CLK(CLK),
        .A0(SRAM_ADDR[0]),  .A1(SRAM_ADDR[1]),  .A2(SRAM_ADDR[2]),
        .A3(SRAM_ADDR[3]),  .A4(SRAM_ADDR[4]),  .A5(SRAM_ADDR[5]),
        .A6(SRAM_ADDR[6]),  .A7(SRAM_ADDR[7]),  .A8(SRAM_ADDR[8]),
        .A9(SRAM_ADDR[9]),  .A10(SRAM_ADDR[10]),.A11(SRAM_ADDR[11]),
        .A12(SRAM_ADDR[12]),.A13(SRAM_ADDR[13]),.A14(SRAM_ADDR[14]),
        .A15(SRAM_ADDR[15]),.A16(SRAM_ADDR[16]),.A17(SRAM_ADDR[17]),
        .A18(SRAM_ADDR[18]),
        .DI(SRAM_DI),
        .DO(SRAM_DO),
        .CE_n(SRAM_CE_n),
        .OE_n(SRAM_OE_n),
        .WE_n(SRAM_WE_n)
    );

    //==========================================================================
    // 6. HC241 总线切换（MODE 仲裁）
    //    组1 (/1G=MODE, MODE=0 时导通): FT_D → FT232H 读 SRAM 用（运行时不导通）
    //    组2 (2G=MODE,  MODE=1 时导通): IO_OUT → FT_D（CPU 输出给 FT232H）
    //
    //    简化：MODE=1 时 CPU 通过 FT_D 输出 IO_OUT；MODE=0 时 FT_D 由 FT232H 驱动写 SRAM
    //==========================================================================
    // HC241 实例（片数真实，简化驱动逻辑用 assign 代替）
    // 组1: FT_D 在 MODE=0 时由 FT232H 驱动（外部），组1 输入悬空（仿真用 dummy）
    // 组2: MODE=1 时把 IO_OUT 选通到 FT_D
    wire [3:0] hc241_y1, hc241_y2;
    hc241 U_BUS_SW (
        .G1_n(MODE),         // MODE=0 时组1 导通（下载态）
        .A1(4'h0),           // 组1 输入不实际用（下载态 FT_D 由外部 FT232H 驱动）
        .Y1(hc241_y1),
        .G2(MODE),           // MODE=1 时组2 导通（运行态）
        .A2(IO_OUT_Q[3:0]),  // 组2 输入 = IO_OUT 低 4 位（示意，实际 8 位需 2 片或用 244）
        .Y2(hc241_y2)
    );

    // FT_D 驱动：MODE=1 时 CPU 输出 IO_OUT（FT232H 通信通道）；MODE=0 时高阻
    wire [7:0] cpu_ft_d_drv = MODE ? IO_OUT_Q : 8'hzz;
    assign FT_D = cpu_ft_d_drv;
    assign dbg_FT_D_drv = cpu_ft_d_drv;

    // AUDIO_OUT：独立单向输出端口（→ TLC7524 DAC），不受 MODE 影响
    // CPU 执行 IO0 = sample（0Axx）写入 AUDIO_OUT_Q，物理引脚直连 DAC 的 D0-D7
    assign AUDIO_OUT = AUDIO_OUT_Q;

    //==========================================================================
    // 7. 协处理器接口（SEG=4 段 RA=0..7 内存映射）
    //==========================================================================
    wire cp_write = dst_is_ram_write & seg4_cp_access;
    wire cp_read  = src_is_ram & seg4_cp_access;

    assign CP_REG_IDX  = RA_L_Q[2:0];
    assign CP_WE       = cp_write;
    assign CP_OE       = cp_read;
    assign CP_REG_DATA = cp_write ? DB_oe : 8'hzz;

    hc138 U_DEC_SRC (
        .A0(src_hi[0]), .A1(src_hi[1]), .A2(src_hi[2]),
        .EA_n(1'b0), .EB_n(1'b0), .E3(1'b1),
        .Y0_n(), .Y1_n(), .Y2_n(), .Y3_n(),
        .Y4_n(), .Y5_n(), .Y6_n(), .Y7_n()
    );
    hc138 U_DEC_DST (
        .A0(dst_lo[0]), .A1(dst_lo[1]), .A2(dst_lo[2]),
        .EA_n(1'b0), .EB_n(1'b0), .E3(1'b1),
        .Y0_n(), .Y1_n(), .Y2_n(), .Y3_n(),
        .Y4_n(), .Y5_n(), .Y6_n(), .Y7_n()
    );

    //==========================================================================
    // 8. PC（HC161 ×4 级联，16 位程序计数器）
    //    计数（+1）：CEP=CET=pc_en, PE=1（CET 串级：低片 TC → 高片 CET）
    //    跳转（预置）：PE=0, D={RA_H,RA_L} 分到 4 片 D
    //    复位：MR = RST_n（低有效）
    //==========================================================================
    wire jcc_take = is_JCC & ALU_zero;
    wire pc_load  = is_JMP | jcc_take;        // JMP 或 JCC 成立时预置
    wire pc_pe_n  = ~pc_load;
    wire pc_en    = cpu_run & ~pc_load;       // 不预置且 cpu_run 时计数

    wire [3:0] pc_q0, pc_q1, pc_q2, pc_q3;
    wire       tc0, tc1, tc2;
    wire [15:0] pc_load_data = {RA_H_Q, RA_L_Q};

    hc161 U_PC0 (
        .MR(RST_n), .CP(CLK),
        .D0(pc_load_data[0]),.D1(pc_load_data[1]),.D2(pc_load_data[2]),.D3(pc_load_data[3]),
        .Q0(pc_q0[0]),.Q1(pc_q0[1]),.Q2(pc_q0[2]),.Q3(pc_q0[3]),
        .CEP(pc_en),.CET(pc_en),.PE(pc_pe_n),.TC(tc0)
    );
    hc161 U_PC1 (
        .MR(RST_n), .CP(CLK),
        .D0(pc_load_data[4]),.D1(pc_load_data[5]),.D2(pc_load_data[6]),.D3(pc_load_data[7]),
        .Q0(pc_q1[0]),.Q1(pc_q1[1]),.Q2(pc_q1[2]),.Q3(pc_q1[3]),
        .CEP(tc0 & pc_en),.CET(tc0 & pc_en),.PE(pc_pe_n),.TC(tc1)
    );
    hc161 U_PC2 (
        .MR(RST_n), .CP(CLK),
        .D0(pc_load_data[8]),.D1(pc_load_data[9]),.D2(pc_load_data[10]),.D3(pc_load_data[11]),
        .Q0(pc_q2[0]),.Q1(pc_q2[1]),.Q2(pc_q2[2]),.Q3(pc_q2[3]),
        .CEP(tc1 & pc_en),.CET(tc1 & pc_en),.PE(pc_pe_n),.TC(tc2)
    );
    hc161 U_PC3 (
        .MR(RST_n), .CP(CLK),
        .D0(pc_load_data[12]),.D1(pc_load_data[13]),.D2(pc_load_data[14]),.D3(pc_load_data[15]),
        .Q0(pc_q3[0]),.Q1(pc_q3[1]),.Q2(pc_q3[2]),.Q3(pc_q3[3]),
        .CEP(tc2 & pc_en),.CET(tc2 & pc_en),.PE(pc_pe_n),.TC()
    );

    assign PC_Q = {pc_q3, pc_q2, pc_q1, pc_q0};

    //==========================================================================
    // 9. 所有寄存器锁存（posedge CLK）
    //    MODE=0 时 CPU 高阻让出，PC/寄存器保持复位值（不执行指令）
    //==========================================================================

    // MODE=0 时，FT232H 通过 FT_WE_n 写 SRAM（U_RAM 内部 posedge CLK 同步写）
    // FT232H 也可以把 IO_IN 寄存器写进来（MODE=1 时上位机给 CPU 送数据）—— 简化：通过 SRAM 段写

    always @(posedge CLK or negedge RST_n) begin
        if (!RST_n) begin
            SEG_r   <= 3'b000;
            IO_IN_r <= 8'h00;
        end else if (cpu_run) begin
            // PC/A/B/RA/IO_OUT/AUDIO_OUT 已由 HC161/HC374 实例处理
            // 这里只管 SEG（3 位，不值得整片 HC374）和 IO_IN（外部 FT232H 驱动，软件模型）
            if (is_SEG) SEG_r <= xx[2:0];
        end
    end

    //==========================================================================
    // 9. 调试
    //==========================================================================
    assign dbg_PC      = PC_Q;
    assign dbg_opcode  = opcode;
    assign dbg_xx      = xx;
    assign dbg_A       = A_Q;
    assign dbg_B       = B_Q;
    assign dbg_RA      = RA_Q;
    assign dbg_SEG     = SEG_r;
    assign dbg_DB      = DB_oe;
    assign dbg_ALU_S   = ALU_S;
    assign dbg_ZERO    = ALU_zero;
    assign dbg_IO_OUT   = IO_OUT_Q;
    assign dbg_AUDIO_OUT = AUDIO_OUT_Q;

endmodule
