denjhang/74HC-Chiptune/Glowworm-1/compiler/glow.cpp

/**********************************************/
/*
/*		萤火虫1号C编译器后端	2022  龙少
/*
/**********************************************/

#include "pch.h"
#include "c.h"
#define I(f) l_##f

static char rcsid[] = "$Id$";

unsigned char optimize;	//优化等级,0级为不优化
static int cseg;		//记录当前段

/****************************************CPU指令生成****************************************/

#define REGISTER_FILE_SP 0						//堆栈页指针
#define REGISTER_FILE_RET_VALUE 2				//函数返回值寄存器地址
#define REGISTER_FILE_OP_FUNC_LOP 10			//运算函数左操作数寄存器地址
#define REGISTER_FILE_OP_FUNC_ROP 18			//运算函数右操作数寄存器地址
#define REGISTER_FILE_OP_FUNC_DOP 26			//运算函数目的操作数寄存器地址
#define REGISTER_FILE_OP_FUNC_RET 34			//运算函数存放返回地址的寄存器地址
#define REGISTER_FILE_OP_FUNC_CACHE 37			//运算函数缓存区寄存器地址
#define REGISTER_FILE_OP_FUNC_CACHE_SKIP 19		//运算函数缓存区大小

#define ROM_SIZE 1048576			//ROM大小
#define VA_ARG_BUF_SIZE 1024		//可变参数缓冲区大小
unsigned long sp0_init_romaddr;		//栈页低8位初始化值所在ROM地址
unsigned long sp1_init_romaddr;		//栈页高8位初始化值所在ROM地址
unsigned long romentry;				//ROM入口跳转指令地址
unsigned long ramallocaddr;			//RAM内存分配地址(全局初始化)
unsigned char romdata[ROM_SIZE];	//ROM数据
unsigned long rom_cp;				//ROM使用计数(全局初始化)
unsigned long rom_cp_max;			//ROM使用最大值

struct CPU_O{
	enum {
		REG_X = -1, REG_F = 256
	};
	short ra;
	short a0;
	short a1;
	short a2;
}cpu;

/*以下为单指令*/
void ROM_ADD_INS(unsigned char, unsigned char); //ROM添加指令
void RF_ASGN_IMMNUM(unsigned char); //RF等于立即数
void A_ASGN_IMMNUM(unsigned char); //A等于立即数
void A0_ASGN_IMMNUM(unsigned char); //A0等于立即数
void A1_ASGN_IMMNUM(unsigned char); //A1等于立即数
void A2_ASGN_IMMNUM(unsigned char); //A2等于立即数
void RA_ASGN_IMMNUM(unsigned char); //RA等于立即数
void B_ASGN_IMMNUM(unsigned char); //B等于立即数
void RAM_ASGN_IMMNUM(unsigned char); //RAM等于立即数
void IO0_ASGN_IMMNUM(unsigned char); //IO0等于立即数
void IO1_ASGN_IMMNUM(unsigned char); //IO1等于立即数

void RF_ASGN_ALU(unsigned char); //RF等于ALU
void A_ASGN_ALU(unsigned char); //A等于ALU
void A0_ASGN_ALU(unsigned char); //A0等于ALU
void A1_ASGN_ALU(unsigned char); //A1等于ALU
void A2_ASGN_ALU(unsigned char); //A2等于ALU
void RA_ASGN_ALU(unsigned char); //RA等于ALU
void B_ASGN_ALU(unsigned char); //B等于ALU
void RAM_ASGN_ALU(unsigned char); //RAM等于ALU
void IO0_ASGN_ALU(unsigned char); //IO0等于ALU
void IO1_ASGN_ALU(unsigned char); //IO1等于ALU

void A_ASGN_RF(void); //A等于RF
void A0_ASGN_RF(void); //A0等于RF
void A1_ASGN_RF(void); //A1等于RF
void A2_ASGN_RF(void); //A2等于RF
void RA_ASGN_RF(void); //RA等于RF
void B_ASGN_RF(void); //B等于RF
void RAM_ASGN_RF(void); //RAM等于RF
void ALU_ASGN_RF(unsigned char); //ALU等于RF
void IO0_ASGN_RF(void); //IO0等于RF
void IO1_ASGN_RF(void); //IO1等于RF

void RF_ASGN_RAM(void); //RF等于RAM
void A_ASGN_RAM(void); //A等于RAM
void A0_ASGN_RAM(void); //A0等于RAM
void A1_ASGN_RAM(void); //A1等于RAM
void A2_ASGN_RAM(void); //A2等于RAM
void RA_ASGN_RAM(void); //RA等于RAM
void B_ASGN_RAM(void); //B等于RAM
void ALU_ASGN_RAM(unsigned char); //ALU等于RAM
void IO0_ASGN_RAM(void); //IO0等于RAM
void IO1_ASGN_RAM(void); //IO1等于RAM

void RF_ASGN_IO0(void); //RF等于IO0
void A_ASGN_IO0(void); //A等于IO0
void A0_ASGN_IO0(void); //A0等于IO0
void A1_ASGN_IO0(void); //A1等于IO0
void A2_ASGN_IO0(void); //A2等于IO0
void RA_ASGN_IO0(void); //RA等于IO0
void B_ASGN_IO0(void); //B等于IO0
void RAM_ASGN_IO0(void); //RAM等于IO0
void ALU_ASGN_IO0(unsigned char); //ALU等于IO0
void IO0_ASGN_IO0(void); //IO0等于IO0
void IO1_ASGN_IO0(void); //IO1等于IO0

void RF_ASGN_IO1(void); //RF等于IO1
void A_ASGN_IO1(void); //A等于IO1
void A0_ASGN_IO1(void); //A0等于IO1
void A1_ASGN_IO1(void); //A1等于IO1
void A2_ASGN_IO1(void); //A2等于IO1
void RA_ASGN_IO1(void); //RA等于IO1
void B_ASGN_IO1(void); //B等于IO1
void RAM_ASGN_IO1(void); //RAM等于IO1
void ALU_ASGN_IO1(unsigned char); //ALU等于IO1
void IO0_ASGN_IO1(void); //IO0等于IO1
void IO1_ASGN_IO1(void); //IO1等于IO1

void PC_ASGN_A2A1A0(void); //PC等于A2A1A0 (无条件跳转)
void IFALU_PC_ASGN_A2A1A0(unsigned char); //判断ALU输出,控制PC是否等于A2A1A0 (条件跳转)
void IFRF_PC_ASGN_A2A1A0(void); //判断RF输出,控制PC是否等于A2A1A0 (条件跳转)

void NOP(); //空操作

/*以下为组合指令*/
void A2A1A0_ASGN_IMMNUM(unsigned long); //A2A1A0等于立即数
void A2A1A0_ASGN_IMMNUM_O(unsigned long); //A2A1A0等于立即数,带优化
void PC_ASGN_IMMNUM(unsigned long); //PC等于立即数(无条件跳转)
void IFALU_PC_ASGN_IMMNUM(unsigned char, unsigned long); //判断ALU输出,控制PC是否等于立即数 (条件跳转)
void IFRF_PC_ASGN_IMMNUM(unsigned long); //判断RF输出,控制PC是否等于立即数 (条件跳转)

/*修改ROM内容*/
void MODIFY_A2A1A0(unsigned long, unsigned long); //修改A2A1A0

/*以下为不带优化的组合指令*/
void A_ASGN__RF(unsigned char); //A等于RF
void A0_ASGN__RF(unsigned char); //A0等于RF
void A1_ASGN__RF(unsigned char); //A1等于RF
void A2_ASGN__RF(unsigned char); //A2等于RF
void RA_ASGN__RF(unsigned char); //RA等于RF
void B_ASGN__RF(unsigned char); //B等于RF
void RAM_ASGN__RF(unsigned char); //RAM等于RF
void ALU_ASGN__RF(unsigned char, unsigned char); //ALU等于RF
void IO0_ASGN__RF(unsigned char); //IO0等于RF
void IO1_ASGN__RF(unsigned char); //IO1等于RF

void _RF_ASGN_IMMNUM(unsigned char, unsigned char); //RF等于立即数
void _RF_ASGN_ALU(unsigned char, unsigned char); //RF等于ALU
void _RF_ASGN_RAM(unsigned char); //RF等于RAM
void _RF_ASGN_IO0(unsigned char); //RF等于IO0
void _RF_ASGN_IO1(unsigned char); //RF等于IO1

void RF_ASGN__RAM(unsigned long); //RF等于RAM
void A_ASGN__RAM(unsigned long); //A等于RAM
void A0_ASGN__RAM(unsigned long); //A0等于RAM
void A1_ASGN__RAM(unsigned long); //A1等于RAM
void A2_ASGN__RAM(unsigned long); //A2等于RAM
void RA_ASGN__RAM(unsigned long); //RA等于RAM
void B_ASGN__RAM(unsigned long); //B等于RAM
void ALU_ASGN__RAM(unsigned char, unsigned long); //ALU等于RAM
void IO0_ASGN__RAM(unsigned long); //IO0等于RAM
void IO1_ASGN__RAM(unsigned long); //IO1等于RAM

void _RAM_ASGN_IMMNUM(unsigned long, unsigned char); //RAM等于立即数
void _RAM_ASGN_ALU(unsigned long, unsigned char); //RAM等于ALU
void _RAM_ASGN_RF(unsigned long); //RAM等于RF
void _RAM_ASGN_IO0(unsigned long); //RAM等于IO0
void _RAM_ASGN_IO1(unsigned long); //RAM等于IO1

void _RAM_ASGN__RF(unsigned long, unsigned char); //RAM等于RF
void _RF_ASGN__RAM(unsigned char, unsigned long); //RF等于RAM

/*以下为带优化的单指令*/
void A0_ASGN_IMMNUM_O(unsigned char);

/*以下为带优化的组合指令*/
void A_ASGN__RF_O(unsigned char); //A等于RF
void A0_ASGN__RF_O(unsigned char); //A0等于RF
void A1_ASGN__RF_O(unsigned char); //A1等于RF
void A2_ASGN__RF_O(unsigned char); //A2等于RF
void RA_ASGN__RF_O(unsigned char); //RA等于RF
void B_ASGN__RF_O(unsigned char); //B等于RF
void RAM_ASGN__RF_O(unsigned char); //RAM等于RF
void ALU_ASGN__RF_O(unsigned char, unsigned char); //ALU等于RF
void IO0_ASGN__RF_O(unsigned char); //IO0等于RF
void IO1_ASGN__RF_O(unsigned char); //IO1等于RF

void _RF_ASGN_IMMNUM_O(unsigned char, unsigned char); //RF等于立即数
void _RF_ASGN_ALU_O(unsigned char, unsigned char); //RF等于ALU
void _RF_ASGN_RAM_O(unsigned char); //RF等于RAM
void _RF_ASGN_IO0_O(unsigned char); //RF等于IO0
void _RF_ASGN_IO1_O(unsigned char); //RF等于IO1

void RF_ASGN__RAM_O(unsigned long); //RF等于RAM
void A_ASGN__RAM_O(unsigned long); //A等于RAM
void A0_ASGN__RAM_O(unsigned long); //A0等于RAM
void A1_ASGN__RAM_O(unsigned long); //A1等于RAM
void A2_ASGN__RAM_O(unsigned long); //A2等于RAM
void RA_ASGN__RAM_O(unsigned long); //RA等于RAM
void B_ASGN__RAM_O(unsigned long); //B等于RAM
void ALU_ASGN__RAM_O(unsigned char, unsigned long); //ALU等于RAM
void IO0_ASGN__RAM_O(unsigned long); //IO0等于RAM
void IO1_ASGN__RAM_O(unsigned long); //IO1等于RAM

void _RAM_ASGN_IMMNUM_O(unsigned long, unsigned char); //RAM等于立即数
void _RAM_ASGN_ALU_O(unsigned long, unsigned char); //RAM等于ALU
void _RAM_ASGN_RF_O(unsigned long); //RAM等于RF
void _RAM_ASGN_IO0_O(unsigned long); //RAM等于IO0
void _RAM_ASGN_IO1_O(unsigned long); //RAM等于IO1

void _RAM_ASGN__RF_O(unsigned long, unsigned char); //RAM等于RF
void _RF_ASGN__RAM_O(unsigned char, unsigned long); //RF等于RAM


/*ALU运算模式定义*/
enum {
	ALU_ADD = 0,	//A加B
	ALU_SUB,		//A减B
	ALU_ADD_C,		//A加B输出进位0x01
	ALU_SUB_C,		//A减B输出借位0x01
	ALU_EQUAL_C,	//A等于B输出0x01
	ALU_AND,		//A与B
	ALU_OR,			//A或B
	ALU_A_NOT,		//A取反
	ALU_XOR,		//A异或B
	ALU_A_BH_LSH,	//A带B最高位左移1位
	ALU_B_AL_RSH,	//B带A最低位右移1位
	ALU_A_AH_RSH,	//A带A最高位右移1位
	ALU_A_0_RSH,	//A带0右移1位
	ALU_A_0_LSH,	//A带0左移1位
	ALU_B_0_LSH,	//B带0左移1位
	ALU_MUL_L,		//A乘以B输出低8位
	ALU_MUL_H,		//A乘以B输出高8位
	ALU_DIV,		//A除以B
	ALU_MOD,		//A取余B
	ALU_A_ADD_1,	//A加1
	ALU_A_SUB_1,	//A减1
	ALU_A_ADD_1_C,	//A加1输出进位0x01
	ALU_A_SUB_1_C,	//A减1输出借位0x01
	ALU_OUTA,		//输出A
	ALU_OUTB		//输出B
};

/*复位优化记忆值*/
void reset_cpu_o() {
	cpu.a0 = CPU_O::REG_X;
	cpu.a1 = CPU_O::REG_X;
	cpu.a2 = CPU_O::REG_X;
	cpu.ra = CPU_O::REG_X;
}

/*初始化CPU内存使用计数等参数*/
void glow_mem_alloc_init() {
	ramallocaddr = 0;
	rom_cp = 0;
	reset_cpu_o();
}

/****************************************名称字符串管理****************************************/

char* glow_string(const char* str);
char* glow_stringn(const char* str, int len);
void glow_string_init(void);

static struct string { 
	char* str;
	int len;
	struct string* link;
} *buckets[1024];

static int scatter[] = {	/* map characters to random values */
	2078917053, 143302914, 1027100827, 1953210302, 755253631,
	2002600785, 1405390230, 45248011, 1099951567, 433832350,
	2018585307, 438263339, 813528929, 1703199216, 618906479,
	573714703, 766270699, 275680090, 1510320440, 1583583926,
	1723401032, 1965443329, 1098183682, 1636505764, 980071615,
	1011597961, 643279273, 1315461275, 157584038, 1069844923,
	471560540, 89017443, 1213147837, 1498661368, 2042227746,
	1968401469, 1353778505, 1300134328, 2013649480, 306246424,
	1733966678, 1884751139, 744509763, 400011959, 1440466707,
	1363416242, 973726663, 59253759, 1639096332, 336563455,
	1642837685, 1215013716, 154523136, 593537720, 704035832,
	1134594751, 1605135681, 1347315106, 302572379, 1762719719,
	269676381, 774132919, 1851737163, 1482824219, 125310639,
	1746481261, 1303742040, 1479089144, 899131941, 1169907872,
	1785335569, 485614972, 907175364, 382361684, 885626931,
	200158423, 1745777927, 1859353594, 259412182, 1237390611,
	48433401, 1902249868, 304920680, 202956538, 348303940,
	1008956512, 1337551289, 1953439621, 208787970, 1640123668,
	1568675693, 478464352, 266772940, 1272929208, 1961288571,
	392083579, 871926821, 1117546963, 1871172724, 1771058762,
	139971187, 1509024645, 109190086, 1047146551, 1891386329,
	994817018, 1247304975, 1489680608, 706686964, 1506717157,
	579587572, 755120366, 1261483377, 884508252, 958076904,
	1609787317, 1893464764, 148144545, 1415743291, 2102252735,
	1788268214, 836935336, 433233439, 2055041154, 2109864544,
	247038362, 299641085, 834307717, 1364585325, 23330161,
	457882831, 1504556512, 1532354806, 567072918, 404219416,
	1276257488, 1561889936, 1651524391, 618454448, 121093252,
	1010757900, 1198042020, 876213618, 124757630, 2082550272,
	1834290522, 1734544947, 1828531389, 1982435068, 1002804590,
	1783300476, 1623219634, 1839739926, 69050267, 1530777140,
	1802120822, 316088629, 1830418225, 488944891, 1680673954,
	1853748387, 946827723, 1037746818, 1238619545, 1513900641,
	1441966234, 367393385, 928306929, 946006977, 985847834,
	1049400181, 1956764878, 36406206, 1925613800, 2081522508,
	2118956479, 1612420674, 1668583807, 1800004220, 1447372094,
	523904750, 1435821048, 923108080, 216161028, 1504871315,
	306401572, 2018281851, 1820959944, 2136819798, 359743094,
	1354150250, 1843084537, 1306570817, 244413420, 934220434,
	672987810, 1686379655, 1301613820, 1601294739, 484902984,
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
};

static char* next, * strlimit;

/*初始化变量(全局初始化)*/
void glow_string_init(void)
{
	int i;
	for (i = 0; i < 1024; ++i) buckets[i] = 0;
	next = 0;
	strlimit = 0;
}

char* glow_string(const char* str) {
	const char* s;

	for (s = str; *s; s++)
		;
	return glow_stringn(str, s - str);
}

char* glow_stringn(const char* str, int len) {
	int i;
	unsigned int h;
	const char* end;
	struct string* p;

	assert(str);
	for (h = 0, i = len, end = str; i > 0; i--)
		h = (h << 1) + scatter[*(unsigned char*)end++];
	h &= NELEMS(buckets) - 1;
	for (p = buckets[h]; p; p = p->link)
		if (len == p->len) {
			const char* s1 = str;
			char* s2 = p->str;
			do {
				if (s1 == end)
					return p->str;
			} while (*s1++ == *s2++);
		}

	{
		if (len + 1 >= strlimit - next) {
			int n = len + 4 * 1024;
			next = (char*)allocate(n, GLOW_ADDRDATA);
			strlimit = next + n;
		}
		p = (struct string*)allocate(sizeof * p, GLOW_ADDRDATA);
		p->len = len;
		for (p->str = next; str < end; )
			*next++ = *str++;
		*next++ = 0;
		p->link = buckets[h];
		buckets[h] = p;
		return p->str;
	}
}

/****************************************重定向地址处理****************************************/

ADDRDATA ADDRDATA_ENTRY;		//地址数据入口(全局初始化)

/*查询或新建addrdata,并返回该指针*/

ADDRDATA newaddrdata(char* name) {
	ADDRDATA p;
	ADDRDATA null_p = NULL;
	char* str_name;

	str_name = glow_string(name);
	for (p = ADDRDATA_ENTRY; p != NULL; p = p->link) {
		if (p->name == str_name)
			return p;
		else if (p->name == NULL)
			null_p = p;
	}
	if (null_p == NULL) {
		memset(p = (ADDRDATA)allocate(sizeof * p, GLOW_ADDRDATA), 0, sizeof * p);
		p->name = str_name;
		p->base = 0xffffffff;
		p->link = ADDRDATA_ENTRY;
		ADDRDATA_ENTRY = p;
		return p;
	}
	else {
		null_p->name = str_name;
		null_p->base = 0xffffffff;
		return null_p;
	}
}

void insertaddr(ADDRDATA q, unsigned long a_23_16, unsigned long a_15_8, unsigned long a_7_0, long offset) {
	ADDRSTR p;

	for (p = q->redirectaddr; p != NULL && p->file != NULL; p = p->link);
	if (p == NULL) {
		p = (ADDRSTR)allocate(sizeof * p, GLOW_ADDRDATA);
		p->link = q->redirectaddr;
		q->redirectaddr = p;
	}
	p->file = glow_string(src.file);
	p->a_23_16 = a_23_16;
	p->a_15_8 = a_15_8;
	p->a_7_0 = a_7_0;
	p->offset = offset;
}

/*单个C文件内局部重定向地址*/
void one_c_file_redirect_addr(CString* redirect_addr_err) {
	ADDRDATA p;

	for (p = ADDRDATA_ENTRY; p != NULL; p = p->link) {
		if (p->name != NULL && (*p->name == '$')) {
			if (p->base != 0xffffffff) {
				for (ADDRSTR redirect_addr = p->redirectaddr; redirect_addr != NULL && redirect_addr->file != NULL; redirect_addr = redirect_addr->link) {
					unsigned long addr = p->base + redirect_addr->offset;
					romdata[redirect_addr->a_7_0] = addr;
					romdata[redirect_addr->a_15_8] = addr >> 8;
					romdata[redirect_addr->a_23_16] = addr >> 16;
					redirect_addr->file = NULL;
				}
			}
			else for (ADDRSTR redirect_addr = p->redirectaddr; redirect_addr != NULL && redirect_addr->file != NULL; redirect_addr = redirect_addr->link)
				redirect_addr_err->Format(*redirect_addr_err + _T("%s:局部重定向地址发现有未知地址成员%s\r\n"), (CString)redirect_addr->file, (CString)p->name);
			p->name = NULL;
		}
	}
}

/*所有C文件全局重定向地址*/
void all_c_file_redirect_addr(CString* redirect_addr_err) {
	ADDRDATA p;

	for (p = ADDRDATA_ENTRY; p != NULL; p = p->link) {
		if (p->name != NULL) {
			if (p->base != 0xffffffff) {
				for (ADDRSTR redirect_addr = p->redirectaddr; redirect_addr != NULL && redirect_addr->file != NULL; redirect_addr = redirect_addr->link) {
					unsigned long addr = p->base + redirect_addr->offset;
					romdata[redirect_addr->a_7_0] = addr;
					romdata[redirect_addr->a_15_8] = addr >> 8;
					romdata[redirect_addr->a_23_16] = addr >> 16;
				}
			}
			else for (ADDRSTR redirect_addr = p->redirectaddr; redirect_addr != NULL && redirect_addr->file != NULL; redirect_addr = redirect_addr->link)
				redirect_addr_err->Format(*redirect_addr_err + _T("%s:全局重定向地址发现有未知地址成员%s\r\n"), (CString)redirect_addr->file, (CString)p->name);
		}
	}
	deallocate(GLOW_ADDRDATA);
}

/*栈页指针重定向地址*/
void sp_redirect_addr() {
	romdata[sp0_init_romaddr] = (ramallocaddr >> 8) + ((ramallocaddr & 0xff) != 0);
	romdata[sp1_init_romaddr] = (ramallocaddr >> 8) + ((ramallocaddr & 0xff) != 0) >> 8;
}

/*程序入口重定向至main函数*/
void entry_redirect_to_main(CString* error_out_buf) {
	if (cseg == LIT) {
		romentry = rom_cp;
		PC_ASGN_IMMNUM(0);
	}
	unsigned long main_base = newaddrdata("main")->base;
	if (main_base != 0xffffffff)
		MODIFY_A2A1A0(romentry, main_base);
	else
		*error_out_buf += _T("main函数入口地址错误\r\n");
}

/****************************************CPU寄存器堆管理****************************************/

#define REG_SIZE 256 //寄存器大小
#define REG_START (REGISTER_FILE_OP_FUNC_CACHE + REGISTER_FILE_OP_FUNC_CACHE_SKIP) //寄存器分配起始位置
short maxlocreg; //最大寄存器使用数量

struct Reg {
	enum {
		REG_FREE, REG_BUSY //寄存器状态,空闲或忙
	} state;
	short life; //寄存器生命值
} glowreg[REG_SIZE];

/*初始化regalloc*/
void glow_regalloc_init() {
	short i;

	for (i = 0; i < REG_SIZE; ++i) {
		glowreg[i].state = Reg::REG_FREE;
		glowreg[i].life = 0;
	}
	maxlocreg = REG_START;
}

/*分配一个空闲寄存器*/
short regalloc(unsigned char size, short life) {
	short i; unsigned char j;
	for (i = REG_START; i < REG_SIZE; ++i)
		if (glowreg[i].state == Reg::REG_FREE && i + size <= REG_SIZE) {
			for (j = 1; j < size && glowreg[i + j].state != Reg::REG_BUSY; ++j);
			if (j == size) {
				for (j = 0; j < size; ++j)
					glowreg[i + j].state = Reg::REG_BUSY;
				glowreg[i].life = life;
				if (i + size > maxlocreg)
					maxlocreg = i + size;
				return i;
			}
			i += j;
		}
	if (i + size > maxlocreg)
		maxlocreg = i + size;
	error("后端regalloc函数寄存器溢出, 值为%d, 超过设定的%d\n", i + size, REG_SIZE);
	return -1; //没有空闲的寄存器
}

/*寄存器生命数减1,为0释放该寄存器*/
void regfree(short regaddr, unsigned char size) {
	unsigned char i;
	if (glowreg[regaddr].life == 1) {
		for (i = 0; i < size; ++i)
			glowreg[regaddr + i].state = Reg::REG_FREE;
	}
	if (glowreg[regaddr].life > 0)
		glowreg[regaddr].life -= 1;
}

/****************************************生成CPU指令序列****************************************/

#define LOC_OFFSET_CONST_P_OR(op) ((op) == Xop::XOP_LOC || (op) == Xop::XOP_OFFSET || (op) == Xop::XOP_CONST_P)
#define CTB_SP(offset, size) (((offset) + (size) - 1 & 255) < ((offset) & 255))

/*栈页指针装载至A2和A1寄存器*/
void SP_TO_A2A1(long offset) {
	if ((offset & 0xffffff00) == 0) {
		A2_ASGN__RF_O(REGISTER_FILE_SP + 1);
		A1_ASGN__RF_O(REGISTER_FILE_SP);
	}
	else {
		A_ASGN__RF_O(REGISTER_FILE_SP);
		B_ASGN_IMMNUM(offset >> 8);
		A1_ASGN_ALU(ALU_ADD);
		B_ASGN_ALU(ALU_ADD_C);
		A_ASGN__RF(REGISTER_FILE_SP + 1);
		A2_ASGN_ALU(ALU_ADD);
	}
}

/*寄存器数据和offset相加后装载至A2A1A0寄存器*/
void REGISTER_TO_A2A1A0(unsigned char regaddr, unsigned char offset) {
	if (offset == 0) {
		A2_ASGN__RF_O(regaddr + 2);
		A1_ASGN__RF_O(regaddr + 1);
		A0_ASGN__RF_O(regaddr);
	}
	if (offset == 1) {
		A_ASGN__RF_O(regaddr);
		A0_ASGN_ALU(ALU_A_ADD_1);
		B_ASGN_ALU(ALU_A_ADD_1_C);
		A_ASGN__RF(regaddr + 1);
		A1_ASGN_ALU(ALU_ADD);
		B_ASGN_ALU(ALU_ADD_C);
		A_ASGN__RF(regaddr + 2);
		A2_ASGN_ALU(ALU_ADD);
	}
	if (offset > 1) {
		A_ASGN__RF_O(regaddr);
		B_ASGN_IMMNUM(offset);
		A0_ASGN_ALU(ALU_ADD);
		B_ASGN_ALU(ALU_ADD_C);
		A_ASGN__RF(regaddr + 1);
		A1_ASGN_ALU(ALU_ADD);
		B_ASGN_ALU(ALU_ADD_C);
		A_ASGN__RF(regaddr + 2);
		A2_ASGN_ALU(ALU_ADD);
	}
}

/*源操作数为地址,取出数据送目的操作数*/
void DOP_ASGN_SOP_INDIR(Xop* d, Xop* s) {
	if (d->addrtype == Xop::XOP_REGISTER_FILE) {
		if (s->datatype == Xop::XOP_P) {
			if (s->addrtype == Xop::XOP_REGISTER_FILE) {
				for (int i = 0; i < d->datasize; ++i) {
					REGISTER_TO_A2A1A0(s->v.i, i);
					_RF_ASGN_RAM(d->v.i + i);
				}
			}
			else if (LOC_OFFSET_CONST_P_OR(s->addrtype)) {
				Xop dd = *s, ss = *s;
				ss.datatype = Xop::XOP_X;
				dd.addrtype = Xop::XOP_REGISTER_FILE;
				dd.v.i = regalloc(dd.datasize, 1);
				DOP_ASGN_SOP_INDIR(&dd, &ss);
				DOP_ASGN_SOP_INDIR(d, &dd);
				regfree(dd.v.i, dd.datasize);
			}
			else
				error("后端DOP_ASGN_SOP_INDIR函数源操作数错误\n");
		}
		else if (s->datatype == Xop::XOP_X) {
			if (s->addrtype == Xop::XOP_LOC) {
				for (int i = 0; i < d->datasize; ++i) {
					insertaddr(s->entry, rom_cp + 3, rom_cp + 5, rom_cp + 7, s->v.i + i);
					_RF_ASGN__RAM(d->v.i + i, 0);
				}
				reset_cpu_o();
			}
			else if (s->addrtype == Xop::XOP_OFFSET) {
				int x = 0;

				if (CTB_SP(s->v.i, d->datasize)) {
					SP_TO_A2A1(s->v.i);
					do {
						A0_ASGN_IMMNUM_O(s->v.i + x);
						_RF_ASGN_RAM_O(d->v.i + x);
						++x;
					} while ((s->v.i + x & 255) != 0);
				}
				SP_TO_A2A1(s->v.i + x);
				for (; x < d->datasize; ++x) {
					A0_ASGN_IMMNUM_O(s->v.i + x);
					_RF_ASGN_RAM_O(d->v.i + x);
				}
			}
			else if (s->addrtype == Xop::XOP_CONST_P) {
				for (int i = 0; i < d->datasize; ++i) {
					_RF_ASGN__RAM_O(d->v.i + i, s->v.u + i);
				}
			}
			else
				error("后端DOP_ASGN_SOP_INDIR函数源操作数错误\n");
		}
		else
			error("后端DOP_ASGN_SOP_INDIR函数源操作数错误\n");
	}
	else
		error("后端DOP_ASGN_SOP_INDIR函数目的操作数错误\n");
}

/*地址转换处理*/
void addr_convert(Xop* d, Xop* l, Xop* r) {
	Xop sd, sl, sr;

	if (d != NULL && d->datatype == Xop::XOP_X)
		sd = *d;
	else
		sd.addrtype = Xop::XOP_VOID;
	if (l != NULL && l->datatype != Xop::XOP_X)
		sl = *l;
	else {
		sl.addrtype = Xop::XOP_VOID;
		if (l != NULL)
			sl.datasize = l->datasize;
		else
			sl.datasize = 8;
	}
	if (r != NULL && r->datatype != Xop::XOP_X)
		sr = *r;
	else
		sr.addrtype = Xop::XOP_VOID;

	if (sd.addrtype == Xop::XOP_OFFSET && CTB_SP(sd.v.i, sl.datasize)) {
		sd.addrtype = Xop::XOP_REGISTER_FILE;
		sd.datatype = sl.datatype;
		sd.datasize = sl.datasize;
		sd.v.i = regalloc(sd.datasize, 1);
	}
	if (sl.addrtype == Xop::XOP_OFFSET && CTB_SP(sl.v.i, sl.datasize)) {
		sl.addrtype = Xop::XOP_REGISTER_FILE;
		l->datatype = Xop::XOP_X;
		sl.v.i = regalloc(sl.datasize, 1);
		DOP_ASGN_SOP_INDIR(&sl, l);
	}
	if (sr.addrtype == Xop::XOP_OFFSET && CTB_SP(sr.v.i, sr.datasize)) {
		sr.addrtype = Xop::XOP_REGISTER_FILE;
		r->datatype = Xop::XOP_X;
		sr.v.i = regalloc(sr.datasize, 1);
		DOP_ASGN_SOP_INDIR(&sr, r);
	}
	if (sd.addrtype == Xop::XOP_OFFSET && sl.addrtype == Xop::XOP_OFFSET && sr.addrtype == Xop::XOP_OFFSET) {
		if ((sd.v.i & 0xffffff00) == (sl.v.i & 0xffffff00) && (sl.v.i & 0xffffff00) == (sr.v.i & 0xffffff00)) {
			SP_TO_A2A1(sd.v.i);
		}
		else if ((sd.v.i & 0xffffff00) == (sl.v.i & 0xffffff00)) {
			sr.addrtype = Xop::XOP_REGISTER_FILE;
			r->datatype = Xop::XOP_X;
			sr.v.i = regalloc(sr.datasize, 1);
			DOP_ASGN_SOP_INDIR(&sr, r);
			SP_TO_A2A1(sd.v.i);
		}
		else if ((sd.v.i & 0xffffff00) == (sr.v.i & 0xffffff00)) {
			sl.addrtype = Xop::XOP_REGISTER_FILE;
			l->datatype = Xop::XOP_X;
			sl.v.i = regalloc(sl.datasize, 1);
			DOP_ASGN_SOP_INDIR(&sl, l);
			SP_TO_A2A1(sd.v.i);
		}
		else if ((sl.v.i & 0xffffff00) == (sr.v.i & 0xffffff00)) {
			sd.addrtype = Xop::XOP_REGISTER_FILE;
			sd.datatype = sl.datatype;
			sd.datasize = sl.datasize;
			sd.v.i = regalloc(sd.datasize, 1);
			SP_TO_A2A1(sl.v.i);
		}
		else {
			sl.addrtype = Xop::XOP_REGISTER_FILE;
			l->datatype = Xop::XOP_X;
			sl.v.i = regalloc(sl.datasize, 1);
			DOP_ASGN_SOP_INDIR(&sl, l);
			sr.addrtype = Xop::XOP_REGISTER_FILE;
			r->datatype = Xop::XOP_X;
			sr.v.i = regalloc(sr.datasize, 1);
			DOP_ASGN_SOP_INDIR(&sr, r);
			SP_TO_A2A1(sd.v.i);
		}
	}
	else if ((sd.addrtype == Xop::XOP_LOC || sd.addrtype == Xop::XOP_CONST_P) && (sl.addrtype == Xop::XOP_LOC || sl.addrtype == Xop::XOP_CONST_P) && sr.addrtype == Xop::XOP_OFFSET) {
		sr.addrtype = Xop::XOP_REGISTER_FILE;
		r->datatype = Xop::XOP_X;
		sr.v.i = regalloc(sr.datasize, 1);
		DOP_ASGN_SOP_INDIR(&sr, r);
	}
	else if ((sd.addrtype == Xop::XOP_LOC || sd.addrtype == Xop::XOP_CONST_P) && sl.addrtype == Xop::XOP_OFFSET && (sr.addrtype == Xop::XOP_LOC || sr.addrtype == Xop::XOP_CONST_P)) {
		sl.addrtype = Xop::XOP_REGISTER_FILE;
		l->datatype = Xop::XOP_X;
		sl.v.i = regalloc(sl.datasize, 1);
		DOP_ASGN_SOP_INDIR(&sl, l);
	}
	else if (sd.addrtype == Xop::XOP_OFFSET && (sl.addrtype == Xop::XOP_LOC || sl.addrtype == Xop::XOP_CONST_P) && (sr.addrtype == Xop::XOP_LOC || sr.addrtype == Xop::XOP_CONST_P)) {
		sd.addrtype = Xop::XOP_REGISTER_FILE;
		sd.datatype = sl.datatype;
		sd.datasize = sl.datasize;
		sd.v.i = regalloc(sd.datasize, 1);
	}
	else if (sd.addrtype == Xop::XOP_OFFSET && sl.addrtype == Xop::XOP_OFFSET) {
		if ((sd.v.i & 0xffffff00) == (sl.v.i & 0xffffff00)) {
			if (sr.addrtype == Xop::XOP_LOC || sr.addrtype == Xop::XOP_CONST_P) {
				sr.addrtype = Xop::XOP_REGISTER_FILE;
				r->datatype = Xop::XOP_X;
				sr.v.i = regalloc(sr.datasize, 1);
				DOP_ASGN_SOP_INDIR(&sr, r);
			}
			SP_TO_A2A1(sd.v.i);
		}
		else {
			if (sr.addrtype == Xop::XOP_REGISTER_B) {
				sd.addrtype = Xop::XOP_REGISTER_FILE;
				sd.datatype = sl.datatype;
				sd.datasize = sl.datasize;
				sd.v.i = regalloc(sd.datasize, 1);
				SP_TO_A2A1(sl.v.i);
			}
			else {
				sl.addrtype = Xop::XOP_REGISTER_FILE;
				l->datatype = Xop::XOP_X;
				sl.v.i = regalloc(sl.datasize, 1);
				DOP_ASGN_SOP_INDIR(&sl, l);
				if (sr.addrtype == Xop::XOP_LOC || sr.addrtype == Xop::XOP_CONST_P) {
					sd.addrtype = Xop::XOP_REGISTER_FILE;
					sd.datatype = sl.datatype;
					sd.datasize = sl.datasize;
					sd.v.i = regalloc(sd.datasize, 1);
				}
				else {
					SP_TO_A2A1(sd.v.i);
				}
			}
		}
	}
	else if (sd.addrtype == Xop::XOP_OFFSET && sr.addrtype == Xop::XOP_OFFSET) {
		if ((sd.v.i & 0xffffff00) == (sr.v.i & 0xffffff00)) {
			if (sl.addrtype == Xop::XOP_LOC || sl.addrtype == Xop::XOP_CONST_P) {
				sl.addrtype = Xop::XOP_REGISTER_FILE;
				l->datatype = Xop::XOP_X;
				sl.v.i = regalloc(sl.datasize, 1);
				DOP_ASGN_SOP_INDIR(&sl, l);
			}
			SP_TO_A2A1(sd.v.i);
		}
		else {
			if (sl.addrtype == Xop::XOP_REGISTER_A) {
				sd.addrtype = Xop::XOP_REGISTER_FILE;
				sd.datatype = sl.datatype;
				sd.datasize = sl.datasize;
				sd.v.i = regalloc(sd.datasize, 1);
				SP_TO_A2A1(sr.v.i);
			}
			else {
				sr.addrtype = Xop::XOP_REGISTER_FILE;
				r->datatype = Xop::XOP_X;
				sr.v.i = regalloc(sr.datasize, 1);
				DOP_ASGN_SOP_INDIR(&sr, r);
				if (sl.addrtype == Xop::XOP_LOC || sl.addrtype == Xop::XOP_CONST_P) {
					sd.addrtype = Xop::XOP_REGISTER_FILE;
					sd.datatype = sl.datatype;
					sd.datasize = sl.datasize;
					sd.v.i = regalloc(sd.datasize, 1);
				}
				else {
					SP_TO_A2A1(sd.v.i);
				}
			}
		}
	}
	else if (sl.addrtype == Xop::XOP_OFFSET && sr.addrtype == Xop::XOP_OFFSET) {
		if ((sl.v.i & 0xffffff00) == (sr.v.i & 0xffffff00)) {
			if (sd.addrtype == Xop::XOP_LOC || sd.addrtype == Xop::XOP_CONST_P) {
				sd.addrtype = Xop::XOP_REGISTER_FILE;
				sd.datatype = sl.datatype;
				sd.datasize = sl.datasize;
				sd.v.i = regalloc(sd.datasize, 1);
			}
			SP_TO_A2A1(sl.v.i);
		}
		else {
			sr.addrtype = Xop::XOP_REGISTER_FILE;
			r->datatype = Xop::XOP_X;
			sr.v.i = regalloc(sr.datasize, 1);
			DOP_ASGN_SOP_INDIR(&sr, r);
			if (sd.addrtype == Xop::XOP_LOC || sd.addrtype == Xop::XOP_CONST_P) {
				sl.addrtype = Xop::XOP_REGISTER_FILE;
				l->datatype = Xop::XOP_X;
				sl.v.i = regalloc(sl.datasize, 1);
				DOP_ASGN_SOP_INDIR(&sl, l);
			}
			else {
				SP_TO_A2A1(sl.v.i);
			}
		}
	}
	else if (sd.addrtype == Xop::XOP_OFFSET) {
		if (sl.addrtype == Xop::XOP_LOC || sr.addrtype == Xop::XOP_LOC || sl.addrtype == Xop::XOP_CONST_P || sr.addrtype == Xop::XOP_CONST_P ||
			((sl.addrtype == Xop::XOP_REGISTER_A || sr.addrtype == Xop::XOP_REGISTER_B) && (sd.v.i & 0xffffff00) != 0)) {
			sd.addrtype = Xop::XOP_REGISTER_FILE;
			sd.datatype = sl.datatype;
			sd.datasize = sl.datasize;
			sd.v.i = regalloc(sd.datasize, 1);
		}
		else {
			SP_TO_A2A1(sd.v.i);
		}
	}
	else if (sl.addrtype == Xop::XOP_OFFSET) {
		if (sd.addrtype == Xop::XOP_LOC || sr.addrtype == Xop::XOP_LOC || sd.addrtype == Xop::XOP_CONST_P || sr.addrtype == Xop::XOP_CONST_P) {
			sl.addrtype = Xop::XOP_REGISTER_FILE;
			l->datatype = Xop::XOP_X;
			sl.v.i = regalloc(sl.datasize, 1);
			DOP_ASGN_SOP_INDIR(&sl, l);
		}
		else {
			SP_TO_A2A1(sl.v.i);
		}
	}
	else if (sr.addrtype == Xop::XOP_OFFSET) {
		if (sd.addrtype == Xop::XOP_LOC || sl.addrtype == Xop::XOP_LOC || sd.addrtype == Xop::XOP_CONST_P || sl.addrtype == Xop::XOP_CONST_P) {
			sr.addrtype = Xop::XOP_REGISTER_FILE;
			r->datatype = Xop::XOP_X;
			sr.v.i = regalloc(sr.datasize, 1);
			DOP_ASGN_SOP_INDIR(&sr, r);
		}
		else {
			SP_TO_A2A1(sr.v.i);
		}
	}
	if (d != NULL && sd.addrtype != Xop::XOP_VOID)
		*d = sd;
	if (l != NULL && sl.addrtype != Xop::XOP_VOID)
		*l = sl;
	if (r != NULL && sr.addrtype != Xop::XOP_VOID)
		*r = sr;
}

/*操作数第x字节送至A寄存器*/
void A_ASGN_OP(Xop* op, char x) {
	switch (op->addrtype) {
	case Xop::XOP_LOC:
		insertaddr(op->entry, rom_cp + 1, rom_cp + 3, rom_cp + 5, op->v.i + x);
		A_ASGN__RAM(0);
		reset_cpu_o();
		break;
	case Xop::XOP_OFFSET:
		A0_ASGN_IMMNUM_O(op->v.i + x);
		A_ASGN_RAM();
		break;
	case Xop::XOP_REGISTER_FILE: A_ASGN__RF_O(op->v.i + x); break;
	case Xop::XOP_CONST:
		if (op->datatype == Xop::XOP_I)
			A_ASGN_IMMNUM(op->v.i >> (x * 8));
		else if (op->datatype == Xop::XOP_U)
			A_ASGN_IMMNUM(op->v.u >> (x * 8));
		else if (op->datatype == Xop::XOP_F) {
			if (op->datasize == 4) {
				float f = op->v.d;
				A_ASGN_IMMNUM(*((unsigned long*)&f) >> (8 * x));
			}
			else {
				double d = op->v.d;
				unsigned long* p = (unsigned long*)&d;
				if (x < 4)
					A_ASGN_IMMNUM(p[swap] >> (8 * x));
				else
					A_ASGN_IMMNUM(p[1 - swap] >> ((x - 4) * 8));
			}
		}
		else
			error("后端A_ASGN_OP函数生成机器码序列错误\n");
		break;
	case Xop::XOP_CONST_P: A_ASGN__RAM_O(op->v.u + x); break;
	case Xop::XOP_REGISTER_IO0: A_ASGN_IO0(); break;
	case Xop::XOP_REGISTER_IO1: A_ASGN_IO1(); break;
	case Xop::XOP_REGISTER_A: break;
	default: error("后端A_ASGN_OP函数生成机器码序列错误\n");
	}
}

/*操作数第x字节送至B寄存器*/
void B_ASGN_OP(Xop* op, char x) {
	switch (op->addrtype) {
	case Xop::XOP_LOC:
		insertaddr(op->entry, rom_cp + 1, rom_cp + 3, rom_cp + 5, op->v.i + x);
		B_ASGN__RAM(0);
		reset_cpu_o();
		break;
	case Xop::XOP_OFFSET:
		A0_ASGN_IMMNUM_O(op->v.i + x);
		B_ASGN_RAM();
		break;
	case Xop::XOP_REGISTER_FILE: B_ASGN__RF_O(op->v.i + x); break;
	case Xop::XOP_CONST:
		if (op->datatype == Xop::XOP_I)
			B_ASGN_IMMNUM(op->v.i >> (x * 8));
		else if (op->datatype == Xop::XOP_U)
			B_ASGN_IMMNUM(op->v.u >> (x * 8));
		else if (op->datatype == Xop::XOP_F) {
			if (op->datasize == 4) {
				float f = op->v.d;
				B_ASGN_IMMNUM(*((unsigned long*)&f) >> (8 * x));
			}
			else {
				double d = op->v.d;
				unsigned long* p = (unsigned long*)&d;
				if (x < 4)
					B_ASGN_IMMNUM(p[swap] >> (8 * x));
				else
					B_ASGN_IMMNUM(p[1 - swap] >> ((x - 4) * 8));
			}
		}
		else
			error("后端B_ASGN_OP函数生成机器码序列错误\n");
		break;
	case Xop::XOP_CONST_P: B_ASGN__RAM_O(op->v.u + x); break;
	case Xop::XOP_REGISTER_IO0: B_ASGN_IO0(); break;
	case Xop::XOP_REGISTER_IO1: B_ASGN_IO1(); break;
	case Xop::XOP_REGISTER_B: break;
	default: error("后端B_ASGN_OP函数生成机器码序列错误\n");
	}
}

/*ALU输出送至操作数第x字节*/
void OP_ASGN_ALU(Xop* op, char x, unsigned char aluaddr) {
	switch (op->addrtype) {
	case Xop::XOP_LOC:
		insertaddr(op->entry, rom_cp + 1, rom_cp + 3, rom_cp + 5, op->v.i + x);
		_RAM_ASGN_ALU(0, aluaddr);
		reset_cpu_o();
		break;
	case Xop::XOP_OFFSET:
		A0_ASGN_IMMNUM_O(op->v.i + x);
		RAM_ASGN_ALU(aluaddr);
		break;
	case Xop::XOP_REGISTER_FILE: _RF_ASGN_ALU_O(op->v.i + x, aluaddr); break;
	case Xop::XOP_CONST_P: _RAM_ASGN_ALU_O(op->v.u + x, aluaddr); break;
	case Xop::XOP_REGISTER_IO0: IO0_ASGN_ALU(aluaddr); break;
	case Xop::XOP_REGISTER_IO1: IO1_ASGN_ALU(aluaddr); break;
	case Xop::XOP_REGISTER_A: A_ASGN_ALU(aluaddr); break;
	case Xop::XOP_REGISTER_B: B_ASGN_ALU(aluaddr); break;
	default: error("后端OP_ASGN_ALU函数生成机器码序列错误\n");
	}
}

/*源操作数送目的操作数*/
void DOP_ASGN_SOP(Xop* d, Xop* s) {
	Xop sd = *d, ss = *s;

	if (LOC_OFFSET_CONST_P_OR(sd.addrtype) && sd.datatype == Xop::XOP_P) {
		sd.addrtype = Xop::XOP_REGISTER_FILE;
		sd.v.i = regalloc(sd.datasize, 1);
		d->datatype = Xop::XOP_X;
		DOP_ASGN_SOP_INDIR(&sd, d);
		d->datatype = sd.datatype;
	}
	if (LOC_OFFSET_CONST_P_OR(sd.addrtype) && sd.datatype == Xop::XOP_X && LOC_OFFSET_CONST_P_OR(ss.addrtype) && ss.datatype != Xop::XOP_X) {
		addr_convert(&sd, &ss, NULL);
		for (int x = 0; x < ss.datasize; ++x) {
			A_ASGN_OP(&ss, x);
			OP_ASGN_ALU(&sd, x, ALU_OUTA);
		}
		if (sd.addrtype == Xop::XOP_REGISTER_FILE) {
			DOP_ASGN_SOP(d, &sd);
			regfree(sd.v.i, sd.datasize);
		}
		if (ss.addrtype == Xop::XOP_REGISTER_FILE)
			regfree(ss.v.i, ss.datasize);
	}
	else {
		if ((LOC_OFFSET_CONST_P_OR(sd.addrtype) && sd.datatype == Xop::XOP_X) || (sd.addrtype == Xop::XOP_REGISTER_FILE && sd.datatype == Xop::XOP_P)) {
			unsigned long cp[3];

			if (LOC_OFFSET_CONST_P_OR(ss.addrtype) && ss.datatype != Xop::XOP_X) {
				ss.addrtype = Xop::XOP_REGISTER_FILE;
				ss.v.i = regalloc(ss.datasize, 1);
				s->datatype = Xop::XOP_X;
				DOP_ASGN_SOP_INDIR(&ss, s);
				s->datatype = ss.datatype;
			}
			for (int x = 0; x < ss.datasize; ++x) {
				switch (sd.addrtype) {
				case Xop::XOP_LOC:
					insertaddr(sd.entry, rom_cp + 1, rom_cp + 3, rom_cp + 5, sd.v.i + x);
					A2A1A0_ASGN_IMMNUM(0);
					reset_cpu_o();
					break;
				case Xop::XOP_OFFSET:
					if (x == 0)
						SP_TO_A2A1(sd.v.i);
					else if ((sd.v.i + x & 255) == 0)
						SP_TO_A2A1(sd.v.i + x);
					A0_ASGN_IMMNUM_O(sd.v.i + x);
					break;
				case Xop::XOP_CONST_P: A2A1A0_ASGN_IMMNUM_O(sd.v.u + x); break;
				case Xop::XOP_REGISTER_FILE: REGISTER_TO_A2A1A0(sd.v.i, x); break;
				default: error("后端DOP_ASGN_SOP函数目的操作数错误\n");
				}
				switch (ss.addrtype) {
				case Xop::XOP_LOC:
					RAM_ASGN_IMMNUM(0);
					cp[x] = rom_cp - 1;
					break;
				case Xop::XOP_OFFSET:
					if (x == 0) {
						RAM_ASGN_IMMNUM(ss.v.i);
					}
					else if (x == 1) {
						if ((ss.v.i & 0xffffff00) == 0)
							RAM_ASGN__RF(REGISTER_FILE_SP);
						else {
							A_ASGN__RF(REGISTER_FILE_SP);
							B_ASGN_IMMNUM(ss.v.i >> 8);
							RAM_ASGN_ALU(ALU_ADD);
							B_ASGN_ALU(ALU_ADD_C);
						}
					}
					else if (x == 2) {
						if ((ss.v.i & 0xffffff00) == 0)
							RAM_ASGN__RF(REGISTER_FILE_SP + 1);
						else {
							A_ASGN__RF(REGISTER_FILE_SP + 1);
							RAM_ASGN_ALU(ALU_ADD);
						}
					}
					else
						error("后端DOP_ASGN_SOP函数生成机器码序列错误\n");
					break;
				case Xop::XOP_CONST_P:
					RAM_ASGN_IMMNUM(ss.v.u >> (x * 8));
					break;
				case Xop::XOP_REGISTER_FILE:
					RAM_ASGN__RF_O(ss.v.i + x);
					break;
				case Xop::XOP_CONST:
					if (ss.datatype == Xop::XOP_I)
						RAM_ASGN_IMMNUM(ss.v.i >> (x * 8));
					else if (ss.datatype == Xop::XOP_U)
						RAM_ASGN_IMMNUM(ss.v.u >> (x * 8));
					else if (ss.datatype == Xop::XOP_F) {
						if (ss.datasize == 4) {
							float f = ss.v.d;
							RAM_ASGN_IMMNUM(*((unsigned long*)&f) >> (x * 8));
						}
						else {
							double d = ss.v.d;
							unsigned long* p = (unsigned long*)&d;
							if (x < 4)
								RAM_ASGN_IMMNUM(p[swap] >> (x * 8));
							else
								RAM_ASGN_IMMNUM(p[1 - swap] >> ((x - 4) * 8));
						}
					}
					else
						error("后端DOP_ASGN_SOP函数源操作数错误\n");
					break;
				case Xop::XOP_REGISTER_IO0:
					if(ss.datatype == Xop::XOP_I || ss.datatype == Xop::XOP_U)
						RAM_ASGN_IO0();
					else
						error("后端DOP_ASGN_SOP函数源操作数错误\n");
					break;
				case Xop::XOP_REGISTER_IO1:
					if (ss.datatype == Xop::XOP_I || ss.datatype == Xop::XOP_U)
						RAM_ASGN_IO1();
					else
						error("后端DOP_ASGN_SOP函数源操作数错误\n");
					break;
				default: error("后端DOP_ASGN_SOP函数源操作数错误\n");
				}
			}
			if (ss.addrtype == Xop::XOP_LOC)
				insertaddr(ss.entry, cp[2], cp[1], cp[0], ss.v.i);
		}
		else if (sd.addrtype == Xop::XOP_REGISTER_IO0 && sd.datatype == Xop::XOP_X && ss.datatype != Xop::XOP_X && ss.datasize == 1) {
			switch (ss.addrtype) {
			case Xop::XOP_LOC:
				insertaddr(ss.entry, rom_cp + 1, rom_cp + 3, rom_cp + 5, ss.v.i);
				IO0_ASGN__RAM(0);
				reset_cpu_o();
				break;
			case Xop::XOP_OFFSET:
				SP_TO_A2A1(ss.v.i);
				A0_ASGN_IMMNUM_O(ss.v.i);
				IO0_ASGN_RAM();
				break;
			case Xop::XOP_CONST_P: IO0_ASGN__RAM_O(ss.v.u); break;
			case Xop::XOP_REGISTER_FILE: IO0_ASGN__RF_O(ss.v.i); break;
			case Xop::XOP_CONST: IO0_ASGN_IMMNUM(ss.v.u); break;
			case Xop::XOP_REGISTER_IO0: IO0_ASGN_IO0(); break;
			case Xop::XOP_REGISTER_IO1: IO0_ASGN_IO1(); break;
			default: error("后端DOP_ASGN_SOP函数源操作数错误\n");
			}
		}
		else if (sd.addrtype == Xop::XOP_REGISTER_IO1 && sd.datatype == Xop::XOP_X && ss.datatype != Xop::XOP_X && ss.datasize == 1) {
			switch (ss.addrtype) {
			case Xop::XOP_LOC:
				insertaddr(ss.entry, rom_cp + 1, rom_cp + 3, rom_cp + 5, ss.v.i);
				IO1_ASGN__RAM(0);
				reset_cpu_o();
				break;
			case Xop::XOP_OFFSET:
				SP_TO_A2A1(ss.v.i);
				A0_ASGN_IMMNUM_O(ss.v.i);
				IO1_ASGN_RAM();
				break;
			case Xop::XOP_CONST_P: IO1_ASGN__RAM_O(ss.v.u); break;
			case Xop::XOP_REGISTER_FILE: IO1_ASGN__RF_O(ss.v.i); break;
			case Xop::XOP_CONST: IO1_ASGN_IMMNUM(ss.v.u); break;
			case Xop::XOP_REGISTER_IO0: IO1_ASGN_IO0(); break;
			case Xop::XOP_REGISTER_IO1: IO1_ASGN_IO1(); break;
			default: error("后端DOP_ASGN_SOP函数源操作数错误\n");
			}
		}
		else
			error("后端DOP_ASGN_SOP函数生成机器码序列错误\n");
		if (sd.addrtype == Xop::XOP_REGISTER_FILE && sd.addrtype != d->addrtype)
			regfree(sd.v.i, sd.datasize);
		if (ss.addrtype == Xop::XOP_REGISTER_FILE && ss.addrtype != s->addrtype)
			regfree(ss.v.i, ss.datasize);
	}
}

/*定位地址或偏移地址或地址常量送至寄存器堆*/
void LOC_OFFSET_CONST_P_TO_REGISTER_FILE(Xop* d, Xop* s) {
	if (d->addrtype == Xop::XOP_REGISTER_FILE && LOC_OFFSET_CONST_P_OR(s->addrtype) && s->datatype == Xop::XOP_X) {
		unsigned long cp[3];
		int x;
		for (x = 0; x < s->datasize; ++x) {
			switch (s->addrtype) {
			case Xop::XOP_LOC:
				_RF_ASGN_IMMNUM_O(d->v.i + x, 0);
				cp[x] = rom_cp - 1;
				break;
			case Xop::XOP_OFFSET:
				if (x == 0) {
					_RF_ASGN_IMMNUM_O(d->v.i, s->v.i);
				}
				else if (x == 1) {
					A_ASGN__RF(REGISTER_FILE_SP);
					if ((s->v.i & 0xffffff00) == 0) {
						_RF_ASGN_ALU(d->v.i + 1, ALU_OUTA);
					}
					else {
						B_ASGN_IMMNUM(s->v.i >> 8);
						_RF_ASGN_ALU(d->v.i + 1, ALU_ADD);
						B_ASGN_ALU(ALU_ADD_C);
					}
				}
				else if (x == 2) {
					A_ASGN__RF(REGISTER_FILE_SP + 1);
					if ((s->v.i & 0xffffff00) == 0)
						_RF_ASGN_ALU(d->v.i + 2, ALU_OUTA);
					else
						_RF_ASGN_ALU(d->v.i + 2, ALU_ADD);
				}
				break;
			case Xop::XOP_CONST_P:
				_RF_ASGN_IMMNUM_O(d->v.i + x, s->v.u >> (x * 8));
				break;
			}
		}
		if (s->addrtype == Xop::XOP_LOC)
			insertaddr(s->entry, cp[2], cp[1], cp[0], s->v.i);
	}
	else
		error("后端LOC_OFFSET_CONST_P_TO_REGISTER_FILE函数生成机器码序列错误\n");
}

/*3字节(24位)寄存器加1*/
void REGISTER_BYTE_3_ADD_1(unsigned char regaddr) {
	A_ASGN__RF_O(regaddr);
	RF_ASGN_ALU(ALU_A_ADD_1);
	B_ASGN_ALU(ALU_A_ADD_1_C);
	A_ASGN__RF(regaddr + 1);
	RF_ASGN_ALU(ALU_ADD);
	B_ASGN_ALU(ALU_ADD_C);
	A_ASGN__RF(regaddr + 2);
	RF_ASGN_ALU(ALU_ADD);
}

/*源操作数送目的操作数(结构体)*/
void DOP_ASGN_SOP_B(Xop* d, Xop* s, unsigned long size) {
	Xop sd = *d, ss = *s;

	if (size <= 16 && LOC_OFFSET_CONST_P_OR(sd.addrtype) && (sd.datatype == Xop::XOP_P || sd.datatype == Xop::XOP_X)) {
		if (LOC_OFFSET_CONST_P_OR(ss.addrtype) && ss.datatype == Xop::XOP_B) {
			ss.datasize = size;
			DOP_ASGN_SOP(d, &ss);
		}
		else if (ss.addrtype == Xop::XOP_REGISTER_FILE && ss.datatype == Xop::XOP_B) {
			ss.datasize = size;
			ss.v.i = regalloc(size, 1);
			s->datatype = Xop::XOP_P;
			DOP_ASGN_SOP_INDIR(&ss, s);
			s->datatype = Xop::XOP_B;
			DOP_ASGN_SOP(d, &ss);
		}
		else
			error("后端DOP_ASGN_SOP_B函数源操作数错误\n");
	}
	else {
		/*目的操作数地址指向指针数据则把指针数据加载到寄存器*/
		if (LOC_OFFSET_CONST_P_OR(sd.addrtype) && sd.datatype == Xop::XOP_P) {
			sd.addrtype = Xop::XOP_REGISTER_FILE;
			sd.v.i = regalloc(sd.datasize, 1);
			d->datatype = Xop::XOP_X;
			DOP_ASGN_SOP_INDIR(&sd, d);
			d->datatype = sd.datatype;
		}
		/*目的操作数地址加载到寄存器*/
		if (LOC_OFFSET_CONST_P_OR(sd.addrtype) && sd.datatype == Xop::XOP_X) {
			sd.addrtype = Xop::XOP_REGISTER_FILE;
			sd.datatype = Xop::XOP_P;
			sd.v.i = regalloc(sd.datasize, 1);
			LOC_OFFSET_CONST_P_TO_REGISTER_FILE(&sd, d);
		}
		/*源操作数地址加载到寄存器*/
		if (LOC_OFFSET_CONST_P_OR(ss.addrtype) && ss.datatype == Xop::XOP_B) {
			ss.addrtype = Xop::XOP_REGISTER_FILE;
			ss.datatype = Xop::XOP_P;
			ss.v.i = regalloc(ss.datasize, 1);
			s->datatype = Xop::XOP_X;
			LOC_OFFSET_CONST_P_TO_REGISTER_FILE(&ss, s);
			ss.datatype = s->datatype = Xop::XOP_B;
		}
		if (sd.addrtype == Xop::XOP_REGISTER_FILE && sd.datatype == Xop::XOP_P && ss.addrtype == Xop::XOP_REGISTER_FILE && ss.datatype == Xop::XOP_B) {
			/*如果修改到原寄存器并且原寄存器有其他节点引用则创建新寄存器*/
			if (d->addrtype == Xop::XOP_REGISTER_FILE && glowreg[d->v.i].life > 1) {
				sd.v.i = regalloc(sd.datasize, 1);
				for (int i = 0; i < sd.datasize; ++i) {
					A_ASGN__RF(d->v.i + i);
					_RF_ASGN_ALU(sd.v.i + i, ALU_OUTA);
				}
			}
			if (s->addrtype == Xop::XOP_REGISTER_FILE && glowreg[s->v.i].life > 1) {
				ss.v.i = regalloc(ss.datasize, 1);
				for (int i = 0; i < ss.datasize; ++i) {
					A_ASGN__RF(s->v.i + i);
					_RF_ASGN_ALU(ss.v.i + i, ALU_OUTA);
				}
			}
			/*生成批量传送指令*/
			if (size <= 256) {
				unsigned long label_0;
				unsigned char reg_cp = regalloc(1, 1);

				_RF_ASGN_IMMNUM(reg_cp, size - 1);
				label_0 = rom_cp >> 1;
				reset_cpu_o();
				REGISTER_TO_A2A1A0(ss.v.i, 0);
				A_ASGN_RAM();
				REGISTER_TO_A2A1A0(sd.v.i, 0);
				RAM_ASGN_ALU(ALU_OUTA);
				REGISTER_BYTE_3_ADD_1(ss.v.i);
				REGISTER_BYTE_3_ADD_1(sd.v.i);
				A_ASGN__RF(reg_cp);
				RF_ASGN_ALU(ALU_A_SUB_1);
				IFALU_PC_ASGN_IMMNUM(ALU_A_SUB_1_C, label_0);
				regfree(reg_cp, 1);
			}
			else if (size <= 65536) {
				unsigned long label_0;
				unsigned char reg_cp = regalloc(2, 1);

				_RF_ASGN_IMMNUM(reg_cp, size - 1);
				_RF_ASGN_IMMNUM(reg_cp + 1, (size - 1) >> 8);
				label_0 = rom_cp >> 1;
				reset_cpu_o();
				REGISTER_TO_A2A1A0(ss.v.i, 0);
				A_ASGN_RAM();
				REGISTER_TO_A2A1A0(sd.v.i, 0);
				RAM_ASGN_ALU(ALU_OUTA);
				REGISTER_BYTE_3_ADD_1(ss.v.i);
				REGISTER_BYTE_3_ADD_1(sd.v.i);
				A_ASGN__RF(reg_cp);
				RF_ASGN_ALU(ALU_A_SUB_1);
				B_ASGN_ALU(ALU_A_SUB_1_C);
				A_ASGN__RF(reg_cp + 1);
				RF_ASGN_ALU(ALU_SUB);
				IFALU_PC_ASGN_IMMNUM(ALU_SUB_C, label_0);

				regfree(reg_cp, 2);
			}
			else if (size <= 16777216) {
				unsigned long label_0;
				unsigned char reg_cp = regalloc(3, 1);

				_RF_ASGN_IMMNUM(reg_cp, size - 1);
				_RF_ASGN_IMMNUM(reg_cp + 1, (size - 1) >> 8);
				_RF_ASGN_IMMNUM(reg_cp + 2, (size - 1) >> 16);
				label_0 = rom_cp >> 1;
				reset_cpu_o();
				REGISTER_TO_A2A1A0(ss.v.i, 0);
				A_ASGN_RAM();
				REGISTER_TO_A2A1A0(sd.v.i, 0);
				RAM_ASGN_ALU(ALU_OUTA);
				REGISTER_BYTE_3_ADD_1(ss.v.i);
				REGISTER_BYTE_3_ADD_1(sd.v.i);
				A_ASGN__RF(reg_cp);
				RF_ASGN_ALU(ALU_A_SUB_1);
				B_ASGN_ALU(ALU_A_SUB_1_C);
				A_ASGN__RF(reg_cp + 1);
				RF_ASGN_ALU(ALU_SUB);
				B_ASGN_ALU(ALU_SUB_C);
				A_ASGN__RF(reg_cp + 2);
				RF_ASGN_ALU(ALU_SUB);
				IFALU_PC_ASGN_IMMNUM(ALU_SUB_C, label_0);

				regfree(reg_cp, 3);
			}
			else
				error("后端DOP_ASGN_SOP_B函数size参数溢出\n");
		}
		else
			error("后端DOP_ASGN_SOP_B函数生成机器码序列错误\n");
	}
	if ((sd.addrtype == Xop::XOP_REGISTER_FILE && d->addrtype != Xop::XOP_REGISTER_FILE) || (sd.addrtype == Xop::XOP_REGISTER_FILE && d->addrtype == Xop::XOP_REGISTER_FILE && sd.v.i != d->v.i))
		regfree(sd.v.i, sd.datasize);
	if ((ss.addrtype == Xop::XOP_REGISTER_FILE && s->addrtype != Xop::XOP_REGISTER_FILE) || (ss.addrtype == Xop::XOP_REGISTER_FILE && s->addrtype == Xop::XOP_REGISTER_FILE && ss.v.i != s->v.i))
		regfree(ss.v.i, ss.datasize);
}

/*操作数送寄存器堆*/
void REGISTER_FILE_ASGN_OP(Xop* d, Xop* s) {
	Xop sd = *d, ss = *s;
	if (sd.addrtype == Xop::XOP_REGISTER_FILE) {
		switch (ss.addrtype) {
		case Xop::XOP_LOC: case Xop::XOP_OFFSET: case Xop::XOP_CONST_P:
			if (ss.datatype != Xop::XOP_X) {
				ss.datatype = Xop::XOP_X;
				if (sd.datasize > ss.datasize)
					sd.datasize = ss.datasize;
				DOP_ASGN_SOP_INDIR(&sd, &ss);
			}
			else
				error("后端REGISTER_FILE_ASGN_OP函数生成机器码序列错误\n");
			break;
		case Xop::XOP_REGISTER_FILE:
			if (sd.v.i != ss.v.i) {
				if (sd.datasize > ss.datasize)
					sd.datasize = ss.datasize;
				for (int i = 0; i < sd.datasize; ++i) {
					A_ASGN__RF(ss.v.i + i);
					_RF_ASGN_ALU(sd.v.i + i, ALU_OUTA);
				}
			}
			break;
		case Xop::XOP_CONST:
			if (sd.datasize > ss.datasize)
				sd.datasize = ss.datasize;
			if (ss.datatype == Xop::XOP_U) {
				for (int i = 0; i < sd.datasize; ++i)
					_RF_ASGN_IMMNUM_O(sd.v.i + i, ss.v.u >> (i * 8));
			}
			else if (ss.datatype == Xop::XOP_I) {
				for (int i = 0; i < sd.datasize; ++i)
					_RF_ASGN_IMMNUM_O(sd.v.i + i, ss.v.i >> (i * 8));
			}
			else if (ss.datatype == Xop::XOP_F) {
				for (int i = 0; i < sd.datasize; ++i) {
					if (ss.datasize == 4) {
						float f = ss.v.d;
						_RF_ASGN_IMMNUM(sd.v.i + i, *((unsigned long*)&f) >> (8 * i));
					}
					else {
						double d = ss.v.d;
						unsigned long* p = (unsigned long*)&d;
						if (i < 4)
							_RF_ASGN_IMMNUM(sd.v.i + i, p[swap] >> (8 * i));
						else
							_RF_ASGN_IMMNUM(sd.v.i + i, p[1 - swap] >> ((i - 4) * 8));
					}
				}
			}
			else
				error("后端REGISTER_FILE_ASGN_OP函数生成机器码序列错误\n");
			break;
		case Xop::XOP_REGISTER_IO0: _RF_ASGN_IO0(sd.v.i); break;
		case Xop::XOP_REGISTER_IO1: _RF_ASGN_IO1(sd.v.i); break;
		default:
			error("后端REGISTER_FILE_ASGN_OP函数生成机器码序列错误\n");
		}
	}
	else
		error("后端REGISTER_FILE_ASGN_OP函数生成机器码序列错误\n");
}

unsigned long float_add_func_romaddr; //float加法函数入口地址
unsigned long float_sub_func_romaddr; //float减法函数入口地址
unsigned long float_mul_func_romaddr; //float乘法函数入口地址
unsigned long float_div_func_romaddr; //float除法函数入口地址
unsigned long double_add_func_romaddr; //double加法函数入口地址
unsigned long double_sub_func_romaddr; //double减法函数入口地址
unsigned long double_mul_func_romaddr; //double乘法函数入口地址
unsigned long double_div_func_romaddr; //double除法函数入口地址
void float_sub_func_gen();
void double_sub_func_gen();

/*float加法函数生成,(节省运算量,这里不处理极限值,不处理舍入)*/
void float_add_func_gen() {
	if (float_add_func_romaddr == 0) {
		unsigned long label_0, label_1, label_2, label_3, label_4, label_5;
		unsigned char reg_lop_index = REGISTER_FILE_OP_FUNC_CACHE;
		unsigned char reg_rop_index = REGISTER_FILE_OP_FUNC_CACHE + 1;
		unsigned char reg_rsh_cp = REGISTER_FILE_OP_FUNC_CACHE + 2;
		unsigned char reg_c = REGISTER_FILE_OP_FUNC_CACHE + 3;

		label_0 = rom_cp;
		PC_ASGN_IMMNUM(0);
		float_add_func_romaddr = rom_cp >> 1;

		/*数符不相同则转换为减法*/
		B_ASGN__RF(REGISTER_FILE_OP_FUNC_LOP + 3);
		A_ASGN__RF(REGISTER_FILE_OP_FUNC_ROP + 3);
		B_ASGN_ALU(ALU_XOR);
		label_1 = rom_cp;
		IFALU_PC_ASGN_IMMNUM(ALU_A_BH_LSH, 0);
		B_ASGN_IMMNUM(0x80);
		RF_ASGN_ALU(ALU_XOR);
		float_sub_func_gen();
		PC_ASGN_IMMNUM(float_sub_func_romaddr);
		MODIFY_A2A1A0(label_1, rom_cp >> 1);

		/*提取指数,判断操作数是否为0或无穷大*/
		B_ASGN__RF(REGISTER_FILE_OP_FUNC_LOP + 2);
		A_ASGN__RF(REGISTER_FILE_OP_FUNC_LOP + 3);
		B_ASGN_ALU(ALU_A_BH_LSH);
		A_ASGN_IMMNUM(0x7f);
		_RF_ASGN_ALU(reg_lop_index, ALU_XOR);
		B_ASGN__RF(REGISTER_FILE_OP_FUNC_ROP + 2);
		A_ASGN__RF(REGISTER_FILE_OP_FUNC_ROP + 3);
		B_ASGN_ALU(ALU_A_BH_LSH);
		A_ASGN_IMMNUM(0x7f);
		_RF_ASGN_ALU(reg_rop_index, ALU_XOR);

		A_ASGN__RF(reg_lop_index);
		B_ASGN_IMMNUM(-128);
		_RF_ASGN_ALU(reg_c, ALU_EQUAL_C);
		A_ASGN__RF(REGISTER_FILE_OP_FUNC_LOP + 2);
		B_ASGN_ALU(ALU_A_0_LSH);
		A_ASGN_ALU(ALU_A_BH_LSH);
		B_ASGN__RF(reg_c);
		label_1 = rom_cp;
		IFALU_PC_ASGN_IMMNUM(ALU_AND, 0);
		_RF_ASGN_IMMNUM(REGISTER_FILE_OP_FUNC_DOP, 0);
		_RF_ASGN_IMMNUM(REGISTER_FILE_OP_FUNC_DOP + 1, 0);
		_RF_ASGN_IMMNUM(REGISTER_FILE_OP_FUNC_DOP + 2, 0xc0);
		A_ASGN__RF(REGISTER_FILE_OP_FUNC_LOP + 3);
		_RF_ASGN_ALU(REGISTER_FILE_OP_FUNC_DOP + 3, ALU_OUTA);
		REGISTER_TO_A2A1A0(REGISTER_FILE_OP_FUNC_RET, 0);
		PC_ASGN_A2A1A0();
		MODIFY_A2A1A0(label_1, rom_cp >> 1);

		A_ASGN__RF(reg_rop_index);
		B_ASGN_IMMNUM(-128);
		_RF_ASGN_ALU(reg_c, ALU_EQUAL_C);
		A_ASGN__RF(REGISTER_FILE_OP_FUNC_ROP + 2);
		B_ASGN_ALU(ALU_A_0_LSH);
		A_ASGN_ALU(ALU_A_BH_LSH);
		B_ASGN__RF(reg_c);
		label_1 = rom_cp;
		IFALU_PC_ASGN_IMMNUM(ALU_AND, 0);
		_RF_ASGN_IMMNUM(REGISTER_FILE_OP_FUNC_DOP, 0);
		_RF_ASGN_IMMNUM(REGISTER_FILE_OP_FUNC_DOP + 1, 0);
		_RF_ASGN_IMMNUM(REGISTER_FILE_OP_FUNC_DOP + 2, 0xc0);
		A_ASGN__RF(REGISTER_FILE_OP_FUNC_ROP + 3);
		_RF_ASGN_ALU(REGISTER_FILE_OP_FUNC_DOP + 3, ALU_OUTA);
		REGISTER_TO_A2A1A0(REGISTER_FILE_OP_FUNC_RET, 0);
		PC_ASGN_A2A1A0();
		MODIFY_A2A1A0(label_1, rom_cp >> 1);

		A_ASGN__RF(reg_lop_index);
		B_ASGN_IMMNUM(127);
		label_1 = rom_cp;
		IFALU_PC_ASGN_IMMNUM(ALU_EQUAL_C, 0);
		A_ASGN__RF(REGISTER_FILE_OP_FUNC_ROP);
		_RF_ASGN_ALU(REGISTER_FILE_OP_FUNC_DOP, ALU_OUTA);
		A_ASGN__RF(REGISTER_FILE_OP_FUNC_ROP + 1);
		_RF_ASGN_ALU(REGISTER_FILE_OP_FUNC_DOP + 1, ALU_OUTA);
		A_ASGN__RF(REGISTER_FILE_OP_FUNC_ROP + 2);
		_RF_ASGN_ALU(REGISTER_FILE_OP_FUNC_DOP + 2, ALU_OUTA);
		A_ASGN__RF(REGISTER_FILE_OP_FUNC_ROP + 3);
		_RF_ASGN_ALU(REGISTER_FILE_OP_FUNC_DOP + 3, ALU_OUTA);
		REGISTER_TO_A2A1A0(REGISTER_FILE_OP_FUNC_RET, 0);
		PC_ASGN_A2A1A0();
		MODIFY_A2A1A0(label_1, rom_cp >> 1);

		B_ASGN_IMMNUM(-128);
		label_1 = rom_cp;
		IFALU_PC_ASGN_IMMNUM(ALU_EQUAL_C, 0);
		_RF_ASGN_IMMNUM(REGISTER_FILE_OP_FUNC_DOP, 0);
		_RF_ASGN_IMMNUM(REGISTER_FILE_OP_FUNC_DOP + 1, 0);
		_RF_ASGN_IMMNUM(REGISTER_FILE_OP_FUNC_DOP + 2, 0x80);
		A_ASGN__RF(REGISTER_FILE_OP_FUNC_LOP + 3);
		_RF_ASGN_ALU(REGISTER_FILE_OP_FUNC_DOP + 3, ALU_OUTA);
		REGISTER_TO_A2A1A0(REGISTER_FILE_OP_FUNC_RET, 0);
		PC_ASGN_A2A1A0();
		MODIFY_A2A1A0(label_1, rom_cp >> 1);

		A_ASGN__RF(reg_rop_index);
		B_ASGN_IMMNUM(127);
		label_1 = rom_cp;
		IFALU_PC_ASGN_IMMNUM(ALU_EQUAL_C, 0);
		A_ASGN__RF(REGISTER_FILE_OP_FUNC_LOP);
		_RF_ASGN_ALU(REGISTER_FILE_OP_FUNC_DOP, ALU_OUTA);
		A_ASGN__RF(REGISTER_FILE_OP_FUNC_LOP + 1);
		_RF_ASGN_ALU(REGISTER_FILE_OP_FUNC_DOP + 1, ALU_OUTA);
		A_ASGN__RF(REGISTER_FILE_OP_FUNC_LOP + 2);
		_RF_ASGN_ALU(REGISTER_FILE_OP_FUNC_DOP + 2, ALU_OUTA);
		A_ASGN__RF(REGISTER_FILE_OP_FUNC_LOP + 3);
		_RF_ASGN_ALU(REGISTER_FILE_OP_FUNC_DOP + 3, ALU_OUTA);
		REGISTER_TO_A2A1A0(REGISTER_FILE_OP_FUNC_RET, 0);
		PC_ASGN_A2A1A0();
		MODIFY_A2A1A0(label_1, rom_cp >> 1);

		B_ASGN_IMMNUM(-128);
		label_1 = rom_cp;
		IFALU_PC_ASGN_IMMNUM(ALU_EQUAL_C, 0);
		_RF_ASGN_IMMNUM(REGISTER_FILE_OP_FUNC_DOP, 0);
		_RF_ASGN_IMMNUM(REGISTER_FILE_OP_FUNC_DOP + 1, 0);
		_RF_ASGN_IMMNUM(REGISTER_FILE_OP_FUNC_DOP + 2, 0x80);
		A_ASGN__RF(REGISTER_FILE_OP_FUNC_ROP + 3);
		_RF_ASGN_ALU(REGISTER_FILE_OP_FUNC_DOP + 3, ALU_OUTA);
		REGISTER_TO_A2A1A0(REGISTER_FILE_OP_FUNC_RET, 0);
		PC_ASGN_A2A1A0();
		MODIFY_A2A1A0(label_1, rom_cp >> 1);

		/*补1.0*/
		A_ASGN_IMMNUM(0x80);
		B_ASGN__RF(REGISTER_FILE_OP_FUNC_LOP + 2);
		RF_ASGN_ALU(ALU_OR);
		B_ASGN__RF(REGISTER_FILE_OP_FUNC_ROP + 2);
		RF_ASGN_ALU(ALU_OR);

		/*对齐小数点*/
		A_ASGN__RF(reg_lop_index);
		B_ASGN__RF(reg_rop_index);
		_RF_ASGN_ALU(reg_rsh_cp, ALU_SUB);
		B_ASGN_ALU(ALU_SUB);
		label_1 = rom_cp;
		IFALU_PC_ASGN_IMMNUM(ALU_A_BH_LSH, 0);
		/*指数相减为负数,右操作数右移*/

		A_ASGN_IMMNUM(23);
		label_4 = rom_cp;
		IFALU_PC_ASGN_IMMNUM(ALU_ADD_C, 0);
		/*右移位数小于等于23,执行移位*/
		label_3 = rom_cp >> 1;
		A_ASGN__RF(REGISTER_FILE_OP_FUNC_ROP + 1);
		B_ASGN__RF(REGISTER_FILE_OP_FUNC_ROP);
		RF_ASGN_ALU(ALU_B_AL_RSH);
		B_ASGN_ALU(ALU_OUTA);
		A_ASGN__RF(REGISTER_FILE_OP_FUNC_ROP + 2);
		RF_ASGN_ALU(ALU_A_0_RSH);
		_RF_ASGN_ALU(REGISTER_FILE_OP_FUNC_ROP + 1, ALU_B_AL_RSH);
		A_ASGN__RF(reg_rsh_cp);
		RF_ASGN_ALU(ALU_A_ADD_1);
		IFALU_PC_ASGN_IMMNUM(ALU_A_ADD_1_C, label_3);
		label_5 = rom_cp;
		PC_ASGN_IMMNUM(0);
		MODIFY_A2A1A0(label_4, rom_cp >> 1);
		/*右移位数大于23,清0操作数值*/
		_RF_ASGN_IMMNUM(REGISTER_FILE_OP_FUNC_ROP, 0);
		_RF_ASGN_IMMNUM(REGISTER_FILE_OP_FUNC_ROP + 1, 0);
		_RF_ASGN_IMMNUM(REGISTER_FILE_OP_FUNC_ROP + 2, 0);
		MODIFY_A2A1A0(label_5, rom_cp >> 1);
		A_ASGN__RF(reg_lop_index);
		_RF_ASGN_ALU(reg_rop_index, ALU_OUTA);

		label_2 = rom_cp;
		PC_ASGN_IMMNUM(0);
		MODIFY_A2A1A0(label_1, rom_cp >> 1);
		/*指数相减为正数,左操作数右移*/

		A_ASGN_ALU(ALU_OUTB);
		B_ASGN_IMMNUM(24);
		label_5 = rom_cp;
		IFALU_PC_ASGN_IMMNUM(ALU_SUB_C, 0);
		/*右移位数小于等于23,执行移位*/
		label_3 = rom_cp >> 1;
		A_ASGN__RF(reg_rsh_cp);
		RF_ASGN_ALU(ALU_A_SUB_1);
		A_ASGN_ALU(ALU_A_SUB_1_C);
		label_4 = rom_cp;
		IFALU_PC_ASGN_IMMNUM(ALU_A_NOT, 0);
		A_ASGN__RF(REGISTER_FILE_OP_FUNC_LOP + 1);
		B_ASGN__RF(REGISTER_FILE_OP_FUNC_LOP);
		RF_ASGN_ALU(ALU_B_AL_RSH);
		B_ASGN_ALU(ALU_OUTA);
		A_ASGN__RF(REGISTER_FILE_OP_FUNC_LOP + 2);
		RF_ASGN_ALU(ALU_A_0_RSH);
		_RF_ASGN_ALU(REGISTER_FILE_OP_FUNC_LOP + 1, ALU_B_AL_RSH);
		PC_ASGN_IMMNUM(label_3);
		MODIFY_A2A1A0(label_5, rom_cp >> 1);
		/*右移位数大于23,清0操作数值*/
		_RF_ASGN_IMMNUM(REGISTER_FILE_OP_FUNC_LOP, 0);
		_RF_ASGN_IMMNUM(REGISTER_FILE_OP_FUNC_LOP + 1, 0);
		_RF_ASGN_IMMNUM(REGISTER_FILE_OP_FUNC_LOP + 2, 0);
		MODIFY_A2A1A0(label_4, rom_cp >> 1);
		MODIFY_A2A1A0(label_2, rom_cp >> 1);

		/*24位尾数相加*/
		A_ASGN__RF(REGISTER_FILE_OP_FUNC_LOP);
		B_ASGN__RF(REGISTER_FILE_OP_FUNC_ROP);
		_RF_ASGN_ALU(REGISTER_FILE_OP_FUNC_DOP, ALU_ADD);
		B_ASGN_ALU(ALU_ADD_C);

		A_ASGN__RF(REGISTER_FILE_OP_FUNC_LOP + 1);
		_RF_ASGN_ALU(reg_c, ALU_ADD_C);
		A_ASGN_ALU(ALU_ADD);
		B_ASGN__RF(REGISTER_FILE_OP_FUNC_ROP + 1);
		_RF_ASGN_ALU(REGISTER_FILE_OP_FUNC_DOP + 1, ALU_ADD);
		B_ASGN_ALU(ALU_ADD_C);
		A_ASGN__RF(reg_c);
		B_ASGN_ALU(ALU_ADD);

		A_ASGN__RF(REGISTER_FILE_OP_FUNC_LOP + 2);
		_RF_ASGN_ALU(reg_c, ALU_ADD_C);
		A_ASGN_ALU(ALU_ADD);
		B_ASGN__RF(REGISTER_FILE_OP_FUNC_ROP + 2);
		_RF_ASGN_ALU(REGISTER_FILE_OP_FUNC_DOP + 2, ALU_ADD);
		B_ASGN_ALU(ALU_ADD_C);
		A_ASGN__RF(reg_c);

		/*如果有进位,尾数右移1位,指数减1*/
		label_1 = rom_cp;
		IFALU_PC_ASGN_IMMNUM(ALU_ADD, 0);
		A_ASGN__RF(REGISTER_FILE_OP_FUNC_DOP + 1);
		B_ASGN__RF(REGISTER_FILE_OP_FUNC_DOP);
		RF_ASGN_ALU(ALU_B_AL_RSH);
		B_ASGN_ALU(ALU_OUTA);
		A_ASGN__RF(REGISTER_FILE_OP_FUNC_DOP + 2);
		RF_ASGN_ALU(ALU_A_0_RSH);
		_RF_ASGN_ALU(REGISTER_FILE_OP_FUNC_DOP + 1, ALU_B_AL_RSH);
		A_ASGN__RF(reg_rop_index);
		RF_ASGN_ALU(ALU_A_SUB_1);
		B_ASGN_IMMNUM(-127);
		label_2 = rom_cp;
		IFALU_PC_ASGN_IMMNUM(ALU_EQUAL_C, 0);
		_RF_ASGN_IMMNUM(REGISTER_FILE_OP_FUNC_DOP, 0);
		_RF_ASGN_IMMNUM(REGISTER_FILE_OP_FUNC_DOP + 1, 0);
		_RF_ASGN_IMMNUM(REGISTER_FILE_OP_FUNC_DOP + 2, 0);
		MODIFY_A2A1A0(label_2, rom_cp >> 1);
		MODIFY_A2A1A0(label_1, rom_cp >> 1);

		/*指数转换为原格式*/
		A_ASGN__RF(reg_rop_index);
		B_ASGN_IMMNUM(0x7f);
		RF_ASGN_ALU(ALU_XOR);

		/*装回指数和符号*/
		A_ASGN_ALU(ALU_XOR);
		B_ASGN__RF(REGISTER_FILE_OP_FUNC_DOP + 2);
		B_ASGN_ALU(ALU_B_0_LSH);
		RF_ASGN_ALU(ALU_B_AL_RSH);
		B_ASGN__RF(REGISTER_FILE_OP_FUNC_LOP + 3);
		A_ASGN_ALU(ALU_A_BH_LSH);
		B_ASGN__RF(reg_rop_index);
		_RF_ASGN_ALU(REGISTER_FILE_OP_FUNC_DOP + 3, ALU_B_AL_RSH);

		REGISTER_TO_A2A1A0(REGISTER_FILE_OP_FUNC_RET, 0);
		PC_ASGN_A2A1A0();
		MODIFY_A2A1A0(label_0, rom_cp >> 1);
	}
}

/*double加法函数生成,(节省运算量,这里不处理极限值,不处理舍入)*/
void double_add_func_gen() {
	if (double_add_func_romaddr == 0) {
		unsigned long label_0, label_1, label_2, label_3, label_4, label_5;
		unsigned char reg_lop_index = REGISTER_FILE_OP_FUNC_CACHE;
		unsigned char reg_rop_index = REGISTER_FILE_OP_FUNC_CACHE + 2;
		unsigned char reg_rsh_cp = REGISTER_FILE_OP_FUNC_CACHE + 4;
		unsigned char reg_c = REGISTER_FILE_OP_FUNC_CACHE + 6;

		label_0 = rom_cp;
		PC_ASGN_IMMNUM(0);
		double_add_func_romaddr = rom_cp >> 1;

		/*数符不相同则转换为减法*/
		B_ASGN__RF(REGISTER_FILE_OP_FUNC_LOP + 7);
		A_ASGN__RF(REGISTER_FILE_OP_FUNC_ROP + 7);
		B_ASGN_ALU(ALU_XOR);
		label_1 = rom_cp;
		IFALU_PC_ASGN_IMMNUM(ALU_A_BH_LSH, 0);
		B_ASGN_IMMNUM(0x80);
		RF_ASGN_ALU(ALU_XOR);
		double_sub_func_gen();
		PC_ASGN_IMMNUM(double_sub_func_romaddr);
		MODIFY_A2A1A0(label_1, rom_cp >> 1);

		/*提取指数,判断操作数是否为0或无穷大*/
		B_ASGN__RF(REGISTER_FILE_OP_FUNC_LOP + 7);
		A_ASGN_ALU(ALU_B_0_LSH);
		B_ASGN__RF(REGISTER_FILE_OP_FUNC_LOP + 6);
		A_ASGN_ALU(ALU_A_AH_RSH);
		B_ASGN_ALU(ALU_B_AL_RSH);
		A_ASGN_ALU(ALU_A_AH_RSH);
		B_ASGN_ALU(ALU_B_AL_RSH);
		A_ASGN_ALU(ALU_A_AH_RSH);
		B_ASGN_ALU(ALU_B_AL_RSH);
		A_ASGN_ALU(ALU_A_AH_RSH);
		B_ASGN_ALU(ALU_B_AL_RSH);
		_RF_ASGN_ALU(reg_lop_index + 1, ALU_A_AH_RSH);
		A_ASGN_IMMNUM(0xff);
		_RF_ASGN_ALU(reg_lop_index, ALU_XOR);
		A_ASGN__RF(reg_lop_index + 1);
		B_ASGN_IMMNUM(0x03);
		RF_ASGN_ALU(ALU_XOR);

		B_ASGN__RF(REGISTER_FILE_OP_FUNC_ROP + 7);
		A_ASGN_ALU(ALU_B_0_LSH);
		B_ASGN__RF(REGISTER_FILE_OP_FUNC_ROP + 6);
		A_ASGN_ALU(ALU_A_AH_RSH);
		B_ASGN_ALU(ALU_B_AL_RSH);
		A_ASGN_ALU(ALU_A_AH_RSH);
		B_ASGN_ALU(ALU_B_AL_RSH);
		A_ASGN_ALU(ALU_A_AH_RSH);
		B_ASGN_ALU(ALU_B_AL_RSH);
		A_ASGN_ALU(ALU_A_AH_RSH);
		B_ASGN_ALU(ALU_B_AL_RSH);
		_RF_ASGN_ALU(reg_rop_index + 1, ALU_A_AH_RSH);
		A_ASGN_IMMNUM(0xff);
		_RF_ASGN_ALU(reg_rop_index, ALU_XOR);
		A_ASGN__RF(reg_rop_index + 1);
		B_ASGN_IMMNUM(0x03);
		RF_ASGN_ALU(ALU_XOR);

		A_ASGN__RF(reg_lop_index);
		B_ASGN_IMMNUM(0x00);
		_RF_ASGN_ALU(reg_c, ALU_EQUAL_C);
		A_ASGN__RF(reg_lop_index + 1);
		B_ASGN_IMMNUM(0xfc);
		A_ASGN_ALU(ALU_EQUAL_C);
		B_ASGN__RF(reg_c);
		RF_ASGN_ALU(ALU_AND);
		A_ASGN__RF(REGISTER_FILE_OP_FUNC_LOP + 6);
		B_ASGN_IMMNUM(0x20);
		A_ASGN_ALU(ALU_MUL_H);
		B_ASGN__RF(reg_c);
		label_1 = rom_cp;
		IFALU_PC_ASGN_IMMNUM(ALU_AND, 0);
		_RF_ASGN_IMMNUM(REGISTER_FILE_OP_FUNC_DOP, 0);
		_RF_ASGN_IMMNUM(REGISTER_FILE_OP_FUNC_DOP + 1, 0);
		_RF_ASGN_IMMNUM(REGISTER_FILE_OP_FUNC_DOP + 2, 0);
		_RF_ASGN_IMMNUM(REGISTER_FILE_OP_FUNC_DOP + 3, 0);
		_RF_ASGN_IMMNUM(REGISTER_FILE_OP_FUNC_DOP + 4, 0);
		_RF_ASGN_IMMNUM(REGISTER_FILE_OP_FUNC_DOP + 5, 0);
		_RF_ASGN_IMMNUM(REGISTER_FILE_OP_FUNC_DOP + 6, 0xf8);
		A_ASGN__RF(REGISTER_FILE_OP_FUNC_LOP + 7);
		_RF_ASGN_ALU(REGISTER_FILE_OP_FUNC_DOP + 7, ALU_OUTA);
		REGISTER_TO_A2A1A0(REGISTER_FILE_OP_FUNC_RET, 0);
		PC_ASGN_A2A1A0();
		MODIFY_A2A1A0(label_1, rom_cp >> 1);

		A_ASGN__RF(reg_rop_index);
		B_ASGN_IMMNUM(0x00);
		_RF_ASGN_ALU(reg_c, ALU_EQUAL_C);
		A_ASGN__RF(reg_rop_index + 1);
		B_ASGN_IMMNUM(0xfc);
		A_ASGN_ALU(ALU_EQUAL_C);
		B_ASGN__RF(reg_c);
		RF_ASGN_ALU(ALU_AND);
		A_ASGN__RF(REGISTER_FILE_OP_FUNC_ROP + 6);
		B_ASGN_IMMNUM(0x20);
		A_ASGN_ALU(ALU_MUL_H);
		B_ASGN__RF(reg_c);
		label_1 = rom_cp;
		IFALU_PC_ASGN_IMMNUM(ALU_AND, 0);
		_RF_ASGN_IMMNUM(REGISTER_FILE_OP_FUNC_DOP, 0);
		_RF_ASGN_IMMNUM(REGISTER_FILE_OP_FUNC_DOP + 1, 0);
		_RF_ASGN_IMMNUM(REGISTER_FILE_OP_FUNC_DOP + 2, 0);
		_RF_ASGN_IMMNUM(REGISTER_FILE_OP_FUNC_DOP + 3, 0);
		_RF_ASGN_IMMNUM(REGISTER_FILE_OP_FUNC_DOP + 4, 0);
		_RF_ASGN_IMMNUM(REGISTER_FILE_OP_FUNC_DOP + 5, 0);
		_RF_ASGN_IMMNUM(REGISTER_FILE_OP_FUNC_DOP + 6, 0xf8);
		A_ASGN__RF(REGISTER_FILE_OP_FUNC_ROP + 7);
		_RF_ASGN_ALU(REGISTER_FILE_OP_FUNC_DOP + 7, ALU_OUTA);
		REGISTER_TO_A2A1A0(REGISTER_FILE_OP_FUNC_RET, 0);
		PC_ASGN_A2A1A0();
		MODIFY_A2A1A0(label_1, rom_cp >> 1);

		A_ASGN__RF(reg_lop_index);
		B_ASGN_IMMNUM(0xff);
		_RF_ASGN_ALU(reg_c, ALU_EQUAL_C);
		A_ASGN__RF(reg_lop_index + 1);
		B_ASGN_IMMNUM(0x03);
		A_ASGN_ALU(ALU_EQUAL_C);
		B_ASGN__RF(reg_c);
		label_1 = rom_cp;
		IFALU_PC_ASGN_IMMNUM(ALU_AND, 0);
		A_ASGN__RF(REGISTER_FILE_OP_FUNC_ROP);
		_RF_ASGN_ALU(REGISTER_FILE_OP_FUNC_DOP, ALU_OUTA);
		A_ASGN__RF(REGISTER_FILE_OP_FUNC_ROP + 1);
		_RF_ASGN_ALU(REGISTER_FILE_OP_FUNC_DOP + 1, ALU_OUTA);
		A_ASGN__RF(REGISTER_FILE_OP_FUNC_ROP + 2);
		_RF_ASGN_ALU(REGISTER_FILE_OP_FUNC_DOP + 2, ALU_OUTA);
		A_ASGN__RF(REGISTER_FILE_OP_FUNC_ROP + 3);
		_RF_ASGN_ALU(REGISTER_FILE_OP_FUNC_DOP + 3, ALU_OUTA);
		A_ASGN__RF(REGISTER_FILE_OP_FUNC_ROP + 4);
		_RF_ASGN_ALU(REGISTER_FILE_OP_FUNC_DOP + 4, ALU_OUTA);
		A_ASGN__RF(REGISTER_FILE_OP_FUNC_ROP + 5);
		_RF_ASGN_ALU(REGISTER_FILE_OP_FUNC_DOP + 5, ALU_OUTA);
		A_ASGN__RF(REGISTER_FILE_OP_FUNC_ROP + 6);
		_RF_ASGN_ALU(REGISTER_FILE_OP_FUNC_DOP + 6, ALU_OUTA);
		A_ASGN__RF(REGISTER_FILE_OP_FUNC_ROP + 7);
		_RF_ASGN_ALU(REGISTER_FILE_OP_FUNC_DOP + 7, ALU_OUTA);
		REGISTER_TO_A2A1A0(REGISTER_FILE_OP_FUNC_RET, 0);
		PC_ASGN_A2A1A0();
		MODIFY_A2A1A0(label_1, rom_cp >> 1);

		A_ASGN__RF(reg_lop_index);
		B_ASGN_IMMNUM(0x00);
		_RF_ASGN_ALU(reg_c, ALU_EQUAL_C);
		A_ASGN__RF(reg_lop_index + 1);
		B_ASGN_IMMNUM(0xfc);
		A_ASGN_ALU(ALU_EQUAL_C);
		B_ASGN__RF(reg_c);
		label_1 = rom_cp;
		IFALU_PC_ASGN_IMMNUM(ALU_AND, 0);
		_RF_ASGN_IMMNUM(REGISTER_FILE_OP_FUNC_DOP, 0);
		_RF_ASGN_IMMNUM(REGISTER_FILE_OP_FUNC_DOP + 1, 0);
		_RF_ASGN_IMMNUM(REGISTER_FILE_OP_FUNC_DOP + 2, 0);
		_RF_ASGN_IMMNUM(REGISTER_FILE_OP_FUNC_DOP + 3, 0);
		_RF_ASGN_IMMNUM(REGISTER_FILE_OP_FUNC_DOP + 4, 0);
		_RF_ASGN_IMMNUM(REGISTER_FILE_OP_FUNC_DOP + 5, 0);
		_RF_ASGN_IMMNUM(REGISTER_FILE_OP_FUNC_DOP + 6, 0xf0);
		A_ASGN__RF(REGISTER_FILE_OP_FUNC_LOP + 7);
		_RF_ASGN_ALU(REGISTER_FILE_OP_FUNC_DOP + 7, ALU_OUTA);
		REGISTER_TO_A2A1A0(REGISTER_FILE_OP_FUNC_RET, 0);
		PC_ASGN_A2A1A0();
		MODIFY_A2A1A0(label_1, rom_cp >> 1);

		A_ASGN__RF(reg_rop_index);
		B_ASGN_IMMNUM(0xff);
		_RF_ASGN_ALU(reg_c, ALU_EQUAL_C);
		A_ASGN__RF(reg_rop_index + 1);
		B_ASGN_IMMNUM(0x03);
		A_ASGN_ALU(ALU_EQUAL_C);
		B_ASGN__RF(reg_c);
		label_1 = rom_cp;
		IFALU_PC_ASGN_IMMNUM(ALU_AND, 0);
		A_ASGN__RF(REGISTER_FILE_OP_FUNC_LOP);
		_RF_ASGN_ALU(REGISTER_FILE_OP_FUNC_DOP, ALU_OUTA);
		A_ASGN__RF(REGISTER_FILE_OP_FUNC_LOP + 1);
		_RF_ASGN_ALU(REGISTER_FILE_OP_FUNC_DOP + 1, ALU_OUTA);
		A_ASGN__RF(REGISTER_FILE_OP_FUNC_LOP + 2);
		_RF_ASGN_ALU(REGISTER_FILE_OP_FUNC_DOP + 2, ALU_OUTA);
		A_ASGN__RF(REGISTER_FILE_OP_FUNC_LOP + 3);
		_RF_ASGN_ALU(REGISTER_FILE_OP_FUNC_DOP + 3, ALU_OUTA);
		A_ASGN__RF(REGISTER_FILE_OP_FUNC_LOP + 4);
		_RF_ASGN_ALU(REGISTER_FILE_OP_FUNC_DOP + 4, ALU_OUTA);
		A_ASGN__RF(REGISTER_FILE_OP_FUNC_LOP + 5);
		_RF_ASGN_ALU(REGISTER_FILE_OP_FUNC_DOP + 5, ALU_OUTA);
		A_ASGN__RF(REGISTER_FILE_OP_FUNC_LOP + 6);
		_RF_ASGN_ALU(REGISTER_FILE_OP_FUNC_DOP + 6, ALU_OUTA);
		A_ASGN__RF(REGISTER_FILE_OP_FUNC_LOP + 7);
		_RF_ASGN_ALU(REGISTER_FILE_OP_FUNC_DOP + 7, ALU_OUTA);
		REGISTER_TO_A2A1A0(REGISTER_FILE_OP_FUNC_RET, 0);
		PC_ASGN_A2A1A0();
		MODIFY_A2A1A0(label_1, rom_cp >> 1);

		A_ASGN__RF(reg_rop_index);
		B_ASGN_IMMNUM(0x00);
		_RF_ASGN_ALU(reg_c, ALU_EQUAL_C);
		A_ASGN__RF(reg_rop_index + 1);
		B_ASGN_IMMNUM(0xfc);
		A_ASGN_ALU(ALU_EQUAL_C);
		B_ASGN__RF(reg_c);
		label_1 = rom_cp;
		IFALU_PC_ASGN_IMMNUM(ALU_AND, 0);
		_RF_ASGN_IMMNUM(REGISTER_FILE_OP_FUNC_DOP, 0);
		_RF_ASGN_IMMNUM(REGISTER_FILE_OP_FUNC_DOP + 1, 0);
		_RF_ASGN_IMMNUM(REGISTER_FILE_OP_FUNC_DOP + 2, 0);
		_RF_ASGN_IMMNUM(REGISTER_FILE_OP_FUNC_DOP + 3, 0);
		_RF_ASGN_IMMNUM(REGISTER_FILE_OP_FUNC_DOP + 4, 0);
		_RF_ASGN_IMMNUM(REGISTER_FILE_OP_FUNC_DOP + 5, 0);
		_RF_ASGN_IMMNUM(REGISTER_FILE_OP_FUNC_DOP + 6, 0xf0);
		A_ASGN__RF(REGISTER_FILE_OP_FUNC_ROP + 7);
		_RF_ASGN_ALU(REGISTER_FILE_OP_FUNC_DOP + 7, ALU_OUTA);
		REGISTER_TO_A2A1A0(REGISTER_FILE_OP_FUNC_RET, 0);
		PC_ASGN_A2A1A0();
		MODIFY_A2A1A0(label_1, rom_cp >> 1);

		/*尾数补1.0*/
		A_ASGN_IMMNUM(0x10);
		B_ASGN__RF(REGISTER_FILE_OP_FUNC_LOP + 6);
		A_ASGN_ALU(ALU_OR);
		B_ASGN_IMMNUM(0x1f);
		RF_ASGN_ALU(ALU_AND);

		/*尾数补1.0*/
		A_ASGN_IMMNUM(0x10);
		B_ASGN__RF(REGISTER_FILE_OP_FUNC_ROP + 6);
		A_ASGN_ALU(ALU_OR);
		B_ASGN_IMMNUM(0x1f);
		RF_ASGN_ALU(ALU_AND);

		/*对齐小数点*/
		A_ASGN__RF(reg_lop_index);
		B_ASGN__RF(reg_rop_index);
		_RF_ASGN_ALU(reg_rsh_cp, ALU_SUB);
		B_ASGN_ALU(ALU_SUB_C);
		A_ASGN__RF(reg_lop_index + 1);
		A_ASGN_ALU(ALU_SUB);
		B_ASGN__RF(reg_rop_index + 1);
		_RF_ASGN_ALU(reg_rsh_cp + 1, ALU_SUB);
		B_ASGN_ALU(ALU_SUB);

		label_1 = rom_cp;
		IFALU_PC_ASGN_IMMNUM(ALU_A_BH_LSH, 0);
		/*指数相减为负数,右操作数右移*/
		
		B_ASGN_IMMNUM(52);
		A_ASGN__RF(reg_rsh_cp);
		B_ASGN_ALU(ALU_ADD_C);
		A_ASGN__RF(reg_rsh_cp + 1);
		label_4 = rom_cp;
		IFALU_PC_ASGN_IMMNUM(ALU_ADD_C, 0);
		/*右移位数小于等于52,执行移位*/
		label_3 = rom_cp >> 1;
		A_ASGN__RF(REGISTER_FILE_OP_FUNC_ROP + 1);
		B_ASGN__RF(REGISTER_FILE_OP_FUNC_ROP);
		RF_ASGN_ALU(ALU_B_AL_RSH);
		B_ASGN_ALU(ALU_OUTA);
		A_ASGN__RF(REGISTER_FILE_OP_FUNC_ROP + 2);
		_RF_ASGN_ALU(REGISTER_FILE_OP_FUNC_ROP + 1, ALU_B_AL_RSH);
		B_ASGN_ALU(ALU_OUTA);
		A_ASGN__RF(REGISTER_FILE_OP_FUNC_ROP + 3);
		_RF_ASGN_ALU(REGISTER_FILE_OP_FUNC_ROP + 2, ALU_B_AL_RSH);
		B_ASGN_ALU(ALU_OUTA);
		A_ASGN__RF(REGISTER_FILE_OP_FUNC_ROP + 4);
		_RF_ASGN_ALU(REGISTER_FILE_OP_FUNC_ROP + 3, ALU_B_AL_RSH);
		B_ASGN_ALU(ALU_OUTA);
		A_ASGN__RF(REGISTER_FILE_OP_FUNC_ROP + 5);
		_RF_ASGN_ALU(REGISTER_FILE_OP_FUNC_ROP + 4, ALU_B_AL_RSH);
		B_ASGN_ALU(ALU_OUTA);
		A_ASGN__RF(REGISTER_FILE_OP_FUNC_ROP + 6);
		RF_ASGN_ALU(ALU_A_0_RSH);
		_RF_ASGN_ALU(REGISTER_FILE_OP_FUNC_ROP + 5, ALU_B_AL_RSH);
		A_ASGN__RF(reg_rsh_cp);
		RF_ASGN_ALU(ALU_A_ADD_1);
		B_ASGN_ALU(ALU_A_ADD_1_C);
		A_ASGN__RF(reg_rsh_cp + 1);
		RF_ASGN_ALU(ALU_ADD);
		IFALU_PC_ASGN_IMMNUM(ALU_ADD_C, label_3);
		label_5 = rom_cp;
		PC_ASGN_IMMNUM(0);
		MODIFY_A2A1A0(label_4, rom_cp >> 1);
		/*右移位数大于52,清0操作数值*/
		_RF_ASGN_IMMNUM(REGISTER_FILE_OP_FUNC_ROP, 0);
		_RF_ASGN_IMMNUM(REGISTER_FILE_OP_FUNC_ROP + 1, 0);
		_RF_ASGN_IMMNUM(REGISTER_FILE_OP_FUNC_ROP + 2, 0);
		_RF_ASGN_IMMNUM(REGISTER_FILE_OP_FUNC_ROP + 3, 0);
		_RF_ASGN_IMMNUM(REGISTER_FILE_OP_FUNC_ROP + 4, 0);
		_RF_ASGN_IMMNUM(REGISTER_FILE_OP_FUNC_ROP + 5, 0);
		_RF_ASGN_IMMNUM(REGISTER_FILE_OP_FUNC_ROP + 6, 0);
		MODIFY_A2A1A0(label_5, rom_cp >> 1);
		A_ASGN__RF(reg_lop_index);
		_RF_ASGN_ALU(reg_rop_index, ALU_OUTA);
		A_ASGN__RF(reg_lop_index + 1);
		_RF_ASGN_ALU(reg_rop_index + 1, ALU_OUTA);

		label_2 = rom_cp;
		PC_ASGN_IMMNUM(0);
		MODIFY_A2A1A0(label_1, rom_cp >> 1);
		/*指数相减为正数,左操作数右移*/

		B_ASGN_IMMNUM(53);
		A_ASGN__RF(reg_rsh_cp);
		B_ASGN_ALU(ALU_SUB_C);
		A_ASGN__RF(reg_rsh_cp + 1);
		label_5 = rom_cp;
		IFALU_PC_ASGN_IMMNUM(ALU_SUB_C, 0);
		/*右移位数小于等于52,执行移位*/
		label_3 = rom_cp >> 1;
		A_ASGN__RF(reg_rsh_cp);
		RF_ASGN_ALU(ALU_A_SUB_1);
		B_ASGN_ALU(ALU_A_SUB_1_C);
		A_ASGN__RF(reg_rsh_cp + 1);
		RF_ASGN_ALU(ALU_SUB);
		A_ASGN_ALU(ALU_SUB_C);
		label_4 = rom_cp;
		IFALU_PC_ASGN_IMMNUM(ALU_A_NOT, 0);
		A_ASGN__RF(REGISTER_FILE_OP_FUNC_LOP + 1);
		B_ASGN__RF(REGISTER_FILE_OP_FUNC_LOP);
		RF_ASGN_ALU(ALU_B_AL_RSH);
		B_ASGN_ALU(ALU_OUTA);
		A_ASGN__RF(REGISTER_FILE_OP_FUNC_LOP + 2);
		_RF_ASGN_ALU(REGISTER_FILE_OP_FUNC_LOP + 1, ALU_B_AL_RSH);
		B_ASGN_ALU(ALU_OUTA);
		A_ASGN__RF(REGISTER_FILE_OP_FUNC_LOP + 3);
		_RF_ASGN_ALU(REGISTER_FILE_OP_FUNC_LOP + 2, ALU_B_AL_RSH);
		B_ASGN_ALU(ALU_OUTA);
		A_ASGN__RF(REGISTER_FILE_OP_FUNC_LOP + 4);
		_RF_ASGN_ALU(REGISTER_FILE_OP_FUNC_LOP + 3, ALU_B_AL_RSH);
		B_ASGN_ALU(ALU_OUTA);
		A_ASGN__RF(REGISTER_FILE_OP_FUNC_LOP + 5);
		_RF_ASGN_ALU(REGISTER_FILE_OP_FUNC_LOP + 4, ALU_B_AL_RSH);
		B_ASGN_ALU(ALU_OUTA);
		A_ASGN__RF(REGISTER_FILE_OP_FUNC_LOP + 6);
		RF_ASGN_ALU(ALU_A_0_RSH);
		_RF_ASGN_ALU(REGISTER_FILE_OP_FUNC_LOP + 5, ALU_B_AL_RSH);
		PC_ASGN_IMMNUM(label_3);
		MODIFY_A2A1A0(label_5, rom_cp >> 1);
		/*右移位数大于52,清0操作数值*/
		_RF_ASGN_IMMNUM(REGISTER_FILE_OP_FUNC_LOP, 0);
		_RF_ASGN_IMMNUM(REGISTER_FILE_OP_FUNC_LOP + 1, 0);
		_RF_ASGN_IMMNUM(REGISTER_FILE_OP_FUNC_LOP + 2, 0);
		_RF_ASGN_IMMNUM(REGISTER_FILE_OP_FUNC_LOP + 3, 0);
		_RF_ASGN_IMMNUM(REGISTER_FILE_OP_FUNC_LOP + 4, 0);
		_RF_ASGN_IMMNUM(REGISTER_FILE_OP_FUNC_LOP + 5, 0);
		_RF_ASGN_IMMNUM(REGISTER_FILE_OP_FUNC_LOP + 6, 0);
		MODIFY_A2A1A0(label_4, rom_cp >> 1);

		MODIFY_A2A1A0(label_2, rom_cp >> 1);

		/*53位尾数相加*/
		A_ASGN__RF(REGISTER_FILE_OP_FUNC_LOP);
		B_ASGN__RF(REGISTER_FILE_OP_FUNC_ROP);
		_RF_ASGN_ALU(REGISTER_FILE_OP_FUNC_DOP, ALU_ADD);
		B_ASGN_ALU(ALU_ADD_C);

		A_ASGN__RF(REGISTER_FILE_OP_FUNC_LOP + 1);
		_RF_ASGN_ALU(reg_c, ALU_ADD_C);
		A_ASGN_ALU(ALU_ADD);
		B_ASGN__RF(REGISTER_FILE_OP_FUNC_ROP + 1);
		_RF_ASGN_ALU(REGISTER_FILE_OP_FUNC_DOP + 1, ALU_ADD);
		B_ASGN_ALU(ALU_ADD_C);
		A_ASGN__RF(reg_c);
		B_ASGN_ALU(ALU_ADD);

		A_ASGN__RF(REGISTER_FILE_OP_FUNC_LOP + 2);
		_RF_ASGN_ALU(reg_c, ALU_ADD_C);
		A_ASGN_ALU(ALU_ADD);
		B_ASGN__RF(REGISTER_FILE_OP_FUNC_ROP + 2);
		_RF_ASGN_ALU(REGISTER_FILE_OP_FUNC_DOP + 2, ALU_ADD);
		B_ASGN_ALU(ALU_ADD_C);
		A_ASGN__RF(reg_c);
		B_ASGN_ALU(ALU_ADD);

		A_ASGN__RF(REGISTER_FILE_OP_FUNC_LOP + 3);
		_RF_ASGN_ALU(reg_c, ALU_ADD_C);
		A_ASGN_ALU(ALU_ADD);
		B_ASGN__RF(REGISTER_FILE_OP_FUNC_ROP + 3);
		_RF_ASGN_ALU(REGISTER_FILE_OP_FUNC_DOP + 3, ALU_ADD);
		B_ASGN_ALU(ALU_ADD_C);
		A_ASGN__RF(reg_c);
		B_ASGN_ALU(ALU_ADD);

		A_ASGN__RF(REGISTER_FILE_OP_FUNC_LOP + 4);
		_RF_ASGN_ALU(reg_c, ALU_ADD_C);
		A_ASGN_ALU(ALU_ADD);
		B_ASGN__RF(REGISTER_FILE_OP_FUNC_ROP + 4);
		_RF_ASGN_ALU(REGISTER_FILE_OP_FUNC_DOP + 4, ALU_ADD);
		B_ASGN_ALU(ALU_ADD_C);
		A_ASGN__RF(reg_c);
		B_ASGN_ALU(ALU_ADD);

		A_ASGN__RF(REGISTER_FILE_OP_FUNC_LOP + 5);
		_RF_ASGN_ALU(reg_c, ALU_ADD_C);
		A_ASGN_ALU(ALU_ADD);
		B_ASGN__RF(REGISTER_FILE_OP_FUNC_ROP + 5);
		_RF_ASGN_ALU(REGISTER_FILE_OP_FUNC_DOP + 5, ALU_ADD);
		B_ASGN_ALU(ALU_ADD_C);
		A_ASGN__RF(reg_c);
		B_ASGN_ALU(ALU_ADD);

		A_ASGN__RF(REGISTER_FILE_OP_FUNC_LOP + 6);
		A_ASGN_ALU(ALU_ADD);
		B_ASGN__RF(REGISTER_FILE_OP_FUNC_ROP + 6);
		_RF_ASGN_ALU(REGISTER_FILE_OP_FUNC_DOP + 6, ALU_ADD);

		/*如果有进位,尾数右移1位,指数减1*/
		B_ASGN_ALU(ALU_ADD);
		A_ASGN_IMMNUM(0x1f);
		label_1 = rom_cp;
		IFALU_PC_ASGN_IMMNUM(ALU_SUB_C, 0);
		A_ASGN__RF(REGISTER_FILE_OP_FUNC_DOP + 1);
		B_ASGN__RF(REGISTER_FILE_OP_FUNC_DOP);
		RF_ASGN_ALU(ALU_B_AL_RSH);
		B_ASGN_ALU(ALU_OUTA);
		A_ASGN__RF(REGISTER_FILE_OP_FUNC_DOP + 2);
		_RF_ASGN_ALU(REGISTER_FILE_OP_FUNC_DOP + 1, ALU_B_AL_RSH);
		B_ASGN_ALU(ALU_OUTA);
		A_ASGN__RF(REGISTER_FILE_OP_FUNC_DOP + 3);
		_RF_ASGN_ALU(REGISTER_FILE_OP_FUNC_DOP + 2, ALU_B_AL_RSH);
		B_ASGN_ALU(ALU_OUTA);
		A_ASGN__RF(REGISTER_FILE_OP_FUNC_DOP + 4);
		_RF_ASGN_ALU(REGISTER_FILE_OP_FUNC_DOP + 3, ALU_B_AL_RSH);
		B_ASGN_ALU(ALU_OUTA);
		A_ASGN__RF(REGISTER_FILE_OP_FUNC_DOP + 5);
		_RF_ASGN_ALU(REGISTER_FILE_OP_FUNC_DOP + 4, ALU_B_AL_RSH);
		B_ASGN_ALU(ALU_OUTA);
		A_ASGN__RF(REGISTER_FILE_OP_FUNC_DOP + 6);
		RF_ASGN_ALU(ALU_A_0_RSH);
		_RF_ASGN_ALU(REGISTER_FILE_OP_FUNC_DOP + 5, ALU_B_AL_RSH);
		A_ASGN__RF(reg_rop_index);
		RF_ASGN_ALU(ALU_A_SUB_1);
		B_ASGN_ALU(ALU_A_SUB_1_C);
		A_ASGN__RF(reg_rop_index + 1);
		RF_ASGN_ALU(ALU_SUB);
		A_ASGN_ALU(ALU_SUB);
		B_ASGN_IMMNUM(0xfc);
		_RF_ASGN_ALU(reg_c, ALU_EQUAL_C);
		A_ASGN__RF(reg_rop_index);
		B_ASGN_IMMNUM(0x00);
		A_ASGN_ALU(ALU_EQUAL_C);
		B_ASGN__RF(reg_c);
		label_2 = rom_cp;
		IFALU_PC_ASGN_IMMNUM(ALU_AND, 0);
		_RF_ASGN_IMMNUM(REGISTER_FILE_OP_FUNC_DOP, 0);
		_RF_ASGN_IMMNUM(REGISTER_FILE_OP_FUNC_DOP + 1, 0);
		_RF_ASGN_IMMNUM(REGISTER_FILE_OP_FUNC_DOP + 2, 0);
		_RF_ASGN_IMMNUM(REGISTER_FILE_OP_FUNC_DOP + 3, 0);
		_RF_ASGN_IMMNUM(REGISTER_FILE_OP_FUNC_DOP + 4, 0);
		_RF_ASGN_IMMNUM(REGISTER_FILE_OP_FUNC_DOP + 5, 0);
		_RF_ASGN_IMMNUM(REGISTER_FILE_OP_FUNC_DOP + 6, 0);
		MODIFY_A2A1A0(label_2, rom_cp >> 1);
		MODIFY_A2A1A0(label_1, rom_cp >> 1);

		/*隐藏尾数的1.0*/
		A_ASGN_IMMNUM(0x0f);
		B_ASGN__RF(REGISTER_FILE_OP_FUNC_DOP + 6);
		RF_ASGN_ALU(ALU_AND);
		
		/*指数转换为原格式,并装回指数和符号*/
		A_ASGN__RF(reg_rop_index);
		B_ASGN_IMMNUM(0x10);
		_RF_ASGN_ALU(reg_c, ALU_MUL_H);
		A_ASGN_ALU(ALU_MUL_L);
		B_ASGN_IMMNUM(0xf0);
		A_ASGN_ALU(ALU_XOR);
		B_ASGN__RF(REGISTER_FILE_OP_FUNC_DOP + 6);
		RF_ASGN_ALU(ALU_OR);
		A_ASGN__RF(reg_rop_index + 1);
		B_ASGN_IMMNUM(0x10);
		A_ASGN_ALU(ALU_MUL_L);
		B_ASGN__RF(reg_c);
		A_ASGN_ALU(ALU_OR);
		B_ASGN_IMMNUM(0x3f);
		A_ASGN_ALU(ALU_XOR);
		B_ASGN__RF(REGISTER_FILE_OP_FUNC_LOP + 7);
		A_ASGN_ALU(ALU_A_BH_LSH);
		B_ASGN_ALU(ALU_OUTA);
		_RF_ASGN_ALU(REGISTER_FILE_OP_FUNC_DOP + 7, ALU_B_AL_RSH);

		REGISTER_TO_A2A1A0(REGISTER_FILE_OP_FUNC_RET, 0);
		PC_ASGN_A2A1A0();
		MODIFY_A2A1A0(label_0, rom_cp >> 1);
	}
}

/*float减法函数生成,(节省运算量,这里不处理极限值,不处理舍入)*/
void float_sub_func_gen() {
	if (float_sub_func_romaddr == 0) {
		unsigned long label_0, label_1, label_2, label_3, label_4, label_5;
		unsigned char reg_lop_index = REGISTER_FILE_OP_FUNC_CACHE;
		unsigned char reg_rop_index = REGISTER_FILE_OP_FUNC_CACHE + 1;
		unsigned char reg_rsh_cp = REGISTER_FILE_OP_FUNC_CACHE + 2;
		unsigned char reg_c = REGISTER_FILE_OP_FUNC_CACHE + 3;
		unsigned char reg_lsh_cp = REGISTER_FILE_OP_FUNC_CACHE + 4;

		label_0 = rom_cp;
		PC_ASGN_IMMNUM(0);
		float_sub_func_romaddr = rom_cp >> 1;

		/*数符不相同则转换为加法*/
		B_ASGN__RF(REGISTER_FILE_OP_FUNC_LOP + 3);
		A_ASGN__RF(REGISTER_FILE_OP_FUNC_ROP + 3);
		B_ASGN_ALU(ALU_XOR);
		label_1 = rom_cp;
		IFALU_PC_ASGN_IMMNUM(ALU_A_BH_LSH, 0);
		B_ASGN_IMMNUM(0x80);
		RF_ASGN_ALU(ALU_XOR);
		float_add_func_gen();
		PC_ASGN_IMMNUM(float_add_func_romaddr);
		MODIFY_A2A1A0(label_1, rom_cp >> 1);

		/*提取指数,判断操作数是否为0或无穷大*/
		B_ASGN__RF(REGISTER_FILE_OP_FUNC_LOP + 2);
		A_ASGN__RF(REGISTER_FILE_OP_FUNC_LOP + 3);
		B_ASGN_ALU(ALU_A_BH_LSH);
		A_ASGN_IMMNUM(0x7f);
		_RF_ASGN_ALU(reg_lop_index, ALU_XOR);
		B_ASGN__RF(REGISTER_FILE_OP_FUNC_ROP + 2);
		A_ASGN__RF(REGISTER_FILE_OP_FUNC_ROP + 3);
		B_ASGN_ALU(ALU_A_BH_LSH);
		A_ASGN_IMMNUM(0x7f);
		_RF_ASGN_ALU(reg_rop_index, ALU_XOR);

		A_ASGN__RF(reg_lop_index);
		B_ASGN_IMMNUM(-128);
		_RF_ASGN_ALU(reg_c, ALU_EQUAL_C);
		A_ASGN__RF(REGISTER_FILE_OP_FUNC_LOP + 2);
		B_ASGN_ALU(ALU_A_0_LSH);
		A_ASGN_ALU(ALU_A_BH_LSH);
		B_ASGN__RF(reg_c);
		label_1 = rom_cp;
		IFALU_PC_ASGN_IMMNUM(ALU_AND, 0);
		_RF_ASGN_IMMNUM(REGISTER_FILE_OP_FUNC_DOP, 0);
		_RF_ASGN_IMMNUM(REGISTER_FILE_OP_FUNC_DOP + 1, 0);
		_RF_ASGN_IMMNUM(REGISTER_FILE_OP_FUNC_DOP + 2, 0xc0);
		A_ASGN__RF(REGISTER_FILE_OP_FUNC_LOP + 3);
		_RF_ASGN_ALU(REGISTER_FILE_OP_FUNC_DOP + 3, ALU_OUTA);
		REGISTER_TO_A2A1A0(REGISTER_FILE_OP_FUNC_RET, 0);
		PC_ASGN_A2A1A0();
		MODIFY_A2A1A0(label_1, rom_cp >> 1);

		A_ASGN__RF(reg_rop_index);
		B_ASGN_IMMNUM(-128);
		_RF_ASGN_ALU(reg_c, ALU_EQUAL_C);
		A_ASGN__RF(REGISTER_FILE_OP_FUNC_ROP + 2);
		B_ASGN_ALU(ALU_A_0_LSH);
		A_ASGN_ALU(ALU_A_BH_LSH);
		B_ASGN__RF(reg_c);
		label_1 = rom_cp;
		IFALU_PC_ASGN_IMMNUM(ALU_AND, 0);
		_RF_ASGN_IMMNUM(REGISTER_FILE_OP_FUNC_DOP, 0);
		_RF_ASGN_IMMNUM(REGISTER_FILE_OP_FUNC_DOP + 1, 0);
		_RF_ASGN_IMMNUM(REGISTER_FILE_OP_FUNC_DOP + 2, 0xc0);
		A_ASGN__RF(REGISTER_FILE_OP_FUNC_ROP + 3);
		_RF_ASGN_ALU(REGISTER_FILE_OP_FUNC_DOP + 3, ALU_OUTA);
		REGISTER_TO_A2A1A0(REGISTER_FILE_OP_FUNC_RET, 0);
		PC_ASGN_A2A1A0();
		MODIFY_A2A1A0(label_1, rom_cp >> 1);

		B_ASGN_IMMNUM(-128);
		A_ASGN__RF(reg_lop_index);
		_RF_ASGN_ALU(reg_c, ALU_EQUAL_C);
		A_ASGN__RF(reg_rop_index);
		B_ASGN_ALU(ALU_EQUAL_C);
		A_ASGN__RF(reg_c);
		label_1 = rom_cp;
		IFALU_PC_ASGN_IMMNUM(ALU_AND, 0);
		_RF_ASGN_IMMNUM(REGISTER_FILE_OP_FUNC_DOP, 0);
		_RF_ASGN_IMMNUM(REGISTER_FILE_OP_FUNC_DOP + 1, 0);
		_RF_ASGN_IMMNUM(REGISTER_FILE_OP_FUNC_DOP + 2, 0xc0);
		_RF_ASGN_IMMNUM(REGISTER_FILE_OP_FUNC_DOP + 3, 0xff);
		REGISTER_TO_A2A1A0(REGISTER_FILE_OP_FUNC_RET, 0);
		PC_ASGN_A2A1A0();
		MODIFY_A2A1A0(label_1, rom_cp >> 1);

		A_ASGN__RF(reg_lop_index);
		B_ASGN_IMMNUM(127);
		label_1 = rom_cp;
		IFALU_PC_ASGN_IMMNUM(ALU_EQUAL_C, 0);
		A_ASGN__RF(REGISTER_FILE_OP_FUNC_ROP);
		_RF_ASGN_ALU(REGISTER_FILE_OP_FUNC_DOP, ALU_OUTA);
		A_ASGN__RF(REGISTER_FILE_OP_FUNC_ROP + 1);
		_RF_ASGN_ALU(REGISTER_FILE_OP_FUNC_DOP + 1, ALU_OUTA);
		A_ASGN__RF(REGISTER_FILE_OP_FUNC_ROP + 2);
		_RF_ASGN_ALU(REGISTER_FILE_OP_FUNC_DOP + 2, ALU_OUTA);
		A_ASGN__RF(REGISTER_FILE_OP_FUNC_ROP + 3);
		B_ASGN_IMMNUM(0x80);
		_RF_ASGN_ALU(REGISTER_FILE_OP_FUNC_DOP + 3, ALU_XOR);
		REGISTER_TO_A2A1A0(REGISTER_FILE_OP_FUNC_RET, 0);
		PC_ASGN_A2A1A0();
		MODIFY_A2A1A0(label_1, rom_cp >> 1);

		B_ASGN_IMMNUM(-128);
		label_1 = rom_cp;
		IFALU_PC_ASGN_IMMNUM(ALU_EQUAL_C, 0);
		_RF_ASGN_IMMNUM(REGISTER_FILE_OP_FUNC_DOP, 0);
		_RF_ASGN_IMMNUM(REGISTER_FILE_OP_FUNC_DOP + 1, 0);
		_RF_ASGN_IMMNUM(REGISTER_FILE_OP_FUNC_DOP + 2, 0x80);
		A_ASGN__RF(REGISTER_FILE_OP_FUNC_LOP + 3);
		_RF_ASGN_ALU(REGISTER_FILE_OP_FUNC_DOP + 3, ALU_OUTA);
		REGISTER_TO_A2A1A0(REGISTER_FILE_OP_FUNC_RET, 0);
		PC_ASGN_A2A1A0();
		MODIFY_A2A1A0(label_1, rom_cp >> 1);

		A_ASGN__RF(reg_rop_index);
		B_ASGN_IMMNUM(127);
		label_1 = rom_cp;
		IFALU_PC_ASGN_IMMNUM(ALU_EQUAL_C, 0);
		A_ASGN__RF(REGISTER_FILE_OP_FUNC_LOP);
		_RF_ASGN_ALU(REGISTER_FILE_OP_FUNC_DOP, ALU_OUTA);
		A_ASGN__RF(REGISTER_FILE_OP_FUNC_LOP + 1);
		_RF_ASGN_ALU(REGISTER_FILE_OP_FUNC_DOP + 1, ALU_OUTA);
		A_ASGN__RF(REGISTER_FILE_OP_FUNC_LOP + 2);
		_RF_ASGN_ALU(REGISTER_FILE_OP_FUNC_DOP + 2, ALU_OUTA);
		A_ASGN__RF(REGISTER_FILE_OP_FUNC_LOP + 3);
		_RF_ASGN_ALU(REGISTER_FILE_OP_FUNC_DOP + 3, ALU_OUTA);
		REGISTER_TO_A2A1A0(REGISTER_FILE_OP_FUNC_RET, 0);
		PC_ASGN_A2A1A0();
		MODIFY_A2A1A0(label_1, rom_cp >> 1);

		B_ASGN_IMMNUM(-128);
		label_1 = rom_cp;
		IFALU_PC_ASGN_IMMNUM(ALU_EQUAL_C, 0);
		_RF_ASGN_IMMNUM(REGISTER_FILE_OP_FUNC_DOP, 0);
		_RF_ASGN_IMMNUM(REGISTER_FILE_OP_FUNC_DOP + 1, 0);
		_RF_ASGN_IMMNUM(REGISTER_FILE_OP_FUNC_DOP + 2, 0x80);
		A_ASGN__RF(REGISTER_FILE_OP_FUNC_ROP + 3);
		B_ASGN_IMMNUM(0x80);
		_RF_ASGN_ALU(REGISTER_FILE_OP_FUNC_DOP + 3, ALU_XOR);
		REGISTER_TO_A2A1A0(REGISTER_FILE_OP_FUNC_RET, 0);
		PC_ASGN_A2A1A0();
		MODIFY_A2A1A0(label_1, rom_cp >> 1);

		/*补1.0*/
		A_ASGN_IMMNUM(0x80);
		B_ASGN__RF(REGISTER_FILE_OP_FUNC_LOP + 2);
		RF_ASGN_ALU(ALU_OR);
		B_ASGN__RF(REGISTER_FILE_OP_FUNC_ROP + 2);
		RF_ASGN_ALU(ALU_OR);

		/*对齐小数点*/
		A_ASGN__RF(reg_lop_index);
		B_ASGN__RF(reg_rop_index);
		_RF_ASGN_ALU(reg_rsh_cp, ALU_SUB);
		B_ASGN_ALU(ALU_SUB);
		label_1 = rom_cp;
		IFALU_PC_ASGN_IMMNUM(ALU_A_BH_LSH, 0);
		/*指数相减为负数,右操作数右移*/

		A_ASGN_IMMNUM(23);
		label_4 = rom_cp;
		IFALU_PC_ASGN_IMMNUM(ALU_ADD_C, 0);
		/*右移位数小于等于23,执行移位*/
		label_3 = rom_cp >> 1;
		A_ASGN__RF(REGISTER_FILE_OP_FUNC_ROP + 1);
		B_ASGN__RF(REGISTER_FILE_OP_FUNC_ROP);
		RF_ASGN_ALU(ALU_B_AL_RSH);
		B_ASGN_ALU(ALU_OUTA);
		A_ASGN__RF(REGISTER_FILE_OP_FUNC_ROP + 2);
		RF_ASGN_ALU(ALU_A_0_RSH);
		_RF_ASGN_ALU(REGISTER_FILE_OP_FUNC_ROP + 1, ALU_B_AL_RSH);
		A_ASGN__RF(reg_rsh_cp);
		RF_ASGN_ALU(ALU_A_ADD_1);
		IFALU_PC_ASGN_IMMNUM(ALU_A_ADD_1_C, label_3);
		label_5 = rom_cp;
		PC_ASGN_IMMNUM(0);
		MODIFY_A2A1A0(label_4, rom_cp >> 1);
		/*右移位数大于23,清0操作数值*/
		_RF_ASGN_IMMNUM(REGISTER_FILE_OP_FUNC_ROP, 0);
		_RF_ASGN_IMMNUM(REGISTER_FILE_OP_FUNC_ROP + 1, 0);
		_RF_ASGN_IMMNUM(REGISTER_FILE_OP_FUNC_ROP + 2, 0);
		MODIFY_A2A1A0(label_5, rom_cp >> 1);
		A_ASGN__RF(reg_lop_index);
		_RF_ASGN_ALU(reg_rop_index, ALU_OUTA);

		label_2 = rom_cp;
		PC_ASGN_IMMNUM(0);
		MODIFY_A2A1A0(label_1, rom_cp >> 1);
		/*指数相减为正数,左操作数右移*/

		A_ASGN_ALU(ALU_OUTB);
		B_ASGN_IMMNUM(24);
		label_5 = rom_cp;
		IFALU_PC_ASGN_IMMNUM(ALU_SUB_C, 0);
		/*右移位数小于等于23,执行移位*/
		label_3 = rom_cp >> 1;
		A_ASGN__RF(reg_rsh_cp);
		RF_ASGN_ALU(ALU_A_SUB_1);
		A_ASGN_ALU(ALU_A_SUB_1_C);
		label_4 = rom_cp;
		IFALU_PC_ASGN_IMMNUM(ALU_A_NOT, 0);
		A_ASGN__RF(REGISTER_FILE_OP_FUNC_LOP + 1);
		B_ASGN__RF(REGISTER_FILE_OP_FUNC_LOP);
		RF_ASGN_ALU(ALU_B_AL_RSH);
		B_ASGN_ALU(ALU_OUTA);
		A_ASGN__RF(REGISTER_FILE_OP_FUNC_LOP + 2);
		RF_ASGN_ALU(ALU_A_0_RSH);
		_RF_ASGN_ALU(REGISTER_FILE_OP_FUNC_LOP + 1, ALU_B_AL_RSH);
		PC_ASGN_IMMNUM(label_3);
		MODIFY_A2A1A0(label_5, rom_cp >> 1);
		/*右移位数大于23,清0操作数值*/
		_RF_ASGN_IMMNUM(REGISTER_FILE_OP_FUNC_LOP, 0);
		_RF_ASGN_IMMNUM(REGISTER_FILE_OP_FUNC_LOP + 1, 0);
		_RF_ASGN_IMMNUM(REGISTER_FILE_OP_FUNC_LOP + 2, 0);
		MODIFY_A2A1A0(label_4, rom_cp >> 1);

		MODIFY_A2A1A0(label_2, rom_cp >> 1);

		/*24位尾数相减*/
		A_ASGN__RF(REGISTER_FILE_OP_FUNC_LOP);
		B_ASGN__RF(REGISTER_FILE_OP_FUNC_ROP);
		_RF_ASGN_ALU(REGISTER_FILE_OP_FUNC_DOP, ALU_SUB);
		B_ASGN_ALU(ALU_SUB_C);

		A_ASGN__RF(REGISTER_FILE_OP_FUNC_LOP + 1);
		_RF_ASGN_ALU(reg_c, ALU_SUB_C);
		A_ASGN_ALU(ALU_SUB);
		B_ASGN__RF(REGISTER_FILE_OP_FUNC_ROP + 1);
		_RF_ASGN_ALU(REGISTER_FILE_OP_FUNC_DOP + 1, ALU_SUB);
		B_ASGN_ALU(ALU_SUB_C);
		A_ASGN__RF(reg_c);
		B_ASGN_ALU(ALU_ADD);

		A_ASGN__RF(REGISTER_FILE_OP_FUNC_LOP + 2);
		_RF_ASGN_ALU(reg_c, ALU_SUB_C);
		A_ASGN_ALU(ALU_SUB);
		B_ASGN__RF(REGISTER_FILE_OP_FUNC_ROP + 2);
		_RF_ASGN_ALU(REGISTER_FILE_OP_FUNC_DOP + 2, ALU_SUB);
		B_ASGN_ALU(ALU_SUB_C);
		A_ASGN__RF(reg_c);

		/*如果有借位,尾数取反加1,符号取反*/
		label_1 = rom_cp;
		IFALU_PC_ASGN_IMMNUM(ALU_ADD, 0);
		A_ASGN__RF(REGISTER_FILE_OP_FUNC_DOP);
		A_ASGN_ALU(ALU_A_NOT);
		RF_ASGN_ALU(ALU_A_ADD_1);
		B_ASGN_ALU(ALU_A_ADD_1_C);
		A_ASGN__RF(REGISTER_FILE_OP_FUNC_DOP + 1);
		A_ASGN_ALU(ALU_A_NOT);
		RF_ASGN_ALU(ALU_ADD);
		B_ASGN_ALU(ALU_ADD_C);
		A_ASGN__RF(REGISTER_FILE_OP_FUNC_DOP + 2);
		A_ASGN_ALU(ALU_A_NOT);
		RF_ASGN_ALU(ALU_ADD);
		A_ASGN__RF(REGISTER_FILE_OP_FUNC_LOP + 3);
		RF_ASGN_ALU(ALU_A_NOT);
		MODIFY_A2A1A0(label_1, rom_cp >> 1);

		/*尾数最高位对齐1.0,尾数为0则输出结果为0*/
		_RF_ASGN_IMMNUM(reg_lsh_cp, 23);
		label_2 = rom_cp >> 1;
		B_ASGN__RF(REGISTER_FILE_OP_FUNC_DOP + 2);
		A_ASGN_ALU(ALU_A_BH_LSH);
		label_1 = rom_cp;
		IFALU_PC_ASGN_IMMNUM(ALU_A_NOT, 0);
		A_ASGN_ALU(ALU_OUTB);
		B_ASGN__RF(REGISTER_FILE_OP_FUNC_DOP + 1);
		_RF_ASGN_ALU(REGISTER_FILE_OP_FUNC_DOP + 2, ALU_A_BH_LSH);
		A_ASGN_ALU(ALU_OUTB);
		B_ASGN__RF(REGISTER_FILE_OP_FUNC_DOP);
		RF_ASGN_ALU(ALU_B_0_LSH);
		_RF_ASGN_ALU(REGISTER_FILE_OP_FUNC_DOP + 1, ALU_A_BH_LSH);
		A_ASGN__RF(reg_lsh_cp);
		RF_ASGN_ALU(ALU_A_SUB_1);
		IFALU_PC_ASGN_IMMNUM(ALU_A_SUB_1_C, label_2);
		_RF_ASGN_IMMNUM(REGISTER_FILE_OP_FUNC_DOP + 3, 0);
		REGISTER_TO_A2A1A0(REGISTER_FILE_OP_FUNC_RET, 0);
		PC_ASGN_A2A1A0();
		MODIFY_A2A1A0(label_1, rom_cp >> 1);

		/*调整指数并转换为原格式*/
		B_ASGN_IMMNUM(23);
		A_ASGN__RF(reg_lsh_cp);
		B_ASGN_ALU(ALU_SUB);
		A_ASGN__RF(reg_rop_index);
		RF_ASGN_ALU(ALU_SUB);
		B_ASGN_IMMNUM(128);
		label_1 = rom_cp;
		IFALU_PC_ASGN_IMMNUM(ALU_SUB_C, 0);
		A_ASGN_IMMNUM(126);
		B_ASGN__RF(reg_rop_index);
		label_2 = rom_cp;
		IFALU_PC_ASGN_IMMNUM(ALU_SUB_C, 0);
		_RF_ASGN_IMMNUM(REGISTER_FILE_OP_FUNC_DOP, 0);
		_RF_ASGN_IMMNUM(REGISTER_FILE_OP_FUNC_DOP + 1, 0);
		_RF_ASGN_IMMNUM(REGISTER_FILE_OP_FUNC_DOP + 2, 0);
		_RF_ASGN_IMMNUM(REGISTER_FILE_OP_FUNC_DOP + 3, 0);
		REGISTER_TO_A2A1A0(REGISTER_FILE_OP_FUNC_RET, 0);
		PC_ASGN_A2A1A0();
		MODIFY_A2A1A0(label_2, rom_cp >> 1);
		MODIFY_A2A1A0(label_1, rom_cp >> 1);
		B_ASGN__RF(reg_rop_index);
		A_ASGN_IMMNUM(0x7f);
		RF_ASGN_ALU(ALU_XOR);

		/*装回指数和符号*/
		A_ASGN_ALU(ALU_XOR);
		B_ASGN__RF(REGISTER_FILE_OP_FUNC_DOP + 2);
		B_ASGN_ALU(ALU_B_0_LSH);
		RF_ASGN_ALU(ALU_B_AL_RSH);
		B_ASGN__RF(REGISTER_FILE_OP_FUNC_LOP + 3);
		A_ASGN_ALU(ALU_A_BH_LSH);
		B_ASGN__RF(reg_rop_index);
		_RF_ASGN_ALU(REGISTER_FILE_OP_FUNC_DOP + 3, ALU_B_AL_RSH);

		REGISTER_TO_A2A1A0(REGISTER_FILE_OP_FUNC_RET, 0);
		PC_ASGN_A2A1A0();
		MODIFY_A2A1A0(label_0, rom_cp >> 1);
	}
}

/*double减法函数生成,(节省运算量,这里不处理极限值,不处理舍入)*/
void double_sub_func_gen() {
	if (double_sub_func_romaddr == 0) {
		unsigned long label_0, label_1, label_2, label_3, label_4, label_5;
		unsigned char reg_lop_index = REGISTER_FILE_OP_FUNC_CACHE;
		unsigned char reg_rop_index = REGISTER_FILE_OP_FUNC_CACHE + 2;
		unsigned char reg_rsh_cp = REGISTER_FILE_OP_FUNC_CACHE + 4;
		unsigned char reg_c = REGISTER_FILE_OP_FUNC_CACHE + 6;
		unsigned char reg_lsh_cp = REGISTER_FILE_OP_FUNC_CACHE + 7;

		label_0 = rom_cp;
		PC_ASGN_IMMNUM(0);
		double_sub_func_romaddr = rom_cp >> 1;

		/*数符不相同则转换为加法*/
		B_ASGN__RF(REGISTER_FILE_OP_FUNC_LOP + 7);
		A_ASGN__RF(REGISTER_FILE_OP_FUNC_ROP + 7);
		B_ASGN_ALU(ALU_XOR);
		label_1 = rom_cp;
		IFALU_PC_ASGN_IMMNUM(ALU_A_BH_LSH, 0);
		B_ASGN_IMMNUM(0x80);
		RF_ASGN_ALU(ALU_XOR);
		double_add_func_gen();
		PC_ASGN_IMMNUM(double_add_func_romaddr);
		MODIFY_A2A1A0(label_1, rom_cp >> 1);

		/*提取指数*/
		B_ASGN__RF(REGISTER_FILE_OP_FUNC_LOP + 7);
		A_ASGN_ALU(ALU_B_0_LSH);
		B_ASGN__RF(REGISTER_FILE_OP_FUNC_LOP + 6);
		A_ASGN_ALU(ALU_A_AH_RSH);
		B_ASGN_ALU(ALU_B_AL_RSH);
		A_ASGN_ALU(ALU_A_AH_RSH);
		B_ASGN_ALU(ALU_B_AL_RSH);
		A_ASGN_ALU(ALU_A_AH_RSH);
		B_ASGN_ALU(ALU_B_AL_RSH);
		A_ASGN_ALU(ALU_A_AH_RSH);
		B_ASGN_ALU(ALU_B_AL_RSH);
		_RF_ASGN_ALU(reg_lop_index + 1, ALU_A_AH_RSH);
		A_ASGN_IMMNUM(0xff);
		_RF_ASGN_ALU(reg_lop_index, ALU_XOR);
		A_ASGN__RF(reg_lop_index + 1);
		B_ASGN_IMMNUM(0x03);
		RF_ASGN_ALU(ALU_XOR);

		B_ASGN__RF(REGISTER_FILE_OP_FUNC_ROP + 7);
		A_ASGN_ALU(ALU_B_0_LSH);
		B_ASGN__RF(REGISTER_FILE_OP_FUNC_ROP + 6);
		A_ASGN_ALU(ALU_A_AH_RSH);
		B_ASGN_ALU(ALU_B_AL_RSH);
		A_ASGN_ALU(ALU_A_AH_RSH);
		B_ASGN_ALU(ALU_B_AL_RSH);
		A_ASGN_ALU(ALU_A_AH_RSH);
		B_ASGN_ALU(ALU_B_AL_RSH);
		A_ASGN_ALU(ALU_A_AH_RSH);
		B_ASGN_ALU(ALU_B_AL_RSH);
		_RF_ASGN_ALU(reg_rop_index + 1, ALU_A_AH_RSH);
		A_ASGN_IMMNUM(0xff);
		_RF_ASGN_ALU(reg_rop_index, ALU_XOR);
		A_ASGN__RF(reg_rop_index + 1);
		B_ASGN_IMMNUM(0x03);
		RF_ASGN_ALU(ALU_XOR);

		/*左操作数是nan输出nan*/
		A_ASGN__RF(reg_lop_index);
		B_ASGN_IMMNUM(0x00);
		_RF_ASGN_ALU(reg_c, ALU_EQUAL_C);
		A_ASGN__RF(reg_lop_index + 1);
		B_ASGN_IMMNUM(0xfc);
		A_ASGN_ALU(ALU_EQUAL_C);
		B_ASGN__RF(reg_c);
		RF_ASGN_ALU(ALU_AND);
		A_ASGN__RF(REGISTER_FILE_OP_FUNC_LOP + 6);
		B_ASGN_IMMNUM(0x20);
		A_ASGN_ALU(ALU_MUL_H);
		B_ASGN__RF(reg_c);
		label_1 = rom_cp;
		IFALU_PC_ASGN_IMMNUM(ALU_AND, 0);
		_RF_ASGN_IMMNUM(REGISTER_FILE_OP_FUNC_DOP, 0);
		_RF_ASGN_IMMNUM(REGISTER_FILE_OP_FUNC_DOP + 1, 0);
		_RF_ASGN_IMMNUM(REGISTER_FILE_OP_FUNC_DOP + 2, 0);
		_RF_ASGN_IMMNUM(REGISTER_FILE_OP_FUNC_DOP + 3, 0);
		_RF_ASGN_IMMNUM(REGISTER_FILE_OP_FUNC_DOP + 4, 0);
		_RF_ASGN_IMMNUM(REGISTER_FILE_OP_FUNC_DOP + 5, 0);
		_RF_ASGN_IMMNUM(REGISTER_FILE_OP_FUNC_DOP + 6, 0xf8);
		A_ASGN__RF(REGISTER_FILE_OP_FUNC_LOP + 7);
		_RF_ASGN_ALU(REGISTER_FILE_OP_FUNC_DOP + 7, ALU_OUTA);
		REGISTER_TO_A2A1A0(REGISTER_FILE_OP_FUNC_RET, 0);
		PC_ASGN_A2A1A0();
		MODIFY_A2A1A0(label_1, rom_cp >> 1);

		/*右操作数是nan输出nan*/
		A_ASGN__RF(reg_rop_index);
		B_ASGN_IMMNUM(0x00);
		_RF_ASGN_ALU(reg_c, ALU_EQUAL_C);
		A_ASGN__RF(reg_rop_index + 1);
		B_ASGN_IMMNUM(0xfc);
		A_ASGN_ALU(ALU_EQUAL_C);
		B_ASGN__RF(reg_c);
		RF_ASGN_ALU(ALU_AND);
		A_ASGN__RF(REGISTER_FILE_OP_FUNC_ROP + 6);
		B_ASGN_IMMNUM(0x20);
		A_ASGN_ALU(ALU_MUL_H);
		B_ASGN__RF(reg_c);
		label_1 = rom_cp;
		IFALU_PC_ASGN_IMMNUM(ALU_AND, 0);
		_RF_ASGN_IMMNUM(REGISTER_FILE_OP_FUNC_DOP, 0);
		_RF_ASGN_IMMNUM(REGISTER_FILE_OP_FUNC_DOP + 1, 0);
		_RF_ASGN_IMMNUM(REGISTER_FILE_OP_FUNC_DOP + 2, 0);
		_RF_ASGN_IMMNUM(REGISTER_FILE_OP_FUNC_DOP + 3, 0);
		_RF_ASGN_IMMNUM(REGISTER_FILE_OP_FUNC_DOP + 4, 0);
		_RF_ASGN_IMMNUM(REGISTER_FILE_OP_FUNC_DOP + 5, 0);
		_RF_ASGN_IMMNUM(REGISTER_FILE_OP_FUNC_DOP + 6, 0xf8);
		A_ASGN__RF(REGISTER_FILE_OP_FUNC_ROP + 7);
		_RF_ASGN_ALU(REGISTER_FILE_OP_FUNC_DOP + 7, ALU_OUTA);
		REGISTER_TO_A2A1A0(REGISTER_FILE_OP_FUNC_RET, 0);
		PC_ASGN_A2A1A0();
		MODIFY_A2A1A0(label_1, rom_cp >> 1);

		/*左操作数和右操作数都是无穷大输出nan*/
		A_ASGN__RF(reg_lop_index);
		B_ASGN_IMMNUM(0x00);
		_RF_ASGN_ALU(reg_c, ALU_EQUAL_C);
		A_ASGN__RF(reg_lop_index + 1);
		B_ASGN_IMMNUM(0xfc);
		A_ASGN_ALU(ALU_EQUAL_C);
		B_ASGN__RF(reg_c);
		RF_ASGN_ALU(ALU_AND);
		A_ASGN__RF(reg_rop_index);
		B_ASGN_IMMNUM(0x00);
		A_ASGN_ALU(ALU_EQUAL_C);
		B_ASGN__RF(reg_c);
		RF_ASGN_ALU(ALU_AND);
		A_ASGN__RF(reg_rop_index + 1);
		B_ASGN_IMMNUM(0xfc);
		A_ASGN_ALU(ALU_EQUAL_C);
		B_ASGN__RF(reg_c);
		label_1 = rom_cp;
		IFALU_PC_ASGN_IMMNUM(ALU_AND, 0);
		_RF_ASGN_IMMNUM(REGISTER_FILE_OP_FUNC_DOP, 0);
		_RF_ASGN_IMMNUM(REGISTER_FILE_OP_FUNC_DOP + 1, 0);
		_RF_ASGN_IMMNUM(REGISTER_FILE_OP_FUNC_DOP + 2, 0);
		_RF_ASGN_IMMNUM(REGISTER_FILE_OP_FUNC_DOP + 3, 0);
		_RF_ASGN_IMMNUM(REGISTER_FILE_OP_FUNC_DOP + 4, 0);
		_RF_ASGN_IMMNUM(REGISTER_FILE_OP_FUNC_DOP + 5, 0);
		_RF_ASGN_IMMNUM(REGISTER_FILE_OP_FUNC_DOP + 6, 0xf8);
		_RF_ASGN_IMMNUM(REGISTER_FILE_OP_FUNC_DOP + 7, 0xff);
		REGISTER_TO_A2A1A0(REGISTER_FILE_OP_FUNC_RET, 0);
		PC_ASGN_A2A1A0();
		MODIFY_A2A1A0(label_1, rom_cp >> 1);

		/*右操作数是0输出左操作数*/
		A_ASGN__RF(reg_rop_index);
		B_ASGN_IMMNUM(0xff);
		_RF_ASGN_ALU(reg_c, ALU_EQUAL_C);
		A_ASGN__RF(reg_rop_index + 1);
		B_ASGN_IMMNUM(0x03);
		A_ASGN_ALU(ALU_EQUAL_C);
		B_ASGN__RF(reg_c);
		label_1 = rom_cp;
		IFALU_PC_ASGN_IMMNUM(ALU_AND, 0);
		A_ASGN__RF(REGISTER_FILE_OP_FUNC_LOP);
		_RF_ASGN_ALU(REGISTER_FILE_OP_FUNC_DOP, ALU_OUTA);
		A_ASGN__RF(REGISTER_FILE_OP_FUNC_LOP + 1);
		_RF_ASGN_ALU(REGISTER_FILE_OP_FUNC_DOP + 1, ALU_OUTA);
		A_ASGN__RF(REGISTER_FILE_OP_FUNC_LOP + 2);
		_RF_ASGN_ALU(REGISTER_FILE_OP_FUNC_DOP + 2, ALU_OUTA);
		A_ASGN__RF(REGISTER_FILE_OP_FUNC_LOP + 3);
		_RF_ASGN_ALU(REGISTER_FILE_OP_FUNC_DOP + 3, ALU_OUTA);
		A_ASGN__RF(REGISTER_FILE_OP_FUNC_LOP + 4);
		_RF_ASGN_ALU(REGISTER_FILE_OP_FUNC_DOP + 4, ALU_OUTA);
		A_ASGN__RF(REGISTER_FILE_OP_FUNC_LOP + 5);
		_RF_ASGN_ALU(REGISTER_FILE_OP_FUNC_DOP + 5, ALU_OUTA);
		A_ASGN__RF(REGISTER_FILE_OP_FUNC_LOP + 6);
		_RF_ASGN_ALU(REGISTER_FILE_OP_FUNC_DOP + 6, ALU_OUTA);
		A_ASGN__RF(REGISTER_FILE_OP_FUNC_LOP + 7);
		_RF_ASGN_ALU(REGISTER_FILE_OP_FUNC_DOP + 7, ALU_OUTA);
		REGISTER_TO_A2A1A0(REGISTER_FILE_OP_FUNC_RET, 0);
		PC_ASGN_A2A1A0();
		MODIFY_A2A1A0(label_1, rom_cp >> 1);

		/*右操作数是无穷大输出符号取反的无穷大*/
		A_ASGN__RF(reg_rop_index);
		B_ASGN_IMMNUM(0x00);
		_RF_ASGN_ALU(reg_c, ALU_EQUAL_C);
		A_ASGN__RF(reg_rop_index + 1);
		B_ASGN_IMMNUM(0xfc);
		A_ASGN_ALU(ALU_EQUAL_C);
		B_ASGN__RF(reg_c);
		label_1 = rom_cp;
		IFALU_PC_ASGN_IMMNUM(ALU_AND, 0);
		_RF_ASGN_IMMNUM(REGISTER_FILE_OP_FUNC_DOP, 0);
		_RF_ASGN_IMMNUM(REGISTER_FILE_OP_FUNC_DOP + 1, 0);
		_RF_ASGN_IMMNUM(REGISTER_FILE_OP_FUNC_DOP + 2, 0);
		_RF_ASGN_IMMNUM(REGISTER_FILE_OP_FUNC_DOP + 3, 0);
		_RF_ASGN_IMMNUM(REGISTER_FILE_OP_FUNC_DOP + 4, 0);
		_RF_ASGN_IMMNUM(REGISTER_FILE_OP_FUNC_DOP + 5, 0);
		_RF_ASGN_IMMNUM(REGISTER_FILE_OP_FUNC_DOP + 6, 0xf0);
		A_ASGN__RF(REGISTER_FILE_OP_FUNC_ROP + 7);
		B_ASGN_IMMNUM(0x80);
		_RF_ASGN_ALU(REGISTER_FILE_OP_FUNC_DOP + 7, ALU_XOR);
		REGISTER_TO_A2A1A0(REGISTER_FILE_OP_FUNC_RET, 0);
		PC_ASGN_A2A1A0();
		MODIFY_A2A1A0(label_1, rom_cp >> 1);

		/*左操作数是0输出负运算的右操作数*/
		A_ASGN__RF(reg_lop_index);
		B_ASGN_IMMNUM(0xff);
		_RF_ASGN_ALU(reg_c, ALU_EQUAL_C);
		A_ASGN__RF(reg_lop_index + 1);
		B_ASGN_IMMNUM(0x03);
		A_ASGN_ALU(ALU_EQUAL_C);
		B_ASGN__RF(reg_c);
		label_1 = rom_cp;
		IFALU_PC_ASGN_IMMNUM(ALU_AND, 0);
		A_ASGN__RF(REGISTER_FILE_OP_FUNC_ROP);
		_RF_ASGN_ALU(REGISTER_FILE_OP_FUNC_DOP, ALU_OUTA);
		A_ASGN__RF(REGISTER_FILE_OP_FUNC_ROP + 1);
		_RF_ASGN_ALU(REGISTER_FILE_OP_FUNC_DOP + 1, ALU_OUTA);
		A_ASGN__RF(REGISTER_FILE_OP_FUNC_ROP + 2);
		_RF_ASGN_ALU(REGISTER_FILE_OP_FUNC_DOP + 2, ALU_OUTA);
		A_ASGN__RF(REGISTER_FILE_OP_FUNC_ROP + 3);
		_RF_ASGN_ALU(REGISTER_FILE_OP_FUNC_DOP + 3, ALU_OUTA);
		A_ASGN__RF(REGISTER_FILE_OP_FUNC_ROP + 4);
		_RF_ASGN_ALU(REGISTER_FILE_OP_FUNC_DOP + 4, ALU_OUTA);
		A_ASGN__RF(REGISTER_FILE_OP_FUNC_ROP + 5);
		_RF_ASGN_ALU(REGISTER_FILE_OP_FUNC_DOP + 5, ALU_OUTA);
		A_ASGN__RF(REGISTER_FILE_OP_FUNC_ROP + 6);
		_RF_ASGN_ALU(REGISTER_FILE_OP_FUNC_DOP + 6, ALU_OUTA);
		A_ASGN__RF(REGISTER_FILE_OP_FUNC_ROP + 7);
		B_ASGN_IMMNUM(0x80);
		_RF_ASGN_ALU(REGISTER_FILE_OP_FUNC_DOP + 7, ALU_XOR);
		REGISTER_TO_A2A1A0(REGISTER_FILE_OP_FUNC_RET, 0);
		PC_ASGN_A2A1A0();
		MODIFY_A2A1A0(label_1, rom_cp >> 1);

		/*左操作数是无穷大输出无穷大*/
		A_ASGN__RF(reg_lop_index);
		B_ASGN_IMMNUM(0x00);
		_RF_ASGN_ALU(reg_c, ALU_EQUAL_C);
		A_ASGN__RF(reg_lop_index + 1);
		B_ASGN_IMMNUM(0xfc);
		A_ASGN_ALU(ALU_EQUAL_C);
		B_ASGN__RF(reg_c);
		label_1 = rom_cp;
		IFALU_PC_ASGN_IMMNUM(ALU_AND, 0);
		_RF_ASGN_IMMNUM(REGISTER_FILE_OP_FUNC_DOP, 0);
		_RF_ASGN_IMMNUM(REGISTER_FILE_OP_FUNC_DOP + 1, 0);
		_RF_ASGN_IMMNUM(REGISTER_FILE_OP_FUNC_DOP + 2, 0);
		_RF_ASGN_IMMNUM(REGISTER_FILE_OP_FUNC_DOP + 3, 0);
		_RF_ASGN_IMMNUM(REGISTER_FILE_OP_FUNC_DOP + 4, 0);
		_RF_ASGN_IMMNUM(REGISTER_FILE_OP_FUNC_DOP + 5, 0);
		_RF_ASGN_IMMNUM(REGISTER_FILE_OP_FUNC_DOP + 6, 0xf0);
		A_ASGN__RF(REGISTER_FILE_OP_FUNC_LOP + 7);
		_RF_ASGN_ALU(REGISTER_FILE_OP_FUNC_DOP + 7, ALU_OUTA);
		REGISTER_TO_A2A1A0(REGISTER_FILE_OP_FUNC_RET, 0);
		PC_ASGN_A2A1A0();
		MODIFY_A2A1A0(label_1, rom_cp >> 1);

		/*尾数补1.0*/
		A_ASGN_IMMNUM(0x10);
		B_ASGN__RF(REGISTER_FILE_OP_FUNC_LOP + 6);
		A_ASGN_ALU(ALU_OR);
		B_ASGN_IMMNUM(0x1f);
		RF_ASGN_ALU(ALU_AND);

		/*尾数补1.0*/
		A_ASGN_IMMNUM(0x10);
		B_ASGN__RF(REGISTER_FILE_OP_FUNC_ROP + 6);
		A_ASGN_ALU(ALU_OR);
		B_ASGN_IMMNUM(0x1f);
		RF_ASGN_ALU(ALU_AND);

		/*对齐小数点*/
		A_ASGN__RF(reg_lop_index);
		B_ASGN__RF(reg_rop_index);
		_RF_ASGN_ALU(reg_rsh_cp, ALU_SUB);
		B_ASGN_ALU(ALU_SUB_C);
		A_ASGN__RF(reg_lop_index + 1);
		A_ASGN_ALU(ALU_SUB);
		B_ASGN__RF(reg_rop_index + 1);
		_RF_ASGN_ALU(reg_rsh_cp + 1, ALU_SUB);
		B_ASGN_ALU(ALU_SUB);

		label_1 = rom_cp;
		IFALU_PC_ASGN_IMMNUM(ALU_A_BH_LSH, 0);
		/*指数相减为负数,右操作数右移*/

		B_ASGN_IMMNUM(52);
		A_ASGN__RF(reg_rsh_cp);
		B_ASGN_ALU(ALU_ADD_C);
		A_ASGN__RF(reg_rsh_cp + 1);
		label_4 = rom_cp;
		IFALU_PC_ASGN_IMMNUM(ALU_ADD_C, 0);
		/*右移位数小于等于52,执行移位*/
		label_3 = rom_cp >> 1;
		A_ASGN__RF(REGISTER_FILE_OP_FUNC_ROP + 1);
		B_ASGN__RF(REGISTER_FILE_OP_FUNC_ROP);
		RF_ASGN_ALU(ALU_B_AL_RSH);
		B_ASGN_ALU(ALU_OUTA);
		A_ASGN__RF(REGISTER_FILE_OP_FUNC_ROP + 2);
		_RF_ASGN_ALU(REGISTER_FILE_OP_FUNC_ROP + 1, ALU_B_AL_RSH);
		B_ASGN_ALU(ALU_OUTA);
		A_ASGN__RF(REGISTER_FILE_OP_FUNC_ROP + 3);
		_RF_ASGN_ALU(REGISTER_FILE_OP_FUNC_ROP + 2, ALU_B_AL_RSH);
		B_ASGN_ALU(ALU_OUTA);
		A_ASGN__RF(REGISTER_FILE_OP_FUNC_ROP + 4);
		_RF_ASGN_ALU(REGISTER_FILE_OP_FUNC_ROP + 3, ALU_B_AL_RSH);
		B_ASGN_ALU(ALU_OUTA);
		A_ASGN__RF(REGISTER_FILE_OP_FUNC_ROP + 5);
		_RF_ASGN_ALU(REGISTER_FILE_OP_FUNC_ROP + 4, ALU_B_AL_RSH);
		B_ASGN_ALU(ALU_OUTA);
		A_ASGN__RF(REGISTER_FILE_OP_FUNC_ROP + 6);
		RF_ASGN_ALU(ALU_A_0_RSH);
		_RF_ASGN_ALU(REGISTER_FILE_OP_FUNC_ROP + 5, ALU_B_AL_RSH);
		A_ASGN__RF(reg_rsh_cp);
		RF_ASGN_ALU(ALU_A_ADD_1);
		B_ASGN_ALU(ALU_A_ADD_1_C);
		A_ASGN__RF(reg_rsh_cp + 1);
		RF_ASGN_ALU(ALU_ADD);
		IFALU_PC_ASGN_IMMNUM(ALU_ADD_C, label_3);
		label_5 = rom_cp;
		PC_ASGN_IMMNUM(0);
		MODIFY_A2A1A0(label_4, rom_cp >> 1);
		/*右移位数大于52,清0操作数值*/
		_RF_ASGN_IMMNUM(REGISTER_FILE_OP_FUNC_ROP, 0);
		_RF_ASGN_IMMNUM(REGISTER_FILE_OP_FUNC_ROP + 1, 0);
		_RF_ASGN_IMMNUM(REGISTER_FILE_OP_FUNC_ROP + 2, 0);
		_RF_ASGN_IMMNUM(REGISTER_FILE_OP_FUNC_ROP + 3, 0);
		_RF_ASGN_IMMNUM(REGISTER_FILE_OP_FUNC_ROP + 4, 0);
		_RF_ASGN_IMMNUM(REGISTER_FILE_OP_FUNC_ROP + 5, 0);
		_RF_ASGN_IMMNUM(REGISTER_FILE_OP_FUNC_ROP + 6, 0);
		MODIFY_A2A1A0(label_5, rom_cp >> 1);
		A_ASGN__RF(reg_lop_index);
		_RF_ASGN_ALU(reg_rop_index, ALU_OUTA);
		A_ASGN__RF(reg_lop_index + 1);
		_RF_ASGN_ALU(reg_rop_index + 1, ALU_OUTA);

		label_2 = rom_cp;
		PC_ASGN_IMMNUM(0);
		MODIFY_A2A1A0(label_1, rom_cp >> 1);
		/*指数相减为正数,左操作数右移*/

		B_ASGN_IMMNUM(53);
		A_ASGN__RF(reg_rsh_cp);
		B_ASGN_ALU(ALU_SUB_C);
		A_ASGN__RF(reg_rsh_cp + 1);
		label_5 = rom_cp;
		IFALU_PC_ASGN_IMMNUM(ALU_SUB_C, 0);
		/*右移位数小于等于52,执行移位*/
		label_3 = rom_cp >> 1;
		A_ASGN__RF(reg_rsh_cp);
		RF_ASGN_ALU(ALU_A_SUB_1);
		B_ASGN_ALU(ALU_A_SUB_1_C);
		A_ASGN__RF(reg_rsh_cp + 1);
		RF_ASGN_ALU(ALU_SUB);
		A_ASGN_ALU(ALU_SUB_C);
		label_4 = rom_cp;
		IFALU_PC_ASGN_IMMNUM(ALU_A_NOT, 0);
		A_ASGN__RF(REGISTER_FILE_OP_FUNC_LOP + 1);
		B_ASGN__RF(REGISTER_FILE_OP_FUNC_LOP);
		RF_ASGN_ALU(ALU_B_AL_RSH);
		B_ASGN_ALU(ALU_OUTA);
		A_ASGN__RF(REGISTER_FILE_OP_FUNC_LOP + 2);
		_RF_ASGN_ALU(REGISTER_FILE_OP_FUNC_LOP + 1, ALU_B_AL_RSH);
		B_ASGN_ALU(ALU_OUTA);
		A_ASGN__RF(REGISTER_FILE_OP_FUNC_LOP + 3);
		_RF_ASGN_ALU(REGISTER_FILE_OP_FUNC_LOP + 2, ALU_B_AL_RSH);
		B_ASGN_ALU(ALU_OUTA);
		A_ASGN__RF(REGISTER_FILE_OP_FUNC_LOP + 4);
		_RF_ASGN_ALU(REGISTER_FILE_OP_FUNC_LOP + 3, ALU_B_AL_RSH);
		B_ASGN_ALU(ALU_OUTA);
		A_ASGN__RF(REGISTER_FILE_OP_FUNC_LOP + 5);
		_RF_ASGN_ALU(REGISTER_FILE_OP_FUNC_LOP + 4, ALU_B_AL_RSH);
		B_ASGN_ALU(ALU_OUTA);
		A_ASGN__RF(REGISTER_FILE_OP_FUNC_LOP + 6);
		RF_ASGN_ALU(ALU_A_0_RSH);
		_RF_ASGN_ALU(REGISTER_FILE_OP_FUNC_LOP + 5, ALU_B_AL_RSH);
		PC_ASGN_IMMNUM(label_3);
		MODIFY_A2A1A0(label_5, rom_cp >> 1);
		/*右移位数大于52,清0操作数值*/
		_RF_ASGN_IMMNUM(REGISTER_FILE_OP_FUNC_LOP, 0);
		_RF_ASGN_IMMNUM(REGISTER_FILE_OP_FUNC_LOP + 1, 0);
		_RF_ASGN_IMMNUM(REGISTER_FILE_OP_FUNC_LOP + 2, 0);
		_RF_ASGN_IMMNUM(REGISTER_FILE_OP_FUNC_LOP + 3, 0);
		_RF_ASGN_IMMNUM(REGISTER_FILE_OP_FUNC_LOP + 4, 0);
		_RF_ASGN_IMMNUM(REGISTER_FILE_OP_FUNC_LOP + 5, 0);
		_RF_ASGN_IMMNUM(REGISTER_FILE_OP_FUNC_LOP + 6, 0);
		MODIFY_A2A1A0(label_4, rom_cp >> 1);

		MODIFY_A2A1A0(label_2, rom_cp >> 1);

		/*53位尾数相减*/
		A_ASGN__RF(REGISTER_FILE_OP_FUNC_LOP);
		B_ASGN__RF(REGISTER_FILE_OP_FUNC_ROP);
		_RF_ASGN_ALU(REGISTER_FILE_OP_FUNC_DOP, ALU_SUB);
		B_ASGN_ALU(ALU_SUB_C);

		A_ASGN__RF(REGISTER_FILE_OP_FUNC_LOP + 1);
		_RF_ASGN_ALU(reg_c, ALU_SUB_C);
		A_ASGN_ALU(ALU_SUB);
		B_ASGN__RF(REGISTER_FILE_OP_FUNC_ROP + 1);
		_RF_ASGN_ALU(REGISTER_FILE_OP_FUNC_DOP + 1, ALU_SUB);
		B_ASGN_ALU(ALU_SUB_C);
		A_ASGN__RF(reg_c);
		B_ASGN_ALU(ALU_ADD);

		A_ASGN__RF(REGISTER_FILE_OP_FUNC_LOP + 2);
		_RF_ASGN_ALU(reg_c, ALU_SUB_C);
		A_ASGN_ALU(ALU_SUB);
		B_ASGN__RF(REGISTER_FILE_OP_FUNC_ROP + 2);
		_RF_ASGN_ALU(REGISTER_FILE_OP_FUNC_DOP + 2, ALU_SUB);
		B_ASGN_ALU(ALU_SUB_C);
		A_ASGN__RF(reg_c);
		B_ASGN_ALU(ALU_ADD);

		A_ASGN__RF(REGISTER_FILE_OP_FUNC_LOP + 3);
		_RF_ASGN_ALU(reg_c, ALU_SUB_C);
		A_ASGN_ALU(ALU_SUB);
		B_ASGN__RF(REGISTER_FILE_OP_FUNC_ROP + 3);
		_RF_ASGN_ALU(REGISTER_FILE_OP_FUNC_DOP + 3, ALU_SUB);
		B_ASGN_ALU(ALU_SUB_C);
		A_ASGN__RF(reg_c);
		B_ASGN_ALU(ALU_ADD);

		A_ASGN__RF(REGISTER_FILE_OP_FUNC_LOP + 4);
		_RF_ASGN_ALU(reg_c, ALU_SUB_C);
		A_ASGN_ALU(ALU_SUB);
		B_ASGN__RF(REGISTER_FILE_OP_FUNC_ROP + 4);
		_RF_ASGN_ALU(REGISTER_FILE_OP_FUNC_DOP + 4, ALU_SUB);
		B_ASGN_ALU(ALU_SUB_C);
		A_ASGN__RF(reg_c);
		B_ASGN_ALU(ALU_ADD);

		A_ASGN__RF(REGISTER_FILE_OP_FUNC_LOP + 5);
		_RF_ASGN_ALU(reg_c, ALU_SUB_C);
		A_ASGN_ALU(ALU_SUB);
		B_ASGN__RF(REGISTER_FILE_OP_FUNC_ROP + 5);
		_RF_ASGN_ALU(REGISTER_FILE_OP_FUNC_DOP + 5, ALU_SUB);
		B_ASGN_ALU(ALU_SUB_C);
		A_ASGN__RF(reg_c);
		B_ASGN_ALU(ALU_ADD);

		A_ASGN__RF(REGISTER_FILE_OP_FUNC_LOP + 6);
		A_ASGN_ALU(ALU_SUB);
		B_ASGN__RF(REGISTER_FILE_OP_FUNC_ROP + 6);
		_RF_ASGN_ALU(REGISTER_FILE_OP_FUNC_DOP + 6, ALU_SUB);

		/*如果有借位,尾数取反加1,符号取反*/
		B_ASGN_ALU(ALU_SUB);
		label_1 = rom_cp;
		IFALU_PC_ASGN_IMMNUM(ALU_A_BH_LSH, 0);
		A_ASGN__RF(REGISTER_FILE_OP_FUNC_DOP);
		A_ASGN_ALU(ALU_A_NOT);
		RF_ASGN_ALU(ALU_A_ADD_1);
		B_ASGN_ALU(ALU_A_ADD_1_C);
		A_ASGN__RF(REGISTER_FILE_OP_FUNC_DOP + 1);
		A_ASGN_ALU(ALU_A_NOT);
		RF_ASGN_ALU(ALU_ADD);
		B_ASGN_ALU(ALU_ADD_C);
		A_ASGN__RF(REGISTER_FILE_OP_FUNC_DOP + 2);
		A_ASGN_ALU(ALU_A_NOT);
		RF_ASGN_ALU(ALU_ADD);
		B_ASGN_ALU(ALU_ADD_C);
		A_ASGN__RF(REGISTER_FILE_OP_FUNC_DOP + 3);
		A_ASGN_ALU(ALU_A_NOT);
		RF_ASGN_ALU(ALU_ADD);
		B_ASGN_ALU(ALU_ADD_C);
		A_ASGN__RF(REGISTER_FILE_OP_FUNC_DOP + 4);
		A_ASGN_ALU(ALU_A_NOT);
		RF_ASGN_ALU(ALU_ADD);
		B_ASGN_ALU(ALU_ADD_C);
		A_ASGN__RF(REGISTER_FILE_OP_FUNC_DOP + 5);
		A_ASGN_ALU(ALU_A_NOT);
		RF_ASGN_ALU(ALU_ADD);
		B_ASGN_ALU(ALU_ADD_C);
		A_ASGN__RF(REGISTER_FILE_OP_FUNC_DOP + 6);
		A_ASGN_ALU(ALU_A_NOT);
		RF_ASGN_ALU(ALU_ADD);
		A_ASGN__RF(REGISTER_FILE_OP_FUNC_LOP + 7);
		RF_ASGN_ALU(ALU_A_NOT);
		MODIFY_A2A1A0(label_1, rom_cp >> 1);

		/*尾数最高位对齐1.0,尾数为0则输出结果为0*/
		_RF_ASGN_IMMNUM(reg_lsh_cp, 52);
		label_2 = rom_cp >> 1;
		A_ASGN__RF(REGISTER_FILE_OP_FUNC_DOP + 6);
		B_ASGN_IMMNUM(0x10);
		A_ASGN_ALU(ALU_MUL_H);
		label_1 = rom_cp;
		IFALU_PC_ASGN_IMMNUM(ALU_A_NOT, 0);
		B_ASGN__RF(REGISTER_FILE_OP_FUNC_DOP + 5);
		A_ASGN__RF(REGISTER_FILE_OP_FUNC_DOP + 6);
		RF_ASGN_ALU(ALU_A_BH_LSH);
		A_ASGN_ALU(ALU_OUTB);
		B_ASGN__RF(REGISTER_FILE_OP_FUNC_DOP + 4);
		_RF_ASGN_ALU(REGISTER_FILE_OP_FUNC_DOP + 5, ALU_A_BH_LSH);
		A_ASGN_ALU(ALU_OUTB);
		B_ASGN__RF(REGISTER_FILE_OP_FUNC_DOP + 3);
		_RF_ASGN_ALU(REGISTER_FILE_OP_FUNC_DOP + 4, ALU_A_BH_LSH);
		A_ASGN_ALU(ALU_OUTB);
		B_ASGN__RF(REGISTER_FILE_OP_FUNC_DOP + 2);
		_RF_ASGN_ALU(REGISTER_FILE_OP_FUNC_DOP + 3, ALU_A_BH_LSH);
		A_ASGN_ALU(ALU_OUTB);
		B_ASGN__RF(REGISTER_FILE_OP_FUNC_DOP + 1);
		_RF_ASGN_ALU(REGISTER_FILE_OP_FUNC_DOP + 2, ALU_A_BH_LSH);
		A_ASGN_ALU(ALU_OUTB);
		B_ASGN__RF(REGISTER_FILE_OP_FUNC_DOP);
		RF_ASGN_ALU(ALU_B_0_LSH);
		_RF_ASGN_ALU(REGISTER_FILE_OP_FUNC_DOP + 1, ALU_A_BH_LSH);
		A_ASGN__RF(reg_lsh_cp);
		RF_ASGN_ALU(ALU_A_SUB_1);
		IFALU_PC_ASGN_IMMNUM(ALU_A_SUB_1_C, label_2);
		_RF_ASGN_IMMNUM(REGISTER_FILE_OP_FUNC_DOP + 7, 0);
		REGISTER_TO_A2A1A0(REGISTER_FILE_OP_FUNC_RET, 0);
		PC_ASGN_A2A1A0();
		MODIFY_A2A1A0(label_1, rom_cp >> 1);

		/*调整指数*/
		B_ASGN__RF(reg_lsh_cp);
		A_ASGN_IMMNUM(52);
		B_ASGN_ALU(ALU_SUB);
		A_ASGN__RF(reg_rop_index);
		RF_ASGN_ALU(ALU_ADD);
		A_ASGN_ALU(ALU_ADD_C);
		B_ASGN__RF(reg_rop_index + 1);
		RF_ASGN_ALU(ALU_ADD);
		A_ASGN_ALU(ALU_A_BH_LSH);
		label_1 = rom_cp;
		IFALU_PC_ASGN_IMMNUM(ALU_A_NOT, 0);
		B_ASGN__RF(reg_rop_index);
		A_ASGN_IMMNUM(0xfe);
		B_ASGN_ALU(ALU_SUB_C);
		A_ASGN_IMMNUM(0x03);
		A_ASGN_ALU(ALU_SUB);
		B_ASGN__RF(reg_rop_index + 1);
		label_2 = rom_cp;
		IFALU_PC_ASGN_IMMNUM(ALU_SUB_C, 0);
		_RF_ASGN_IMMNUM(REGISTER_FILE_OP_FUNC_DOP, 0);
		_RF_ASGN_IMMNUM(REGISTER_FILE_OP_FUNC_DOP + 1, 0);
		_RF_ASGN_IMMNUM(REGISTER_FILE_OP_FUNC_DOP + 2, 0);
		_RF_ASGN_IMMNUM(REGISTER_FILE_OP_FUNC_DOP + 3, 0);
		_RF_ASGN_IMMNUM(REGISTER_FILE_OP_FUNC_DOP + 4, 0);
		_RF_ASGN_IMMNUM(REGISTER_FILE_OP_FUNC_DOP + 5, 0);
		_RF_ASGN_IMMNUM(REGISTER_FILE_OP_FUNC_DOP + 6, 0);
		_RF_ASGN_IMMNUM(REGISTER_FILE_OP_FUNC_DOP + 7, 0);
		REGISTER_TO_A2A1A0(REGISTER_FILE_OP_FUNC_RET, 0);
		PC_ASGN_A2A1A0();
		MODIFY_A2A1A0(label_2, rom_cp >> 1);
		MODIFY_A2A1A0(label_1, rom_cp >> 1);

		/*隐藏尾数的1.0*/
		A_ASGN_IMMNUM(0x0f);
		B_ASGN__RF(REGISTER_FILE_OP_FUNC_DOP + 6);
		RF_ASGN_ALU(ALU_AND);

		/*指数转换为原格式,并装回指数和符号*/
		A_ASGN__RF(reg_rop_index);
		B_ASGN_IMMNUM(0x10);
		_RF_ASGN_ALU(reg_c, ALU_MUL_H);
		A_ASGN_ALU(ALU_MUL_L);
		B_ASGN_IMMNUM(0xf0);
		A_ASGN_ALU(ALU_XOR);
		B_ASGN__RF(REGISTER_FILE_OP_FUNC_DOP + 6);
		RF_ASGN_ALU(ALU_OR);
		A_ASGN__RF(reg_rop_index + 1);
		B_ASGN_IMMNUM(0x10);
		A_ASGN_ALU(ALU_MUL_L);
		B_ASGN__RF(reg_c);
		A_ASGN_ALU(ALU_OR);
		B_ASGN_IMMNUM(0x3f);
		A_ASGN_ALU(ALU_XOR);
		B_ASGN__RF(REGISTER_FILE_OP_FUNC_LOP + 7);
		A_ASGN_ALU(ALU_A_BH_LSH);
		B_ASGN_ALU(ALU_OUTA);
		_RF_ASGN_ALU(REGISTER_FILE_OP_FUNC_DOP + 7, ALU_B_AL_RSH);

		REGISTER_TO_A2A1A0(REGISTER_FILE_OP_FUNC_RET, 0);
		PC_ASGN_A2A1A0();
		MODIFY_A2A1A0(label_0, rom_cp >> 1);
	}
}

/*float乘法函数生成,(节省运算量,这里不处理极限值,不处理舍入)*/
void float_mul_func_gen() {
	if (float_mul_func_romaddr == 0) {
		unsigned long label_0, label_1, label_2, label_3;
		unsigned char reg_lop_index = REGISTER_FILE_OP_FUNC_CACHE;
		unsigned char reg_rop_index = REGISTER_FILE_OP_FUNC_CACHE + 1;
		unsigned char reg_1 = REGISTER_FILE_OP_FUNC_CACHE + 2;
		unsigned char reg_2 = REGISTER_FILE_OP_FUNC_CACHE + 3;
		unsigned char reg_3 = REGISTER_FILE_OP_FUNC_CACHE + 4;
		unsigned char reg_4 = REGISTER_FILE_OP_FUNC_CACHE + 5;
		unsigned char reg_5 = REGISTER_FILE_OP_FUNC_CACHE + 6;
		unsigned char reg_h = REGISTER_FILE_OP_FUNC_CACHE + 7;
		unsigned char reg_c = REGISTER_FILE_OP_FUNC_CACHE + 8;

		label_0 = rom_cp;
		PC_ASGN_IMMNUM(0);
		float_mul_func_romaddr = rom_cp >> 1;

		/*提取指数,判断操作数是否为0或无穷大*/
		B_ASGN__RF(REGISTER_FILE_OP_FUNC_LOP + 2);
		A_ASGN__RF(REGISTER_FILE_OP_FUNC_LOP + 3);
		B_ASGN_ALU(ALU_A_BH_LSH);
		A_ASGN_IMMNUM(0x7f);
		_RF_ASGN_ALU(reg_lop_index, ALU_XOR);
		B_ASGN__RF(REGISTER_FILE_OP_FUNC_ROP + 2);
		A_ASGN__RF(REGISTER_FILE_OP_FUNC_ROP + 3);
		B_ASGN_ALU(ALU_A_BH_LSH);
		A_ASGN_IMMNUM(0x7f);
		_RF_ASGN_ALU(reg_rop_index, ALU_XOR);

		A_ASGN__RF(reg_lop_index);
		B_ASGN_IMMNUM(-128);
		_RF_ASGN_ALU(reg_c, ALU_EQUAL_C);
		A_ASGN__RF(REGISTER_FILE_OP_FUNC_LOP + 2);
		B_ASGN_ALU(ALU_A_0_LSH);
		A_ASGN_ALU(ALU_A_BH_LSH);
		B_ASGN__RF(reg_c);
		label_1 = rom_cp;
		IFALU_PC_ASGN_IMMNUM(ALU_AND, 0);
		_RF_ASGN_IMMNUM(REGISTER_FILE_OP_FUNC_DOP, 0);
		_RF_ASGN_IMMNUM(REGISTER_FILE_OP_FUNC_DOP + 1, 0);
		_RF_ASGN_IMMNUM(REGISTER_FILE_OP_FUNC_DOP + 2, 0xc0);
		A_ASGN__RF(REGISTER_FILE_OP_FUNC_LOP + 3);
		_RF_ASGN_ALU(REGISTER_FILE_OP_FUNC_DOP + 3, ALU_OUTA);
		REGISTER_TO_A2A1A0(REGISTER_FILE_OP_FUNC_RET, 0);
		PC_ASGN_A2A1A0();
		MODIFY_A2A1A0(label_1, rom_cp >> 1);

		A_ASGN__RF(reg_rop_index);
		B_ASGN_IMMNUM(-128);
		_RF_ASGN_ALU(reg_c, ALU_EQUAL_C);
		A_ASGN__RF(REGISTER_FILE_OP_FUNC_ROP + 2);
		B_ASGN_ALU(ALU_A_0_LSH);
		A_ASGN_ALU(ALU_A_BH_LSH);
		B_ASGN__RF(reg_c);
		label_1 = rom_cp;
		IFALU_PC_ASGN_IMMNUM(ALU_AND, 0);
		_RF_ASGN_IMMNUM(REGISTER_FILE_OP_FUNC_DOP, 0);
		_RF_ASGN_IMMNUM(REGISTER_FILE_OP_FUNC_DOP + 1, 0);
		_RF_ASGN_IMMNUM(REGISTER_FILE_OP_FUNC_DOP + 2, 0xc0);
		A_ASGN__RF(REGISTER_FILE_OP_FUNC_ROP + 3);
		_RF_ASGN_ALU(REGISTER_FILE_OP_FUNC_DOP + 3, ALU_OUTA);
		REGISTER_TO_A2A1A0(REGISTER_FILE_OP_FUNC_RET, 0);
		PC_ASGN_A2A1A0();
		MODIFY_A2A1A0(label_1, rom_cp >> 1);

		A_ASGN__RF(reg_lop_index);
		B_ASGN_IMMNUM(127);
		label_1 = rom_cp;
		IFALU_PC_ASGN_IMMNUM(ALU_EQUAL_C, 0);
		A_ASGN__RF(reg_rop_index);
		B_ASGN_IMMNUM(-128);
		label_2 = rom_cp;
		IFALU_PC_ASGN_IMMNUM(ALU_EQUAL_C, 0);
		_RF_ASGN_IMMNUM(REGISTER_FILE_OP_FUNC_DOP, 0);
		_RF_ASGN_IMMNUM(REGISTER_FILE_OP_FUNC_DOP + 1, 0);
		_RF_ASGN_IMMNUM(REGISTER_FILE_OP_FUNC_DOP + 2, 0xc0);
		_RF_ASGN_IMMNUM(REGISTER_FILE_OP_FUNC_DOP + 3, 0xff);
		REGISTER_TO_A2A1A0(REGISTER_FILE_OP_FUNC_RET, 0);
		PC_ASGN_A2A1A0();
		MODIFY_A2A1A0(label_2, rom_cp >> 1);
		_RF_ASGN_IMMNUM(REGISTER_FILE_OP_FUNC_DOP, 0);
		_RF_ASGN_IMMNUM(REGISTER_FILE_OP_FUNC_DOP + 1, 0);
		_RF_ASGN_IMMNUM(REGISTER_FILE_OP_FUNC_DOP + 2, 0);
		A_ASGN__RF(REGISTER_FILE_OP_FUNC_LOP + 3);
		B_ASGN__RF(REGISTER_FILE_OP_FUNC_ROP + 3);
		A_ASGN_ALU(ALU_XOR);
		B_ASGN_IMMNUM(0x80);
		_RF_ASGN_ALU(REGISTER_FILE_OP_FUNC_DOP + 3, ALU_AND);
		REGISTER_TO_A2A1A0(REGISTER_FILE_OP_FUNC_RET, 0);
		PC_ASGN_A2A1A0();
		MODIFY_A2A1A0(label_1, rom_cp >> 1);

		B_ASGN_IMMNUM(-128);
		label_1 = rom_cp;
		IFALU_PC_ASGN_IMMNUM(ALU_EQUAL_C, 0);
		A_ASGN__RF(reg_rop_index);
		B_ASGN_IMMNUM(127);
		label_2 = rom_cp;
		IFALU_PC_ASGN_IMMNUM(ALU_EQUAL_C, 0);
		_RF_ASGN_IMMNUM(REGISTER_FILE_OP_FUNC_DOP, 0);
		_RF_ASGN_IMMNUM(REGISTER_FILE_OP_FUNC_DOP + 1, 0);
		_RF_ASGN_IMMNUM(REGISTER_FILE_OP_FUNC_DOP + 2, 0xc0);
		_RF_ASGN_IMMNUM(REGISTER_FILE_OP_FUNC_DOP + 3, 0xff);
		REGISTER_TO_A2A1A0(REGISTER_FILE_OP_FUNC_RET, 0);
		PC_ASGN_A2A1A0();
		MODIFY_A2A1A0(label_2, rom_cp >> 1);
		_RF_ASGN_IMMNUM(REGISTER_FILE_OP_FUNC_DOP, 0);
		_RF_ASGN_IMMNUM(REGISTER_FILE_OP_FUNC_DOP + 1, 0);
		_RF_ASGN_IMMNUM(REGISTER_FILE_OP_FUNC_DOP + 2, 0x80);
		A_ASGN__RF(REGISTER_FILE_OP_FUNC_LOP + 3);
		B_ASGN__RF(REGISTER_FILE_OP_FUNC_ROP + 3);
		A_ASGN_ALU(ALU_XOR);
		B_ASGN_IMMNUM(0x7f);
		_RF_ASGN_ALU(REGISTER_FILE_OP_FUNC_DOP + 3, ALU_OR);
		REGISTER_TO_A2A1A0(REGISTER_FILE_OP_FUNC_RET, 0);
		PC_ASGN_A2A1A0();
		MODIFY_A2A1A0(label_1, rom_cp >> 1);

		A_ASGN__RF(reg_rop_index);
		B_ASGN_IMMNUM(127);
		label_1 = rom_cp;
		IFALU_PC_ASGN_IMMNUM(ALU_EQUAL_C, 0);
		_RF_ASGN_IMMNUM(REGISTER_FILE_OP_FUNC_DOP, 0);
		_RF_ASGN_IMMNUM(REGISTER_FILE_OP_FUNC_DOP + 1, 0);
		_RF_ASGN_IMMNUM(REGISTER_FILE_OP_FUNC_DOP + 2, 0);
		A_ASGN__RF(REGISTER_FILE_OP_FUNC_LOP + 3);
		B_ASGN__RF(REGISTER_FILE_OP_FUNC_ROP + 3);
		A_ASGN_ALU(ALU_XOR);
		B_ASGN_IMMNUM(0x80);
		_RF_ASGN_ALU(REGISTER_FILE_OP_FUNC_DOP + 3, ALU_AND);
		REGISTER_TO_A2A1A0(REGISTER_FILE_OP_FUNC_RET, 0);
		PC_ASGN_A2A1A0();
		MODIFY_A2A1A0(label_1, rom_cp >> 1);

		B_ASGN_IMMNUM(-128);
		label_1 = rom_cp;
		IFALU_PC_ASGN_IMMNUM(ALU_EQUAL_C, 0);
		_RF_ASGN_IMMNUM(REGISTER_FILE_OP_FUNC_DOP, 0);
		_RF_ASGN_IMMNUM(REGISTER_FILE_OP_FUNC_DOP + 1, 0);
		_RF_ASGN_IMMNUM(REGISTER_FILE_OP_FUNC_DOP + 2, 0x80);
		A_ASGN__RF(REGISTER_FILE_OP_FUNC_LOP + 3);
		B_ASGN__RF(REGISTER_FILE_OP_FUNC_ROP + 3);
		A_ASGN_ALU(ALU_XOR);
		B_ASGN_IMMNUM(0x7f);
		_RF_ASGN_ALU(REGISTER_FILE_OP_FUNC_DOP + 3, ALU_OR);
		REGISTER_TO_A2A1A0(REGISTER_FILE_OP_FUNC_RET, 0);
		PC_ASGN_A2A1A0();
		MODIFY_A2A1A0(label_1, rom_cp >> 1);

		/*补1.0*/
		A_ASGN_IMMNUM(0x80);
		B_ASGN__RF(REGISTER_FILE_OP_FUNC_LOP + 2);
		RF_ASGN_ALU(ALU_OR);
		B_ASGN__RF(REGISTER_FILE_OP_FUNC_ROP + 2);
		RF_ASGN_ALU(ALU_OR);

		/*24位尾数相乘*/
		A_ASGN__RF(REGISTER_FILE_OP_FUNC_LOP);
		B_ASGN__RF(REGISTER_FILE_OP_FUNC_ROP);
		_RF_ASGN_ALU(reg_1, ALU_MUL_H);

		A_ASGN__RF(REGISTER_FILE_OP_FUNC_LOP + 1);
		B_ASGN__RF(REGISTER_FILE_OP_FUNC_ROP);
		_RF_ASGN_ALU(reg_2, ALU_MUL_H);
		A_ASGN_ALU(ALU_MUL_L);
		B_ASGN__RF(reg_1);
		RF_ASGN_ALU(ALU_ADD);
		A_ASGN_ALU(ALU_ADD_C);
		B_ASGN__RF_O(reg_2);
		RF_ASGN_ALU(ALU_ADD);

		A_ASGN__RF(REGISTER_FILE_OP_FUNC_LOP);
		B_ASGN__RF(REGISTER_FILE_OP_FUNC_ROP + 1);
		_RF_ASGN_ALU(reg_h, ALU_MUL_H);
		A_ASGN_ALU(ALU_MUL_L);
		B_ASGN__RF(reg_1);
		A_ASGN_ALU(ALU_ADD_C);
		B_ASGN__RF(reg_h);
		A_ASGN_ALU(ALU_ADD);
		B_ASGN__RF(reg_2);
		RF_ASGN_ALU(ALU_ADD);
		_RF_ASGN_ALU(reg_3, ALU_ADD_C);

		A_ASGN__RF(REGISTER_FILE_OP_FUNC_LOP + 2);
		B_ASGN__RF(REGISTER_FILE_OP_FUNC_ROP);
		_RF_ASGN_ALU(reg_h, ALU_MUL_H);
		A_ASGN_ALU(ALU_MUL_L);
		B_ASGN__RF(reg_2);
		RF_ASGN_ALU(ALU_ADD);
		A_ASGN_ALU(ALU_ADD_C);
		B_ASGN__RF(reg_h);
		A_ASGN_ALU(ALU_ADD);
		B_ASGN__RF(reg_3);
		RF_ASGN_ALU(ALU_ADD);

		A_ASGN__RF(REGISTER_FILE_OP_FUNC_LOP + 1);
		B_ASGN__RF(REGISTER_FILE_OP_FUNC_ROP + 1);
		_RF_ASGN_ALU(reg_h, ALU_MUL_H);
		A_ASGN_ALU(ALU_MUL_L);
		B_ASGN__RF(reg_2);
		RF_ASGN_ALU(ALU_ADD);
		A_ASGN_ALU(ALU_ADD_C);
		B_ASGN__RF(reg_h);
		A_ASGN_ALU(ALU_ADD);
		B_ASGN__RF(reg_3);
		RF_ASGN_ALU(ALU_ADD);
		_RF_ASGN_ALU(reg_4, ALU_ADD_C);

		A_ASGN__RF(REGISTER_FILE_OP_FUNC_LOP);
		B_ASGN__RF(REGISTER_FILE_OP_FUNC_ROP + 2);
		_RF_ASGN_ALU(reg_h, ALU_MUL_H);
		A_ASGN_ALU(ALU_MUL_L);
		B_ASGN__RF(reg_2);
		A_ASGN_ALU(ALU_ADD_C);
		B_ASGN__RF(reg_h);
		A_ASGN_ALU(ALU_ADD);
		B_ASGN__RF(reg_3);
		RF_ASGN_ALU(ALU_ADD);
		A_ASGN_ALU(ALU_ADD_C);
		B_ASGN__RF(reg_4);
		RF_ASGN_ALU(ALU_ADD);

		A_ASGN__RF(REGISTER_FILE_OP_FUNC_LOP + 2);
		B_ASGN__RF(REGISTER_FILE_OP_FUNC_ROP + 1);
		_RF_ASGN_ALU(reg_h, ALU_MUL_H);
		A_ASGN_ALU(ALU_MUL_L);
		B_ASGN__RF(reg_3);
		RF_ASGN_ALU(ALU_ADD);
		A_ASGN_ALU(ALU_ADD_C);
		B_ASGN__RF(reg_h);
		A_ASGN_ALU(ALU_ADD);
		B_ASGN__RF(reg_4);
		RF_ASGN_ALU(ALU_ADD);
		_RF_ASGN_ALU(reg_5, ALU_ADD_C);

		A_ASGN__RF(REGISTER_FILE_OP_FUNC_LOP + 1);
		B_ASGN__RF(REGISTER_FILE_OP_FUNC_ROP + 2);
		_RF_ASGN_ALU(reg_h, ALU_MUL_H);
		A_ASGN_ALU(ALU_MUL_L);
		B_ASGN__RF(reg_3);
		_RF_ASGN_ALU(REGISTER_FILE_OP_FUNC_DOP, ALU_ADD);
		A_ASGN_ALU(ALU_ADD_C);
		B_ASGN__RF(reg_h);
		A_ASGN_ALU(ALU_ADD);
		B_ASGN__RF(reg_4);
		RF_ASGN_ALU(ALU_ADD);
		A_ASGN_ALU(ALU_ADD_C);
		B_ASGN__RF(reg_5);
		RF_ASGN_ALU(ALU_ADD);

		A_ASGN__RF(REGISTER_FILE_OP_FUNC_LOP + 2);
		B_ASGN__RF(REGISTER_FILE_OP_FUNC_ROP + 2);
		_RF_ASGN_ALU(reg_h, ALU_MUL_H);
		A_ASGN_ALU(ALU_MUL_L);
		B_ASGN__RF(reg_4);
		_RF_ASGN_ALU(REGISTER_FILE_OP_FUNC_DOP + 1, ALU_ADD);
		A_ASGN_ALU(ALU_ADD_C);
		B_ASGN__RF(reg_h);
		A_ASGN_ALU(ALU_ADD);
		B_ASGN__RF(reg_5);
		_RF_ASGN_ALU(REGISTER_FILE_OP_FUNC_DOP + 2, ALU_ADD);

		/*指数相加*/
		A_ASGN__RF(reg_lop_index);
		B_ASGN__RF(reg_rop_index);
		RF_ASGN_ALU(ALU_ADD);
		_RF_ASGN_ALU(reg_c, ALU_ADD_C);
		B_ASGN_ALU(ALU_XOR);
		A_ASGN_ALU(ALU_A_BH_LSH);
		B_ASGN_RF();
		RF_ASGN_ALU(ALU_ADD);

		/*如果24位结果最高位为1*/
		B_ASGN__RF(REGISTER_FILE_OP_FUNC_DOP + 2);
		label_1 = rom_cp;
		IFALU_PC_ASGN_IMMNUM(ALU_A_BH_LSH, 0);
		/*指数再减1*/
		A_ASGN__RF(reg_rop_index);
		RF_ASGN_ALU(ALU_A_SUB_1);
		B_ASGN_ALU(ALU_A_SUB_1_C);
		A_ASGN__RF(reg_c);
		RF_ASGN_ALU(ALU_SUB);
		label_2 = rom_cp;
		PC_ASGN_IMMNUM(0);
		MODIFY_A2A1A0(label_1, rom_cp >> 1);
		/*尾数左移1位*/
		B_ASGN__RF(REGISTER_FILE_OP_FUNC_DOP + 1);
		A_ASGN__RF(REGISTER_FILE_OP_FUNC_DOP + 2);
		RF_ASGN_ALU(ALU_A_BH_LSH);
		A_ASGN_ALU(ALU_OUTB);
		B_ASGN__RF(REGISTER_FILE_OP_FUNC_DOP);
		RF_ASGN_ALU(ALU_B_0_LSH);
		_RF_ASGN_ALU(REGISTER_FILE_OP_FUNC_DOP + 1, ALU_A_BH_LSH);
		MODIFY_A2A1A0(label_2, rom_cp >> 1);

		/*指数溢出检查*/
		A_ASGN__RF(reg_c);
		label_1 = rom_cp;
		IFALU_PC_ASGN_IMMNUM(ALU_OUTA, 0);
		A_ASGN__RF(reg_rop_index);
		B_ASGN_IMMNUM(-127);
		label_2 = rom_cp;
		IFALU_PC_ASGN_IMMNUM(ALU_SUB_C, 0);
		_RF_ASGN_IMMNUM(REGISTER_FILE_OP_FUNC_DOP, 0);
		_RF_ASGN_IMMNUM(REGISTER_FILE_OP_FUNC_DOP + 1, 0);
		_RF_ASGN_IMMNUM(REGISTER_FILE_OP_FUNC_DOP + 2, 0x80);
		A_ASGN__RF(REGISTER_FILE_OP_FUNC_LOP + 3);
		B_ASGN__RF(REGISTER_FILE_OP_FUNC_ROP + 3);
		A_ASGN_ALU(ALU_XOR);
		B_ASGN_IMMNUM(0x7f);
		_RF_ASGN_ALU(REGISTER_FILE_OP_FUNC_DOP + 3, ALU_OR);
		REGISTER_TO_A2A1A0(REGISTER_FILE_OP_FUNC_RET, 0);
		PC_ASGN_A2A1A0();
		MODIFY_A2A1A0(label_1, rom_cp >> 1);
		A_ASGN_IMMNUM(126);
		B_ASGN__RF(reg_rop_index);
		label_3 = rom_cp;
		IFALU_PC_ASGN_IMMNUM(ALU_SUB_C, 0);
		_RF_ASGN_IMMNUM(REGISTER_FILE_OP_FUNC_DOP, 0);
		_RF_ASGN_IMMNUM(REGISTER_FILE_OP_FUNC_DOP + 1, 0);
		_RF_ASGN_IMMNUM(REGISTER_FILE_OP_FUNC_DOP + 2, 0);
		A_ASGN__RF(REGISTER_FILE_OP_FUNC_LOP + 3);
		B_ASGN__RF(REGISTER_FILE_OP_FUNC_ROP + 3);
		A_ASGN_ALU(ALU_XOR);
		B_ASGN_IMMNUM(0x80);
		_RF_ASGN_ALU(REGISTER_FILE_OP_FUNC_DOP + 3, ALU_AND);
		REGISTER_TO_A2A1A0(REGISTER_FILE_OP_FUNC_RET, 0);
		PC_ASGN_A2A1A0();
		MODIFY_A2A1A0(label_3, rom_cp >> 1);
		MODIFY_A2A1A0(label_2, rom_cp >> 1);

		/*指数转换为原格式*/
		A_ASGN__RF(reg_rop_index);
		B_ASGN_IMMNUM(0x7f);
		RF_ASGN_ALU(ALU_XOR);

		/*装回指数和符号*/
		A_ASGN_ALU(ALU_XOR);
		B_ASGN__RF(REGISTER_FILE_OP_FUNC_DOP + 2);
		B_ASGN_ALU(ALU_B_0_LSH);
		RF_ASGN_ALU(ALU_B_AL_RSH);
		B_ASGN__RF(REGISTER_FILE_OP_FUNC_ROP + 3);
		A_ASGN__RF(REGISTER_FILE_OP_FUNC_LOP + 3);
		B_ASGN_ALU(ALU_XOR);
		A_ASGN_ALU(ALU_A_BH_LSH);
		B_ASGN__RF(reg_rop_index);
		_RF_ASGN_ALU(REGISTER_FILE_OP_FUNC_DOP + 3, ALU_B_AL_RSH);

		REGISTER_TO_A2A1A0(REGISTER_FILE_OP_FUNC_RET, 0);
		PC_ASGN_A2A1A0();
		MODIFY_A2A1A0(label_0, rom_cp >> 1);
	}
}
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
