denjhang/74HC-Chiptune/(commit log)

2026-06-12 4-channel 6-waveform WT synthesizer with lookup-table accumulator
    Verified C major chord (C4+E4+G4) and multi-waveform (sqr+saw+noise+sine)
    via DFT analysis. ROM: 6 waves × 128pt × 16level × 32vol = 384KB on 39SF040.
    Also adds LUT-MCU concept document for future 8-bit TTL computer.
    [wt_rom_tb.v]
2026-06-12 Add RAM-based 9-IC architecture (wt_ram.v) and 74HC gate-level mapping (wt_rtl.v)
    - wt_ram.v: 62256 SRAM + 74161 microprogram stepper, 4-channel WT synthesizer
    - wt_rtl.v: 74HC gate-level annotated version with U2-U7 chip mapping (bit-perfect match)
    - SPFM bus interface with YM2413-style async latch + 2-stage synchronizer
    - Testbenches: wt_ram_tb (36000 samples), wt_rtl_tb (5000 samples), wt_spfm_tb
    - DFT verified: C4=61475, E4=60764, G4=61353; C major chord confirmed
    [wt_ram_output.csv, wt_rtl_output.csv, wt_rtl_ram.csv]
2026-06-13 Add SPFM bus interface (3 IC) and 74HC from-scratch design doc
    New SPFM bus interface using 74HC chips (373+174+377), following YM2413
    two-step write timing. Uses 2-stage synchronizer + edge detection instead
    of IKAOPLL's SR-latch + 3-phase clock for single-clock 10MHz adaptation.
    All 15 test writes pass (CTRL, step_lo/hi, note_on, 10 sequential, reset).
    New design doc (docs/hc-chiptune-design.md) tracks the from-scratch 74HC
    design separately from the previous Pac-Man WSG netlist work.
    [wt_spfm_bus.v, wt_spfm_bus_tb.v]
2026-06-13 Rewrite SPFM bus interface with real 74HC chip instantiation
    Replace behavioral models with actual chip instances:
    - U1: 74HC373 (LE/D/Q) — transparent data latch
    - U2: 74HC174 (CLK/nCLR/D/Q) — dual synchronizer using 6 D-FFs
    with Q-to-D feedback for 2-stage sync + edge detection
    - U3: 74HC377 (Enable_bar/D/Clk/Q) — address register
    All 15 test writes pass with chip-level instantiation.
    [wt_spfm_bus.v]
2026-06-13 Working 3-channel wavetable synth: 3.072MHz/96kHz, 128-point ROM, verified output
    - wt_top.v: 10-IC architecture with instruction ROM microcode (161×2 step counter,
    39SF040×3 for instruction+wavetable, 7134 param RAM, 283 adder, 7134+62256 storage)
    - 32-step microprogram: 3 channels × 8 steps (5 accum + vol read + wave read + lookup) + 8 NOP
    - 128-point wavetable ROM (8 waves × 16 vols × 256 indices = 32KB, 4-bit wave × vol precomputed)
    - Verified 3-voice mixed output (A4 sine + C5 square + E4 triangle) producing correct waveforms
    - Simulation uses reg models for 174/62256/273 to avoid cross-instance NBA timing issues
    - ROM address alignment fixed: {wave[2:0], vol[3:0], phase[19:12]}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
    [hc161.v, hc174.v, hc273.v, hc283.v, hc39sf040.v, hc62256.v, hc7134.v]
2026-06-13 Compress instruction ROM from 16-bit (2×39SF040) to 8-bit (1×39SF040), 9 IC total
    voice_sel and param_addr derived from step counter (step[4:3] and step[2:0])
    instead of stored in ROM. Only 4 unique control words needed for 8 step types.
    Sample rate corrected to 96kHz (3.072MHz/32). wavetable ROM unchanged.
    [wt_top.v, wt_top_tb.v]
2026-06-13 Switch mixing from digital accumulation to WSG-style TDM output
    Instead of summing 3 voices in a digital accumulator, each voice's
    lookup result latches directly to the 273 output register at its
    respective step (7/15/23). The R-2R DAC + RC lowpass does the mixing
    in the analog domain, matching the Pac-Man WSG architecture.
    - Remove mix_out register; dac_out latches rom_dq on c_out_latch
    - Move vol/wave/DAC latches to negedge STEP_CLK (iverilog delta-cycle
    workaround: combinational ROM/RAM outputs aren't stable at posedge)
    - Initialize phase_v0/v1/v2 to 0; add X guards on add_sum/rom_dq
    - Testbench samples all 3 voices per cycle (step 7/15/23) for chord
    - Verified: C4+E4+G4 major chord WA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
    [wt_top_output.csv]
2026-06-14 Add minimal 1-channel square wave synth (sq_top, 12 IC, fully instantiated)
    Restart from simplest architecture: programmable frequency divider + T-FF.
    - 74HC161 x4: 16-bit programmable counter (cascade, TC drives next stage CEP/CET)
    - 74HC377 x2: FREQ lo/hi byte registers
    - 74HC373 + 74HC174 + 74HC377: SPFM bus interface (reused from wt_spfm_bus)
    - 74HC74 x1: T flip-flop for 50% duty cycle output
    - 74HC04 x1 + 74HC32 x1: pe_n inversion + Enable_bar decode
    Frequency formula: f_out = SPFM_CLK / [2 * (65536 - FREQ)]
    C4 261.6 Hz @ 1.789773 MHz PSG clock: FREQ = 0xF2A5
    100% chip instantiation, no reg pretending to be chips, no hidden assign
    logic gates. All & | ~ ! operators are inside chip mod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
    [hc04.v, hc32.v, hc377.v, hc74.v, sq_tb.v, sq_top.v]
2026-06-14 Eliminate hidden inverters from SPFM bus interface
    wt_spfm_bus.v exposed active-high addr_wr/data_wr outputs via
    `assign x = ~x_n`, hiding two inverters outside any instantiated chip.
    Replace with active-low addr_wr_n/data_wr_n wired directly from the
    decode ROM's DQ0/DQ1 (no logic operators).
    sq_top.v updated to consume the active-low signals directly, dropping
    the redundant hc04 channel that previously re-inverted data_wr.
    SPFM bus interface is now 100% chip-instantiated: 39SF040 (decode) +
    74HC373 (transparent latch) + 74HC377 (address register).
    Also adds the decode ROM generator (gen_spfm_decode_rom.py) and its
    524288-byte output (spfm_decode.hex): default 0x03 (no-op), 0x06 at
    {CS=0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
    [sq_top.v, wt_spfm_bus.v]
2026-06-14 Add verified SPFM bus interface (373/174/377, 3 IC)
    YM2413-style two-step write protocol with 2-stage synchronizer
    and edge detection for 1-clock write pulses. Standalone testbench
    passes: addr+data write to simulated RAM.
2026-06-14 Fix SPFM bus outputs to active-low (no hidden inverters)
    addr_wr_pulse_n/data_wr_pulse_n now active-low, matching
    62256 WE_n and 377 Enable_bar directly. Both testbenches pass.
    [wt3_spfm_bus.v, wt3_spfm_bus_tb.v, wt3_spfm_ram.v]
2026-06-14 Add 157 mux for SPFM/microcode RAM address sharing (5 IC)
    SPFM write and microcode read share one 62256 via 157 mux.
    157 Select=CS_n: CS_n=0 selects SPFM addr, CS_n=1 selects
    microcode addr. Fixed simulation race: added #1 gate delay
    to 377/174 models, changed 62256 to negedge WE_n write.
    All 3 testbenches pass (bus/ram/mux).
    [hc377.v, hc62256.v, wt3_spfm_bus.v, wt3_spfm_mux.v, wt3_spfm_mux_tb.v]
2026-06-14 Add realistic propagation delays to chip models
    hc62256: tAA=55ns read delay, tWP=55ns write delay (negedge WE_n)
    hc377: tpd=15ns, 174 sync chain: tpd=15ns
    All 3 testbenches pass with real timing.
2026-06-14 Add wt3 core: 161 + single ROM + 157 mux + 62256 + 377 (8 IC)
    Single 39SF040 microcode ROM (8-bit), 161 step counter,
    157 address mux, single 62256 RAM. Verified: SPFM write
    6 params, microcode read+latch all correct (6/6 PASS).
    [wt3_core.v, wt3_core_tb.v]
2026-06-14 Add wt3 14-IC core with 283 phase accumulator
    - 5x 74HC157 explicitly handles all SPFM/microcode mux points
    (RAM addr lo/hi, DI lo/hi, WE/OE) — no hidden gates
    - 283 4-bit adder accumulates reg_a + reg_b into RAM[0]
    - Microcode control word: OE/latch_a/latch_b/WE/addr
    - 5-step accumulate cycle (read, latch_a, read, latch_b, write)
    - Verified: SPFM write 0x03/0x02 → after 1 cycle reg_a=0x03,
    reg_b=0x02, adder_s=0x5; after 2 cycles reg_a=0x05
2026-06-14 Add wavetable ROM and complete WSG data path
    - 2nd 39SF040 wavetable ROM, addressed by reg_a_q[7:0]
    - 273 now latches wavetable ROM output (was latching reg_a directly)
    - Microcode bit 3 reassigned as latch_dac_clk (rising edge)
    - addr field shrunk from 4-bit to 3-bit (only 0/1 used anyway)
    - 256-byte sine wavetable (8-bit unsigned, centered at 0x80)
    - 5-step cycle: read phase_acc, latch_a, read phase_step, latch_b,
    write back, then wavetable lookup + 273 latch
    - Total: 17 IC (was 16)
    Verified: phase_acc=0, phase_step=0x08 produces 3000Hz sine
    (96kHz / 32 samples per cycle). Generated wt3_sine.wav (0.52s).
    [wt3_sine.csv]
2026-06-14 Add volume register and explicit chip instances (WT3 v1.2)
    Major changes:
    - Add 74HC377 reg_c for volume (4-bit, RAM[0x02]) → 19 IC total
    - Wavetable ROM expands from 256B to 4KB (16 vols × 256 sine samples)
    - Wavetable addressing: A[7:0]=phase, A[11:8]=volume (reg_c_q[3:0])
    - Microcode reallocation: add latch_c_n at bit 4, ram_addr shrinks to 2-bit
    - Microcode cycle expands from 6 to 8 effective steps (adds volume read)
    - Replace hidden reg-based 373/174 with explicit hc373/hc174 instances
    - Rename ttl_74273 to hc273 (consistent naming)
    - Fix pin comment typos in hc157/hc283/hc377
    CPU-side piano envelope demo (no hardware change):
    - tb/wt3_piano_tb.v: CPU updates volume register over ti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
    [wt3_piano.csv, wt3_sine.csv]
2026-06-14 v1.3: 4-channel TDM digital mixing (0 new IC)
    Architecture: 4 channels × 16 step (8 work + 8 NOP) = 64 step cycle
    @ STEP_CLK=3.072MHz → 48kHz loop rate → 48kHz per channel
    Key changes (vs v1.2, all 0 new IC):
    - step counter 5-bit → 6-bit (U8 step_hi uses 2 Q outputs)
    - microcode ROM 32B → 64B (4 ch × 16 step)
    - RAM usage 3B → 16B (4 ch × 4 bytes)
    - 1 DAC physical output, TDM at 192kHz switch rate
    - RC lowpass after DAC = analog mix of 4 channels
    Per-channel addressing: addr = {step[5:4], mc_ram_sub_addr[1:0]}
    - ch0: RAM[0..3], ch1: RAM[4..7], ch2: RAM[8..11], ch3: RAM[12..15]
    - Each channel: phase_acc/phase_step/volume/reserved
    Test: tb/wt3_core_tb.v PASS (5/5)
    - 4 channels w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
    [wt3_sine.csv]
2026-06-14 v1.4: 16-bit phase_acc + 4-channel TDM piano envelope cascade
    Upgrade to 16-bit phase accumulator (256x precision, full 88-key piano),
    validate with C-E-G-C5 0.2s-spaced cascade + piano envelope (attack 15 ->
    sustain at vol=7). Fix microcode: insert NOP step between two RAM writebacks
    so 62256 WE_n sees proper negedge. Add 154 disable during SPFM writes to
    prevent spurious latches. Fix WAV conversion: 192kHz mono direct playback
    (no averaging), which was killing frequencies in earlier attempts.
    Docs: new cmos-synth-3786.md captures JDQ49A/3786/SGS M208B1 capacitor
    envelope ideas for future analog-digital hybrid. wt3-architecture.md gains
    sections on TDM mixing (9.1), NOP step rationale (5),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
    [wt3_piano.csv]
2026-06-14 Eliminate hidden inverters in v1.4: explicit 74HC04 instances (27 IC, 0 hidden gates)
    Three implicit `assign ~` inverters were acting as hidden gates:
    - wt3_spfm_bus.v: addr_wr_pulse_n = ~addr_q3 (174 Q3 -> 377 /Enable)
    - wt3_spfm_bus.v: data_wr_pulse_n = ~data_q2 (174 Q5 -> 157 A1)
    - wt3_core.v: latch_dac = ~dac_clk_n (154 Y13 -> 273 CP)
    All three now go through two real 74HC04 hex inverters (U4 in spfm_bus,
    U22 in core). IC count rises 25 -> 27 but no logic happens in `assign`.
    Remaining assigns are pure bus slicing/concatenation (verified no ~ & |).
    Updated wiring-table-v14.md with full 27-IC pinout including both hc04
    instances, and wt3-architecture.md IC table now reflects the explici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
2026-06-14 Archive v1.4 full: wsg-4ch-128pt-full/ (30 IC, 0 hidden gates)
    Snapshot of the complete 4-channel wavetable synthesizer (16-bit phase,
    128-point sine, 4-channel TDM mixing) into a self-contained folder.
    Contents (independent of project root):
    - rtl/: wt3_core.v + wt3_spfm_bus.v + 13 hc*.v chip models
    - tb/: wt3_core_tb.v (C-E-G-C5 cascade + piano envelope test)
    - rom/: microcode.hex + wavetable.hex + 3 generator/converter scripts
    - docs/: wt3-architecture + wiring-table-v14 + 2 design docs
    - out/: wt3_piano.wav (1.2s, 192kHz listening test artifact)
    - build_wt3.sh + pack_v14.py + release zip
    - README.md with parameter table, IC inventory, build instructions
    Verified standalone compilation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
2026-06-15 wsg3: eliminate X-propagation, DAC produces audio (freq bug TBD)
    Three root-cause fixes after microcode + bit mapping rewrite:
    1. U6 CS_n deselect during host freq write (0x50-0x5F) made TDM read
    return z -> carry chain X-pollution. Both LS189 /CS tied low; host
    write target selected via WE_n gated on reg_addr[4] instead.
    2. cd4066 inout model drove IO_A from IO_B (and vice versa), corrupting
    wave_nib with z on CTRL=0. Now IO_B is the only driven side; IO_A
    is read-only.
    3. Microcode ROM uses 16-bit words (0xDEF7/0xDEFF/0xBFFF) decoded into
    4 sub-cycle cells; control bits: [3]=/CLR [2]=/cp273 [1]=acc_we_n
    [0]=clk174. LSB nibble = sub-cycle 0.
    Test result: 47260/50000 no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
    [cd4066.v, hc04.v, hc157.v, hc158.v, hc174.v, hc273.v]
2026-06-15 wsg3: fix microcode nibble order + add cp273, freq 283Hz (target 440Hz)
    - gen_prom3m.py: MSB-first nibble extraction (sub0=nibble[15:12])
    - wsg3_core.v: add missing wire cp273 = ~cp273_pulse_n & ...
    - Microcode now matches doc: step 0 = 1101 1110 1111 0111
    - DAC output: 283Hz (target 440Hz, 0.64x slow)
    - Edge pattern: 128→320→576→128 samples (128=2 TDM cycles)
    - Issue: phase source unclear - carry_chain[4:0] vs 20-bit acc
    [wsg3_dac.csv, wt3_sine.csv, wt_output.csv, wt_top_output.csv]
2026-06-15 wsg3: fix bit[1]/bit[2] mapping (cp273/acc_we), freq still 283Hz
    Corrected control bit mapping per wsg3_core.v line 26-27:
    - bit[2] = ~acc_we_n (acc RAM write enable)
    - bit[1] = cp273 (output latch)
    Previously had these swapped.
    Analysis shows phase increment = 6 per TDM cycle (4806 % 32),
    which gives 283Hz output. Formula requires 96kHz accumulator
    update rate for 440Hz, but TDM architecture only provides ~19
    clk174 updates per 64-clock cycle (~28.5kHz).
    Issue: How to achieve 96kHz accumulator update in TDM architecture?
    [wsg3_func_tb.v, wsg3_phase_tb.v]
2026-06-16 wsg3: remove clear from microcode, freq still 283Hz
    Removed bit[3]=0 (clear) from all steps to allow carry_chain
    to accumulate across TDM cycles. Frequency remains 283Hz
    (target 440Hz), indicating the sliding window algorithm
    cannot properly implement 20-bit phase accumulation.
    Root cause: sliding window resets or doesn't carry full
    20-bit value across cycles. Need to redesign using
    283 cascade approach (like wsg-4ch).
2026-06-16 wsg3: enable acc_we in microcode, freq still 283Hz
    Modified microcode to include acc_we_n=0 at sub2 (write-back).
    Each step now: sub0=add (clk174), sub2=write (acc_we=0).
    Result: Frequency still 283Hz, confirming that the sliding window
    algorithm cannot correctly implement 20-bit accumulation
    regardless of timing or write-back control.
    Root cause: The sliding window {sum_1K, sum_d_1L[3]} algorithm
    is not equivalent to standard 20-bit addition. The carry
    feedback mechanism doesn't preserve the full accumulator state.
    [wsg3_core_v2.v]
2026-06-16 wsg3: redesign phase to use acc_dout directly, still 283Hz
    Attempted to bypass carry_chain sliding window by using
    acc_dout directly as phase source. Result unchanged at
    283Hz, confirming the fundamental limitation:
    4-bit RAM (LS189) cannot store sufficient phase precision.
    acc[0] max value = 15, but need 0-31 for 32 waveform samples.
    Root cause identified: Need either:
    1. Wider RAM (8-bit like 62256) to store full phase
    2. Multi-chip 283 cascade for true 20-bit accumulation
    TDM approach with 1x283 + 4-bit RAM is architecturally
    incapable of implementing Pac-Man 20-bit phase accumulator.
    [wsg3_core_backup.v, wsg3_core_redesign.v]
2026-06-16 fsm_player: 全芯片实例化双ROM自动播放器
    - 5×74HC161 CET级联20-bit地址计数器
    - 2×39SF040 程序ROM+数据ROM (各512KB)
    - 1×74HC273 数据输出锁存, 1×74HC04 预留
    - 仿真PASS: 256样本0x00-0xFF完整匹配
2026-06-16 39040cpu: ROM-ALU 处理器原型, 6 种运算验证通过
    基于 ROM 查表的 ALU 架构, 无传统 ALU 芯片:
    - ROM1 控制字 (INS|MOD|BUS), ROM2 数据, ROM3 ALU 查表
    - LD/AND/OR/XOR/ADD/SUB 全部通过 ROM3 查表完成
    - HM628512 512K SRAM 模型, 20-bit PC, 2 分频取指/执行
    - 测试程序 6 种运算 + OUT 输出全部 PASS
2026-06-16 39040cpu: 图灵完备, JMP/条件分支/循环全部通过
    - 修复相位方案: ctrl/d_reg每CLK锁存, 无需门控时钟
    - JMP flag用negedge CLK捕获exec阶段条件, posedge触发161 PE
    - 跳转目标pc[0]=1确保先取指再执行, 避免幻影写入
    - 新增HM628512 SRAM模型 (512K×8)
    - 测试通过: ALU(7种) + RAM读写 + BN跳转 + BZ循环 + JMP FAR
    - 输出序列: 42 4A 0F BD 55 30 DE BB 03 02 01 FF
    [cpu39040.v, cpu39040_tb.v, gen_roms.py]
2026-06-16 39040cpu: 全芯片实例化, 新增hc00/hc02/hc85/hc86模型
    实例化清单:
    - 9×157: bus_data 4:1 MUX(6), mem_lo/hi(4), x_load(2), jmp_target(4)
    - 2×283: x_next 8-bit incrementer
    - 2×85: carry_flag 8-bit comparator (ADD carry + SUB borrow)
    - 1×273(WIDTH=1): jmp_flag_reg, negedge clk via hc04
    - 2×04: clk inversion + 通用反相
    - 1×08: jmp flag AND gate
    - 1×32: cond_taken OR gate cascade + use_y
    - 1×02: cond_taken far-jump NOR
    - 2×08: is_st/is_jmp decode gates
    新增芯片模型: hc00(quad NAND), hc02(quad NOR),
    hc85(4-bit comparator), hc86(quad XOR)
    测试通过: 00 42 4A 0F BD 55 30 DE BB 03 02 01 FF PASS
2026-06-16 39040cpu: 修正芯片清单42片, 实例化ins0_inv/is_add_or_sub, 清理死代码
    - ins0_inv behavioral → hc04 u_inv2 A4
    - is_add_or_sub behavioral → hc08 u_carry_and1 Y1 + ins1_inv via u_inv2 A5
    - 删除死代码 u_cond_or (与 u_cond_or 重复)
    - 删除幽灵 u_far_nor hc02 (输出全部未使用)
    - 修正 NOR 级联 bug: ~(C|~(A|B)) ≠ ~(A|B|C)
    - 芯片清单修正: 5×161 4×377 3×39SF040 1×628512 5×273 1×174
    16×157 2×283 4×85 6×08 2×04 2×32 = 42片
    - 测试通过: 00 42 4A 0F BD 55 30 DE BB 03 02 01 FF
    [cpu39040.v]
2026-06-16 39040cpu: 精简42→26片, 组合逻辑改behavioral
    删除16片芯片实例, 改为behavioral assign (无时序影响):
    - 4×157 jmp_target MUX → 三元选择
    - 4×85 + 1×08 carry_flag比较器 → 行为比较
    - 2×08 ins_dec → (ins==110)/(ins==111)
    - 1×08 cond_and + 1×32 cond_or + 1×08 cond_final_and → 单行逻辑
    - 1×32 use_y → mod[1]|mod[2]
    - 2×283 x_next → x_reg+1
    保留26片: 5×161 4×377 3×39SF040 1×628512 5×273 1×174
    1×04 10×157 1×08
    测试通过: 00 42 4A 0F BD 55 30 DE BB 03 02 01 FF
2026-06-17 39040cpu: 压缩至9片(去MUX+去锁存), ROM加tAA=55ns延迟
    - 去掉2×157 MUX: 所有操作(含LD)经过ALU查表, alu_op=000直通
    - 去掉2×273锁存+1×04反相: uctl/udata直连377
    - hc39sf040加assign #55模拟tAA传播延迟, 修正仿真时序
    - 清理旧rom39040/目录, 迁移至rom/
    - 删除hc628512模型(当前版无SRAM)
    9片: 5×161(PC) + 3×39SF040(uctl/udata/alu) + 1×377(AC)
    [cpu39040.v, cpu39040_tb.v, gen_roms.py, hc39sf040.v]
2026-06-17 39040cpu: 加SRAM(62256), 15片零隐藏门, 负逻辑编码去04
    - 新增 HC62256 SRAM, 支持 LD[addr]/ST[addr]/ADD[addr]/SUB[addr]
    - 新增 X 寄存器(377)用于变址寻址, 4×157 MUX(bus/addr)
    - uctl 改负逻辑编码: ram_we_n/to_x_n 直连低有效引脚, 去掉 04
    - 所有非ST指令 ram_we_n=1 确保SRAM读模式
    15片: 5×161 + 3×39SF040 + 2×377 + 4×157 + 1×62256
2026-06-18 39040cpu: 加JMP+OUT, uctl拆16bit(第3片39SF040), 18片零隐藏门
    - uctl 拆为 uctl_lo(8bit) + uctl_hi(8bit), 第3片39SF040
    - 新增 JMP: pc_pe_n 直连 161 PE, 跳转地址={y_reg,udata}
    - 新增 OUT 寄存器(377), DATA_OUT=out_reg
    - 新增 Y 寄存器(377), JMP 高位地址
    - 161 D 端口接 jmp_addr, PE=pc_pe_n 时加载
    - JMP 循环验证通过, SRAM 读写正常
    18片: 5×161 + 4×39SF040 + 4×377 + 4×157 + 1×62256
2026-06-18 39040cpu: 加条件分支(JZ), 图灵完备22片零隐藏门
    - 条件分支: 2×hc32(zero_flag OR tree + cond OR) + 1×hc08(AND) + 1×hc04(NOT)
    - ALU新增op=011(PASS_AC), OUT指令能输出当前AC值
    - 修复OUT指令编码(to_out_n极性)和JMP/JZ编码(位分配)
    - 测试程序: 计数器5→0循环, JZ退出→停机, 仿真通过
    [cpu39040.v, cpu39040_tb.v, gen_roms.py]
2026-06-30 feat(psg_voice): 单音 PSG 完整实现 + FT232H 控制 + 4首儿歌播放
2026-06-30 refactor(psg_voice): 按版本号拆分 PSG1 v0.1/v0.2
2026-06-30 docs(psg_voice v0.2): 聚焦单通道+4bit音量, 多通道拆到 v0.3+
2026-06-30 docs(psg_voice v0.2): 去掉gate, 音量码0静音, 总线变标准 LE/A0/RST
2026-06-30 docs(psg_voice v0.2): 接线表 (HC374音量锁存 + TLC7524衰减器)
2026-07-01 feat(psg_voice v0.2): RTL + 仿真通过 (1通道方波 + 4bit音量)
2026-07-01 docs(psg_voice v0.2): 交接文档 (状态/待办/经验/后续规划)
2026-07-01 fix(psg_voice v0.2): 修正 TLC7524 引脚定义 + 论证 DB4-7 高4位音量接法最优
    引脚修正 (据实测 DIP-16):
    - Pin1=OUT1 / Pin2=OUT2 (原表 OUT1/OUT2 位置反了)
    - Pin10=DB1 / Pin11=DB0 / Pin12=CS / Pin13=WR / Pin14=VDD
    (原表把 CS/WR 误标在 Pin10/11, DB0-DB2 错位)
    - Pin15=REF / Pin16=RFB (电压模式下 RFB 悬空)
    - 同步更新 toggle_q 去向 (->Pin1)、电源表 VDD (Pin14)、handoff 输出链路
    音量接法论证 (DB4-7 高4位最优):
    - 必须连续4位: 权值1:2:4:8 才能让16档等距铺开,无碰撞不浪费
    非连续位(如DB7,5,3,1)权值跳跃,16值挤成4团,实际只剩4档有效
    - 必须接高段: 满量程D=240(94%幅度,4.69V),信噪比最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
2026-07-01 feat(psg_voice v0.2): 硬件实测出声 + ADSR包络/颤音合成器 + 曲目库
    硬件 (TLC7524 接法修正, 据 datasheet + 实测 net):
    - 弃用反接电压模式 (OUT1=输入/REF=输出/RFB悬空) → 噪音+音量失效
    - 改正向接法 (REF=方波输入/OUT1=输出/RFB=GND) → 音量调整生效
    - 总线 bug 修复: 写 period/音量前先关对方选通, 防串扰
    控制脚本 host/psg_adsr_songs_v02.py (最终版):
    - 钢琴风格 ADSR 包络 (A快/D明显/S低/R快), D/R 随速度缩放
    - 颤音: period 三角波偏移 (≤半半音), 延迟/频率/幅度可键盘调
    - 曲目库外置 psg_songs.ini (简谱文本格式, 用户可编辑增删)
    - 键盘控制 (独立线程): n/b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
2026-07-01 feat(psg_voice v0.2): 移调(key调号/音符升降/八度) + 乐谱实时打印
    控制脚本 psg_adsr_songs_v02.py:
    - 移调 (ini 层面):
    - key 调号 key=F (1=do=F, 全曲+5半音), 支持 C/D/E/F/G/A/B + #/b
    - 整曲八度 key=^C (升八度) / key=,C (降八度)
    - 音符级升降 5+ (升sol) / 6- (降la), 与 key 独立叠加
    - 乐谱实时打印: 播放时逐音 [token] 显示, 换行与 ini 一致
    - parse_notes 改为 5 元组 (加 raw_tok), 新增 split_notes_lines 按原始行分组
    曲目库 psg_songs.ini (用户实测修正):
    - 欢乐颂加 key=D, 铃儿响叮当加 key=^C
    - 友谊地久天长/生日快乐简谱修正
    - 删除重复的 [song_7] 段, 头部注释补 key/+-/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
2026-07-01 fix(psg_voice v0.2): 纠正总线串扰误诊 — 真因是RST错接LE
    之前以为 LE/A0 总线复用串扰, 在脚本加互关隔离逻辑 (误诊).
    真正根因: 用户接线错误 — RST 线错接到了 LE 位置, 复位脉冲乱触发
    锁存/计数器, 产生各种奇怪行为 (音量写进频率/噪音等).
    修正后 (Main_2026-07-02.net):
    - LE 走独立 LS373 通道 (U1.7←D4 → U1.6→HC373 LE)
    - A0 走独立通道 (U1.4←D5 → U1.5→HC374 CP)
    - /RST 走独立通道 (U1.3←D6 → U1.2→计数器/toggle 复位)
    - 三信号完全独立, 设计本身没问题, 脚本隔离逻辑多余但保留
    教训写进 CLAUDE.md: 遇到奇怪行为先查硬件接线, 别急着改软件.
2026-07-01 docs(PSG2 v0.3): 启动两通道规划 — 多波形架构/LFSR噪音/库存芯片用途
    新建 PSG2 v0.3 目录, design.md 沉淀今日讨论结论:
    - 设计原则: 纯数字, 复用已验证方波逻辑, 不用RC/电阻网络
    - 架构候选B: 锯齿/三角用2片TLC7524级联(波形DAC+音量DAC), 方波/噪音用1片
    - LFSR噪音: HC164(移位)+CD4070(XOR反馈)+CD4060(时钟) = 3片
    - 库存芯片用途表 (4070/164/4060/4066/4029/4027/4013/4042/4069/LS368/4022)
    - 待讨论: 混音/三角波方向控制/HC138地址译码/先做哪两通道
    CLAUDE.md 同步: 标记 v0.3 启动
2026-07-01 docs(PSG2 v0.3): 噪音寄存器设计 + 周期噪音原理 + 复用HC161波形/占空比思路
    第四章补充 (LFSR 噪音):
    - 4.4 寄存器设计: 3bit频率(8挡) + 1bit类型(白噪/周期) = 4bit用满HC374
    - 4.5 周期性噪音原理: 自反馈Q0直通 → LFSR退化环形移位 → 窄脉冲(非方波)
    对比白噪(异或反馈,长周期伪随机) vs 周期(自反馈,短周期有音高), 用于底鼓
    - 类型切换: 4066 在'异或输出'和'Q0直通'间2选1, 由bit3控制
    - 成本修正: HC164+4070+4060+4066 = 4片
    第五章新增 (复用HC161思路):
    - 核心洞察: HC161的Q0-Q7本身就是阶梯锯齿波数据
    - 4bit余量分配: 倾向 2bit占空比 + 2bit波形选择
    - 占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
2026-07-02 docs(PSG2 v0.3): 确立固定波形通道架构, 弃用复用161切波形
    第二章重写 (通道架构已定):
    - 每通道固定一种波形, 不做切换 (简单稳定)
    - 通道规划: CH0方波 / CH1锯齿 / CH2三角 / CH3噪音
    - DAC用法区分:
    - 1-bit波形(方波/噪音): 1片TLC7524, REF携带波形, DB接音量
    - 8-bit波形(锯齿/三角): 2片TLC7524级联, #1做波形D/A, #2做音量衰减
    - 混音方式待定 (电阻求和 vs 运放加法器)
    第五章标记弃用 (复用HC161切波形):
    - 弃用原因: period计数与满幅度计数冲突
    - 复用Q输出锯齿幅度随音高变, 无法保证满幅度
    - 加独立HC161又导致频率÷256太低, 波形切换最少2-4片效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
2026-07-02 docs(PSG2 v0.3): 交接文档 (架构规划/已完成/待办/弃用方案记录)
    - 一句话现状: 多通道扩展, 固定波形通道架构已定
    - 已定架构: CH0方波/CH1锯齿/CH2三角/CH3噪音 + DAC用法区分
    - LFSR噪音寄存器: 3bit频率+1bit类型, 周期噪音原理
    - 已完成: 架构决策/LFSR设计/库存芯片表/设计原则
    - 待办: 混音/三角方向/HC138译码/先做哪两通道/7524级联阻抗
    - 弃用方案记录: 复用HC161切波形 (period与满幅度计数冲突)
    - v0.2基础: TLC7524正向接法/FT232H控制/ADSR软件合成器
2026-07-02 feat(PSG2 v0.3): 方波通道播放器 + RTL 注释对齐接线表
    host/psg_adsr_songs_v03.py — v0.2 ADSR 播放器升级到 v0.3 方波通道:
    - 控制字 (vol|duty<<4|ref<<6|mode<<7), bit6/bit7 据硬件实测对调
    - ToneControl: D占空比循环/S方波白噪/W REF切换 (中断式键盘)
    - DutyOctave: 占空比变窄时频率补偿 (freq×2^N, 与移调同源), 从 ini [Duty] 读
    - reapply_period: 发声中切占空比实时重算 period, 不打断 ADSR
    host/psg_voltest_v03.py — 极简音量/频率测试 (无 ADSR, 手动写硬件)
    方向键调频率/音量, T 键音量扫描 (0→15), 排查音量链路
    rtl/ — 注释对齐接线表 (逻辑未动):
    - square: 9片→1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
2026-07-02 docs(PSG2 v0.3): 接线表 + README + 仿真测试台 (上板测试通过)
    接线表方波通道 (CH0) 全功能上板验证通过 (2026-07-03):
    - 占空比 4 挡切换 (bit4-5): 正常
    - 方波/白噪切换 (bit6): 正常 ← 因此噪音硬件通道暂未单独测试
    - REF 切换 (bit7): 正常
    - 音量 0-8 递增正常 (vol 9+ 到顶, 疑 REF 路径阻抗问题, 待查)
    新增文件:
    - README.md: 项目概览 (含全球搜证/独特性声明)
    - docs/wiring-table.md: 完整接线表 (CH0 方波 11 片 + CH1 噪音 6 片逐脚)
    - tb/: 7 个测试台源码 + 13 个 WAV 试听文件 (占空比/噪音/绑定)
    [psg_duty_verify_tb.v, psg_duty_wav_tb.v, psg_lfsr_lock_tb.v, psg_noise_bind_wav_tb.v, psg_noise_v03_tb.v, psg_noise_wav_tb.v]
2026-07-02 docs(PSG2 v0.3): 更新项目状态 — CH0 方波通道上板验证通过 (2026-07-03)
    上板测试结论:
    - 占空比 4 挡 (bit4-5) / 方波白噪 (bit6) / REF (bit7) 全功能正常
    - 方波通道自带白噪可用 → CH1 噪音硬件暂未单独测试
    - 音量 vol 0-8 正常, vol 9+ 到顶 (疑 REF 路径阻抗, 待查)
    - bit6/bit7 实测与接线表相反, 软件已按硬件对齐
    更新位置:
    - CLAUDE.md: 当前状态/目录树/愿景表 (上板中→验证通过)
    - handoff.md: 状态行 + 待办项 (CH0 验证打勾, 新增噪音待测/音量待查)
2026-07-02 docs: 说明 — 上一个 commit (bd6d4cf) 含 CLAUDE.md 历史积压改动
    bd6d4cf 标题是"更新项目状态"，但 CLAUDE.md 的 368 行改动里还包含
    v0.2→v0.3 期间积累但未提交的项目记忆更新 (物料约束/12根控制线/目录树/库存表)。
    这些内容本身正确，只是提交粒度不准确，特此记录。
2026-07-02 fix(PSG2 v0.3): 播放器启动/退出置干净状态, 防残留噪音
    启动 (init_audio): duty=50% / 方波模式 / ref=占空比变体 / period=1(最高频听不见) / 音量0
    退出 (shutdown): 同上, 防止退出后残留噪音 (尤其白噪模式)
    默认 duty 改 0b11 (50%), 原 0 (12.5%)
2026-07-02 fix(PSG2 v0.3): ToneControl 默认 duty_idx=3 (50%), 不再覆盖 init_audio
    ToneControl.__init__ 原设 duty_idx=0 (12.5%), _apply() 覆盖了 Psg.init_audio
    设的 50%, 导致启动不是 50% 方波。改为 idx=3 (50%) 与 init_audio 一致。
2026-07-02 fix(PSG2 v0.3): 退出流程改用 shutdown(), 修复 Ctrl+C 残留白噪
    原 finally 用 voice.silence() 会用当前 mode (可能=白噪) 写控制字, 致退出瞬间
    冒白噪。改为:
    1. selector.stop() 后 sleep(0.05) 等键盘线程退出 (避免竞争)
    2. psg.shutdown() 强制 mode=0/duty=50%/vol=0 (不受当前模式影响)
    3. 删除 voice.silence() (它是白噪来源)
2026-07-02 fix(PSG2 v0.3): setBitMode 后立即拉低 D口, 消除启动/退出毛刺噪音
    根因: FT232H setBitMode 切换瞬间 D口引脚状态不定, A0/LE 毛刺上升沿
    触发 HC374/HC373 锁存随机数据 (HC374 无 MR 不吃 RST).
    启动: setBitMode 后第 1 条写方向, 第 2 条立即 D口全 0 (A0/LE/RST=0),
    RST=0 按住 HC161, A0=0 防止 HC374 误锁存.
    退出: shutdown 后 D口拉 0 (RST=0 持续复位), sleep 等 stable 再 dev.close(),
    避免 close 引脚跳变时冒音.
2026-07-02 docs(PSG2 v0.3): 上板实测发现 + 频率精度架构分析 (8.5 节)
    新增 8.5 节, 记录 CH0 上板实测暴露的核心瓶颈和架构分析:
    实测发现 (设计约束更新):
    - 有效音域 ≤2000Hz (超 C7 听不见), 最高频指标无意义
    - C6-C7 period 8-bit 精度崩盘 (1.6-3% 跳变, 半音级), 是核心痛点
    - 占空比越小噪音频率越高 (噪音和方波非独立时钟)
    架构分析 (AY8910 vs YM2163):
    - AY8910 TP/FP: 线性 period 拆高低字节 (8-bit 总线寻址), PSG 用, 改频率相位跳变
    - YM2163 BLK/FNUM: 浮点频率 (尾数+八度), NCO 相位连续, FM 调制必需
    - 本项目是 PSG → period 扩展够, BLK/FNUM 留给 SCC NCO 路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
2026-07-02 docs: 查表机谱系 — SCC 的前置技术 (项目方向修正)
    核心认知 (2026-07-03 讨论):
    SCC/FM 不是"更复杂的音源电路", 是专用音频查表计算机.
    HC161 只能计数, 多通道调度 (读step→累加→查波形→乘音量) 要状态机指挥,
    状态机 = 微程序 ROM 驱动 = 查表机/CPU 架构. SCC 绕不开它.
    发现项目已有三机谱系 (之前忽略的资产):
    - fsm_player (9片): 顺序读 ROM, PCM 回放直接能用
    - SCC 专用查表机 (~14-16片, 规划): 微程序 + 音频数据通路
    - 39040cpu (22片): 通用图灵机, SCC/FM 当程序写
    项目方向修正:
    原"39040 暂缓, 音源跑通再回头"已过时.
    正确顺序: PSG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
2026-07-05 feat(萤火虫+miniglow): 架构研究 + 迷你萤火虫 CPU 全实例化 + FT232H 复用
    Glowworm-1（萤火虫 CPU 架构研究）:
    - compiler/: lcc 后端 glow.cpp 461KB（ISA + ALU 自举 + ROM 布局权威定义）
    - docs/: architecture/hardware/isa/coproc-design（基于源码反推，带行号）
    关键发现：ALU 表是开机 ISA 指令自举生成，非预烧 ROM
    - sim/glowworm_sim.c: C 指令级仿真器（仿照原版 glowworm_sim）
    - sw/: SCC/WT 算法实测（580 拍/通道，证明需要协处理器加速）
    - tb/: 萤火虫 ISA 测试
    miniglow（迷你萤火虫调度核，21 片全实例化）:
    - rtl/miniglow_top.v: 单 SRAM 架构（一片 628512，512KB 够用）
    - PC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
    [BOM_CPU.xlsx, BOM_下载器.xlsx]
2026-07-06 fix(PSG2 v0.3): 噪音通道绑定用独立 HC00 (U18), 删 RST 灌种, 接线表写死
    原方案借方波 U4 剩余门做绑定+灌种, HC00 门不够算不清, 接线表含糊.
    改为:
    - U18 独立 HC00 (4 门用满): ~bind 反相 + 2 选通 + 汇总 = 绑定 2 选 1
    noise_clk = NAND(NAND(ind_clk,~bind), NAND(square_tc,bind))
    真值表验证: bind=0 → ind_clk, bind=1 → square_tc ✅
    - RST 灌种删除: HC164 MR 常接 +5V, 靠上电随机值 + max-length 自持
    serial_in 直连 CD4070 xor_fb (0 额外门)
    仿真验证: 2000 拍 0 归锁
    噪音通道总芯片: 6 核心片 + 1 HC00 = 7 片
    接线表 U15/U18/U13 逐脚写死 (含真值表), 待验证项更新
    [psg_noise_v03.v]
2026-07-06 fix(PSG2 v0.3): U12 CD4070 Y3 输出连接更新 (serial_in 直连 HC164.DSA)
    CD4070 引脚号核对无误 (Y3=Pin8, 门3 输出, RTL cd4070.v 与 TI datasheet 一致).
    仅修正 Y3 连接描述: 原"→ U4 门 serial_in 逻辑"是旧文案, 现无灌种,
    改为"→ U13.HC164.DSA (Pin1, serial_in 直连)".
2026-07-06 fix(cd4070): 门3 引脚错 (Pin8 是 A3 不是 Y3), 查 TI datasheet 核对
    RTL cd4070.v 门3 引脚号错 (查 TI CD4070B Rev.E datasheet 核对 2026-07-03):
    原 RTL: A3=Pin9, B3=Pin10, Y3=Pin8 ❌
    实际: A3=Pin8, B3=Pin9, Y3=Pin10 ✅
    门2 A/B 也标反 (原 A=6/B=5, 实际 A=5/B=6), XOR 对称功能不影响
    影响:
    - 仿真全过 (assign Y3=A3^B3 逻辑对, 只是脚号注释错)
    - 上板会炸 (Pin8 接成输出, 实际是输入脚)
    - 接线表 U12 门3 三脚已同步修正
    教训: RTL 模型注释不能当权威, 必须查 datasheet 原文。
    [cd4070.v]
2026-07-06 feat(PSG2 v0.3 rev.a): HC374 LFSR 噪音通道 + RC 启动 (替代 HC164)
    原版 HC164 国产不稳定 + 上电全 0 死锁, rev.a 改用 HC374:
    - LFSR 主体: HC164 → HC374 (D 触发器阵列, D[0]=反馈/启动)
    - 反馈: CD4070 → HC86 (门1-3 XOR, 门4 闲置)
    - 启动逻辑: RC 上电脉冲 (47kΩ+0.1μF, τ=4.7ms) + 借方波 U4 HC00 门2/3/4
    D[0] = feedback OR RC_pulse (上电强制=1 填满 LFSR, 之后切回反馈)
    3 个 HC00 门实现 OR (德摩根: NAND(NOT fb, NOT rc))
    0 额外芯片 (U4 门1 仍 PE 反相, 门2/3/4 借用)
    仿真全过 (psg_noise_374_tb.v):
    - 上电 16 拍填满 LFSR=0xFF, 不死锁 ✅
    - max-length 周期 255, 256 拍回基准 1 次, 0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
2026-07-06 fix(PSG2 v0.3 rev.a): U12 改回 CD4070 (与 HC86 功能等效, 引脚不同)
    CD4070 和 HC86 都是四 2 输入 XOR, 功能等效. 不换芯片.
    但门 2/3 的 A/B/Y 脚位不同 (4000 系列布局):
    CD4070 门2: A=5, B=6, Y=4 HC86 门2: A=4, B=5, Y=6
    CD4070 门3: A=8, B=9, Y=10 HC86 门3: A=9, B=10, Y=8
    接线表第六节改回 CD4070 引脚 (85bb480 commit 核对 TI datasheet).
    芯片清单/电源表/待验证项同步更新.
2026-07-06 fix(PSG2 v0.3 rev.a): HC374 D/Q 引脚交错排列 (D0=Pin3, Q0=Pin2)
    据 Nexperia 74HC_HCT374 datasheet 核对 (2026-07-07), D 和 Q 交错排列:
    D 在 Pin 3,4,5,6,16,17,18,19
    Q 在 Pin 2,7,8,9,12,13,14,15
    原 rev.a 逐脚表把 D/Q 标反了 (用了错误的 hc374.v 注释, 仿真不查脚号没暴露).
    RTL hc374.v 注释同步修正.
    LFSR 移位链 (D[i] ← Q[i-1]) 全部按正确脚位重接:
    D0(Pin3) ← feedback/RC
    D1(Pin4) ← Q0(Pin2), ... Q3/Q4/Q5/Q7 是反馈 tap
    [hc374.v]
2026-07-06 fix(PSG2 v0.3 rev.a): HC374 引脚再修正 (Q7=Pin19, 据 Nexperia PDF 原文)
    前两次'核对 datasheet'都读错了 (二手搜索结果不可信, 连官方总结都自相矛盾).
    这次直接读 Nexperia 74HC_HCT374.pdf 5.2 节 Pin description 原文:
    D0-D7 = Pin 3, 4, 7, 8, 13, 14, 17, 18
    Q0-Q7 = Pin 2, 5, 6, 9, 12, 15, 16, 19
    之前错把 Q4-Q7 写成 Pin 12-15 (实际 Q4=12, Q5=15, Q6=16, Q7=19).
    rev.a U13 逐脚表 + hc374.v RTL 注释同步修正.
    LFSR 移位链重接 (D[i] ← Q[i-1] 按正确 Pin):
    D4(Pin13)←Q3(Pin9), D5(Pin14)←Q4(Pin12),
    D6(Pin17)←Q5(Pin15), D7(Pin18)←Q6(Pin16), Q7(Pin19)→反馈+DAC
    教训: datasheet 必须读 PDF 原文, 不能信搜索总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
    [hc374.v]
2026-07-06 fix(PSG2 v0.3 rev.a): U4 门4 输出接 U13.D0 引脚号 (Pin 9 → Pin 3)
    全文复审 HC374 引脚引用, 发现 U4 启动输出那行还写着旧的 Pin 9.
    HC374 D0 = Pin 3 (不是 Pin 9, Pin 9 是 Q3).
    其余引用 (U12 反馈 tap / U13 移位链 / U17.REF) 核对全对.
2026-07-06 docs(PSG2 v0.3): mode 白噪物理本质 + HC161 噪音备选方案 (5.8.1/5.8.2)
    用户深挖 mode 白噪形成机理, 发现它是"非理想 LFSR":
    LFSR 三要素 = 反馈 + 移位 + D触发器级联
    HC161 内部恰好自带 (4级D触发器移位 + TC的AND反馈)
    mode 白噪 = AND反馈 + HC00延迟抖动 (非XOR, 准随机但稳定)
    5.8.1 mode 白噪物理本质:
    - 真 LFSR: XOR反馈 → max-length伪随机 (周期255)
    - mode白噪: AND(TC)+延迟 → 非数学随机, 但reload自持永不锁死
    - 解释 HC164 LFSR 上板失败 vs mode白噪稳定的反差
    5.8.2 HC161 噪音备选方案 (若 rev.a HC374 再失败):
    - HC161 自带reload机制 (TC→/PE) 天然防锁死, 0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
2026-07-06 docs(PSG2 v0.3): 修正 mode 白噪机理 — 采样竞争 (非 LFSR, 非 延迟+累积)
    用户实测纠正: TC/pe_n 直接接喇叭只听到刺耳高频变形方波 (周期信号),
    不是噪声. 噪声产生的必要条件是 7474 D 触发器的采样.
    正确机理 (采样竞争 / metastability):
    1. HC00 反相器 ~10ns 延迟, 把 pe_n 跳变沿推到 clk 上升沿附近
    2. 7474 在 clk 边沿采样 pe_n, 落在跳变"建立时间窗"内
    3. 有时采到旧值, 有时采到新值 (随 period 改变相位关系)
    4. 输出翻转时机看似随机 → 噪声
    5.8.1 重写:
    - 噪声源是 7474 采样竞争, 不是 pe_n 信号本身
    - 直接接喇叭无采样动作 → 出不来噪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
2026-07-06 docs(PSG2 v0.3): mode 白噪实测特性 (5.8.1a) — 印证采样竞争机理
    用户调整外部时钟 + 占空比实测三个现象, 全部印证采样竞争解释:
    现象1: 噪音频率只跟主 clk, period 编程无效
    → 随机比特只在 clk 上升沿产生, period 只改 pe_n 相位不改采样速率
    → 决定 mode 白噪无法做绑定模式 (跟音高走)
    现象2: 占空比影响音量 + 频率 (耦合)
    → 占空比窄 = 能量低 + 频率高, 50% 最饱满
    → mode 白噪音量/频率被占空比耦合, 不独立可控
    现象3: 跨越数字/模拟边界 (真随机, 仿真复现不了)
    mode 白噪 vs HC374 LFSR 特性总结表更新.
    结论: mode 白噪做固定频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
2026-07-06 docs(PSG2 v0.3): 噪音方波同源认知 + Q0/Q1 管乐器音色 (5.8 + 5.9)
    5.8 认知突破 (用户意外收获):
    在此之前以为噪音和方波是完全不同的东西, 需要独立 LFSR.
    结果改一根线 (7474.D 从 tc_hi 改 pe_n) 就出噪音.
    方波和噪音在 74 离散逻辑里是同源的 — 都是"计数器+D触发器",
    区别只在 D 接哪个信号 (tc_hi=方波, pe_n=采样竞争=噪音).
    这让 CH1 独立 LFSR 通道的必要性打折扣.
    5.9 Q 抽头音色实测补充 (2026-07-07):
    Q0/Q1 不是简单数字方波 — 非理想边沿/瞬态直接当模拟信号用,
    经 TLC7524 乘法调制产生管乐器音色:
    Q0 = 小号 (高泛音, 明亮)
    Q1 =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
2026-07-06 docs(PSG2 v0.3): 纠正 Q0/Q1 音色原理 — 不是乘法调制, 是 Q 抽头模拟特性
    用户实测纠正: 直接把音频线插到 Q0/Q1 芰点就是这个音色,
    TLC7524 在路径里只是音量衰减器, 不参与音色生成.
    之前错误描述: "REF 接 Q0 → TLC7524 乘法调制 → 产生泛音"
    正确机理: HC161 的 Q0/Q1 输出不是理想方波, 边沿有瞬态/过冲/谐波包络,
    这些模拟特性直接就是音色 (小号/萨克斯管乐器质感).
    TLC7524 只做幅度衰减 (REF 输入什么波形, 输出就是什么波形 ×音量),
    不改变音色本质.
    iverilog 复现不了的真正原因 (修正):
    不是"乘法调制看不到", 而是 HC161 的 Q 在仿真里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
2026-07-06 docs(PSG2 v0.3): Q 抽头音色机理 (5.9.1) — 跳变瞬态 + reload 混叠
    用户实测: Q0/Q1 泛音随编程进去的 period 循环改变, 不同音高泛音完全不同.
    这指向两个机理的组合:
    机理1 跳变瞬态 (为什么有泛音, Q0/Q1 音色不同):
    HC161 的 Q 不是理想方波, 边沿有瞬态/过冲/振铃.
    Q0=clk/2 (最高频) 瞬态落可听范围 → 高泛音 → 小号
    Q1=clk/4 瞬态频率减半 → 低泛音 → 萨克斯
    位越高瞬态频谱越低, 音色越暗.
    机理2 reload 混叠 (为什么泛音随 period 循环变化):
    reload 边沿和 Q0/Q1 跳变沿有周期性相位关系.
    gcd(2, P+1) 决定 Q0 与 reload 的相位重复模式:
    P+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
2026-07-07 fix(PSG2 v0.3 rev.a): RC 上电脉冲 → 振荡器持续注入 (实测防锁死)
    实测问题 (2026-07-07): 原 RC 方案 (47kΩ+0.1μF 上电一次性脉冲) 频繁切频率挡会锁死.
    根因: noise_clk 突变时 HC374 落入非常规态, RC 已放电无法再次触发.
    用户发现的解法: HC00 反相器 + 2 个 0.1μF 电容构成张弛振荡器, 持续注入 D[0]:
    C1 并联门3 输入↔输出 (正反馈回路)
    C2 并联门3 两输入 (稳定振荡)
    反相器+电容持续振荡, 不是上电一次性
    实测稳定几分钟无问题, 频繁切频率不再锁死.
    效果: LFSR 变成半模拟半数字噪声源 — 既保持 max-length 演化,
    又被周期性踢出死锁陷阱.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
2026-07-07 docs(PSG2 v0.3 rev.a): 揭露振荡器本质 — 模拟噪声源, LFSR 退化成采样器
    用户实测: RC 节点直接接音响 = 小声白噪.
    说明 HC00 反相器+0.1μF 电容根本不是"数字振荡器", 是模拟宽带噪声源
    (时间常数极小, 振荡在 MHz 级, 输出是噪声不是干净方波).
    真相: LFSR 退化成"模拟噪声采样器".
    - 每个 noise_clk 上升沿, HC374 采一个模拟噪声瞬时值到 D[0]
    - LFSR 移位/反馈结构提供数字骨架
    - D[0] 是真随机 (物理噪声), 不可能收敛 → 永不锁死
    这解释了"频繁切频率挡锁死"消失的真正原因:
    原 RC 方案: 脉冲放完, D[0]=feedback (纯数字演化, 国产 HC374 会伪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
2026-07-07 docs(PSG2 v0.3 rev.a): 纠正锁死归因 — 任意移位寄存器都会锁死, 非芯片质量
    用户纠正: 这次用的是原装 LS374 (非国产), 一样锁死. 之前 HC164 也是类似情况.
    说明纯数字 LFSR 锁死是移位寄存器的固有特性, 不是芯片质量问题.
    修正文档:
    - 删掉"国产 HC374 建立时间不足"的错误归因
    - 改为"任意移位寄存器都会锁死" (HC164/LS374 实测印证)
    - 业界标准做法 (RC 灌种/全0检测/TR-909启动) 都是补丁, 没根治
    - 本项目的创新: D[0] 注入模拟噪声绕过防锁死问题 (用模拟特性解决数字死穴)
    教训: 还是要有创新精神.
    纯数字 LFSR 的 max-length 防锁死是数学理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
2026-07-07 docs: 交接文档重写 + CLAUDE.md 方法论更新 (2026-07-07)
    handoff.md 整篇重写, 反映 v0.3 全部进展:
    - 核心认知: 仿真盲区(深化) + 实践创新原则(新) + 噪音方波同源(新)
    - CH0 方波: 上板验证通过 + Q0/Q1 音色机理 + mode 白噪采样竞争
    - CH1 噪音: rev.a (HC374 + 模拟注入) 演进历程 + 上板稳定
    - 查表机谱系: SCC 路线 (fsm_player/39040/SCC)
    - 待办: 噪音详细验证 / 音量排查 / 查表机下一站
    CLAUDE.md 更新:
    - 5.5 关键教训: datasheet 必查 PDF 原文 / 同型号接线优先 / HC374 D/Q 交错
    - 5.5 仿真盲区深化: mode 白噪采样竞争(非延迟) / Q 抽头音色(非乘法调制)
    - 5.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
2026-07-07 fix(PSG2 v0.3): 噪音测试方向键按模式分流 + 删 1-5 预设
    原: ←/→ 只切噪音频率挡, 绑定模式的方波音高要按 1-5 数字键.
    改: ←/→ 按当前模式自动分流:
    独立模式 (bind=0): ←/→ 切噪音频率挡 (÷2/÷4/÷8/÷16 循环)
    绑定模式 (bind=1): ←/→ 调方波 period ±1 (音高↓/↑, 噪音跟 TC 走)
    删掉 SQUARE_PRESETS (1-5 数字键预设), 不再需要.
    帮助文本同步更新.
2026-07-07 docs(PSG2 v0.3): 噪音频率实用性实测 (4.4 节) — kHz 级才有用
    用户实测 (2026-07-07):
    绑定模式 2000-32000Hz (period 240-255) 有实用性, 其它频率太低不实用.
    独立模式 4 挡 (÷2=32k / ÷4=16k / ÷8=8k / ÷16=4k) 全部实用.
    设计约束更新:
    噪音要 kHz 级 (≥2000Hz) 才听得清是"噪音"而不是稀疏颗粒.
    绑定模式实用区间只有 16 档 (period 240-255), "嗨镲跟旋律走"音域窄.
    独立模式是主用, 绑定模式是辅助.
    这和方波"有效音域 ≤2000Hz"形成对照 — 方波要低, 噪音要高.
    4.4 节绑定模式表格用实测结论替换仿真预测 (C3-C5 不实用, C6 临界, C7+ 实用).
2026-07-07 docs: 纠正归因 — HC164 国产也能用, 失败是启动电路缺陷
    2026-07-08 用户实测: 国产 HC164 也能做 LFSR, 之前 rev.a 切换到 HC374 时
    以为"国产 HC164 不稳定"是错的. 失败完全因启动电路:
    - RC 上电一次性脉冲: 频繁切频率会锁死 (RC 放完电无法再触发)
    - 持续模拟注入 (HC00+电容振荡器): 稳定不锁死
    核心认知: HC164/HC374/LS374 (国产/进口) 都能做 LFSR,
    关键是启动电路, 不是芯片质量.
    修正位置:
    - wiring-table-rev-a.md 顶部对比说明 + 待验证项
    - design.md 5.8.1/5.8.2 归因
    - handoff.md 实践创新段落补充
    - CLAUDE.md 实践创新原则补充
2026-07-07 docs: PSG2 v0.3 圆满完成 — 交接文档 + 芯片架构对比 (2026-07-08)
    PSG2 全部上板验证通过:
    CH0 方波 (11片): 占空比4挡 + mode白噪 + REF切换 + Q0/Q1管乐器音色
    CH1 噪音 rev.a (7片+2电容): HC374 + HC00振荡器模拟注入, 永不锁死
    2026-07-08 关键发现:
    HC164 (国产) 绑定模式 200-32000Hz 全音域实用
    HC374/LS374 只有 2000-32000Hz 实用 (架构差异: 串行级联 vs 并行 octal)
    rev.a 切到 HC374 可能需要修正 → rev.b 候选: HC164 + 模拟注入
    启动电路是关键, 不是芯片型号 (HC164 国产也能用)
    handoff.md 整篇重写 (PSG2 圆满完成版):
    - 完成清单 (CH0+CH1 全部上板结论)
    - 5 条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
2026-07-07 feat(PSG3 v0.4): YM2413 总线协议 + 方波/噪音两通道 + VGM 预录制 + 噪音乐器
    接口层 (YM2413 风格地址/数据复用总线):
    - 8 位总线复用 (地址+数据), A0/WR/CS/RST 4 线控制, FT232H 物理接线不变
    - 独热码地址一对一选通 8 个 HC374 寄存器, 无译码器
    - /CS 事务保护消除"短暂地址值"中间态 (仿真验证 0 错误)
    - HC374 边沿地址锁存 (不用 HC373 透明, 避免竞争)
    - 接口层独立芯片, 不借门给通道层
    通道层 (照抄 PSG2 v0.3, 已上板验证):
    - 方波 CH0: reg0(period) + reg1(控制=音量/占空比/mode/ref)
    - 噪音 CH1: reg2(控制=音量/频率挡/绑定), rev.a 模拟注入防锁死
    上板踩坑 (d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
2026-07-07 feat(PSG3 v0.4): 方波乐器 + VGM 预录制完善 + 范围循环 + 交接文档
    播放器功能完善:
    - 方波乐器 [square_N] 块: mode/wave/duty/octave_shift/volume
    notes 里 乐器名:音级:拍数 切换音色, 切换后保持直到下次切换
    volume=default 走 ADSR, 手动序列走固定包络
    - 噪音乐器音长修正: step 只管 key_on 后序列, 音长=beats×beat_t 统一
    - 双轨并行时间轴: 方波行/鼓点行各自累计, 严格等长对齐
    - 按 ini 物理行打印: 方波行/鼓点行各自换行, 边播边打 (不挤一起)
    - --song N-M 范围循环 (如 --song 1-4 循环播 1 到 4)
    文档:
    - design.md 7.3 节: 补充方波乐器 + 按行打印 + 范围循环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
2026-07-07 docs(PSG3 v0.4): 交接文档补 PSG3 v0.5 下一站方向 (锯齿/三角 12-bit)
    PSG3 v0.4 圆满完成 (接口5片 + 方波11片 + 噪音8片 = 24片).
    下一版 PSG3 v0.5: 锯齿波/三角波通道, 12-bit 频率精度 (解决 C6-C7 量化崩盘).
    - reg3(0x08)=period低8位, reg4(0x10)=period高4位+4bit音量
    - 锯齿: HC161满幅度计数 + HC273毛刺滤除 + 2×TLC7524级联
    - 三角: CD4029可逆计数 + CD4027方向控制
    - HC273毛刺滤除是刚需 (design.md 2.1节)
2026-07-09 feat(PSG3 v0.5): 三通道波形音源 + 库存表 + HC85/CD4027 替代
    架构:
    - 方波通道 (reg0/1, v0.4 不变) + 噪音 (reg2, v0.4 不变) + 波形通道 (reg3/4/5, 新)
    - 波形通道: CD4029 4-bit 计数器, wave_sel(dir+fold) 切方波/三角/锯齿/反锯齿
    - 周期分两类: 锯齿族单向16步 / 三角折返30步, 两套 period 查找表
    - HC283 加法器做比较 (替代不在库存的 HC85) + HC112 JK触发器 (替代 CD4027)
    - mode_sel 切 HC283 比较调制 / HC08 AND 位掩码调制
    文件:
    - rtl/psg3_top.v: 三通道并存顶层 (方波+波形+噪音, 三路独立输出)
    - rtl/hc112.v: 74HC112 双JK下降沿触发器模型 (据 TI datasheet)
    - rtl/cd4029.v: CD4029 4-bit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
2026-07-09 docs: CLAUDE.md 加 git 纪律(直接main不开分支) + 库存表纪律
2026-07-09 docs(PSG3 v0.5): 总线地址扩展架构规划 (8→256地址) + 库存扩充
    handoff 新增"总线扩展架构规划"章节:
    - 标准化声音模块接口 (D0-7 + CP + rst_n)
    - 独热码(8) → 154(16/32) → 138+154(128) → 页寄存器(256+) 五级方案
    - 每方案附接线说明 + 芯片数 + 适用场景
    - 每声道地址占用分析 (6-10 reg/声道)
    inventory 库存扩充 (本轮多批次):
    - 74系列: 20/27/54/75/122/157/194/280 等
    - CD系列: 4049/4051/4053/4543 等
    - ECL系列: 10K/10H/100K 三子系列 (PECL接法可与74互通)
    - 音源IC: SN76477/76489/MOS6581/8580 SID
    - 模拟函数发生器: XR2206/ICL8038/LM566/MC1496/CA3080 等
    - CPLD/FPGA: Xilinx XC9500 + Altera MAX700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
2026-07-09 docs(PSG3 v0.5): RAM替代374分析 + YM2608 ADPCM原理 + PCM音源方案
    新增三个架构分析章节:
    1. RAM + 总线仲裁:
    - 寄存器(持续输出) vs RAM(瞬时读) 的核心矛盾
    - 三种解法: RAM仓库+374 / TDM分时轮询 / 双口RAM(CY7C130)
    - 总线仲裁: CPU优先+通道插空, 或双口RAM免仲裁
    2. YM2608 ADPCM 原理:
    - 外挂256K DRAM, 内部地址发生器+ADPCM解码器
    - CPU只设起止地址+频率, 不用翻页不用逐字节搬运
    - 线性地址计数器遍历DRAM
    3. PCM音源方案:
    - PCM本质 = 地址计数器+ROM+DAC (NCO的查表内容换成录音)
    - 74系列实现: HC161地址计数→SRAM/ROM→HC273保持→TLC7524→运放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
2026-07-09 docs: TDM分发=固定微程序ROM顺序读, 不需分支循环 (fsm_player升级版)
2026-07-09 feat(v0.6): 新建 WSG3 v0.6 + PSG4 v0.6 交接文档
    WSG3 v0.6: Pac-Man Namco WSG 复刻
    - 10 片核心 (2ROM+2RAM+283+174+157+158+161+273+4066)
    - 复用 PSG3 v0.5 总线接口 (13片已验证), 接口层永不膨胀
    - 目标 0 隐藏门 (微码ROM直出控制, 不用assign三元)
    - 3通道波表, 4-bit加法器分时做20/16-bit NCO
    PSG4 v0.6: PSG3 波形通道升级 (DCO + RAM 波表)
    - CD4029内置阶梯 → SRAM查表任意波形
    - period reload 控频 (不用NCO, 不用加法器)
    - 波形可实时写SRAM (vs WSG的PROM固化)
    - 预估16片 (PSG3的14片 + SRAM + 地址计数器)
    两者共享 PSG3 v0.5 总线接口, 可并存
2026-07-10 docs(FM6 v0.7): design.md 架构设计完成 (TDM步序列+conv_vol地址+ADSR+6问题方案)
    - 吃透 ym2413.c ym_render() 算法: 2-op FM 10步运算序列
    - TDM 9步/通道: OP1累加(0-3)+OP2累加(4-7)+ADSR(8), ÷216=66.3kHz采样率
    - conv_vol 地址: {env_level[5],sin_index[6]}=11bit, F7 HC157×2 mux
    - 相位调制: F3 HC273锁存mod_out + F4 HC283做idx_c+mod_out加法
    - ADSR: HC161(env_cnt溢出计时)+CD4029(env_level可逆)+2bit状态机
    - 倍率mul/fb: CPU预乘硬件不乘法, 第一版fb只支持0/1
    - 芯片清单修订: 27→26片 (删W4波形RAM被F1替代)
    - 修正handoff: STC路径改绝对路径(在本仓之外)
    - 6个待解决问题全部标记已解决
2026-07-10 fix(PSG3 v0.5): 接线表全部补逐Pin引脚号 + 删除方波特殊判断
    接线表 (wiring-table-uni.md):
    - U20-U22 HC161: 从v0.1抄逐脚表, 补完整3片×16pin
    - U23 HC00: 门→逐Pin表 (4反相器, 14pin全标)
    - U27 HC08: 信号级→逐Pin表 (4 AND门, 14pin全标)
    - U28 HC153: 功能表→逐Pin表 (引脚从v0.3抄, 16pin全标)
    - U32 HC00 mux: 门→逐Pin表 (3门mux+1门备用, 14pin全标)
    - U33 HC04: 门表→逐Pin表 (5门用+1门备用, 14pin全标)
    - 所有芯片段统一格式: | Pin | 信号 | 连接 |
    RTL (psg3_top.v):
    - 删除 wave==10 方波特殊判断 (方波=锯齿+mode_sel=1, 不需强制)
    - HC153 选择统一: mode_sel=1比较 / mode_sel=0 AND, 所有波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
    [psg3_top.v, psg3_uni_tb.v]
2026-07-10 fix: CD4029 Q1-4→HC273 D0-3 逐脚对应 (Q1=P12→D0=P3 等4根线)
2026-07-10 feat(FM6 v0.7): 单通道 2-op FM 算法 RTL 验证通过
    - fm6_core.v: 单通道 2-op FM 合成器核心
    - 实例化 8 片 hc283 (4×OP1 NCO + 4×OP2 NCO, 16-bit nibble 级联加法)
    - conv_vol 查表: reg 数组 + $readmemh 加载 ym_conv_vol[32][64]
    - 相位调制: idx_c = phase_c[15:10] + mod_out (模64)
    - DAC 输出: carrier×(16-vol)>>2 + 128 偏移
    - conv_vol.hex: 从 ym2413.c ym_conv_vol[32][64] 提取 2048B (s8 补码)
    - conv_vol_dac.hex: +128 偏移版 (给 DAC)
    - fm6_note_tb.v: 单通道音符验证 + WAV 输出 (66.3kHz, 8-bit, 0.5s)
    - 验证结果:
    - env_level_m=0 无调制: 纯正弦 437.6Hz (目标440, 误差0.5%)
    - env_level_m=31 满调制: DFT@880Hz 边带能量=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
2026-07-10 fix: CD4029 引脚按实物丝印修正 + 接线表全逐Pin化
    CD4029 实物引脚 (CEO 2026-07-09 实测丝印确认):
    Q1=P6, Q2=P11, Q3=P14, Q4=P2(MSB)
    J1=P4, J2=P12, J3=P13, J4=P3(MSB)
    PE=P1, Cin=P5, Cout=P7, B/D=P9, U/D=P10, CLK=P15
    之前文档错误 (5个引脚Pin号全错):
    旧: Q1=P12, Q2=P13, JAM1=P11, JAM2=P6, JAM3=P4 (错!)
    新: 按实物丝印修正
    修正文件:
    - rtl/cd4029.v: 引脚注释按实物修正 (模块端口名不变, RTL行为不受影响)
    - wiring-table-uni.md:
    - U24 CD4029: 重写16脚逐Pin表 (5个错Pin修正)
    - U26 HC283: A/B/Σ 4组合并行拆成16脚逐Pin表
    - U30/U31 TLC7524: DB/CS/WR/OUT合并行拆成16脚逐Pin表
    - U25 HC112: 触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
    [cd4029.v]
2026-07-10 fix: U28 HC153→HC157 选型修正 (设计错误) + 仿真0错误
    设计错误: 波形通道需要 4 个独立 2选1 (mode_sel 在 AND 结果和
    比较结果间选, 每位独立), 但接线表错用 HC153 (双4选1, 仅2个Y输出).
    HC153 是多路复用器(选1路), 不是这个场景需要的芯片.
    正确选型: HC157 (四 2选1, 4个Y输出), 库存有 (inventory L89).
    修正:
    - rtl/psg3_top.v: 波形通道 mux 从行为级 assign 改为 hc157 实例化
    (Select=mode_sel, A=AND输出, B=比较输出, /Enable=GND)
    - wiring-table-uni.md U28: 重写16脚逐Pin表 (HC157引脚)
    - U27 HC08: Y1-4 去向改指 HC157 A1-4
    - U26 HC283 C4: 去向改指 HC157 B1-4 (广播4位)
    - U30 TLC7524: DB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
    [psg3_top.v]
2026-07-10 docs: U24/U29 补 counter[0-3] 命名映射
    U24 CD4029 表内 Q 输出只写 Q1-4, 下游 U26/U27/U33 却用
    counter[0-3], 命名跨芯片不统一, 看表不知 counter 哪来的.
    补:
    - U24 段头加命名映射说明 (Q1→counter[0], Q4→counter[3])
    - U24 表内 Q1-4 各行标注对应 counter bit
    - U29 HC273 表内 Q0-3 各行标注对应 counter bit
2026-07-10 fix: 全文档纠正过时引用 (HC85/CD4027/强制比较/reg映射)
    跟随前几次设计修正 (HC283替HC85, HC112替CD4027, HC157替HC153,
    删除方波强制比较特殊判断), 清理所有残留过时引用.
    rtl/psg3_top.v:
    - 文件头注释 CD4027折返→HC112折返
    - 文件头 方波强制比较→锯齿+mode_sel=1, 无特殊判断
    - mode_sel 说明 HC85→HC283
    - L176 HC85比较器→HC283比较器
    host/uni_sim.c:
    - 文件头 reg0/1/2→reg3/4/5, CD4027→HC112, HC85→HC283
    - 删除方波固定比较特殊判断 (wave_out统一逻辑)
    - mode_sel说明 HC85→HC283
    - CD4027折返→HC112折返 (2处)
    - 输出说明 reg0/1/2→reg3/4/5
    host/uni_period_table.h: 重新生成 (CD40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
    [psg3_top.v]
2026-07-15 docs(PSG3 v0.5): rev.e2 接线表五列规格 + CLAUDE.md 纪律修订
    接线表 (wiring-table-rev-e2.md):
    - 12 片 U1-U12 连续编号, 无附号 (U27b→U6 重新进序列)
    - 五列结构: Pin | 来源 | 连接到 | 网络标签 | 说明
    - 16 个全局网络标签集中定义 (mode/trig/sel/freq_tc/tc_a03.../step 等)
    - reg5 全 8 个 Q 脚交代 (Q4/Q5 预留悬空标注)
    - 修正 mode/trig reg5 来源脚、U6.TC 去向、ROM A16 脚位
    CLAUDE.md 第8条新增硬性规格:
    - 五列结构一个不能少, 禁退化三列
    - 网络标签是第一公民, 禁布尔表达式进表格
    - 未使用引脚必须标注, 不能跳过
    - 位号从 U1 起, 禁附号, 用本表内部位号
    - rev.e2 为五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
2026-07-15 sch(PSG3 v0.5): 新增原理图 — PSG4-v0.52 Schematic + Noise netlist
    - Schematic_PSG4-v0.52_2026-07-15.pdf (原理图)
    - SCH_PSG4-v0.52_2026-07-15.json (立创EDA源文件)
    - Noise_2026-07-15.net (噪音通道 netlist)
    [SCH_PSG4-v0.52_2026-07-15.json]
2026-07-15 docs: PSG3 v0.5 新增 README + psg_voice README 更新到完整版本谱
    PSG3 v0.5/README.md (新建):
    - 状态总览 (接口层/方波/噪音/波形 rev.a-e2 各自状态)
    - 波形通道架构演进 (CD4029→HC161 Q→rev.a锯齿✅→rev.b三角❌→rev.c→rev.d/d2→rev.e2)
    - 5 条上板验证核心铁律
    - rev.e2 双模式架构图 + 目录结构 + 寄存器
    psg_voice/README.md (重写, 原版严重过时停在 PSG1 v0.1/v0.2):
    - 完整版本谱 v0.1→v0.7 (PSG1/2/3/4 + WSG + FM)
    - v0.6/v0.7 明确标注设计阶段未验证
    - 演进脉络补 v0.3/v0.4/v0.5
    - 共享资源补 TLC7524 正向接法 + 输出链路
2026-07-15 fix: rev.d 状态修正 — 已上板验证, 功能完美 (非待上板)
    rev.d ROM 查表 256 点已上板通过, 之前误标'待上板'.
    同步修正 PSG3 v0.5/README.md 状态表 + 演进路线 + CLAUDE.md 进度.
2026-07-15 feat(PSG3 v0.5): rev.e2 双模式测试驱动 psg3_rev_e2_test.py
    基于 rev.d 驱动改写, 适配 rev.e2 双模式:
    - reg5 位定义: bit7=mode, bit6=trig, bit3-0=sel (非 rev.d 的全 8 位 wave_sel)
    - 双模式: mode=0 波形 (256 步) / mode=1 PCM 采样 (8192 步/槽)
    - trigger(): trig=1→0 清地址 (n_trig_clr), 采样模式重新播放
    - 采样模式 period12 控制回放速率 (A4=8kHz 基准, 半音±变速)
    - 16 槽名称 (sine/BD ... pulse37/Oboe2)
    - 键盘: ←/→音高 ↑/↓音量 W/E选槽 M切模式 T触发 空格静音
    总线时序对齐 v0.4 (_bus_write 不变), Ctrl+C/finally 安全退出.
2026-07-15 feat(PSG3 v0.5): rev.e3 PCM 专用最简版 — 隔离 rev.e2 故障
    rev.e3 砍掉所有组合逻辑 (HC08/HC04) 和 7474 toggle, PCM 无限循环验证版.
    目的: 隔离 rev.e2 上板故障 (7474/组合逻辑接错导致地址越界).
    接线表 (wiring-table-rev-e3.md, 10 片 U1-U10):
    - U4-U7 四片 HC161 级联 (13 位地址 a0-a12), 全接 freq_tc 直驱, 无限循环 0-8191
    - U7 HC161 Q0 当 a12 (替代 rev.e2 的 7474 toggle, 避免 FF 接错)
    - 无 mode/trig/at_8191/step 组合逻辑, reg5 只用 sel[3:0]
    - U4-U7 ~PE 全接 +5V (自由计数, 无清地址)
    ROM (gen_rev_e3_rom.py + rev_e3_rom.bin):
    - PCM only, 每槽 8K 全填 PCM (无波形前 256 字节)
    - 16 槽: 6 鼓组 + 10 乐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
2026-07-15 feat(PSG3 v0.5): rev.e3 ROM 生成器加增益参数 + 4x 对比版
    gen_rev_e3_rom.py: load_wav_pcm 加 gain 参数 (归一化后 ×gain, clip 到 0-255)
    用法: gen_rev_e3_rom.py [输出] [增益] 例: ... rev_e3_rom_4x.bin 4
    rev_e3_rom_4x.bin: 全部采样 ×4 增益版 (用于对比)
    鼓声 clip 少 (峰值本就高), 乐器 clip 严重 (Trumpet/Blow 近 1/3 样本被砍)
2026-07-15 fix(rev.e3): 按键节流 30ms — 按住连发导致 FT232H 缓冲溢出 reg 串扰
    问题: 单次按键正常, 按住不放时 Windows 键盘连发 (几十次/秒),
    每次 set_period 连写 reg3+reg4 两次 dev.write, 密集排队致
    FT232H 缓冲事务边界混乱 → reg3/4/5 互相串扰 (调音高时 sel 变等).
    修法: 主循环加 30ms 最小间隔, 连发事件丢弃, 只处理间隔够的.
    _bus_write 时序不变 (本就对齐 v0.4).
2026-07-15 docs: rev.e3 PCM 上板实验结论 (findings 第十二节) + CLAUDE.md 状态更新
    rev.e3 PCM 最简版上板验证 (2026-07-16), 基本能用, 五条硬限制:
    1. 8kHz 采样率太低 (量化噪音大), 2-4x 速回放才好听 (3x 最经典)
    2. 面包板 ROM 高速查表耦合噪声 = 面包板音质上限, 要走 PCB
    3. a12 接不同 HC161 抽头 = 不同节拍循环 (意外发现)
    4. PCM 音量远小于波形 (RMS 差 3-10 倍), 要独立运放
    5. 后续: 升采样率 / 39SF040 / 39040 CPU / PCB+减法放大器去噪
    CLAUDE.md: rev.e2 标注组合逻辑故障, rev.e3 为当前最新进度.
2026-07-15 docs: ROM 查表 DAC 的 CS=GND 优于 CS=clk (rev.e3 上板发现)
    推翻 rev.a 铁律 'CS 必须 clk 同步采样':
    - CS=clk 引入 4MHz 时钟串扰 + clk 沿采到 ROM 地址翻转过渡态 (毛刺被冻结)
    - CS=GND (透明) 更干净: 乘法 DAC 输出连续平滑, 过渡毛刺被平均掉
    - 'CS 必须 clk' 只对 rev.a 分频链叠加必需 (4 路方波异步叠加白噪),
    ROM 查表 (rev.d/e3) 输出完整稳态字节, 不存在异步叠加, 透明更好
    findings: 加第 6 条 (TC 不需整形) + 第 7 条 (ROM CS=GND), 标注第 2/4 条被推翻
    CLAUDE.md 硬件踩坑加第 8 条
2026-07-15 docs: 明确 clk 不适合 PCM — CS=GND 适用场景写清楚
    findings 第7条 + CLAUDE.md 第8条:
    - clk 适合波形分频链 (4路方波异步叠加必须同步采样)
    - clk 不适合 PCM (连续模拟信号, 同步采样冻结过渡毛刺, 听感脏)
    - PCM/ROM 查表一律 CS=GND (透明, 乘法DAC连续平滑, 毛刺被平均)
2026-07-15 docs: PCM 降噪改进方法 5 条 (findings 第十二节)
    1. 提升采样率到 22kHz+ (8k 量化噪音大, 要换 39SF040)
    2. 提升到 16-bit PCM (48dB→96dB, 双 DAC 或换 16-bit DAC)
    3. ROM 数据线串电阻去 DAC (RC 低通滤地址翻转耦合, 成本最低)
    4. PCB 隔离数字和模拟 (分开地平面, 面包板做不到的根本解)
    5. 空 ROM+DAC 差分放大 (共模噪声抵消, 要 PCB 对称走线, 降噪最彻底)
2026-07-15 docs: 战略决策 — 后续版本剔除 PCM, PSG 回归方波/WSG/LFSR/模拟乘法
    PCM 优化 (22kHz/16-bit/27C1024/差分放大) 留到以后专门研究, 不在 PSG 线做.
    rev.e2 PCM 部分 + rev.e3 之后不再投入 PCM.
    PSG 系列方向: 方波 + WSG 波形查表 + LFSR 噪音 + 模拟乘法 + 扩展通道.
2026-07-15 docs: findings 文件索引补全 (rev.c-e3) + 16-bit PCM 选型 (27C1024)
    - 文件索引表补全 rev.c/d/d2/e/e2/e3, 标注跳号说明 (六→十一遗留)
    - 改进方法第2条补 27C1024 选型 (库存有, 64K×16, 16位总线) + 双TLC7524级联 + 差分/前级放大
2026-07-15 docs(PSG4 v0.6): 交接文档全面重写 — 基于 PSG3 rev.d/e3 上板结论
    旧版 (2026-07-10) 基于 PSG3 原版 (CD4029) 认知, 严重过时.
    重写要点:
    - 基于 rev.d ✅ 上板 (ROM 查表 256 点功能完美) 为波形通道基础
    - DAC 接法改 CS=GND (rev.e3 验证优于 clk)
    - PCM 战略剔除 (rev.e3 结论: 8kHz/面包板硬上限)
    - 明确 PSG3 已验证结论表 (ROM 查表/TC直连/Q不直DAC/高频不用CD)
    - 扩展方向: 多波形通道 / 模拟乘法(MC1496/CA3080) / WSG纯波形
    - 引用 findings 铁律 7 条 + PCM 改进方法 5 条
    - 待实现项标注设计阶段
